AnMayVaa/smart-workstation-env-regulator/07_visuals/C3_room_installation_v1.jpg

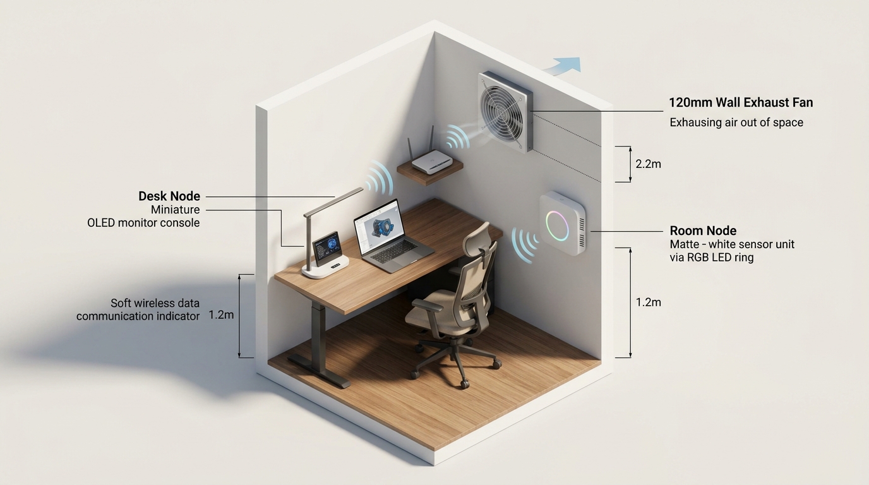
07_visuals/C3_room_installation_v1.jpg
