AnMayVaa/smart-workstation-env-regulator/07_visuals/C4_device_mockup_v1.jpg

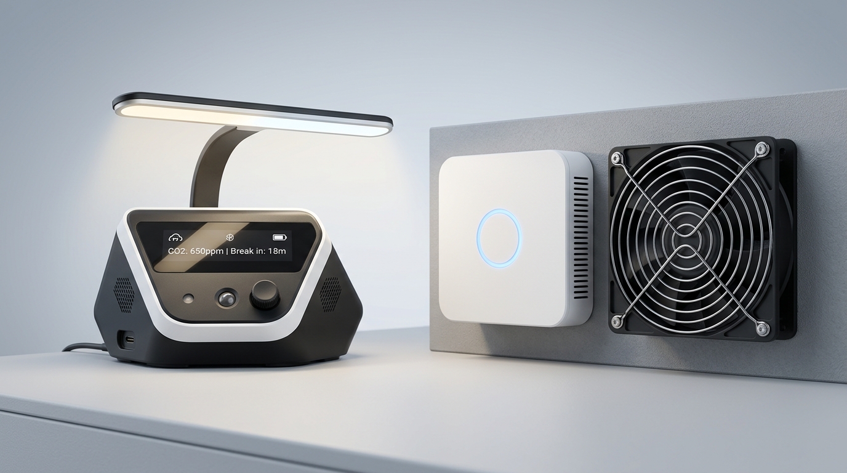
07_visuals/C4_device_mockup_v1.jpg
