AnMayVaa/smart-workstation-env-regulator/README.md

# Smart Workstation Environmental Regulator

ระบบลดความล้าและรักษาความตื่นตัวของคนที่ทำงานหน้าคอมนานๆ
งานกลุ่มวิชา 010123119 Embedded System Design (เอกสารออกแบบ + จำลองใน Wokwi)

> **เริ่มอ่านที่** [`00_team_guide/00_overview.md`](00_team_guide/00_overview.md) แล้วอ่านไฟล์บทบาทของตัวเองในโฟลเดอร์เดียวกัน

## โครงโฟลเดอร์

| โฟลเดอร์ | เก็บอะไร | เจ้าของหลัก |
|---|---|---|
| `00_team_guide/` | ไฟล์ภาพรวมและไฟล์บทบาท A/B/C/D | D |
| `01_requirements/` | D1 Requirement + ค่าเกณฑ์ | D |
| `02_interface/` | A1 ตารางข้อมูลกลาง | A |
| `03_hardware/` | A2, B1, C1, D2 | ทุกคน |
| `03_hardware/datasheets/` | datasheet ทุกตัว (PDF) | ทุกคน |
| `04_logic/` | A3, B2, C2, D3 | ทุกคน |
| `05_tasks/` | ข้อมูลงานย่อย (X-T), B3 | ทุกคน / B |
| `06_testing/` | test case (X-TC), C5, A5 | ทุกคน / C / A |
| `07_visuals/` | C3, C4 และภาพ FSM ของทุกคน | ทุกคน |
| `08_code/` | A4 โค้ด ESP32 + วงจร Wokwi | A |
| `09_doc_sections/` | เนื้อหาเอกสารส่วนตัว (A6, B4, C6, D4), X-N | ทุกคน |
| `10_final/` | D5 เล่มสมบูรณ์ | D |

## วิธีส่งงาน (ไม่ต้องใช้ git ก็ได้)

1. เปิดโฟลเดอร์ที่ถูกต้องบนหน้าเว็บ GitHub
2. กด **Add file → Upload files** แล้วลากไฟล์มาวาง
3. ช่อง commit message เขียนสั้นๆ เช่น `ส่ง B2 logic presence v1`
4. กด **Commit changes**
5. แจ้งในกลุ่มแชท เช่น "ส่ง B2 แล้ว @A"

## ตั้งชื่อไฟล์

- ไฟล์ Word / PDF / PNG: ใช้รูปแบบ `รหัส_ชื่อสั้น_vเลข` ตามไฟล์ภาพรวม เช่น `B2_logic_presence_v1.docx`
- ถ้าแก้งานที่ส่งแล้ว อย่าทับไฟล์เดิม ให้อัปโหลดเป็นเวอร์ชันใหม่ (v2, v3) แล้วแจ้งคนที่ใช้งานชิ้นนั้น
- ไฟล์ `.md` (เช่น A1) ไม่ต้องใส่เลขเวอร์ชันในชื่อ เพราะ git เก็บประวัติให้ เวอร์ชันระบุไว้ที่หัวไฟล์

## ของกลางที่ห้ามแก้เอง

| ของกลาง | เจ้าของ | อยู่ที่ |
|---|---|---|
| โมดูลที่เอา/ไม่เอา, ค่าเกณฑ์ | D | `00_team_guide/00_overview.md`, `01_requirements/` |
| ตารางข้อมูลกลาง | A | `02_interface/A1_interface.md` |

ถ้าต้องการเปลี่ยน ให้เปิด **Issue** (แท็บ Issues → New issue → "ขอเปลี่ยนตารางข้อมูลกลาง") แทนการแก้ไฟล์โดยตรง

## สมาชิกและบทบาท

| บทบาท | หน้าที่ | ชื่อ |
|---|---|---|
| A | เชื่อมระบบและจำลอง | นาย พิทักษ์ ปทุมวัน |
| B | คนและการเตือนพัก + ตารางงานย่อย | นาย ณัฐปคัลภ์ พรเฉลิมพงศ์ |
| C | อากาศ + ภาพจำลอง + แผนทดสอบ | นาย ทิวากร ฉับพลัน |
| D | PM + แสง + รวมเล่ม | นาย นครินทร์ บุญก่อเกื้อ|
