AnMayVaa/smart-workstation-env-regulator/03_hardware/C1_hardware_air.md

# C1: การเลือกอุปกรณ์ฮาร์ดแวร์ โมดูลตรวจวัดคุณภาพอากาศและควบคุมการระบายอากาศ

> **รหัสเอกสาร:** C1_hardware_air  
> **ผู้จัดทำ:** C (ซัน - นายทิวากร ฉับพลัน 6701012610112) | โมดูลอากาศ + ภาพจำลอง + แผนทดสอบ  
> **ส่งให้:** A (โอม - นำไปทำผังขาและคำนวณไฟใน A2), D (ใช้รวมเล่มหัวข้อ 4)  
> **อ้างอิงและสอดคล้องกับ:** `03_hardware/proposal_A_mosfet.md`, `03_hardware/A2_board_power.md`, `01_requirements/D1_requirements.md`  
> **เนื้อหาสำหรับรายงาน:** หัวข้อ 4 (Hardware Design - Sensor/Actuator choice and justification)

---

## 1. ตารางสรุปรายการอุปกรณ์ (แบบฟอร์ม HW)

| อุปกรณ์ | หน้าที่ในระบบ | เหตุผลที่เลือก | ตัวเลือกอื่นที่เปรียบเทียบ และเหตุผลที่ไม่เลือก | สเปกไฟเลี้ยง (V / mA) | การเชื่อมต่อกับ ESP32 | Datasheet (ชื่อไฟล์) | ในโปรแกรมจำลอง Wokwi ใช้ |
|---|---|---|---|---|---|---|---|
| **Sensirion SCD41** | ตรวจวัดก๊าซ $\text{CO}_2$ (ppm), อุณหภูมิ (°C) และความชื้นสัมพัทธ์ (%RH) | 1. ใช้เทคโนโลยี Photoacoustic NDIR วัดความเข้มข้น $\text{CO}_2$ ได้โดยตรง โดยในช่วงควบคุมพัดลมและประเมินคุณภาพอากาศ 400–1,000 ppm มีความแม่นยำสูงถึง $\pm(50\ \text{ppm} + 2.5\%\ \text{of reading})$ (และช่วง 1,001–2,000 ppm แม่นยำ $\pm(50\ \text{ppm} + 3\%)$, ช่วง 2,001–5,000 ppm แม่นยำ $\pm(40\ \text{ppm} + 5\%)$ ตาม [C1-1])<br>2. รวม 3 เซนเซอร์ในตัวเดียว ช่วยลดพื้นที่ PCB และประหยัดขา I/O<br>3. สื่อสารผ่าน I²C บัสมาตรฐาน มี CRC ตรวจสอบความถูกต้อง | **1. MQ-135:** เป็นเซนเซอร์เคมี (MOx) แยก $\text{CO}_2$ ไม่ได้จริง เพี้ยนง่ายจากแอลกอฮอล์/ควัน และกินไฟสูงถึง 150 mA (~900 mW) จากขดลวดความร้อน [C1-2]<br>**2. MH-Z19B / SCD30:** ขนาดใหญ่กว่า SCD41 ประมาณ 8–9 เท่า ($> 5,500\ \text{mm}^3$ เทียบกับ SCD41 เพียง $663\ \text{mm}^3$) [C1-3], [C1-4] และ MH-Z19B ไม่รวมวัดอุณหภูมิ/ความชื้น | 3.3V DC (2.4V – 5.5V)<br>- โหมดวัดทุก 5s: กระแสเฉลี่ย 15 mA (สูงสุด 18 mA)<br>- Peak กระแสชั่วขณะ: สูงสุด 205 mA ที่ 3.3V (ตาม Datasheet Table 4 [C1-1]) | I²C Bus (SDA = GPIO 21, SCL = GPIO 22)<br>I²C Address: `0x62`<br>(ผ่านการล็อกด้วย `i2c_lock` ตาม A1 ข้อ 7) | `Sensirion_SCD41_Datasheet.pdf` [C1-1] | Potentiometer 10kΩ (แทนค่า $\text{CO}_2$) + DHT22 (แทนอุณหภูมิและความชื้น) |
| **พัดลมดูดอากาศ DC 12V (Exhaust Fan ขนาด 120 mm)** | ดูดอากาศเสียที่มี $\text{CO}_2$ สะสมเกินมาตรฐานออกนอกห้อง เพื่อให้อากาศบริสุทธิ์ไหลเวียนเข้ามาแทนที่ | 1. การลด $\text{CO}_2$ ในห้องปิดต้องอาศัยการดูดอากาศทิ้ง พัดลมตั้งโต๊ะทั่วไปลด $\text{CO}_2$ ไม่ได้<br>2. สเปกแรงลมขั้นต่ำ 50–70 CFM คำนวณจากการระบายอากาศห้อง 15–25 m³ ให้ได้ 4–6 ACH ตามมาตรฐาน ASHRAE 62.1 [C1-7] (ดูข้อ 2.3)<br>3. ปรับความเร็วรอบด้วย PWM ได้เงียบสนิท ไม่รบกวนสมาธิผู้ใช้ | **พัดลม AC 220V:** ควบคุมความเร็วรอบได้ยาก มีความเสี่ยงอันตรายจากไฟฟ้าแรงสูง และมีสัญญาณรบกวนแม่เหล็กไฟฟ้า (EMI) ต่อไมโครคอนโทรลเลอร์ | 12V DC (สเปกขั้นต่ำ / ค่าประมาณทางวิศวกรรม [ดูข้อ 2.3])<br>กระแสทำงาน: ~250 mA (Peak สตาร์ทมอเตอร์: ~400 mA) | ต่อกับไฟ 12V ภายนอก ควบคุมเปิด-ปิดและปรับความเร็วรอบผ่านวงจรขับสวิตชิ่ง MOSFET | เลือกตามสเปกมาตรฐานทั่วไป (DC 12V 120mm Brushless Fan ไม่ผูกยี่ห้อ) | LED สีน้ำเงิน ที่ GPIO 25 (ความสว่างหรี่ตาม duty cycle ของ PWM แสดงความเร็วรอบพัดลม ตรงตาม A2 ข้อ 3-4 และ SIMULATION_GUIDE.md) |
| **วงจรขับพัดลม: Logic-Level N-Channel MOSFET (AO3400A) + Flyback Diode (1N4007)** | ขับกระแสและแปลงระดับแรงดันควบคุมจากสัญญาณ 3.3V ของ ESP32 ไปขับพัดลม 12V พร้อมวงจรป้องกันแรงดันไฟย้อนกลับ | 1. GPIO ของ ESP32 จ่ายได้สูงสุดเพียง 3.3V / 12mA (บท 13 หน้า 34–35 [C1-8]) ขับพัดลมโดยตรงไม่ได้<br>2. AO3400A เป็น Logic-Level MOSFET (SOT-23) ที่ Datasheet รับรองการเปิดสุดตั้งแต่ $V_{GS} = 2.5\ \text{V}$ ($R_{DS(on)} < 48\ \text{m}\Omega$) ขับด้วย 3.3V ได้สมบูรณ์ 100% [C1-5] ตอบโจทย์ตามข้อเสนอ `03_hardware/proposal_A_mosfet.md`<br>3. ทนแรงดัน 30V กระแส 5.7A ความร้อนสะสมต่ำมาก (~0.003 W) ไม่ต้องติดแผ่นระบายความร้อน<br>4. รองรับ PWM คาบ 20 ms (50 Hz) ตามบท 13 หน้า 95 [C1-8]<br>5. ติดตั้ง Flyback Diode 1N4007 ขนานย้อนขั้วเพื่อสลายแรงดันเหนี่ยวนำย้อนกลับ ($V = -L \frac{di}{dt}$) ของมอเตอร์พัดลม (บท 13 หน้า 35 [C1-8], [C1-6]) | **1. IRLZ44N:** แม้เป็น Logic-Level แต่ตัวถัง TO-220 ใหญ่เกินไป และ Datasheet รับรองค่าการนำกระแสเต็มที่ที่ $V_{GS} \ge 4-5\ \text{V}$<br>**2. IRFZ44N / IRF540N:** ต้องการ $V_{GS} = 10\ \text{V}$ ขับด้วย 3.3V ไม่ติด<br>**3. Relay Module:** สวิตช์กลไกมีเสียงดังคลิกๆ ตัดต่อบ่อยจะสึกหรอ และทำ PWM ไม่ได้<br>**4. BJT (TIP120):** มีแรงดันตกคร่อมสูง 1–2V สูญเสียพลังงานและร้อนจัด | ฝั่ง Gate: 3.3V (< 1 mA)<br>ฝั่ง Load: 12V / 250 mA | ขา Gate ต่อกับ ESP32 GPIO 25 (ผ่าน $R_{gate} = 100\ \Omega$ และ $R_{pull-down} = 10\ \text{k}\Omega$ ดึงลง GND) | `AO3400A_datasheet.pdf` [C1-5], `1N4007_Datasheet.pdf` [C1-6] | ไม่ต้องต่อใน Wokwi (ต่อ LED สีน้ำเงินที่ GPIO 25 ตรงผ่านตัวต้านทาน 220 Ω จำลองการขับโหลด PWM) |
| **ไฟสถานะ 3 สี (RGB LED ชนิด Common Cathode)** | แสดงสภาวะคุณภาพอากาศในห้องแบบ Real-time ให้ผู้ใช้มองเห็นได้ชัดเจนจากระยะไกล | 1. ผู้ใช้ทราบสภาวะอากาศได้ทันที (เขียว = อากาศดี, เหลือง = เฝ้าระวัง, แดง = เกินเกณฑ์พัดลมทำงาน, กะพริบแดง = เซนเซอร์เสีย)<br>2. ใช้พลังงานต่ำมาก ตอบสนองทันที<br>3. ประหยัดต้นทุนและความซับซ้อน ไม่ต้องติดจอ LCD ซ้ำซ้อนที่โหนดห้อง เพราะผู้ใช้ดูรายละเอียดตัวเลขบนจอ OLED ของโหนดโต๊ะได้อยู่แล้ว | **จอแสดงผล LCD/OLED บนโหนดห้อง:** สิ้นเปลืองพลังงานและต้นทุนโดยไม่จำเป็น เนื่องจากโหนดห้องติดตั้งไว้สูง | 3.3V DC (ผ่านตัวต้านทานจำกัดกระแส $R = 220\ \Omega$ ทุกขา)<br>กระแส: คำนวณจำกัดกระแสไม่เกิน 10 mA ต่อสี (ปลอดภัยต่อพอร์ต ESP32 [ดูข้อ 2.4]) | ขา Red $\rightarrow$ GPIO 18<br>ขา Green $\rightarrow$ GPIO 19<br>ขา Blue $\rightarrow$ GPIO 23<br>ขา Cathode $\rightarrow$ GND | เลือกตามสเปกมาตรฐานทั่วไป (5mm Common Cathode RGB LED ไม่ผูกยี่ห้อ) | RGB LED (Common Cathode) ขา 18, 19, 23 ใน Wokwi |

---

## 2. เหตุผลการเลือกอุปกรณ์ตามหลักการวิศวกรรม (Engineering Justification)

### 2.1 เซนเซอร์วัดคุณภาพอากาศ: ทำไมต้องเป็น Sensirion SCD41?
- **ปัญหาของเซนเซอร์เคมี (MQ-135):** ในโครงงานทั่วไปมักใช้ MQ-135 เนื่องจากราคาถูก แต่ MQ-135 ใช้ขดลวดทำความร้อนสารกึ่งตัวนำ $\text{SnO}_2$ ซึ่งวัดการเปลี่ยนแปลงความต้านทานจากก๊าซรีดิวซ์รวม ไม่สามารถแยกเจาะจงก๊าซ $\text{CO}_2$ ได้จริง หากมีไอระเหยของแอลกอฮอล์ น้ำหอม หรือก๊าซอื่น ค่าจะแกว่งอย่างรุนแรง นอกจากนี้ยังกินกระแสไฟฟ้าสูงถึง 150 mA (~900 mW) [C1-2] ตลอดเวลา จึงขัดกับเกณฑ์ด้าน Resource Optimization และ Real-time accuracy
- **ความเหนือกว่าของ SCD41:** SCD41 ใช้เทคโนโลยี Photoacoustic NDIR ซึ่งยิงพัลส์แสงอินฟราเรดความยาวคลื่น $4.26\ \mu\text{m}$ ที่ก๊าซ $\text{CO}_2$ ดูดกลืนโดยเฉพาะ แล้ววัดคลื่นเสียงที่เกิดขึ้นภายในห้องตรวจวัด ทำให้ได้ค่าความเข้มข้น $\text{CO}_2$ ที่แม่นยำแท้จริงในช่วง 400 – 5,000 ppm
  - **ความแม่นยำ (Accuracy):** ตาม Datasheet Version 1.7 (Table 1 [C1-1]) ระบุว่า:
    - ช่วง **400 – 1,000 ppm** มีความแม่นยำสูงถึง **$\pm(50\ \text{ppm} + 2.5\%\ \text{of reading})$** ซึ่งครอบคลุมช่วงเกณฑ์ตัดสินเปิด-ปิดพัดลมระบายอากาศของระบบ ($800 - 1,000\ \text{ppm}$) ได้อย่างแม่นยำ
    - ช่วง **1,001 – 2,000 ppm** มีความแม่นยำ **$\pm(50\ \text{ppm} + 3\%\ \text{of reading})$**
    - ช่วง **2,001 – 5,000 ppm** มีความแม่นยำ **$\pm(40\ \text{ppm} + 5\%\ \text{of reading})$**
  - รวมเซนเซอร์วัดอุณหภูมิ (ความแม่นยำ $\pm 0.8^\circ\text{C}$) และความชื้นสัมพัทธ์ (ความแม่นยำ $\pm 6\%\text{RH}$) ในตัวเดียว ช่วยลดจำนวนพอร์ตบนไมโครคอนโทรลเลอร์
  - เมื่อเทียบกับเซนเซอร์ NDIR รุ่นเดิมอย่าง MH-Z19B [C1-3] หรือ SCD30 [C1-4] ตัวถังของ SCD41 ($10.1 \times 10.1 \times 6.5\ \text{mm} = 663\ \text{mm}^3$) มีขนาดกะทัดรัดกว่าถึง 8–9 เท่า
- **พฤติกรรมการกินกระแส (Power Characteristics):**  
  ตาม Datasheet ของ Sensirion SCD41 (Table 4 [C1-1]) ในโหมดการทำงานแบบตรวจวัดทุกๆ 5 วินาที (Periodic Measurement Mode เพื่อให้ตอบสนองทันเกณฑ์ NFR-01):
  - กระแสเฉลี่ยขณะทำงาน: **$15\ \text{mA}$** (สูงสุด $18\ \text{mA}$)
  - กระแสกระชากสูงสุดชั่วขณะ (Peak Current): **$205\ \text{mA}$** ที่แรงดัน $3.3\ \text{V}$ (เกิดขณะหลอดอินฟราเรดยิงพัลส์ความร้อนเพื่อตรวจวัด)  
  *(หมายเหตุ: ค่า 0.5 mA เดิมในเอกสารร่างแรกเป็นค่ากระแสของโหมด Single Shot วัดทุก 5 นาที ตาม Datasheet Table 4: 0.45 mA typ / 0.50 mA max ไม่ใช่โหมด Low Power Periodic 30 วินาที ซึ่งกินกระแส 3.2 mA ทั้งนี้ระบบระบายอากาศของเราต้องตอบสนองต่อคุณภาพอากาศอย่างรวดเร็ว จึงเลือกใช้โหมด Periodic Measurement วัดทุก 5 วินาที ซึ่งกินกระแสเฉลี่ย 15 mA เพื่อให้สอดคล้องกับ NFR-01 และเอกสาร A2)*

### 2.2 วงจรขับพัดลมดูดอากาศ: ทำไมต้องเปลี่ยนมาใช้ MOSFET เบอร์ AO3400A?
ตามข้อเสนอในเอกสาร `03_hardware/proposal_A_mosfet.md` และการวิเคราะห์ตามสไลด์ **วิชา Embedded System Design บทที่ 13 หน้า 34–35 และ 60 [C1-8]**:
1. **ปัญหาของ IRLZ44N เดิม:** แม้ IRLZ44N จะเป็น Logic-Level MOSFET แต่ใน Datasheet รับรองค่า $R_{DS(on)}$ ที่แรงดันเกต $V_{GS} \ge 4 - 5\ \text{V}$ เป็นหลัก เมื่อนำมาขับด้วยระดับแรงดัน $3.3\ \text{V}$ ของบอร์ด ESP32 โดยตรง ทรานซิสเตอร์อาจทำงานอยู่ในช่วงกึ่งนำกระแส (Triode/Linear Region) ไม่เปิดสุด 100% อีกทั้งตัวถังแบบ TO-220 มีขนาดใหญ่เกินความจำเป็นสำหรับโหลดพัดลม 250 mA
2. **ความเหนือกว่าของ AO3400A [C1-5]:**
   - เป็น N-Channel Logic-Level MOSFET ในแพ็คเกจ SOT-23 ขนาดกะทัดรัด
   - **รับรองการเปิดเต็มที่ตั้งแต่แรงดันเกต $V_{GS} = 2.5\ \text{V}$** (ค่า $R_{DS(on)} < 48\ \text{m}\Omega$) และที่ $V_{GS} = 4.5\ \text{V}$ (ค่า $R_{DS(on)} < 28\ \text{m}\Omega$) ดังนั้นเมื่อขับด้วยสัญญาณลอจิก $3.3\ \text{V}$ จาก ESP32 จึงมั่นใจได้ $100\%$ ว่ามอสเฟตเปิดสุด (Fully Saturated) ความต้านทานภายในต่ำมาก
   - พิกัดทนแรงดัน $V_{DS} = 30\ \text{V}$ และทนกระแสได้สูงถึง $I_D = 5.7\ \text{A}$ ซึ่งสูงกว่ากระแสพัดลม $250\ \text{mA}$ (สตาร์ท $400\ \text{mA}$) มาก มี Safety Margin เหลือเฟือ
   - การสูญเสียกำลังไฟฟ้าในรูปความร้อนต่ำมาก: $P = I^2 \cdot R_{DS(on)} = (0.25)^2 \cdot 0.048 \approx 0.003\ \text{W}$ จึงไม่จำเป็นต้องติดแผ่นระบายความร้อน (Heatsink)
   - การใช้ AO3400A ร่วมกับโมดูลแสงของ D ทำให้ทั้งระบบใช้ MOSFET เบอร์เดียวกัน ลดความหลากหลายของชิ้นส่วน (BOM Standardization)
3. **การใส่ Flyback Diode (1N4007 [C1-6]):**  
   ต่อขนานย้อนขั้ว (Reverse-biased) คร่อมขั้วบวกและลบของมอเตอร์พัดลม เพื่อเป็นทางผ่านคายกระแสเหนี่ยวนำย้อนกลับ (Inductive Kickback: $V = -L \frac{di}{dt}$) ที่เกิดขึ้นขณะมอสเฟตตัดวงจร เพื่อป้องกันแรงดันกระชากทำลายทรานซิสเตอร์ (บท 13 หน้า 35 [C1-8])

### 2.3 ที่มาของสเปกแรงลมและพิกัดกระแสพัดลมดูดอากาศ (Fan Sizing & Flow Rate Justification)
1. **การคำนวณอัตราการถ่ายเทอากาศ (Airflow Requirement - CFM):**
   - อ้างอิงตามมาตรฐาน ANSI/ASHRAE Standard 62.1-2022 (*Ventilation for Acceptable Indoor Air Quality*) [C1-7] สำหรับห้องทำงานหรือพื้นที่ศึกษาขนาดเล็ก (ปริมาตร 15–25 $\text{m}^3$) สมมติห้องขนาดเฉลี่ย กว้าง 3 m × ยาว 3 m × สูง 2.5 m ปริมาตรห้อง $V = 22.5\ \text{m}^3 \approx 795\ \text{ft}^3$
   - เพื่อระบายก๊าซ $\text{CO}_2$ ที่สะสมเกิน 1,000 ppm ลงมาให้ต่ำกว่า 800 ppm ได้อย่างมีประสิทธิภาพ ห้องต้องการอัตราการถ่ายเทอากาศ (Air Changes per Hour: ACH) ขณะพัดลมทำงานเต็มที่ประมาณ $4 - 6\ \text{ACH}$
   - คำนวณอัตราการไหลของอากาศขั้นต่ำ:
     $$\text{Airflow (CFM)} = \frac{V\ (\text{ft}^3) \times \text{ACH}}{60\ \text{min}} = \frac{795 \times 4}{60} = 53\ \text{CFM}\quad (\text{ถึง}\ \frac{795 \times 6}{60} = 79.5\ \text{CFM})$$
   - จึงกำหนด **สเปกขั้นต่ำของพัดลมดูดอากาศ 120 mm ที่ 50–70 CFM** เพื่อให้ระบบสามารถลดระดับ $\text{CO}_2$ ได้ทันตามเกณฑ์ความปลอดภัย
2. **ที่มาของพิกัดกระแสปกติ 250 mA และกระแสสตาร์ท 400 mA:**
   - พัดลมระบายอากาศ DC 12V ขนาด 120 mm ชนิด Brushless DC (BLDC) ทั่วไปที่ให้แรงลม 50–70 CFM มีกำลังไฟฟ้าประมาณ 2.5 – 3.5 W คิดเป็นกระแสปกติ $I = \frac{P}{V} \approx 200 - 290\ \text{mA}$ จึงใช้ค่าประมาณทางวิศวกรรมที่ **$250\ \text{mA}$** ในการคำนวณงบประมาณพลังงาน
   - ในช่วงเริ่มหมุน (Motor Inrush / Starting Surge) ขดลวดมอเตอร์เหนี่ยวนำจะดึงกระแสสูงกว่าปกติชั่วขณะประมาณ 1.5–1.6 เท่า คิดเป็นกระแสพีคไม่เกิน **$400\ \text{mA}$** ซึ่งมอสเฟต AO3400A (พิกัด 5.7 A [C1-5]) และ Adapter 12V 2A รองรับได้อย่างปลอดภัย

### 2.4 การจำกัดกระแสของไฟสถานะ RGB LED (Current Limiting Justification)
- ไฟสถานะใช้หลอด RGB LED ขนาด 5 mm ชนิด Common Cathode ต่อผ่านตัวต้านทานจำกัดกระแส $R = 220\ \Omega$ เข้ากับขา GPIO 3.3V ของ ESP32
- จากแรงดันตกคร่อมไดโอดเปล่งแสง ($V_F$):
  - สีแดง ($V_F \approx 1.8 - 2.0\ \text{V}$): $I_R = \frac{3.3\ \text{V} - 1.9\ \text{V}}{220\ \Omega} \approx 6.4\ \text{mA}$
  - สีเขียวและสีน้ำเงิน ($V_F \approx 2.8 - 3.0\ \text{V}$): $I_{G,B} = \frac{3.3\ \text{V} - 2.9\ \text{V}}{220\ \Omega} \approx 1.8 - 2.0\ \text{mA}$
- ดังนั้นกระแสใช้งานจริงจะไม่เกิน **$10\ \text{mA}$ ต่อสี** ซึ่งอยู่ในเกณฑ์ปลอดภัยของขา GPIO ESP32 ที่สามารถจ่ายกระแสต่อเนื่องสูงสุดได้ 12 mA (ตามคำแนะนำในเอกสารคำสอนบทที่ 13 หน้า 34–35 [C1-8])

---

## 3. ข้อมูลกำลังไฟฟ้าและผังการเชื่อมต่อ (ตรงกับ A2_board_power.md)

### 3.1 การคำนวณกำลังไฟฟ้าของโหนดห้อง (Power Consumption Estimation)
| อุปกรณ์ | แรงดันทำงาน (V) | กระแสปกติ (mA) | กระแสสูงสุด (mA) | กำลังไฟฟ้าสูงสุด (W) |
|---|---|---|---|---|
| ESP32 (โหนดห้อง) | 3.3V (ผ่าน Buck Converter 5V) | 80 mA | 240 mA (ช่วงส่ง Wi-Fi TX) | 0.80 W |
| เซนเซอร์ Sensirion SCD41 | 3.3V | 15 mA (เฉลี่ย) | 205 mA (Peak ช่วงยิงพัลส์) | 0.68 W |
| พัดลมดูดอากาศ DC 12V | 12.0V | 0 mA (ปิด) / 250 mA (เปิด) | 400 mA (ช่วงเริ่มหมุน) | 4.80 W |
| ไฟสถานะ RGB LED | 3.3V | 10 mA | 20 mA | 0.07 W |
| **รวมทั้งสิ้น (โหนดห้อง)** | **Adapter 12V 1.5A** | **~100 mA (ฝั่ง 12V)** | **~500 mA (ฝั่ง 12V)** | **~5.80 W** |

> **ระบบจ่ายไฟของโหนดห้อง (ตาม A2 ข้อ 2):**  
> ใช้อะแดปเตอร์ภายนอก AC/DC Adapter 12V 1.5A หรือ 2A ตัวเดียว จ่ายไฟ 12V ตรงให้พัดลมดูดอากาศ และใช้ Buck Converter (MP1584 หรือ LM2596) แปลงแรงดันลงมาเป็น 5V เพื่อจ่ายเข้าขา VIN ของบอร์ด ESP32 ได้อย่างมีประสิทธิภาพ

### 3.2 ผังการเชื่อมต่อขา (ตรงตามที่ A ยืนยันใน A2 ข้อ 4 100%)
- **SCD41 (I²C Bus):**
  - Pin SDA $\rightarrow$ ESP32 GPIO 21 (มี Pull-up Resistor $4.7\ \text{k}\Omega$)
  - Pin SCL $\rightarrow$ ESP32 GPIO 22 (มี Pull-up Resistor $4.7\ \text{k}\Omega$)
  - VDD $\rightarrow$ 3.3V, GND $\rightarrow$ GND (Address: `0x62`)
- **วงจรขับพัดลม (PWM 50 Hz คาบ 20 ms):**
  - Gate Drive $\rightarrow$ ESP32 GPIO 25 (ผ่าน $R_{gate} = 100\ \Omega$ และ $R_{pull-down} = 10\ \text{k}\Omega$ ดึงลง GND)
- **ไฟสถานะ RGB LED (Common Cathode):**
  - ขา Red (แดง) $\rightarrow$ ESP32 GPIO 18 (ผ่าน $R = 220\ \Omega$)
  - ขา Green (เขียว) $\rightarrow$ ESP32 GPIO 19 (ผ่าน $R = 220\ \Omega$)
  - ขา Blue (น้ำเงิน) $\rightarrow$ ESP32 GPIO 23 (ผ่าน $R = 220\ \Omega$)
  - ขา Cathode $\rightarrow$ GND

---

## 4. เอกสารอ้างอิง (References)

- **[C1-1]** Sensirion AG, *SCD4x – Breaking the Size Barrier in CO2 Sensing (SCD40/SCD41 Datasheet)*, Version 1.7, Apr. 2025. (มีไฟล์ `Sensirion_SCD41_Datasheet.pdf` ในโฟลเดอร์ `03_hardware/datasheets/`)
- **[C1-2]** Hanwei Electronics Co., Ltd., *MQ-135 Semiconductor Sensor for Air Quality Datasheet*, 2015. (ระบุกำลังไฟฟ้าขดลวดความร้อน $P_H \le 900\ \text{mW}$ ที่ 5V หรือกระแส $I_H \approx 150-180\ \text{mA}$)
- **[C1-3]** Zhengzhou Winsen Electronics Technology Co., Ltd., *MH-Z19B NDIR CO2 Sensor Module User's Manual*, Version 1.4, 2020. (ขนาด $33 \times 20 \times 9\ \text{mm} = 5,940\ \text{mm}^3$ เทียบกับ SCD41 ขนาด $10.1 \times 10.1 \times 6.5\ \text{mm} = 663\ \text{mm}^3$ จึงใหญ่กว่าเกือบ 9 เท่า)
- **[C1-4]** Sensirion AG, *SCD30 Sensor Module for HVAC and Indoor Air Quality Datasheet*, Version 1.0, 2020. (ขนาด $35 \times 23 \times 7\ \text{mm} = 5,635\ \text{mm}^3$ ใหญ่กว่า SCD41 ราว 8.5 เท่า)
- **[C1-5]** Alpha & Omega Semiconductor, *AO3400A 30V N-Channel MOSFET Datasheet*, Rev. 5.0, Dec. 2020. (มีไฟล์ `AO3400A_datasheet.pdf` ในโฟลเดอร์ `03_hardware/datasheets/`)
- **[C1-6]** Vishay General Semiconductor, *1N4001 through 1N4007 General Purpose Plastic Rectifier Datasheet*, Rev. 1.8, Feb. 2018. (มีไฟล์ `1N4007_Datasheet.pdf` ในโฟลเดอร์ `03_hardware/datasheets/`)
- **[C1-7]** ANSI/ASHRAE Standard 62.1-2022, *Ventilation for Acceptable Indoor Air Quality*, American Society of Heating, Refrigerating and Air-Conditioning Engineers, Atlanta, GA, USA, 2022.
- **[C1-8]** ภาควิชาวิศวกรรมไฟฟ้าและคอมพิวเตอร์ มจพ., *เอกสารคำสอนวิชา 010123119 Embedded System Design*, บทที่ 13 (การเชื่อมต่อไมโครคอนโทรลเลอร์กับโหลดกระแสสูงและมอเตอร์), 2567.
