AnMayVaa/smart-workstation-env-regulator/03_hardware/B1_hardware_presence.md

# B1 อุปกรณ์โมดูลตรวจจับคนและการเตือนพัก

| รายการ | ค่า |
|---|---|
| เวอร์ชัน | v1.1 |
| วันที่ | 2026-10-14 |
| เจ้าของ | B |
| สถานะ | ผูกผังขากับ A2 แล้ว; เหลือวัดกระแสจริงของ OLED และ buzzer ใน A4 |

## รายการอุปกรณ์

| อุปกรณ์ | หน้าที่ในระบบ | ทำไมเลือก | ตัวเลือกอื่นที่เทียบ และทำไมไม่เลือก | ไฟเลี้ยง (V / mA) | ต่อกับ ESP32 ทาง | Datasheet (ชื่อไฟล์) | ในโปรแกรมจำลองใช้ |
|---|---|---|---|---|---|---|---|
| Hi-Link HLK-LD2410 | ตรวจว่ามีคนนั่งอยู่ แม้ร่างกายขยับเพียงเล็กน้อย | เป็น mmWave 24 GHz ที่ระบุว่าใช้ตรวจ human presence และตรวจเป้าหมายนิ่ง/เคลื่อนไหวได้ ระยะปรับได้ 0.75–6 m จึงเหมาะกว่าการใช้การเคลื่อนไหวเป็นตัวแทนของการมีคน | PIR ตรวจการเปลี่ยนแปลงรังสีอินฟราเรดและอาจพลาดคนนั่งนิ่ง; ultrasonic อาจสะท้อนจากเก้าอี้และสิ่งของ | 5 V, เฉลี่ย 80 mA; คู่มือกำหนดให้แหล่งจ่ายรองรับมากกว่า 200 mA | UART ระดับลอจิก 3.3 V; ใช้ขา OUT เป็นสัญญาณสำรองได้ | `HLK-LD2410_user_manual_v1.02.pdf` | PIR motion sensor โดยถือว่าสัญญาณ PIR คือ `occupied` สำหรับทดสอบ logic เท่านั้น |
| OLED 0.96 นิ้ว 128×64 ที่ใช้ SSD1306 | แสดงเวลานั่ง สถานะอากาศ ลิงก์ และข้อความเตือน | ขนาดเล็ก อ่านข้อความได้หลายบรรทัด รองรับ I²C และมี display RAM ในตัว จึงใช้สายสัญญาณเพียง 2 เส้นร่วมกับ BH1750 ได้ | LCD1602 ใหญ่กว่าและแสดงกราฟิก/ไอคอนได้น้อย; TFT ใช้ไฟและขา I/O มากเกินความจำเป็น | เลือกโมดูลที่รับ 3.3 V; กันงบกระแส 30 mA เป็นค่าประมาณสำหรับคำนวณไฟ ต้องวัดโมดูลจริงใน A4 เพราะ datasheet ของ SSD1306 เป็น IC ไม่ได้กำหนดกระแสรวมของ panel/module | I²C ผ่าน `i2c_lock`; timeout 50 ms ตาม A1 | `SSD1306_datasheet_rev1.1.pdf` | Wokwi SSD1306 128×64 I²C |
| TDK PS1240P02BT piezoelectric buzzer | ส่งเสียงสั้นเมื่อมีการเตือนระดับ 1 และส่งซ้ำเมื่อระดับ 2 | รับสัญญาณสี่เหลี่ยม 3 V ที่ 4 kHz และให้เสียงอย่างน้อย 70 dB(A) ที่ 10 cm; เป็น piezo แบบไม่มี oscillator จึงสร้างรูปแบบเสียงต่างกันได้ด้วย PWM | active buzzer ควบคุมรูปแบบเสียงได้น้อยกว่า; magnetic buzzer กินกระแสมากกว่าและควรมีวงจรขับเพิ่ม | สัญญาณ 3 Vpeak ที่ 4 kHz; datasheet ไม่ระบุกระแสใช้งาน จึงกันงบ 5 mA และต้องวัดยืนยันใน A4 | GPIO/PWM ผ่านตัวต้านทานประมาณ 1 kΩ ตามวงจรแนะนำของผู้ผลิต; ห้ามเปิดเสียงค้างใน task | `TDK_PS1240P02BT_datasheet.pdf` | Wokwi buzzer |
| OMRON B3F-1000 tactile switch | รับทราบ/เลื่อนการเตือน และตั้งค่าความสว่างหรือโหมดทำงานดึกผ่านเมนูบน OLED | เป็นสวิตช์ momentary SPST-NO แบบ through-hole อายุทางกล 1,000,000 ครั้งและมีแรงกดชัดเจน; ใช้การกดตามบริบทจึงไม่ต้องเพิ่มปุ่ม | capacitive touch ไวต่อ noise/ความชื้นและไม่มี tactile feedback; slide switch ไม่เหมาะกับคำสั่งชั่วขณะ | หน้าสัมผัสรองรับ 3–24 VDC, 1–50 mA; วงจรจริงใช้ 3.3 V และ pull-up 10 kΩ จึงมีกระแสประมาณ 0.33 mA เมื่อกด | GPIO digital input แบบ active-low; debounce ในซอฟต์แวร์ 30 ms; interrupt ทำเพียงส่ง event เข้า queue | `OMRON_B3F_datasheet.pdf` | Wokwi pushbutton |

## การต่อและข้อกำหนดที่ส่งต่อให้ A

1. จ่าย HLK-LD2410 จากราง 5 V ที่รองรับกระแสกระชากอย่างน้อย 200 mA และต่อกราวด์ร่วมกับ ESP32; UART ของโมดูลเป็นลอจิก 3.3 V
2. ต่อ OLED เข้าบัส I²C เดียวกับ BH1750 แต่ทุก transaction ต้องถือ `i2c_lock` ไม่เกิน 50 ms และต้องปล่อย lock ก่อน `vTaskDelay` หรือรอ Wi-Fi
3. ให้ buzzer ทำงานด้วย PWM 4 kHz, 3 Vpeak ผ่านตัวต้านทานอนุกรม 1 kΩ ตามวงจรแนะนำใน datasheet
4. ต่อ B3F-1000 แบบ active-low ด้วย pull-up 10 kΩ ไป 3.3 V; ISR ห้ามวาดจอหรือหน่วงเวลา ให้ส่ง button event เท่านั้น การออกแบบปัจจุบันใช้ปุ่มเดียวตามบริบท จึงยังไม่ใช้ GPIO 33 ที่ A2 สำรองไว้สำหรับปุ่มที่ 2
5. งบกระแสเฉพาะอุปกรณ์ของ B แบบประมาณ: 80 + 30 + 5 + 0.33 = **115.33 mA** ในการทำงานปกติ ราง 5 V เผื่ออย่างน้อย 200 mA สำหรับ LD2410 ตามคู่มือ และ A2 รวมภาระทั้งโหนดแล้วเลือก adapter 12 V 2 A

## ผังขาที่ A2 ยืนยัน

| GPIO | อุปกรณ์/สัญญาณของ B | หมายเหตุ |
|---:|---|---|
| 21 / 22 | OLED SDA / SCL | แชร์ I²C 100 kHz กับ BH1750 ผ่าน `i2c_lock` |
| 16 / 17 | LD2410 UART2 RX / TX | 256,000 baud; สัญญาณลอจิก 3.3 V |
| 13 | LD2410 OUT | สัญญาณสำรอง; Wokwi ต่อ PIR ที่ขานี้ |
| 27 | ปุ่ม B3F active-low | interrupt ขอบขาลงและ pull-up 10 kΩ |
| 33 | ปุ่มที่ 2 สำรอง | ไม่ใช้ในแบบปุ่มเดียวปัจจุบัน |
| 26 | buzzer PWM | LEDC 4 kHz ผ่าน R 1 kΩ |

## เหตุผลด้านการจำลอง

Wokwi ไม่มีแบบจำลอง mmWave LD2410 จึงใช้ PIR เป็นตัวสร้างเหตุการณ์มีคน/ไม่มีคน โดยไม่อ้างว่าผลจำลองพิสูจน์ความแม่นยำของ mmWave ส่วน OLED, buzzer และ pushbutton ใช้อุปกรณ์ตรงชนิดเพื่อทดสอบการแสดงผล เสียง และปุ่มได้

## เช็กลิสต์ก่อนส่ง

- [x] อุปกรณ์ทุกตัวมีเหตุผลและเปรียบเทียบทางเลือก
- [x] ระบุแรงดัน กระแส/งบกระแส และวิธีต่อครบทุกตัว
- [x] แนบ datasheet ครบ 4 รายการใน `03_hardware/datasheets/`
- [x] ระบุอุปกรณ์แทนในโปรแกรมจำลอง
- [x] แยกค่าจาก datasheet ออกจากค่าประมาณที่ต้องวัดยืนยัน

## อ้างอิง

[B1-1] Shenzhen Hi-Link Electronic Co., Ltd., “HLK-LD2410 Human Presence Sensing Module User Manual,” ver. 1.02, Jun. 8, 2022.

[B1-2] Solomon Systech Ltd., “SSD1306: 128 × 64 Dot Matrix OLED/PLED Segment/Common Driver with Controller,” rev. 1.1, Apr. 2008.

[B1-3] TDK Corp., “Piezoelectronic Buzzers: PS Series,” Feb. 2022.

[B1-4] OMRON Corp., “B3F Tactile Switch,” cat. no. A070-E1.
