AnMayVaa/smart-workstation-env-regulator/03_hardware/D2_hardware_light.md

# D2 อุปกรณ์ของโมดูลแสง

| รายการ | ค่า |
|---|---|
| เวอร์ชัน | v1 |
| วันที่ | 2026-10-14 |
| เจ้าของ | D |
| ส่งให้ | A (ใช้ทำ A2 ตารางไฟเลี้ยงและผังขา), C (ภาพอุปกรณ์ C4) |
| อ้างอิงค่าเกณฑ์ | `01_requirements/D1_requirements.md` (FR-06–FR-11, NFR-02, NFR-09–NFR-12) |

> โมดูลแสงอยู่ที่ **โหนดโต๊ะ** ทำหน้าที่รักษาความสว่างบนโต๊ะให้ได้ 500 lux และปรับสีแสงตามช่วงเวลา
> ประกอบด้วยอุปกรณ์ 3 ส่วน: เซนเซอร์แสง, แหล่งแสง LED 2 สี, วงจรขับ MOSFET 2 ชุด

---

## 1. ตารางอุปกรณ์ (แบบฟอร์ม HW)

| อุปกรณ์ | หน้าที่ในระบบ | ทำไมเลือก | ตัวเลือกอื่นที่เทียบ และทำไมไม่เลือก | ไฟเลี้ยง (V / mA) | ต่อกับ ESP32 ทาง | Datasheet | ในโปรแกรมจำลองใช้ |
|---|---|---|---|---|---|---|---|
| **BH1750FVI** (โมดูล GY-302) | วัดความสว่างบนผิวโต๊ะเป็นหน่วย lux ทุก 200 ms (`lux_now`) เพื่อใช้ในวงควบคุมแบบป้อนกลับ | (1) ให้ค่าเป็น lux ตรงๆ ไม่ต้องแปลงสูตร (2) ตอบสนองแสงใกล้เคียงสายตาคน ไวที่สุดที่ 560 nm (3) ต่อทาง I²C ใช้ 2 ขาร่วมกับ OLED ของ B (4) มีฟังก์ชันตัดการกะพริบ 50/60 Hz ของไฟเพดาน (5) ช่วงวัด 1–65,535 lux ครอบคลุมช่วงที่งานต้องการ 0–2,000 lux (NFR-12) (6) กินไฟต่ำมาก | **LDR (ตัวต้านทานไวแสง):** ถูกที่สุด แต่ค่าไม่เป็นเส้นตรง ต้อง calibrate เอง ค่าเปลี่ยนตามอุณหภูมิ และต้องใช้ขา ADC เพิ่ม · **TSL2561:** ต้องคำนวณ lux จาก 2 ช่องเอง ซับซ้อนกว่า · **VEML7700:** วัดได้ถึงราว 120,000 lux เกินความต้องการของงานในอาคาร ราคาสูงกว่า | 3.3 V / ทั่วไป 0.12 mA, สูงสุด 0.19 mA | I²C (address 0x23, ขา ADDR ต่อ GND) ใช้บัสร่วมกับ OLED ผ่าน `i2c_lock` | `BH1750FVI_datasheet.pdf` | Photoresistor sensor (ค่า `lux` ปรับได้) ต่อขา ADC |
| **แถบ LED 12V แบบ CCT 2 สี** (ขาวอุ่น ~2,700–3,000 K + ขาวเย็น ~6,000–6,500 K, CRI ≥ 80) | แหล่งแสงบนโต๊ะ ผสมแสง 2 สีด้วย PWM คนละช่อง ได้ทั้งความสว่างและสีตามที่ logic สั่ง | (1) ต้องปรับ **สีแสง** ตามเวลา (FR-09) จึงต้องมีแสงขาว 2 อุณหภูมิสีที่คุมแยกกันได้ (2) ใช้ adapter 12V ตัวเดียวกับระบบ (3) แถบบาง เบา ติดใต้ชั้นหรือในรางโคมเหนือโต๊ะได้ กระจายแสงทั่วโต๊ะกว่าหลอดจุดเดียว (4) CRI ≥ 80 ตรงตาม EN 12464-1 ที่กำหนด Ra 80 สำหรับงานอ่านและใช้คอม | **แถบ RGB:** สร้างสีขาวจาก 3 สี ได้ CRI ต่ำ ของบนโต๊ะดูสีเพี้ยน · **แถบสีเดียว 2 เส้นแยก:** แสง 2 สีมาจากคนละตำแหน่ง ผสมไม่สนิท · **หลอด 220V หรี่ได้:** ต้องใช้วงจรหรี่ไฟ AC อันตรายและซับซ้อนกว่า · **LED 5V แบบ WS2812:** แสงขาวคุณภาพต่ำเหมือน RGB | 12 V / เปิดเต็มประมาณ 500–700 mA (ประมาณการ ดูข้อ 3) เผื่อ 1 A | ไม่ต่อตรง สั่งผ่าน MOSFET 2 ตัว | เลือกตามสเปก ไม่ผูกยี่ห้อ (ดูข้อ 4) | LED 2 ดวง (สีขาว + สีเหลือง) ต่อขา PWM ผ่าน R 220 Ω |
| **AO3400A** N-channel MOSFET × 2 (ช่องขาวอุ่น 1 ตัว, ขาวเย็น 1 ตัว) | สวิตช์ฝั่งลบ (low-side) ให้ขา GPIO 3.3 V สั่งเปิดปิดแถบ LED 12 V ด้วย PWM 5 kHz | (1) ขา GPIO จ่ายกระแสและแรงดันไม่พอขับแถบ LED โดยตรง ต้องมีวงจรขับ (บท 13 หน้า 34–35, บท 10 หน้า 40) (2) **datasheet รับรองการเปิดที่ VGS = 2.5 V** (RDS(on) สูงสุด 48 mΩ) ต่ำกว่า 3.3 V ของ ESP32 จึงมั่นใจว่าเปิดเต็ม (3) ทนแรงดัน 30 V กระแส 5.7 A เหลือส่วนเผื่อมากที่ 12 V / 1 A (4) ความร้อนที่ 1 A ≈ 1² × 0.048 = 0.05 W ไม่ต้องติดแผ่นระบายความร้อน (5) สลับเร็วพอสำหรับ PWM 5 kHz | **IRLZ44N:** datasheet รับรองค่าที่ VGS 4–5 V ขึ้นไป ไม่รับรองที่ 3.3 V · **IRF540N / IRFZ44N:** ต้องใช้ VGS 10 V · **BJT (TIP120):** แรงดันตกคร่อม 1–2 V เสียพลังงานเป็นความร้อนมาก · **รีเลย์:** ทำ PWM ไม่ได้ และหน้าสัมผัสสึกหรอ | ฝั่ง Gate ใช้กระแสแทบเป็นศูนย์ (ขับด้วยขา GPIO 3.3 V) | GPIO ที่ทำ PWM ได้ (LEDC) 2 ขา ผ่าน R 100 Ω | `AO3400A_datasheet.pdf` | ไม่ต้องใช้ใน Wokwi (ต่อ LED ตรงที่ขา GPIO) |

---

## 2. วิธีต่อวงจร (ทำ 2 ชุดเหมือนกัน สำหรับช่องขาวอุ่นและขาวเย็น)

```
+12V (adapter) ──────────────── (+) แถบ LED (ขั้วบวกร่วมของทั้ง 2 สี)
                                  (−) ช่อง WW ─── Drain [AO3400A #1]
                                                  Source ─── GND
ESP32 GPIO_WW ── R 100 Ω ── Gate [#1]
                            Gate ── R 10 kΩ ── GND

                                  (−) ช่อง CW ─── Drain [AO3400A #2]
                                                  Source ─── GND
ESP32 GPIO_CW ── R 100 Ω ── Gate [#2]
                            Gate ── R 10 kΩ ── GND

BH1750 (GY-302):  VCC → 3.3V   GND → GND   SDA → SDA ของบัส I²C   SCL → SCL ของบัส I²C   ADDR → GND (0x23)
```

| จุด | ทำไม |
|---|---|
| R 100 Ω ที่ Gate | จำกัดกระแสกระชากตอนสลับ PWM เร็ว |
| R 10 kΩ ดึง Gate ลง GND | ตอนเปิดเครื่องหรือรีเซ็ต ขา GPIO ยังไม่ถูกตั้งค่า ไม่มีตัวนี้ไฟอาจติดเองแบบสุ่ม |
| GND ร่วม | GND ของ adapter 12 V ต้องต่อกับ GND ของ ESP32 ไม่อย่างนั้นสัญญาณ Gate ไม่มีจุดอ้างอิง |
| ไม่ต้องมี flyback diode | LED ไม่ใช่ขดลวด ไม่มีแรงดันย้อนกลับแบบพัดลมของ C |
| ADDR → GND | ได้ address 0x23 ไม่ชนกับ OLED (0x3C) |

**ขาที่ใช้ (ให้ A เป็นผู้กำหนดใน A2):** ต้องการขาที่ทำ PWM (LEDC) ได้ 2 ขา และไม่ใช่ขา strapping ของ ESP32 กับบัส I²C เดียวกับ OLED ของ B

---

## 3. ข้อมูลไฟเลี้ยงสำหรับ A (ตาราง A2)

| อุปกรณ์ | แรงดัน | กระแส | หมายเหตุ |
|---|---|---|---|
| BH1750 | 3.3 V | สูงสุด 0.19 mA | จาก datasheet |
| แถบ LED (รวมทั้ง 2 สี) | 12 V | ประมาณ 500–700 mA เมื่อสว่างเต็ม, **ใช้ 1 A ในการเผื่อ** | ประมาณการ ดูวิธีคิดด้านล่าง |
| AO3400A × 2 | — | กระแส Gate แทบเป็นศูนย์ | ไม่ต้องนับ |

**วิธีประมาณกระแสของแถบ LED (ประมาณการ ยังไม่ใช่ค่าวัด):**
1. พื้นที่ทำงานบนโต๊ะประมาณ 0.6 m² (120 × 50 cm)
2. แสงที่ต้องปล่อย ≈ ความสว่าง × พื้นที่ ÷ สัดส่วนแสงที่ตกถึงโต๊ะ ≈ 500 × 0.6 ÷ 0.5 ≈ **600 lumen** (คิดกรณีแย่สุด คือไม่มีแสงอื่นช่วยเลย)
3. แถบ LED ทั่วไปให้ประมาณ 80–100 lumen ต่อวัตต์ → ใช้ประมาณ **6–8 W** หรือ **0.5–0.7 A ที่ 12 V**

**ทำไมไม่ต้องคิด 2 ช่องรวมกันเป็น 2 เท่า:** logic สั่ง duty ช่องขาวเย็น = B × r และช่องขาวอุ่น = B × (1 − r) โดย B คือความสว่างรวม (ดู D3) ผลรวมของ 2 ช่องจึงไม่เกินความสว่างเต็มของ 1 ช่อง กระแสรวมสูงสุดจึงเท่ากับช่องเดียวเปิดเต็ม

---

## 4. สเปกขั้นต่ำของแถบ LED (ใช้เลือกซื้อหรือระบุในเล่ม)

| สเปก | ค่าที่ต้องการ | เหตุผล |
|---|---|---|
| แรงดัน | 12 V DC | ใช้ adapter เดียวกับระบบ |
| ชนิด | CCT / dual white ในแถบเดียว (3 สาย: +12V ร่วม, WW−, CW−) | ผสม 2 สีจากตำแหน่งเดียวกัน แสงไม่แยกสี |
| อุณหภูมิสี | ขาวอุ่น ~2,700–3,000 K และขาวเย็น ~6,000–6,500 K | ครอบคลุมช่วงที่ใช้ในตารางสีแสงของ D1 |
| CRI (Ra) | ≥ 80 | EN 12464-1 กำหนด Ra 80 สำหรับงานเขียน อ่าน และใช้คอม [3] |
| ความยาว | ประมาณ 1 m (ปรับตามความยาวโต๊ะ) | ให้แสงทั่วพื้นที่ 120 × 50 cm |
| การติดตั้ง | ในรางอะลูมิเนียมพร้อมแผ่นกระจายแสง (diffuser) | ลดแสงจ้าเข้าตา และช่วยระบายความร้อนของ LED |

---

## 5. ในโปรแกรมจำลอง Wokwi

| ของจริง | ใน Wokwi | สิ่งที่ A ต้องรู้ |
|---|---|---|
| BH1750 | **Photoresistor sensor** ต่อขา AO เข้า ADC | Wokwi ไม่มี BH1750 ค่า `lux` ปรับได้ด้วยตัวเลื่อน หรือ Automation Scenario (`set-control` ชื่อ `lux`) สูตรแปลงค่าในเอกสาร Wokwi เขียนสำหรับ ADC 10 บิต 5 V ถ้าใช้ ESP32 ต้องเปลี่ยนเป็น `analogValue / 4095. * 3.3` และแทน 5 ด้วย 3.3 |
| แถบ LED 2 สี + MOSFET | **LED 2 ดวง** (ขาว แทนขาวเย็น, เหลือง แทนขาวอุ่น) ต่อขา PWM ผ่าน R 220 Ω | Wokwi จำลองแถบ 12 V ไม่ได้ ดูความสว่างของ LED เทียบ duty แทน |
| วงป้อนกลับ | ⚠️ **photoresistor ใน Wokwi มองไม่เห็นแสงจาก LED ที่จำลอง** ค่าแสงมาจากตัวเลื่อนอย่างเดียว | ในโค้ดจำลองให้คิด `lux_now = lux จากตัวเลื่อน + k × duty_รวม` (เช่น ไฟเต็มให้แสงเพิ่ม 600 lux → k = 6 lux ต่อ duty 1%) เพื่อให้ทดสอบวงป้อนกลับได้ ต้องเขียนเรื่องนี้ในหัวข้อ 8 (ข้อจำกัด) |

---

## 6. หมายเหตุถึงทีม

- **MOSFET ของทั้งระบบ:** ตอนนี้โหนดห้อง (C) ใช้ IRLZ44N ส่วนโมดูลแสงใช้ AO3400A มีข้อเสนอให้ใช้รุ่นเดียวกันทั้งระบบ **รอ A ตัดสิน**
- **PWM 5 kHz** ใช้ LEDC ของ ESP32 ความละเอียด 13 บิต ตามที่ D1 NFR-09 กำหนด (A ตั้งในโค้ด)

---

## ✅ เช็คก่อนส่ง

- [x] อุปกรณ์ทุกตัวมีเหตุผลและตัวเลือกที่เทียบ
- [x] ระบุไฟเลี้ยงและวิธีต่อครบ
- [x] แนบ datasheet ครบ (`03_hardware/datasheets/BH1750FVI_datasheet.pdf`, `AO3400A_datasheet.pdf`) แถบ LED ระบุเป็นสเปกขั้นต่ำแทน
- [x] ระบุว่าในโปรแกรมจำลองใช้อะไรแทน

## อ้างอิง

- [3] *Light and lighting – Lighting of work places – Part 1: Indoor work places*, EN 12464-1:2021.
- ROHM Semiconductor, "BH1750FVI: Digital 16-bit serial output type ambient light sensor IC," datasheet.
- Alpha & Omega Semiconductor, "AO3400A: 30V N-channel MOSFET," datasheet.
- Espressif Systems, "LED Control (LEDC)," *ESP-IDF Programming Guide*. [Online]. Available: https://docs.espressif.com/projects/esp-idf/en/stable/esp32/api-reference/peripherals/ledc.html
- Wokwi, "wokwi-photoresistor-sensor Reference." [Online]. Available: https://docs.wokwi.com/parts/wokwi-photoresistor-sensor
- เอกสารประกอบวิชา 010123119 บท 10 หน้า 40, 43–45 และบท 13 หน้า 17–19, 34–36, 91–96
