AnMayVaa/smart-workstation-env-regulator/09_doc_sections/D_pm_light/D4_4.2_hardware_light.md

# เนื้อหาเล่ม: หัวข้อ 4.2 ส่วนโมดูลแสง (D)

> ข้อความชุดนี้ตรงกับเล่มร่างของ D ทุกตัวอักษร (อัปเดต 2026-10-14 หลังรวมเนื้อหาของทุกคน) เขียนตามกติกาเล่ม: เรียกด้วยชื่อโมดูล ไม่อ้างบท/หน้าสไลด์ ไม่ใช้ขีดยาวหรือลูกศร
> เลขอ้างอิง [x] เลขตาราง และเลขภาพ เป็นเลขของเล่มร่างฉบับนี้ ในโมดูลแสงใช้ L แทนความสว่างรวม (ใน D3 ชื่อ B)

---

### 4.2.3 อุปกรณ์โมดูลแสง

โมดูลแสงมีหน้าที่รักษาความสว่างบนโต๊ะให้อยู่ที่ 500 lux และปรับสีแสงตามช่วงเวลาของวัน จึงประกอบด้วยอุปกรณ์ 3 ส่วน ได้แก่ เซนเซอร์วัดแสงที่บอกว่าตอนนี้โต๊ะสว่างเท่าไร แหล่งแสง LED ที่ปรับได้ทั้งความสว่างและสี และวงจรขับที่ทำให้ไมโครคอนโทรลเลอร์สั่งแหล่งแสง 12 V ได้

**1) เซนเซอร์วัดแสง BH1750FVI**

เลือก BH1750 เพราะให้ค่าออกมาเป็นหน่วย lux โดยตรง ระบบนำไปเทียบกับค่าเป้าหมาย 500 lux ได้ทันทีโดยไม่ต้องแปลงสูตร และการตอบสนองต่อแสงใกล้เคียงสายตาคน (ไวที่สุดที่ความยาวคลื่น 560 nm) ค่าที่วัดได้จึงตรงกับความสว่างที่ผู้ใช้รู้สึก เซนเซอร์มีฟังก์ชันตัดการกะพริบของไฟบ้าน 50/60 Hz ทำให้ค่าไม่แกว่งตามไฟเพดาน และวัดได้ 1-65,535 lux ซึ่งครอบคลุมช่วงที่โต๊ะทำงานในอาคารต้องการ (0-2,000 lux) จึงไม่ต้องสลับช่วงวัดระหว่างใช้งาน [28]

เซนเซอร์ต่อกับ ESP32 ทาง I²C ใช้เพียง 2 ขา และใช้บัสร่วมกับจอ OLED ของโมดูลตรวจคนได้ ESP32 มีวงจร I²C อยู่ในตัวแล้ว จึงช่วยประหยัดขาของไมโครคอนโทรลเลอร์และลดงานซอฟต์แวร์ เมื่อเทียบกับตัวต้านทานไวแสง (LDR) ที่ราคาถูกกว่า LDR ให้ค่าไม่เป็นเส้นตรง ต้องปรับเทียบเอง และค่าเปลี่ยนตามอุณหภูมิ ส่วน VEML7700 วัดได้กว้างถึงราว 120,000 lux ซึ่งเกินความต้องการของงานในอาคาร

**2) แหล่งแสง: แถบ LED 12 V แบบ 2 สี (CCT)**

ระบบต้องปรับสีแสงตามเวลา คือใช้แสงขาวอมฟ้าในเวลากลางวันเพื่อให้ตื่นตัว [8] และใช้แสงขาวอุ่นในช่วงค่ำเพื่อลดผลต่อการนอน [9] จึงเลือกแถบ LED ที่มีหลอดขาวอุ่น (ประมาณ 2,700-3,000 K) และขาวเย็น (ประมาณ 6,000-6,500 K) อยู่ในแถบเดียวกัน คุมแยกกันได้ 2 ช่อง เมื่อผสม 2 ช่องด้วยสัดส่วนต่างกันจะได้สีขาวทุกระดับในช่วงนี้ และกำหนดให้มีค่าความถูกต้องของสี (CRI) ไม่ต่ำกว่า 80 ตามมาตรฐานแสงสว่างในที่ทำงาน [7]

ไม่เลือกแถบ LED แบบ RGB เพราะสร้างสีขาวจากแสง 3 สี ทำให้ค่า CRI ต่ำและของบนโต๊ะดูสีเพี้ยน และไม่เลือกหลอด 220 V แบบหรี่ได้ เพราะต้องใช้วงจรหรี่ไฟกระแสสลับที่อันตรายและซับซ้อนกว่า แถบ LED ใช้ไฟ 12 V จาก adapter ตัวเดียวกับระบบ เมื่อเปิดเต็มใช้กระแสประมาณ 0.5-0.7 A (ค่าประมาณการ)

**3) วงจรขับ: MOSFET AO3400A จำนวน 2 ตัว**

ขา GPIO ของ ESP32 ให้แรงดันเพียง 3.3 V และจ่ายกระแสได้น้อย จึงขับแถบ LED 12 V โดยตรงไม่ได้ ต้องมีวงจรขับคั่นกลาง ระบบใช้ MOSFET ชนิด N เป็นสวิตช์ฝั่งลบของ LED แต่ละช่อง และใช้ PWM ปรับความสว่างโดยเปลี่ยนสัดส่วนเวลาที่ไฟติดในแต่ละคาบ

เลือก AO3400A เพราะ datasheet รับรองว่าเปิดได้เต็มที่ตั้งแต่แรงดัน Gate 2.5 V (ความต้านทานขณะเปิดไม่เกิน 48 mΩ) ซึ่งต่ำกว่า 3.3 V ของ ESP32 [22] ส่วน IRLZ44N ที่นิยมใช้กับ Arduino รับรองค่าที่ 4-5 V ขึ้นไป [29] อาจเปิดไม่สุดเมื่อใช้ 3.3 V ที่กระแส 1 A ตัว AO3400A เสียพลังงานเป็นความร้อนเพียงประมาณ 0.05 W จึงไม่ต้องติดแผ่นระบายความร้อน วงจรใส่ตัวต้านทาน 100 Ω ที่ขา Gate เพื่อจำกัดกระแสกระชาก และตัวต้านทาน 10 kΩ ดึงขา Gate ลงกราวด์ เพื่อให้ไฟดับแน่นอนระหว่างที่ ESP32 กำลังเริ่มทำงาน

ช่องขาวเย็นต่อกับขา GPIO 18 และช่องขาวอุ่นต่อกับขา GPIO 19 ทั้งสองขาใช้วงจร PWM ในตัว ESP32 ชุดเดียวกันที่ความถี่ 5 kHz ความละเอียด 13 บิต ส่วนเซนเซอร์แสงใช้ขา I²C 21 และ 22 ร่วมกับจอ OLED นอกจากนี้ทีมเลือกใช้ AO3400A กับพัดลมของโมดูลอากาศด้วย ทั้งระบบจึงใช้ MOSFET รุ่นเดียวกัน ช่วยลดจำนวนชนิดของชิ้นส่วนที่ต้องจัดหา

**ตารางที่ 4.5 สรุปอุปกรณ์โมดูลแสง**

| อุปกรณ์ | หน้าที่ | ไฟเลี้ยง | การเชื่อมต่อ | ในการจำลอง (Wokwi) |
|---|---|---|---|---|
| BH1750FVI | วัดความสว่างบนโต๊ะ (lux) | 3.3 V, สูงสุด 0.19 mA | I²C (0x23) ขา 21 และ 22 ร่วมกับ OLED | Photoresistor sensor ที่ขา GPIO 34 |
| แถบ LED 12 V แบบ 2 สี (CRI ไม่ต่ำกว่า 80) | แหล่งแสง ปรับความสว่างและสี | 12 V, ประมาณ 0.5-0.7 A | ผ่าน MOSFET | LED สีขาวและสีเหลือง |
| AO3400A จำนวน 2 ตัว | สวิตช์ PWM ช่องขาวอุ่นและขาวเย็น | - | GPIO 18 (ขาวเย็น) และ GPIO 19 (ขาวอุ่น) PWM 5 kHz | ไม่ใช้ |

ข้อจำกัดของการจำลอง: Wokwi ไม่มีแบบจำลอง BH1750 จึงใช้ photoresistor ต่อเข้าขา GPIO 34 แทน ขานี้อยู่ในวงจรแปลงสัญญาณแอนะล็อกชุดที่ 1 (ADC1) เพราะชุดที่ 2 ใช้ไม่ได้ขณะเปิด Wi-Fi และเซนเซอร์ในโปรแกรมจำลองมองไม่เห็นแสงจาก LED ที่จำลองอยู่ การทดสอบวงควบคุมแบบป้อนกลับจึงต้องคำนวณแสงจาก LED เพิ่มในโค้ดจำลอง [30]
