AnMayVaa/smart-workstation-env-regulator/09_doc_sections/D-N_notes.md

# D-N บันทึกปัญหา ข้อจำกัด และอ้างอิงของ D

| รายการ | ค่า |
|---|---|
| เวอร์ชัน | v1 |
| วันที่ | 2026-10-14 |
| เจ้าของ | D |
| ใช้ลงเล่ม | หัวข้อ 8 (ข้อ 1 และ 2), หัวข้อ 9 (ข้อ 3), หัวข้อ 10 (ข้อ 4) |

> ไฟล์นี้เรียกแต่ละส่วนด้วยชื่อโมดูล เพื่อให้ยกไปลงเล่มได้ทันที: โมดูลตรวจคนและเตือนพัก, โมดูลอากาศ, โมดูลแสง และส่วนรวมระบบ (บอร์ด ไฟเลี้ยง การสื่อสาร)
> ในโมดูลแสงใช้ **L** แทนความสว่างรวม (0 ถึง 100%) และ **r** แทนสัดส่วนแสงขาวเย็น (0 ถึง 1) ในไฟล์ D3 ตัวแปรความสว่างรวมยังชื่อ B

## 1. ปัญหาและการตัดสินใจระหว่างออกแบบ (เล่มหัวข้อ 8.1)

| # | เรื่อง | ปัญหาที่พบ | ผลถ้าไม่แก้ | ทางที่เลือก |
|---|---|---|---|---|
| 1 | เจ้าของค่าที่ผู้ใช้ปรับ | ความสว่างเป้าหมาย (FR-07) และโหมดทำงานดึก (FR-10) ไม่มีในตารางข้อมูลกลางรุ่นแรก และไม่ชัดว่าใครเป็นคนคืนค่าเมื่อผู้ใช้ลุกไป (FR-11) | โมดูลตรวจคนกับโมดูลแสงเขียนค่าเดียวกันได้ทั้งคู่ ค่าอาจชนกันหรือคืนค่าไม่ครบ | เพิ่ม `user_lux_target` และ `late_mode` ในตารางข้อมูลกลาง ให้โมดูลตรวจคน (เจ้าของปุ่มและจอ) เป็นเจ้าของคนเดียวและเป็นคนคืนค่า โมดูลแสงอ่านอย่างเดียว |
| 2 | ใครนับเวลาไม่มีคน 5 นาที | ถ้าโมดูลแสงนับเวลาไม่มีคนเองแยกจากโมดูลตรวจคน สองโมดูลอาจตัดสินไม่ตรงกัน | ไฟดับทั้งที่จอยังแสดงว่ามีคน หรือกลับกัน | ให้โมดูลตรวจคนนับที่เดียวแล้วส่ง `away_timeout` ให้โมดูลอื่นใช้ |
| 3 | เลือก MOSFET | IRLZ44N ที่นิยมใช้กับ Arduino รับรองการนำกระแสที่แรงดัน Gate 4 V ขึ้นไป แต่ขา GPIO ของ ESP32 ให้เพียง 3.3 V | MOSFET อาจเปิดไม่สุด ร้อน และไฟหรี่ไม่ตรงค่าที่สั่ง | เสนอ AO3400A ที่ datasheet รับรองตั้งแต่ 2.5 V และใช้รุ่นเดียวกันทั้งระบบ (แถบ LED 2 ตัว และพัดลม 1 ตัว) |
| 4 | เลือกเซนเซอร์แสง | ตัวเลือกมี LDR, TSL2561, VEML7700 และ BH1750 | LDR ต้องปรับเทียบเอง ค่าไม่เป็นเส้นตรง และเปลี่ยนตามอุณหภูมิ | เลือก BH1750 เพราะให้ค่าเป็น lux ตรง ตอบสนองใกล้สายตาคน และช่วงวัดพอดีกับงานในอาคาร |
| 5 | เลือกแหล่งแสง | แถบ RGB สร้างสีขาวจาก 3 สี ส่วนหลอด 220 V ต้องใช้วงจรหรี่ไฟกระแสสลับ | ของบนโต๊ะดูสีเพี้ยน หรือวงจรอันตรายและซับซ้อน | เลือกแถบ LED 12 V แบบ 2 สี (ขาวอุ่นและขาวเย็น) CRI ไม่ต่ำกว่า 80 |
| 6 | ไฟปรับขึ้นลงไม่หยุด | ค่าที่เซนเซอร์อ่านได้แกว่งเล็กน้อยตลอดเวลา วงป้อนกลับจึงอาจปรับไฟทุกรอบ | ไฟกะพริบหรือสว่างขึ้นลงจนรบกวนสายตา | ใช้ช่วงยอมรับ ±25 lux และจำกัดการปรับไม่เกิน 2% ต่อรอบ 200 ms |
| 7 | เปลี่ยนสีแล้วความสว่างเปลี่ยนตาม | ถ้าเปลี่ยน duty ของช่องขาวอุ่นและขาวเย็นตรงๆ ความสว่างรวมจะเปลี่ยนไปพร้อมกับสี | ความสว่างหลุดจาก 500 lux ทุกครั้งที่เปลี่ยนสี | แยกความสว่างรวม (L) ออกจากสัดส่วนสี (r) ช่องขาวเย็น = L × r และช่องขาวอุ่น = L × (1 - r) |
| 8 | สีแสงตอนเย็นและคนทำงานดึก | เปลี่ยนเป็นแสงอุ่นทันทีทำให้รู้สึกถึงการเปลี่ยน และคนที่ยังต้องทำงานหลัง 19:00 อาจไม่ต้องการแสงอุ่น | ผู้ใช้รำคาญหรือปิดระบบเอง | ไล่สีช่วง 17:00 ถึง 19:00 ไม่เกิน 1% ต่อนาที และเพิ่มโหมดทำงานดึกให้ผู้ใช้เลือกเอง |
| 9 | ไม่รู้เวลาตอนเพิ่งเปิดเครื่อง | ก่อนต่อ Wi-Fi และซิงก์เวลาได้ ระบบไม่รู้ว่าควรใช้แสงกลางวันหรือแสงค่ำ | อาจได้แสงอุ่นตอนกลางวัน หรือแสงเย็นตอนดึก | ใช้สีกลาง 50:50 จนกว่าจะได้เวลา แล้วค่อยๆ ขยับไปตามตาราง |
| 10 | ใช้สาย I²C ร่วมกับจอ | BH1750 และจอ OLED ของโมดูลตรวจคนอยู่บนสาย I²C เส้นเดียวกัน | สองงานใช้สายพร้อมกันแล้วข้อมูลเสีย หรืองานหนึ่งรออีกงานนานจนพลาดรอบ | ใช้ mutex `i2c_lock` รอไม่เกิน 50 ms ถ้าไม่ได้ให้ข้ามรอบและนับเป็นการอ่านพลาด |
| 11 | ค่าเกณฑ์ต้องมีที่มา | ตัวเลขในร่างแรกหลายตัวตั้งขึ้นโดยไม่มีหลักฐาน เช่น ค่าปิดพัดลม และเวลาไม่มีคนก่อนปิดไฟ | ตัวเลขในเอกสารอ้างไม่ได้ และแต่ละโมดูลอาจใช้ค่าไม่ตรงกัน | รวมค่าเกณฑ์ทั้งหมดไว้ใน D1 ให้ทุกค่ามีงานวิจัยหรือมาตรฐานรองรับ ถ้าเป็นค่าที่ตั้งเองต้องเขียนเหตุผล และให้ทุกโมดูลใช้ค่าจาก D1 ที่เดียว |

## 2. ข้อจำกัดของการออกแบบโมดูลแสง (เล่มหัวข้อ 8.2 และ 8.3)

1. **การจำลองใน Wokwi:** ไม่มีแบบจำลอง BH1750 จึงใช้ photoresistor ต่อขา GPIO 34 แทน และ photoresistor ในโปรแกรมมองไม่เห็นแสงจาก LED ที่จำลอง ต้องคำนวณแสงบนโต๊ะในโค้ดเป็น `lux_now = แสงจากตัวเลื่อน + 6 × L` · ค่าจากตัวเลื่อนแปลงจากแรงดัน ADC ด้วยวงจรแบ่งแรงดัน 10 kΩ ที่ไฟ 3.3 V: `R = 10k·V/(3.3−V)` แล้วใช้สมการของ photoresistor (GAMMA 0.7, RL10 50 kΩ) [Wokwi photoresistor reference] เดิมใช้ค่าคงที่ของไฟ 5 V ทำให้ lux สูงไป 1.8 เท่า แก้แล้วตามผลทดสอบ A5 การทดสอบจึงตรวจได้แค่ logic ไม่ได้ตรวจความแม่นยำของเซนเซอร์จริง
2. **ตัวเลขที่ยังไม่ได้วัดจริง:** กระแสของแถบ LED (0.5 ถึง 0.7 A) เป็นค่าประมาณจากสเปกทั่วไป ส่วนความสว่าง 60% เมื่อเซนเซอร์เสีย และเวลาค้างแสง 50% 60 วินาทีก่อนดับ เป็นค่าที่ตั้งจากเหตุผลในการออกแบบ ยังไม่ได้ทดสอบกับผู้ใช้จริง
3. **วัดแสงได้จุดเดียว:** เซนเซอร์อยู่ที่ฐานโคมจุดเดียว เงามือ เงาศีรษะ หรือของที่วางบนโต๊ะอาจทำให้ค่าที่อ่านได้ต่างจากแสงที่ผู้ใช้เห็นจริง
4. **ตารางสีแสงยึดเวลาตายตัว:** ช่วงเปลี่ยนสี 17:00 ถึง 19:00 ไม่ได้ปรับตามฤดูกาลหรือเวลาพระอาทิตย์ตกจริง
5. **ไม่ได้ระบุยี่ห้อแถบ LED:** ระบุเป็นสเปกขั้นต่ำ (อุณหภูมิสี, CRI, แรงดัน) แทน เพราะแต่ละยี่ห้อให้ความสว่างและกระแสต่างกัน

## 3. แนวทางพัฒนาต่อ (เล่มหัวข้อ 9)

- ปรับตารางสีแสงตามเวลาพระอาทิตย์ขึ้นและตกของพื้นที่ แทนเวลาตายตัว
- จำค่าความสว่างและโหมดที่ผู้ใช้แต่ละคนชอบไว้เป็นโปรไฟล์ เมื่อใช้โต๊ะร่วมกันหลายคน
- ใช้เซนเซอร์แสงหลายจุด หรือใช้ร่วมกับแสงธรรมชาติจากหน้าต่าง (daylight harvesting) เพื่อลดไฟที่ต้องใช้
- เชื่อมกับระบบไฟเพดานของห้อง ให้ไฟโต๊ะและไฟห้องปรับไปด้วยกัน

## 4. อ้างอิงที่ D ใช้ (ส่งให้จัดเลข IEEE ทั้งเล่ม)

- รายการ [1] ถึง [13] ตาม `01_requirements/D1_requirements.md` ข้อ 7 (โมดูลแสงใช้ [3], [4], [10], [11], [12])
- ROHM Semiconductor, "BH1750FVI: Digital 16-bit serial output type ambient light sensor IC," datasheet. (`03_hardware/datasheets/BH1750FVI_datasheet.pdf`)
- Alpha & Omega Semiconductor, "AO3400A: 30V N-channel MOSFET," datasheet. (`03_hardware/datasheets/AO3400A_datasheet.pdf`)
- Espressif Systems, "LED Control (LEDC)," *ESP-IDF Programming Guide*. [Online]. Available: https://docs.espressif.com/projects/esp-idf/en/stable/esp32/api-reference/peripherals/ledc.html
- Wokwi, "wokwi-photoresistor-sensor Reference." [Online]. Available: https://docs.wokwi.com/parts/wokwi-photoresistor-sensor
