AnMayVaa/smart-workstation-env-regulator/09_doc_sections/A-N_notes.md

# A-N บันทึกปัญหา ข้อจำกัด และอ้างอิงของ A

| รายการ | ค่า |
|---|---|
| เวอร์ชัน | v1.0 (เพิ่มปัญหาที่พบใน A4–A5) |
| วันที่ | 2026-10-14 |
| เจ้าของ | A |
| ส่งให้ | D (เล่มหัวข้อ 8 และ 10) |

## 1. ปัญหาที่พบระหว่างรวมระบบ และวิธีแก้ (เล่มหัวข้อ 8)

| # | ปัญหา | พบที่ | ผลถ้าไม่แก้ | วิธีแก้ |
|---|---|---|---|---|
| 1 | IRLZ44N ไม่มีค่ารับรองการเปิดเต็มที่ VGS = 3.3 V (datasheet ระบุต่ำสุด 4 V) | C1 (D ตรวจพบ) | อ้างว่า "เปิดเต็มที่ 3.3 V" โดยไม่มีหลักฐาน | เปลี่ยนเป็น AO3400A ทั้งระบบ (A2 ข้อ 5) |
| 2 | กระแส SCD41 ใน C1 ใช้ค่าของโหมดวัดทุก 5 นาที แต่ระบบวัดทุก 5 วินาที | C1 เทียบ datasheet | ตารางไฟต่ำกว่าจริง ~30 เท่า (0.5 vs 15–18 mA, peak 205 mA) | A2 ใช้ค่าที่ถูก แจ้ง C แก้ C1 |
| 3 | ADC2 ของ ESP32 ใช้ไม่ได้ขณะเปิด Wi-Fi | ตอนวางผังขาใน Wokwi | ค่าแสงและ CO₂ จำลองอ่านไม่ได้เมื่อต่อ Wi-Fi | ย้ายอุปกรณ์ analog ทุกตัวไป ADC1 (GPIO 34, 35) |
| 4 | ถ้านับเฉพาะ `room_occupied_count` เมื่อ Wi-Fi ล่มค่าจะเป็น 0 และพัดลมปิดทั้งที่มีคน | ทบทวน C2 กับ A1 | CO₂ สะสมขณะมีคนอยู่ | เพิ่ม `room_desks_online` แยก "ไม่รู้" กับ "ว่าง" (A1 ข้อ 4) |
| 5 | C2 ร่างให้โหนดห้องส่ง `alert_request` ข้าม Wi-Fi แต่โหนดห้องไม่มีจอ และข้อความเตือนครั้งเดียวหายได้ | ทบทวน C2 กับ A1 | การเตือนเรื่องอากาศหายเมื่อข้อความหาย หรือโต๊ะเพิ่งต่อเข้ามา | ส่งสถานะผ่าน `air_status` อย่างเดียว B ตัดสินการเตือนเอง (A1 ข้อ 5) |
| 6 | ค่าที่ผู้ใช้ปรับ (FR-07, FR-10) ยังไม่มีในตารางข้อมูลกลาง และไม่ชัดว่าใครคืนค่า (FR-11) | D1 | สองโมดูลเขียนข้อมูลเดียวกัน | เพิ่ม `user_lux_target`, `late_mode` ให้ B เป็นเจ้าของคนเดียว |
| 7 | ขา actuator ลอย HIGH ราว 1.5 s ตอนบูตก่อนตั้ง LEDC | VCD ของ logic analyzer (A4) | พัดลมและไฟกระพริบทุกครั้งที่เปิดเครื่อง | ตั้งทุกขา actuator เป็น OUTPUT LOW เป็นอย่างแรกใน `setup()` (A5: 0 % ตั้งแต่จ่ายไฟ) |
| 8 | ปุ่มเด้ง: ISR อ่านขาระหว่างเด้งได้ค่า "ปล่อย" แล้ว lockout 30 ms ทิ้งการกดจริง | A5 desk_a (กด 3 ครั้งนับได้ 1) | ผู้ใช้กดไม่ติด ตั้งค่าและรับทราบเตือนไม่ได้ (เกิดกับปุ่มจริงด้วย) | ทุกขอบเริ่มนับเงียบ 30 ms ใหม่ แล้วอ่านระดับขาที่นิ่ง |
| 9 | STAND ที่ snooze ไว้หายเมื่อ EYE ครบกำหนดระหว่างรอ | A5 desk_a | เตือนลุกหายไปจนครบ 60 นาที (เกิดแทบทุกครั้งที่ snooze ครั้งที่ 2) | STAND ที่รออยู่ครอบ EYE (ขยายกฎของ B2) |
| 10 | core 3.x `ledcAttach()` ให้ channel ติดกันที่ใช้ timer เดียวกัน | VCD ของ A5 (พัดลม 60/80 % ออก 100 %, ไฟ CW เต็มหลัง beep) | พัดลมและไฟผิดบนบอร์ดจริงด้วย | ทุกขาใช้ channel คู่ = timer ของตัวเอง (`ledcAttachChannel`) |
| 11 | อายุ `room/air` ติดลบแบบ unsigned เมื่อข้อความมาในรอบเดียวกัน | A5 int (`link_ok` กระพริบ) | เตือนลิงก์ขาดผิดๆ ทุกไม่กี่วินาที | คำนวณอายุแบบ signed |
| 12 | `seq` เริ่มใหม่หลังรีสตาร์ตถูกนับเป็นข้อความหาย 65,507 | A5 int | สถิติการสูญหายใช้ไม่ได้ | ช่องว่าง ≥ 1,000 หรือย้อนกลับ = ผู้ส่งรีสตาร์ต |
| 13 | โหนดห้องนับโต๊ะหลังรอบอ่าน CO₂ ทำให้ FSM ใช้ค่าเก่า 1 รอบ | A5 int | ตัดสินห้องว่างช้า 5 วินาที | `air_sensor_task` เรียก `comm_update_counts()` ก่อน FSM |
| 14 | MQTT หลุดบ่อยใน Wokwi | A5 room | ทดสอบระบบรวมไม่ได้ | การจำลองช้ากว่าเวลาจริง → keepalive 60 s เฉพาะ `SIMULATION 1` |
| 15 | หัวข้อ `SENSOR FAULT` กว้าง 144 px เกินจอ 128 px · สูตร LDR จำลองใช้ค่าไฟ 5 V (lux สูงไป 1.8 เท่า) | ภาพจอ และ log ของ A5 desk_b | ข้อความทับกัน · ทดสอบวงคุมแสงด้วยค่าผิด | แสดง `SENSOR ERR` · สูตร 3.3 V `R = 10k·V/(3.3−V)` |

## 2. ข้อจำกัดของการจำลองใน Wokwi

1. ไม่มีแบบจำลองของ LD2410, BH1750, SCD41 จึงใช้ slide switch, photoresistor, potentiometer + DHT22 แทน ทดสอบได้แค่ logic ไม่ได้ทดสอบความแม่นยำของเซนเซอร์จริง
2. photoresistor มองไม่เห็นแสงจาก LED ที่จำลอง ต้องบวกแสงจำลองในโค้ด (`lux_now = lux จากตัวเลื่อน + 6 × duty`) เพื่อทดสอบวงป้อนกลับ
3. 2 โหนดอยู่คนละโปรเจค จึงคุยกันผ่าน MQTT broker สาธารณะทางอินเทอร์เน็ต เวลาส่งข้อมูลจึงช้ากว่าเครือข่ายในห้องจริง และขึ้นกับ broker ภายนอก
4. Wokwi วัดกระแสไฟไม่ได้ ตารางไฟใน A2 เป็นค่าจาก datasheet และค่าประมาณ (OLED, buzzer, แถบ LED) ต้องวัดเมื่อสร้างจริง
5. เวลาทำงานของ task ที่วัดในโปรแกรมจำลองใช้ตรวจแนวโน้มได้ แต่ไม่เท่ากับบนฮาร์ดแวร์จริงทุกประการ
6. Wokwi จำลองช้ากว่าเวลาจริง (≈ 0.3–0.7 เท่าเมื่อเปิด Wi-Fi) เวลาข้ามโหนดใน A5 จึงวัดจากนาฬิกาจริงเป็นค่าขอบบน และต้องตั้ง keepalive ยาวขึ้นเฉพาะตอนจำลอง
7. แผนฟรีของ Wokwi CLI มีโควตาเวลาทดสอบอัตโนมัติรายเดือน ชุดเต็มของ A5 ใช้ราว 10 นาทีจำลอง

## 3. แนวทางพัฒนาต่อ (ส่งให้ D ใช้ในหัวข้อ 9)

- ใช้ light-sleep อัตโนมัติของ ESP32 ร่วมกับ wake-up จากขา OUT ของ LD2410 เมื่อไม่มีคนนาน เพื่อลดไฟของโหนดโต๊ะลงอีก
- อัปเดตโปรแกรมผ่าน Wi-Fi (OTA) เมื่อมีหลายโต๊ะ ไม่ต้องถอดอุปกรณ์มาต่อสาย
- ส่งค่ารวมของห้อง (CO₂ เฉลี่ย, จำนวนชั่วโมงที่มีคน) ขึ้น cloud dashboard ผ่าน broker เดิม (บท 24) โดยไม่ส่งข้อมูลรายโต๊ะ (NFR-16)

## 4. อ้างอิงที่ A ใช้ (ส่งให้ D จัดเลข IEEE ทั้งเล่ม)

- Espressif Systems, "ESP32 Series Datasheet," v5.3.
- Espressif Systems, "ESP32-WROOM-32E & ESP32-WROOM-32UE Datasheet."
- Espressif Systems, "ESP32-DevKitC V4 Schematic."
- Espressif Systems, *ESP-IDF Programming Guide*: "Wi-Fi Driver," "System Time," "Analog to Digital Converter (ADC) Oneshot Mode Driver." [Online]. Available: https://docs.espressif.com/projects/esp-idf/en/stable/esp32/
- Texas Instruments, "LM2596 SIMPLE SWITCHER Power Converter 150-kHz 3-A Step-Down Voltage Regulator," datasheet.
- Sensirion AG, "SCD4x Datasheet."
- Alpha & Omega Semiconductor, "AO3400A 30V N-Channel MOSFET," datasheet.
- International Rectifier, "IRLZ44N HEXFET Power MOSFET," datasheet.
- OASIS, "MQTT Version 3.1.1," OASIS Standard, Oct. 2014.
- Real Time Engineers Ltd., "Mutexes," *FreeRTOS Documentation*.

## 5. ลิงก์โค้ด

- Repository: https://github.com/AnMayVaa/smart-workstation-env-regulator
- โค้ด A4: `08_code/desk_node`, `08_code/room_node` · ทดสอบอัตโนมัติ: `08_code/ci/` · ผล A5: `06_testing/A5_results.md`
