AnMayVaa/smart-workstation-env-regulator/09_doc_sections/C6_doc.md

# C6: เนื้อหาเอกสารรายงานส่วนตัวของ C (ซัน) สำหรับรวมเล่ม (v1)

> **รหัสเอกสาร:** C6_doc_v1  
> **ผู้จัดทำ:** C (ซัน - ทิวากร ฉับพลัน 6701012610112) | โมดูลอากาศ + ภาพจำลอง + แผนทดสอบ  
> **ส่งให้:** D (กล้อง - PM ใช้รวมเล่มรายงาน Final Design Document)  
> **สถานะความสำคัญ:** 🟢 ใช้ตอนรวมเล่ม (M5)

---

## ส่วนที่ 1: สำหรับหัวข้อ 3 (System Architecture) — ผังการติดตั้งอุปกรณ์ในห้องทำงาน

### 3.3 การจัดวางตำแหน่งอุปกรณ์ในสภาพแวดล้อมจริง (Room Installation & Sensor Placement)

ระบบ **Smart Workstation Environmental Regulator** ถูกออกแบบให้มีการกระจายโมดูลตรวจวัดและควบคุม (Distributed Nodes) อย่างเหมาะสมตามหลักสรีรศาสตร์และพลศาสตร์ของอากาศภายในอาคาร โดยแบ่งเป็น 2 โหนดหลัก ดังแสดงในภาพจำลองการติดตั้งสามมิติ (Isometric View):

*(ดูภาพประกอบ `C3_room_installation_v1.jpg` ในโฟลเดอร์ `07_visuals/`)*

1. **โหนดห้อง (Room Node - ESP32, Sensirion SCD41, ไฟสถานะ RGB):**
   - ติดตั้งบนผนังห้องที่ความสูง **$1.20\ \text{เมตร}$ จากพื้น** ซึ่งตรงกับระดับ **Breathing Zone (เขตการหายใจของผู้นั่งทำงาน)** ตามมาตรฐาน **ASHRAE Standard 62.1** ทำให้สามารถตรวจวัดระดับก๊าซคาร์บอนไดออกไซด์ ($\text{CO}_2$) ที่ผู้ใช้งานสูดดมเข้าสู่ร่างกายได้ตรงกับความเป็นจริงมากที่สุด
   - ติดตั้งห่างจากแนวประตู หน้าต่าง และหลีกเลี่ยงกระแสลมเย็นที่เป่าลงมาจากเครื่องปรับอากาศโดยตรง เพื่อป้องกันค่าตรวจวัดเบี่ยงเบนชั่วคราว
2. **ชุดพัดลมดูดอากาศ (Exhaust Fan DC 12V ขนาด 120mm):**
   - ติดตั้งบนผนังฝั่งภายนอกอาคารที่ความสูง **$2.20\ \text{เมตร}$ ใกล้ระดับฝ้าเพดาน** เนื่องจากก๊าซ $\text{CO}_2$ ที่ถูกคายออกจากลมหายใจมนุษย์ ($34-36^\circ\text{C}$) จะมีความร้อนและลอยตัวขึ้นสู่ที่สูงตามหลักการพาความร้อน (Thermal Plume) การติดตั้งพัดลมดูดอากาศบริเวณเพดานช่วยเร่งระบายอากาศเสียออกนอกห้องได้อย่างรวดเร็ว และช่วยลดเสียงรบกวนของผู้ใช้งานในระดับพื้นโต๊ะ
3. **โหนดโต๊ะทำงาน (Desk Node - ESP32, จอ OLED, เซนเซอร์แสง BH1750, mmWave Radar, LED Bar):**
   - เซนเซอร์วัดแสงติดตั้งขนานกับระนาบผิวหน้าโต๊ะทำงานเพื่อตรวจวัดความสว่างตกกระทบตามมาตรฐาน EN 12464-1 ($500\ \text{lux}$)
   - จอแสดงผล OLED และปุ่มกดติดตั้งทำมุมเอียง $30^\circ$ รับกับสายตาเพื่อความสะดวกในการดูค่าอากาศและเวลานั่งทำงาน

---

## ส่วนที่ 2: สำหรับหัวข้อ 4 (Hardware Design) — การเลือกอุปกรณ์โมดูลอากาศ

### 4.2 โมดูลตรวจวัดคุณภาพอากาศและควบคุมการระบายอากาศ (Air Quality & Ventilation Subsystem)

#### 4.2.1 เซนเซอร์ตรวจวัดคุณภาพอากาศ (Sensirion SCD41)
ระบบเลือกใช้เซนเซอร์ **Sensirion SCD41** ซึ่งเป็นเซนเซอร์ $\text{CO}_2$ ที่ใช้หลักการ **Photoacoustic NDIR (Non-Dispersive Infrared)** รุ่นใหม่ขนาดเล็ก ($10.1 \times 10.1 \times 6.5\ \text{mm}$) สื่อสารผ่านบัส I²C:
- **เหตุผลการเลือกเทียบกับตัวเลือกอื่น:**
  - *เปรียบเทียบกับเซนเซอร์เคมี MQ-135:* แม้ MQ-135 จะมีราคาต่ำ แต่วัดความเข้มข้น $\text{CO}_2$ จริงไม่ได้ เนื่องจากเป็นสารกึ่งตัวนำ $\text{SnO}_2$ ที่ไวต่อก๊าซรีดิวซ์รวม ทำให้ค่าคลาดเคลื่อนเมื่อมีแอลกอฮอล์หรือควันบุหรี่ อีกทั้งยังกินกระแสสูงถึง $150\ \text{mA}$ ตลอดเวลาเพราะมีขดลวดทำความร้อน
  - *เปรียบเทียบกับ NDIR Optical ทั่วไป (เช่น MH-Z19B, SCD30):* SCD41 ใช้พื้นที่ติดตั้งบน PCB น้อยกว่าถึง 8–9 เท่า ($663\ \text{mm}^3$ เทียบกับ $> 5,500\ \text{mm}^3$) และมีความแม่นยำสูงถึง $\pm(50\ \text{ppm} + 2.5\%\ \text{of reading})$ ในช่วงควบคุมการระบายอากาศ 400 – 1,000 ppm (ตาม Datasheet Version 1.7)
  - *ความคุ้มค่าด้านทรัพยากร:* ชิป SCD41 รวมเซนเซอร์อุณหภูมิ (ความแม่นยำ $\pm 0.8^\circ\text{C}$) และความชื้นสัมพัทธ์ (ความแม่นยำ $\pm 6\%\text{RH}$) ไว้ในตัว จึงประหยัดขา I/O และลดสายสัญญาณลงได้มาก (ผ่านบัส I²C ด้วย `i2c_lock` ตาม A1 ข้อ 7)

#### 4.2.2 วงจรขับพัดลมดูดอากาศ (Logic-Level MOSFET AO3400A และ Flyback Diode 1N4007)
เนื่องจากขา GPIO ของไมโครคอนโทรลเลอร์ ESP32 จ่ายกระแสได้สูงสุดเพียง $12\ \text{mA}$ ที่ระดับแรงดัน $3.3\ \text{V}$ ไม่สามารถขับพัดลมดูดอากาศ DC 12V ที่ต้องการกระแสทำงาน $250\ \text{mA}$ ได้โดยตรง (ตามเนื้อหาใน **บทที่ 13 หน้า 34–35 และ 60**):
- ระบบเลือกใช้ **Logic-Level N-Channel MOSFET เบอร์ AO3400A** ในแพ็คเกจ SOT-23 ตามข้อตกลงร่วมใน `03_hardware/proposal_A_mosfet.md` ซึ่งใน Datasheet รับรองการเปิดสุด (Fully Saturated) ตั้งแต่แรงดันเกต $V_{GS} = 2.5\ \text{V}$ (ความต้านทาน $R_{DS(on)} < 48\ \text{m}\Omega$) และ $V_{GS} = 4.5\ \text{V}$ ($R_{DS(on)} < 28\ \text{m}\Omega$) จึงมั่นใจได้ 100% ว่าขับนำกระแสได้อย่างสมบูรณ์ด้วยระดับแรงดัน $3.3\ \text{V}$ จาก ESP32 โดยไม่มีปัญหาเรื่อง Gate Under-drive เหมือน MOSFET ตัวถัง TO-220 ทั่วไป
- การสูญเสียพลังงานเป็นความร้อนต่ำมาก ($P_{loss} = I^2 \cdot R_{DS(on)} \approx 0.003\ \text{W}$) จึงไม่ต้องติดแผ่นระบายความร้อน ประหยัดพื้นที่บนบอร์ด
- รองรับการควบคุมความเร็วรอบแบบ Pulse Width Modulation (PWM) คาบ $20\ \text{ms}$ ($50\ \text{Hz}$) ได้อย่างเงียบสนิท
- ติดตั้ง **Flyback Diode เบอร์ 1N4007** ต่อขนานย้อนขั้วคร่อมขั้วต่อมอเตอร์พัดลม เพื่อเป็นเส้นทางคายกระแสเหนี่ยวนำย้อนกลับ (Inductive Kickback: $V = -L \frac{di}{dt}$) ที่เกิดขึ้นขณะมอสเฟตตัดวงจร เพื่อป้องกันแรงดันกระชากทำลายทรานซิสเตอร์ (บท 13 หน้า 35)

#### 4.2.3 ไฟสถานะ 3 สี (RGB LED Indicator)
ติดตั้งหลอดไฟ RGB LED (Common Cathode) ที่กึ่งกลางหน้ากากโหนดห้อง ต่อผ่านตัวต้านทานจำกัดกระแส $220\ \Omega$ จำนวน 3 ขา เพื่อให้ผู้ใช้ทราบสภาวะอากาศได้ทันทีจากระยะไกล (สีเขียว: ปกติ, สีเหลือง: เฝ้าระวัง, สีแดง: เกินเกณฑ์พัดลมทำงาน)

---

## ส่วนที่ 3: สำหรับหัวข้อ 5 (Software Design) — การออกแบบซอฟต์แวร์และลอจิกควบคุม

### 5.2 การออกแบบตรรกะควบคุมโมดูลอากาศ (Air Quality Control Logic & FSM)

#### 5.2.1 แผนภาพสถานะ (Finite State Machine)
ระบบควบคุมสภาพอากาศบนโหนดห้องทำงานภายใต้ระบบปฏิบัติการ FreeRTOS ทุกรอบ 5,000 ms โดยแบ่งสถานะการทำงานออกเป็น 5 สถานะ:
1. `S0_ROOM_EMPTY`: ห้องว่าง ปิดพัดลมและไฟสถานะเพื่อประหยัดพลังงาน
2. `S1_AIR_GOOD`: อากาศดี ($\text{CO}_2 < 800\ \text{ppm}$) พัดลมปิด ไฟสีเขียว
3. `S2_AIR_MODERATE`: อากาศเริ่มสะสม ($800 \le \text{CO}_2 < 1000\ \text{ppm}$) ไฟสีเหลือง ควบคุมความเร็วพัดลมตามกลไก Hysteresis
4. `S3_AIR_POOR`: อากาศแย่ ($\text{CO}_2 \ge 1000\ \text{ppm}$) เปิดพัดลม 100% ไฟสีแดง ส่งสัญญาณเตือน
5. `S4_SENSOR_FAULT`: โหมดนิรภัยเมื่อเซนเซอร์อ่านค่าไม่ได้ บังคับพัดลมหมุน 80% ไฟกะพริบแดง

#### 5.2.2 กลไกป้องกันการตัดต่อถี่ (Hysteresis Control Band)
ในการควบคุมระบบปรับสภาวะอากาศ การตั้งจุดตัดเปิด-ปิดที่ค่าเดียวจะทำให้เกิดปรากฏการณ์สั่นกระเพื่อม (Chattering) หากระดับ $\text{CO}_2$ ลอยตัวอยู่ใกล้ $1000\ \text{ppm}$ ระบบจึงกำหนดช่วง Hysteresis กว้าง $200\ \text{ppm}$:
- สั่งเปิดพัดลมเต็มกำลังเมื่อ $\text{CO}_2 \ge 1000\ \text{ppm}$ (อ้างอิงงานวิจัยของ Satish et al. [2] ที่พบว่าคะแนนการตัดสินใจลดลงอย่างชัดเจน)
- เมื่อพัดลมดูดอากาศระบายออกจน $\text{CO}_2$ ลดลงต่ำกว่า $950\ \text{ppm}$ จะลดความเร็วพัดลมลงมาที่ $60\%$
- พัดลมจะหยุดหมุนสนิท (`PWM = 0%`) ก็ต่อเมื่อค่า $\text{CO}_2$ ลดลงต่ำกว่า **$800\ \text{ppm}$** เท่านั้น ซึ่งเป็นระดับที่สมองทำงานได้อย่างมีประสิทธิภาพสูงสุดตามงานวิจัยของ Allen et al. [1]

#### 5.2.3 การรับมือความผิดพลาดและโหมดนิรภัย (Fault Tolerance & Fail-Safe Mode)
ออกแบบตามโครงสร้าง **ตรวจจับ $\rightarrow$ ตอบสนอง $\rightarrow$ แจ้งเตือน** ตามสไลด์ **บทที่ 6 หน้า 22–26**:
- *การตรวจจับ:* ตรวจสอบการสื่อสาร I²C ACK Timeout และการตรวจสอบช่วงค่าที่สมเหตุสมผล ($300 \le \text{CO}_2 \le 10,000\ \text{ppm}$) หากอ่านค่าล้มเหลวติดต่อกันครบ 3 ครั้ง (15 วินาที)
- *การตอบสนองอย่างปลอดภัย (Safe State):* บังคับสั่งเปิดพัดลมดูดอากาศที่ความเร็ว $80\%$ ค้างไว้ทันที เพื่อป้องกันความเสี่ยงที่อากาศเสียจะสะสมโดยไม่มีการระบาย (Fail-Open Policy)
- *การแจ้งเตือนและการฟื้นฟูตนเอง:* กะพริบไฟสีแดง ส่งรหัสเตือน `"AIR_SENSOR_ERROR"` ไปยังโหนดโต๊ะ และระบบจะทดสอบอ่านค่าต่อไป หากเซนเซอร์กลับมาอ่านค่าได้ปกติ 2 ครั้งติดต่อกัน ระบบจะกู้คืนสถานะทำงานปกติโดยอัตโนมัติ

---

## ส่วนที่ 4: สำหรับหัวข้อ 7 (Testing and Validation) — แผนการทดสอบโมดูลอากาศ

| รหัส | ประเภท | เป้าหมายการทดสอบ | สภาพเริ่มต้น | ค่าอินพุตที่ป้อน | ผลลัพธ์ที่คาดหวัง | การรองรับใน Wokwi |
|---|---|---|---|---|---|---|
| **TC-C-01** | Unit | การเปิดพัดลมเมื่อ $\text{CO}_2$ สูง | คนในห้อง = 1, $\text{CO}_2 = 700\ \text{ppm}$, พัดลมปิด | ปรับค่าความต้านทานแทน $\text{CO}_2$ ขึ้นเป็น $1050\ \text{ppm}$ | ภายใน 5 วินาที พัดลมติดที่ PWM 100%, ไฟ RGB แดง, ส่งเตือน `"CO2_HIGH"` | ได้ (Potentiometer + Relay/LED) |
| **TC-C-02** | Unit | การทำงานของ Hysteresis | คนในห้อง = 1, $\text{CO}_2 = 1050\ \text{ppm}$, พัดลม 100% | ลดค่า $\text{CO}_2$ ลงมาที่ $920\ \text{ppm}$ | พัดลมต้องไม่ตัดดับ แต่ลดรอบลงมาที่ PWM 60%, ไฟสถานะเป็นสีเหลือง | ได้ |
| **TC-C-03** | Unit | การปิดพัดลมสมบูรณ์ | พัดลมหมุน 60%, $\text{CO}_2 = 850\ \text{ppm}$ | ลดค่า $\text{CO}_2$ ต่ำกว่า $800\ \text{ppm}$ (เช่น $750\ \text{ppm}$) | พัดลมดับสนิท (PWM 0%), ไฟสถานะกลับเป็นสีเขียว | ได้ |
| **TC-C-04** | Unit | โหมดประหยัดพลังงานห้องว่าง | $\text{CO}_2 = 1100\ \text{ppm}$, พัดลม 100% | สัญญาณ `room_occupied_count = 0` | พัดลมหยุดทำงานทันที, ไฟสถานะดับลง | ได้ |
| **TC-C-05** | Unit | โหมดนิรภัยเมื่อเซนเซอร์หลุด/เสีย | ระบบทำงานปกติ | หยุดส่งสัญญาณ I²C นานเกิน 15 วินาที | พัดลมเปิดหมุน 80%, ไฟกะพริบแดง, ส่งเตือนเซนเซอร์เสีย | ได้ (ตัดสายหรือ Mock Error) |
| **TC-C-06** | Unit | การตรวจจับอุณหภูมิห้อง | อุณหภูมิห้องปกติ $22^\circ\text{C}$ | ปรับอุณหภูมิบน DHT22 $> 26^\circ\text{C}$ หรือ $< 20^\circ\text{C}$ | ส่งแจ้งเตือนอุณหภูมิไปยังจอโหนดโต๊ะ โดยพัดลมยังคุมตาม $\text{CO}_2$ ปกติ | ได้ (Slider DHT22 ใน Wokwi) |
