AnMayVaa/smart-workstation-env-regulator/09_doc_sections/SUN_WORD_COMPLETE_CONTENT.md

# รวมเนื้อหาทั้งหมดของ "ซัน" (นายทิวากร ฉับพลัน 6701012610112 - Role C) สำหรับนำไปวางในรายงาน Word (.docx)

> **วิธีใช้งาน:** ก๊อปปี้เนื้อหาในแต่ละหัวข้อด้านล่างนี้ ไปวางในไฟล์รายงาน Word (`.docx`) ตามเลขหัวข้อได้ทันที  
> รูปภาพประกอบสามารถกดเปิดไฟล์ภาพตามลิงก์ที่ระบุ แล้วลากหรือ Insert เข้าไปใน Word ได้เลยครับ

---

# [หน้าปก: ข้อมูลสมาชิก]

**Smart Workstation Environmental Regulator**  
**(ระบบควบคุมสภาพแวดล้อมโต๊ะทำงานอัจฉริยะ)**

**รายชื่อผู้จัดทำ:**  
1. นายพิทักษ์ ปทุมวัน รหัสนักศึกษา 6701012610104 (Role A: โอม)  
2. นายณัฐปคัลภ์ พรเฉลิมพงศ์ รหัสนักศึกษา 6701012610058 (Role B: จาว่า)  
3. นายทิวากร ฉับพลัน รหัสนักศึกษา 6701012610112 (Role C: ซัน)  
4. นายนครินทร์ บุญก่อเกื้อ รหัสนักศึกษา 6701012610198 (Role D: กล้อง)  

รายงานการออกแบบฉบับสมบูรณ์ (Final Design Document)  
วิชา 010123119 Embedded System Design  
ภาควิชาวิศวกรรมคอมพิวเตอร์ คณะวิศวกรรมศาสตร์  
มหาวิทยาลัยเทคโนโลยีพระจอมเกล้าพระนครเหนือ (KMUTNB)  
ภาคการศึกษาที่ 1 ปีการศึกษา 2569  

---

# 1. Project Overview (ภาพรวมโครงงาน)

### 1.2 Team Members and Roles (สมาชิกและบทบาทหน้าที่ของซัน)
*(นำข้อความนี้ไปใส่ในตารางบทบาทของสมาชิก)*

- **ชื่อ-นามสกุล:** นายทิวากร ฉับพลัน (ซัน) | รหัสนักศึกษา: 6701012610112
- **บทบาท:** Role C — โมดูลตรวจวัดคุณภาพอากาศ ภาพจำลองระบบ และแผนการทดสอบ (Air Quality, Visuals & QA)
- **ความรับผิดชอบด้านฮาร์ดแวร์ (Hardware Design):**
  - คัดเลือกและกำหนดคุณลักษณะทางเทคนิคของเซนเซอร์ตรวจวัดคุณภาพอากาศ Sensirion SCD41 (ตรวจวัดก๊าซ $\text{CO}_2$, อุณหภูมิ และความชื้นสัมพัทธ์)
  - ออกแบบวงจรขับพัดลมดูดอากาศ DC 12V ด้วยทรานซิสเตอร์กำลังแบบ Logic-Level N-Channel MOSFET (AO3400A) พร้อมวงจรป้องกันแรงดันเหนี่ยวนำย้อนกลับด้วย Flyback Diode (1N4007)
  - ออกแบบวงจรแสดงผลไฟสถานะคุณภาพอากาศ 3 สี (RGB LED Indicator) และคำนวณกำลังไฟฟ้าของโหนดห้อง
- **ความรับผิดชอบด้านซอฟต์แวร์ (Software Design):**
  - ออกแบบแผนภาพสถานะ (Finite State Machine: FSM) และเขียนรหัสเทียม (Pseudocode) ควบคุมพัดลมระบายอากาศตามความเข้มข้นของก๊าซ $\text{CO}_2$
  - ออกแบบแถบควบคุมฮิสเทอรีซิส (Hysteresis Band: 1000/800 ppm) เพื่อป้องกันการตัดต่อถี่ของพัดลม
  - ออกแบบระบบนิรภัยรองรับความผิดพลาด (Fail-Safe Mode) เมื่อเซนเซอร์ขัดข้องหรืออ่านค่าไม่ได้ตามหลักการวิศวกรรมระบบฝังตัว
- **งานหลักในการดำเนินงาน:**
  - สร้างภาพจำลองผลิตภัณฑ์ 3D (Device Mockups) และภาพผังการติดตั้งในห้องแบบ Isometric View ตามมาตรฐาน ASHRAE 62.1
  - รวบรวมกรณีทดสอบของทุกโมดูลเพื่อจัดทำแผนการทดสอบรวมของระบบ (Master System Integration Test Plan)

---

### [ภาพประกอบท้ายบทที่ 1]: ภาพจำลองตัวอุปกรณ์ผลิตภัณฑ์ (Device Mockup)
*(ให้แทรกรูปภาพ `07_visuals/C4_device_mockup_v1.jpg` ลงใน Word)*

**คำบรรยายใต้ภาพ: ภาพที่ 1.1 ภาพจำลองตัวอุปกรณ์ผลิตภัณฑ์ Smart Workstation Environmental Regulator**  
*(ซ้าย: โหนดโต๊ะทำงาน Desk Node พร้อมหน้าจอ OLED แถบไฟ 2 โทนสี และเซนเซอร์ตรวจคน | ขวา: กล่องควบคุมโหนดห้อง Room Node พร้อมวงแหวนไฟ RGB LED และชุดพัดลมดูดอากาศ DC 12V)*

---

# 3. System Architecture (สถาปัตยกรรมระบบ)

### 3.4 Installation Layout (ภาพและการจัดวางตำแหน่งอุปกรณ์ในสภาพแวดล้อมจริง)
*(ให้แทรกรูปภาพ `07_visuals/C3_room_installation_v1.jpg` ลงใน Word)*

**คำบรรยายใต้ภาพ: ภาพที่ 3.X ผังการติดตั้งอุปกรณ์ในห้องทำงานแบบสามมิติมุมมองเฉียง (Isometric Room Installation View)**

ระบบถูกออกแบบให้มีการกระจายโมดูลตรวจวัดและควบคุม (Distributed Nodes) ออกเป็น 2 ส่วนหลัก โดยติดตั้งตามหลักสรีรศาสตร์และพลศาสตร์การไหลของอากาศภายในอาคาร ดังนี้:

1. **โหนดห้อง (Room Node - ESP32, เซนเซอร์ SCD41, ไฟสถานะ RGB):**
   - **ตำแหน่งติดตั้ง:** ติดตั้งบนผนังห้องที่ระดับความสูง **1.20 เมตรจากพื้น**
   - **เหตุผลทางวิศวกรรม:** ระดับความสูง 1.20 เมตร สอดคล้องกับ **Breathing Zone (เขตการหายใจของมนุษย์ในท่านั่งทำงาน)** ตามมาตรฐานการระบายอากาศอาคาร **ANSI/ASHRAE Standard 62.1** ทำให้เซนเซอร์สามารถตรวจวัดปริมาณก๊าซคาร์บอนไดออกไซด์ ($\text{CO}_2$) ที่ผู้ใช้งานสูดดมเข้าสู่ปอดจริงได้อย่างแม่นยำ นอกจากนี้ยังติดตั้งห่างจากประตู หน้าต่าง และหลีกเลี่ยงกระแสลมเย็นที่เป่าลงมาจากเครื่องปรับอากาศโดยตรง เพื่อป้องกันการเกิดค่าตรวจวัดที่เบี่ยงเบนชั่วคราว
2. **ชุดพัดลมดูดอากาศ (Exhaust Fan DC 12V ขนาด 120mm):**
   - **ตำแหน่งติดตั้ง:** ติดตั้งบนผนังส่วนบนที่เชื่อมต่อสู่ภายนอกอาคาร ที่ระดับความสูง **2.20 เมตร (ใกล้ระดับฝ้าเพดาน)**
   - **เหตุผลทางวิศวกรรม:** แม้ก๊าซ $\text{CO}_2$ บริสุทธิ์จะมีความหนาแน่นมากกว่าอากาศปกติ แต่ก๊าซ $\text{CO}_2$ ที่คายออกจากลมหายใจของผู้ใช้งานจะมีอุณหภูมิร่างกายประมาณ $34-36^\circ\text{C}$ ซึ่งอุ่นกว่าอากาศในห้องแอร์ อากาศเสียจึงลอยตัวขึ้นสู่ด้านบนร่วมกับความร้อน (Thermal Plume) การติดพัดลมดูดอากาศที่ระดับเพดานช่วยดูดอากาศเสียที่สะสมอยู่ด้านบนออกนอกอาคารได้อย่างรวดเร็ว ทำให้เกิดการไหลเวียนแบบกวาดล้างอากาศ (Cross Ventilation) และยังช่วยลดระดับเสียงรบกวนจากการหมุนของพัดลมให้อยู่ห่างจากศีรษะผู้ใช้ ($< 45\ \text{dB}$)
3. **โหนดโต๊ะทำงาน (Desk Node) และอุปกรณ์โครงข่าย:**
   - **เซนเซอร์วัดแสง BH1750:** ติดตั้งบนผิวหน้าโต๊ะทำงานเพื่อตรวจวัดความสว่างตกกระทบตามมาตรฐาน EN 12464-1 ($500\ \text{lux}$)
   - **เซนเซอร์ตรวจจับคน mmWave Radar (LD2410):** หันมุมตรวจจับเข้าหาตำแหน่งลำตัวและหน้าอกของผู้นั่งทำงาน
   - **เราเตอร์ Wi-Fi (Wi-Fi Router):** กระจายสัญญาณคลื่น 2.4 GHz เพื่อเชื่อมต่อข้อมูลระหว่างโหนดโต๊ะและโหนดห้องอย่างไร้สาย

---

# 4. Hardware Design (การออกแบบฮาร์ดแวร์)

### 4.2 Sensor/Actuator Choice and Justification (การเลือกเซนเซอร์และแอคชูเอเตอร์ โมดูลอากาศ)

#### 4.2.1 ตารางสรุปการเลือกอุปกรณ์โมดูลอากาศ

| อุปกรณ์ | หน้าที่ในระบบ | เหตุผลที่เลือก | ตัวเลือกอื่นที่เปรียบเทียบ และเหตุผลที่ไม่เลือก | สเปกไฟเลี้ยง (V / mA) | การเชื่อมต่อกับ ESP32 | ในโปรแกรมจำลอง Wokwi ใช้ |
|---|---|---|---|---|---|---|
| **Sensirion SCD41** | ตรวจวัดก๊าซ $\text{CO}_2$ (ppm), อุณหภูมิ (°C) และความชื้น (%RH) | 1. ใช้เทคโนโลยี Photoacoustic NDIR ตรวจวัด $\text{CO}_2$ ได้โดยตรง โดยในช่วงควบคุมพัดลม 400–1,000 ppm มีความแม่นยำสูงถึง $\pm(50\ \text{ppm} + 2.5\%\ \text{of reading})$ (Datasheet Version 1.7 [10])<br>2. รวม 3 เซนเซอร์ในตัวเดียว ช่วยประหยัดพื้นที่ PCB และขา I/O<br>3. กินกระแสเฉลี่ยต่ำเพียง 15 mA สื่อสารผ่านบัส I²C | **1. MQ-135:** เป็นเซนเซอร์เคมี (MOx) แยกก๊าซ $\text{CO}_2$ ไม่ได้จริง ไวต่อแอลกอฮอล์และควัน อีกทั้งกินไฟสูงมาก (~150 mA จากขดลวดความร้อน [13])<br>**2. MH-Z19B / SCD30:** ขนาดใหญ่กว่า SCD41 ถึง 8–9 เท่า [14] และไม่รวมเซนเซอร์อุณหภูมิ/ความชื้น | 3.3V DC<br>กระแสเฉลี่ย: 15 mA (Peak: 205 mA ที่ 3.3V ตาม Table 4 [10]) | I²C Bus (SDA = GPIO 21, SCL = GPIO 22)<br>I²C Address: 0x62 (ผ่านการล็อกด้วย `i2c_lock` ตาม A1 ข้อ 7) | Potentiometer 10kΩ (แทนค่า $\text{CO}_2$) + DHT22 (แทนอุณหภูมิและความชื้น) |
| **พัดลมดูดอากาศ DC 12V (Exhaust Fan 120mm)** | ดูดอากาศเสียที่มี $\text{CO}_2$ สะสมออกนอกห้องเพื่อให้อากาศบริสุทธิ์ไหลเวียนเข้ามาแทนที่ | 1. การลด $\text{CO}_2$ ในห้องปิดต้องอาศัยการดูดอากาศทิ้ง พัดลมตั้งโต๊ะทั่วไปไม่สามารถลด $\text{CO}_2$ ได้<br>2. สเปกแรงลมขั้นต่ำ 50–70 CFM คำนวณจากการระบายอากาศห้อง 15–25 m³ ให้ได้ 4–6 ACH ตามมาตรฐาน ASHRAE 62.1 [9] (ดูข้อ 4.2.3)<br>3. ปรับความเร็วรอบแบบ PWM ได้นุ่มนวล เงียบสนิท | **พัดลม AC 220V:** ควบคุมความเร็วรอบได้ยาก มีความเสี่ยงอันตรายจากไฟฟ้าแรงสูง และมีสัญญาณรบกวนแม่เหล็กไฟฟ้าสูง | 12V DC (สเปกขั้นต่ำ / ค่าประมาณทางวิศวกรรม)<br>กระแสทำงาน: 250 mA (Peak สตาร์ทมอเตอร์: 400 mA) | ขับผ่านวงจรขับสวิตช์ MOSFET ควบคุมความเร็วด้วยสัญญาณ PWM ที่ GPIO 25 | LED สีน้ำเงิน ที่ GPIO 25 (ความสว่างหรี่ตาม duty cycle PWM แสดงความแรงพัดลม ตรงตาม A2 ข้อ 3-4 และ SIMULATION_GUIDE.md) |
| **วงจรขับพัดลม: Logic-Level MOSFET (AO3400A) + Flyback Diode (1N4007)** | ขับกระแสและแปลงแรงดันสัญญาณจาก 3.3V ไปขับพัดลม 12V พร้อมป้องกันไฟกระชาก | 1. ขา GPIO ของ ESP32 จ่ายไฟได้สูงสุดเพียง 3.3V / 12mA (บท 13 หน้า 34–35) ขับพัดลมโดยตรงไม่ได้<br>2. AO3400A เป็น Logic-Level MOSFET นำกระแสได้สมบูรณ์ที่แรงดันเกต 2.5–3.3V ($R_{DS(on)} < 48\ \text{m}\Omega$) [11] ความร้อนสะสมน้อยมาก ไม่ต้องติดแผ่นระบายความร้อน<br>3. รองรับการหรี่รอบพัดลมด้วย PWM คาบ 20 ms (50 Hz) (บท 13 หน้า 95)<br>4. ติดตั้งไดโอด 1N4007 ขนานย้อนขั้วเพื่อสลายแรงดันเหนี่ยวนำย้อนกลับ (Inductive Kickback: $V = -L \frac{di}{dt}$) ของมอเตอร์ (บท 13 หน้า 35 [12]) | **1. Relay Module:** เป็นสวิตช์กลไก มีเสียงดังคลิกๆ ตัดต่อบ่อยหน้าสัมผัสจะสึกหรอ และไม่สามารถหรี่รอบด้วย PWM ได้<br>**2. BJT (เช่น TIP120):** มีแรงดันตกคร่อมสูง ($V_{CE(sat)} \approx 1-2\text{V}$) เกิดความร้อนสะสมสูงและสูญเสียพลังงาน | วงจรเกต: 3.3V (< 1 mA)<br>ฝั่งโหลด: 12V / 250 mA | ขา Gate ต่อกับ ESP32 GPIO 25 (ผ่าน $R = 100\ \Omega$ และ $R_{pull-down} = 10\ \text{k}\Omega$) | ไม่ต้องต่อใน Wokwi (ต่อ LED สีน้ำเงินที่ GPIO 25 ตรงผ่านตัวต้านทาน 220 Ω จำลองการขับโหลด PWM) |
| **ไฟสถานะ 3 สี (RGB LED Common Cathode)** | แสดงสภาวะคุณภาพอากาศในห้องแบบ Real-time จากระยะไกล | 1. ผู้ใช้ทราบสภาวะอากาศได้ทันที (เขียว = อากาศดี, เหลือง = เฝ้าระวัง, แดง = เกินมาตรฐานกำลังระบายอากาศ)<br>2. กินพลังงานต่ำมาก ตอบสนองรวดเร็ว<br>3. ประหยัดต้นทุนกว่าการติดจอ LCD ซ้ำซ้อนที่โหนดห้อง | **จอแสดงผล LCD/OLED บนโหนดห้อง:** สิ้นเปลืองพลังงานและต้นทุนโดยไม่จำเป็น เนื่องจากโหนดห้องติดตั้งไว้สูง ผู้ใช้ดูรายละเอียดตัวเลขบนจอ OLED ของโหนดโต๊ะได้อยู่แล้ว | 3.3V DC (ผ่านตัวต้านทานจำกัดกระแส $R = 220\ \Omega$ ทุกขา)<br>กระแส: คำนวณจำกัดกระแสไม่เกิน 10 mA ต่อสี (ปลอดภัยต่อพอร์ต ESP32) | GPIO 18 (แดง), GPIO 19 (เขียว), GPIO 23 (น้ำเงิน) | RGB LED (Common Cathode) ขา 18, 19, 23 ใน Wokwi |

#### 4.2.2 การประมาณการใช้กำลังไฟฟ้าของโหนดห้อง (Power Requirements - Room Node)
- **แหล่งจ่ายไฟหลัก:** ใช้อะแดปเตอร์ภายนอก AC/DC Adapter 12V 1.5A จ่ายไฟตรงให้กับพัดลมดูดอากาศ 12V และใช้โมดูลแปลงไฟแบบสวิตชิ่ง (Buck Converter MP1584) แปลงไฟลงมาเป็น 5V เพื่อจ่ายเข้าขา VIN ของบอร์ด ESP32
- **การกินกระแสไฟฟ้ารวมสูงสุด:**
  - บอร์ด ESP32 (ขณะเปิดส่งสัญญาณ Wi-Fi TX): สูงสุด $240\ \text{mA}$ ที่ 5V
  - เซนเซอร์ Sensirion SCD41: สูงสุด $18\ \text{mA}$ ที่ 3.3V
  - มอเตอร์พัดลมดูดอากาศ DC 12V: ทำงานปกติ $250\ \text{mA}$, สตาร์ทสูงสุด $400\ \text{mA}$ ที่ 12V
  - ไฟสถานะ RGB LED: สูงสุด $20\ \text{mA}$ ที่ 3.3V
  - **กำลังไฟฟ้ารวมสูงสุดของโหนดห้อง:** ประมาณ **$5.73\ \text{W}$** ซึ่งอะแดปเตอร์ 12V 1.5A ($18\ \text{W}$) สามารถจ่ายพลังงานได้อย่างมีเสถียรภาพและมี Headroom เหลือเฟือ

---

# 5. Software Design (การออกแบบซอฟต์แวร์)

### 5.1 Flowcharts or UML Diagrams (แผนภาพสถานะ FSM โมดูลอากาศ)

การทำงานของโมดูลควบคุมคุณภาพอากาศบนโหนดห้อง ถูกออกแบบด้วยแผนภาพสถานะ **Finite State Machine (FSM)** แบ่งเป็น 5 สถานะหลัก ดังนี้:

**ตารางการเปลี่ยนสถานะ (State Transition Table):**

| จากสถานะ | ไปสถานะ | เงื่อนไขการเปลี่ยนสถานะ (Condition) | การทำงานของระบบ (System Action) |
|---|---|---|---|
| ทุกสถานะ | `S4: SENSOR_FAULT` | เกิดข้อผิดพลาดในการอ่านค่าเซนเซอร์ติดต่อกัน $\ge 3$ ครั้ง (15 วินาที) หรือค่าหลุดช่วงจริง | บังคับพัดลมเปิดที่ `PWM = 80%`, ไฟสถานะกะพริบสีแดง, ส่ง `alert_request = "AIR_SENSOR_ERR"` |
| `S4: SENSOR_FAULT` | `S1` หรือ `S0` | เซนเซอร์กลับมาอ่านค่าได้ถูกต้องติดต่อกัน 2 ครั้ง | ยกเลิกโหมดนิรภัย และประเมินสถานะตามค่าตรวจวัดจริง |
| `S1`, `S2`, `S3` | `S0: ROOM_EMPTY` | ไม่มีคนอยู่ในห้องเลย (`room_occupied_count == 0`) | ปิดพัดลม (`PWM = 0%`) และดับไฟสถานะ เพื่อประหยัดพลังงาน |
| `S0: ROOM_EMPTY` | `S1: AIR_GOOD` | มีคนเข้าห้อง และ $\text{CO}_2 < 800\ \text{ppm}$ | พัดลมปิด (`PWM = 0%`), ไฟสถานะ **สีเขียว** |
| `S0: ROOM_EMPTY` | `S2: AIR_MODERATE` | มีคนเข้าห้อง และ $800 \le \text{CO}_2 < 1000\ \text{ppm}$ | พัดลมปิด (`PWM = 0%`), ไฟสถานะ **สีเหลือง** |
| `S0: ROOM_EMPTY` | `S3: AIR_POOR` | มีคนเข้าห้อง และ $\text{CO}_2 \ge 1000\ \text{ppm}$ | พัดลมเปิดเต็มกำลัง (`PWM = 100%`), ไฟสถานะ **สีแดง**, ส่งคำเตือน |
| `S1: AIR_GOOD` | `S2: AIR_MODERATE` | ค่า $\text{CO}_2$ ไต่ระดับขึ้น $\ge 800\ \text{ppm}$ | คงสถานะพัดลมปิด (`PWM = 0%`), เปลี่ยนไฟสถานะเป็น **สีเหลือง** |
| `S2: AIR_MODERATE` | `S3: AIR_POOR` | ค่า $\text{CO}_2$ เพิ่มขึ้นจนถึง $\ge 1000\ \text{ppm}$ | สั่งเปิดพัดลมเต็มกำลัง (`PWM = 100%`), ไฟสถานะเป็น **สีแดง**, ส่งคำเตือน |
| `S3: AIR_POOR` | `S2: AIR_MODERATE` | พัดลมระบายจน $\text{CO}_2$ ลดลงต่ำกว่า $950\ \text{ppm}$ | ลดรอบพัดลมลงมาที่ `PWM = 60%` (ยังไม่ปิดสนิทตามหลัก Hysteresis), ไฟสีเหลือง |
| `S2: AIR_MODERATE` | `S1: AIR_GOOD` | ค่า $\text{CO}_2$ ลดลงต่ำกว่าเกณฑ์ล่าง $< 800\ \text{ppm}$ | สั่งปิดพัดลมสมบูรณ์ (`PWM = 0%`), ไฟสถานะเปลี่ยนกลับเป็น **สีเขียว** |

---

### 5.2 Pseudocode or Code Snippets (รหัสเทียมและตรรกะการควบคุมโมดูลอากาศ)

```text
// ============================================================================
// โมดูลควบคุมคุณภาพอากาศและพัดลมระบายอากาศ (โหนดห้อง - Room Node)
// ทำงานทุกๆ 5,000 ms (5 วินาที) ภายใต้ระบบปฏิบัติการ FreeRTOS
// ============================================================================

CONST INT  CO2_HIGH_LIMIT       = 1000    // เกณฑ์เปิดพัดลมเต็มกำลัง (Satish et al. [2])
CONST INT  CO2_HYST_MID         = 950     // เกณฑ์ลดความเร็วพัดลมลงมาที่ระดับกลาง
CONST INT  CO2_LOW_LIMIT        = 800     // เกณฑ์ปิดพัดลมสมบูรณ์ (Hysteresis Band = 200 ppm)
CONST REAL TEMP_MIN             = 20.0    // อุณหภูมิต่ำสุดที่ยอมรับได้ (เหมาะสมที่สุด 21-22°C [5])
CONST REAL TEMP_MAX             = 26.0    // อุณหภูมิสูงสุดก่อนแจ้งเตือน
CONST INT  MAX_SENSOR_FAULTS    = 3       // จำนวนครั้งที่อ่านพลาดติดต่อกันก่อนเข้า Fail-Safe

GLOBAL STATE current_state = S0_ROOM_EMPTY
GLOBAL INT   sensor_fault_counter = 0
GLOBAL BOOL  fan_is_ventilating = FALSE

TASK Task_AirQuality_Control (Period = 5000 ms):
    LOOP FOREVER:
        // 1. อ่านข้อมูลจากเซนเซอร์ SCD41 ผ่าน I2C บัส พร้อม Mutex Protection
        ACQUIRE_MUTEX(i2c_lock, timeout = 100 ms)
        IF lock_acquired THEN
            (read_success, co2_val, temp_val, hum_val) = READ_SCD41_SENSOR()
            RELEASE_MUTEX(i2c_lock)
        ELSE
            read_success = FALSE
        END IF

        // 2. ตรวจสอบความสมบูรณ์ของเซนเซอร์และข้อมูล (Sanity Check)
        IF (read_success == FALSE) OR (co2_val < 300) OR (co2_val > 10000) THEN
            sensor_fault_counter = sensor_fault_counter + 1
        ELSE
            sensor_fault_counter = 0
        END IF

        // 3. ประมวลผลและตัดสินใจสถานะ FSM
        IF sensor_fault_counter >= MAX_SENSOR_FAULTS THEN
            current_state = S4_SENSOR_FAULT
        ELSE IF room_occupied_count == 0 THEN
            current_state = S0_ROOM_EMPTY
            fan_is_ventilating = FALSE
        ELSE
            // กรณีห้องมีคนทำงาน และเซนเซอร์ทำงานปกติ
            IF co2_val >= CO2_HIGH_LIMIT THEN
                current_state = S3_AIR_POOR
                fan_is_ventilating = TRUE
            ELSE IF co2_val < CO2_LOW_LIMIT THEN
                current_state = S1_AIR_GOOD
                fan_is_ventilating = FALSE
            ELSE
                // ช่วง Hysteresis (800 <= CO2 < 1000 ppm)
                IF (fan_is_ventilating == TRUE) AND (co2_val >= CO2_HYST_MID) THEN
                    current_state = S3_AIR_POOR    // รักษาระดับ 100% จนกว่าจะต่ำกว่า 950 ppm
                ELSE
                    current_state = S2_AIR_MODERATE
                END IF
            END IF
        END IF

        // 4. สั่งการ Actuators และไฟสถานะ LED ตามสถานะ FSM
        SWITCH (current_state):
            CASE S0_ROOM_EMPTY:
                SET_FAN_SPEED_PWM(0%)
                SET_RGB_LED_COLOR(OFF)
                air_status.level = 0
                
            CASE S1_AIR_GOOD:
                SET_FAN_SPEED_PWM(0%)
                SET_RGB_LED_COLOR(GREEN)
                air_status.level = 0

            CASE S2_AIR_MODERATE:
                IF fan_is_ventilating == TRUE THEN
                    SET_FAN_SPEED_PWM(60%)       // ขาลง: หมุนต่อแบบเบาเพื่อดึง CO2 ให้พ้นเกณฑ์
                ELSE
                    SET_FAN_SPEED_PWM(0%)        // ขาขึ้น: ยังไม่เปิดพัดลม แสดงไฟเหลืองเฝ้าระวัง
                END IF
                SET_RGB_LED_COLOR(YELLOW)
                air_status.level = 1

            CASE S3_AIR_POOR:
                SET_FAN_SPEED_PWM(100%)          // เร่งดูดอากาศเต็มกำลัง
                SET_RGB_LED_COLOR(RED)
                air_status.level = 2
                SEND_ALERT_MESSAGE("CO2_HIGH_VENTILATING")

            CASE S4_SENSOR_FAULT:
                SET_FAN_SPEED_PWM(80%)           // Fail-Safe: บังคับระบายอากาศเพื่อความปลอดภัย
                SET_RGB_LED_COLOR(BLINKING_RED)
                air_status.level = 2
                SEND_ALERT_MESSAGE("AIR_SENSOR_HARDWARE_FAULT")
        END SWITCH

        // 5. ตรวจสอบอุณหภูมิห้อง (แจ้งเตือนอย่างเดียว ไม่สั่งแอร์)
        IF (current_state != S4_SENSOR_FAULT) AND (room_occupied_count > 0) THEN
            IF (temp_val > TEMP_MAX) THEN
                SEND_ALERT_MESSAGE("ROOM_TEMP_TOO_WARM")
            ELSE IF (temp_val < TEMP_MIN) THEN
                SEND_ALERT_MESSAGE("ROOM_TEMP_TOO_COLD")
            END IF
        END IF

        // 6. อัปเดตตัวแปรชุดข้อมูลกลางสำหรับการสื่อสาร Wi-Fi
        air_status.co2 = co2_val
        air_status.temp = temp_val
        air_status.hum = hum_val

        WAIT_FOR_NEXT_PERIOD(5000 ms)
    END LOOP
```

#### กลไกการออกแบบที่สำคัญในซอฟต์แวร์:
1. **การควบคุมแบบ Hysteresis Band ($200\ \text{ppm}$):**  
   หากตั้งเกณฑ์เปิดและปิดพัดลมไว้ที่ $1000\ \text{ppm}$ ค่าเดียว เมื่อความเข้มข้นของก๊าซแกว่งตัวอยู่ที่ $999 - 1001\ \text{ppm}$ จะเกิดปรากฏการณ์ **Chattering (Rapid Cycling)** พัดลมจะเปิดๆ ดับๆ ถี่ๆ ทำให้มอเตอร์พัดลมสึกหรออย่างรวดเร็วและเกิดเสียงดังรบกวนสมาธิผู้ใช้ การกำหนดจุดตัดล่างไว้ที่ $800\ \text{ppm}$ ช่วยให้พัดลมดูดอากาศระบายต่อเนื่องจนสภาพอากาศสะอาดจริงก่อนที่จะหยุดหมุน
2. **ระบบนิรภัยรองรับความผิดพลาด (Fail-Safe Mode ตามสไลด์บทที่ 6 หน้า 22–26):**  
   หากสายสัญญาณ I²C หลุด หรือเซนเซอร์ชำรุด ระบบเลือกนโยบายความปลอดภัยแบบ **Fail-Open** โดยสั่งเปิดพัดลมดูดอากาศที่ความเร็ว $80\%$ ค้างไว้ทันที แทนที่จะสั่งปิดพัดลม เพราะในห้องปิดทึบ หากปิดพัดลม ก๊าซ $\text{CO}_2$ อาจสะสมจนถึงระดับอันตรายต่อสมองและการหายใจของผู้ใช้งานได้โดยไม่มีใครรู้

---

# 7. Testing and Validation (การทดสอบและการตรวจสอบ)

### 7.1 Test Plan and Scenarios (แผนและสถานการณ์ทดสอบรวมทั้งระบบ)

การทดสอบถูกแบ่งออกเป็น 2 ระดับตามหลักการ Extended Waterfall ในสไลด์บทที่ 7 และ 8:

#### 1. ตารางการทดสอบระดับโมดูล (Unit Testing Plan)
| รหัสกรณีทดสอบ | โมดูล | วัตถุประสงค์การทดสอบ | สภาพเริ่มต้น | ข้อมูลนำเข้า / การกระทำ | ผลลัพธ์ที่คาดหวัง | การทดสอบใน Wokwi |
|---|:---:|---|---|---|---|:---:|
| **TC-C-01** | C (อากาศ) | พัดลมเปิดเต็มกำลังเมื่อ $\text{CO}_2 \ge 1000\ \text{ppm}$ | คนในห้อง = 1, $\text{CO}_2 = 700\ \text{ppm}$, พัดลมปิด | ปรับ Potentiometer ให้ค่า $\text{CO}_2 = 1050\ \text{ppm}$ | ภายใน 5s พัดลมหมุนที่ PWM 100%, ไฟ RGB แดง, ส่งเตือน `CO2_HIGH` | ✅ ได้ (Potentiometer + Relay/LED) |
| **TC-C-02** | C (อากาศ) | กลไก Hysteresis รักษารอบพัดลมขาลง | พัดลมหมุน 100%, $\text{CO}_2 = 1050\ \text{ppm}$ (ไฟแดง) | ลดค่า $\text{CO}_2$ ลงมาที่ $920\ \text{ppm}$ (ยังสูงกว่า 800) | พัดลมไม่ตัดดับ แต่ลดรอบลงมาที่ PWM 60%, ไฟเปลี่ยนเป็นสีเหลือง | ✅ ได้ |
| **TC-C-03** | C (อากาศ) | พัดลมหยุดหมุนสมบูรณ์เมื่อ $\text{CO}_2 < 800\ \text{ppm}$ | พัดลมหมุน 60%, $\text{CO}_2 = 850\ \text{ppm}$ (ไฟเหลือง) | ลดค่า $\text{CO}_2$ ลงมาต่ำกว่า $800\ \text{ppm}$ (เช่น $750\ \text{ppm}$) | พัดลมหยุดหมุนสนิท (PWM 0%), ไฟสถานะกลับเป็นสีเขียว | ✅ ได้ |
| **TC-C-04** | C (อากาศ) | โหมดประหยัดพลังงานห้องว่าง (`ROOM_EMPTY`) | $\text{CO}_2 = 1200\ \text{ppm}$, พัดลมหมุน 100% | จำลองรับค่า `room_occupied_count = 0` | พัดลมหยุดทำงานทันที (PWM 0%) และไฟ RGB ดับลง | ✅ ได้ |
| **TC-C-05** | C (อากาศ) | โหมดนิรภัย Fail-Safe เมื่อเซนเซอร์ขัดข้อง | ระบบทำงานปกติ | ตัดสายสัญญาณ I²C นานเกิน 15 วินาที | พัดลมเปิดหมุน 80%, ไฟกะพริบแดง, ส่งเตือนเซนเซอร์เสีย | ✅ ได้ (Mock Error ในโค้ด) |
| **TC-C-06** | C (อากาศ) | การแจ้งเตือนอุณหภูมิห้องไม่เหมาะสม | อุณหภูมิปกติ $22^\circ\text{C}$ | ปรับเลื่อนอุณหภูมิบน DHT22 $> 26^\circ\text{C}$ หรือ $< 20^\circ\text{C}$ | ส่งคำขอเตือนอุณหภูมิไปยังจอโหนดโต๊ะ โดยพัดลมยังคุมตาม $\text{CO}_2$ ปกติ | ✅ ได้ (Slider DHT22) |
| **TC-B-01** | B (ตรวจคน) | ตรวจจับคนนั่งและเริ่มนับเวลาทำงาน | ไม่มีคนนั่ง (`occupied=0`) | ผู้ใช้นั่งลงที่โต๊ะ (กระตุ้นเซนเซอร์) | `occupied = true`, จอ OLED เริ่มนับเวลานั่งสะสม | ✅ ได้ (ปุ่มกด/PIR) |
| **TC-B-02** | B (ตรวจคน) | แจ้งเตือนพักสายตา 20-20-20 ครบ 20 นาที | นั่งทำงานต่อเนื่องครบ 20 นาที | ตัวจับเวลานับถึง 20 นาที | จอ OLED แสดงภาพพักสายตา 20 วินาที พร้อมเสียง Buzzer 1 ครั้ง | ✅ ได้ (ย่อสเกลเวลา) |
| **TC-B-03** | B (ตรวจคน) | แจ้งเตือนลุกยืดเส้นสาย ครบ 30 นาที | นั่งทำงานต่อเนื่องครบ 30 นาที | ตัวจับเวลานับถึง 30 นาที | จอ OLED แสดงภาพเตือนลุกยืน พร้อมเสียง Buzzer 2 ครั้ง | ✅ ได้ (ย่อสเกลเวลา) |
| **TC-D-01** | D (แสง) | รักษาระดับแสง 500 lux แบบป้อนกลับ | แสงบนโต๊ะ 500 lux, ไฟหรี่ต่ำ | บังแสงภายนอกให้มืดลง | วงจรเพิ่ม PWM หลอดไฟจนแสงรวมกลับมาที่ $500 \pm 50\ \text{lux}$ | ✅ ได้ (Photoresistor LDR) |
| **TC-D-02** | D (แสง) | ปรับสีแสงตามช่วงเวลากลางวัน/เย็น | มีคนนั่งทำงาน, เวลา 13:00 น. | ปรับเวลาจำลองเป็น 18:30 น. (ช่วงเย็น) | สลับกำลังขับจากหลอด Cool White ไปเพิ่ม Warm White อัตโนมัติ | ✅ ได้ |
| **TC-D-03** | D (แสง) | ปิดไฟอัตโนมัติเมื่อไม่มีคนเกิน 5 นาที | ไฟโต๊ะเปิดอยู่, ผู้ใช้ลุกออกจากโต๊ะ | ตรวจพบไม่มีคนต่อเนื่องครบ 5 นาที | โคมไฟค่อยๆ หรี่ลงจนดับสนิท (PWM 0%) | ✅ ได้ (ย่อสเกลเวลา) |
| **TC-A-01** | A (ระบบ) | ส่งข้อมูลอากาศข้าม Wi-Fi มาขึ้นจอโต๊ะ | โหนดห้องอ่านค่า $\text{CO}_2 = 650\ \text{ppm}$ | ส่งข้อมูล `air_status` ข้าม Wi-Fi | จอ OLED บนโหนดโต๊ะแสดงค่าตรงกันภายใน 5 วินาที | ✅ ได้ |
| **TC-A-02** | A (ระบบ) | ทำงานอิสระเมื่อสัญญาณ Wi-Fi หลุด | ระบบเชื่อมต่อ Wi-Fi ปกติ | ตัดสัญญาณ Wi-Fi จำลอง | โหนดโต๊ะยังตรวจคนคุมไฟได้ โหนดห้องยังคุมพัดลมได้ปกติ ไม่ค้าง | ✅ ได้ |

#### 2. สถานการณ์ทดสอบรวมระบบ (System Integration Scenarios)
- **SCENARIO-01 (วันทำงานปกติ):** ผู้ใช้นั่งทำงานที่โต๊ะ $\rightarrow$ โหนดโต๊ะเปิดไฟ 500 lux (Cool White) และเริ่มนับเวลานั่ง $\rightarrow$ ครบ 20 นาทีจอเตือนพักสายตา / ครบ 30 นาทีเตือนลุก $\rightarrow$ ก๊าซ $\text{CO}_2$ ในห้องสะสมแตะ 1000 ppm $\rightarrow$ โหนดห้องสั่งเปิดพัดลมดูดอากาศ 100% (ไฟแดง) และส่งข้อมูลมาขึ้นเตือนบนจอ OLED พร้อมกัน
- **SCENARIO-02 (ผู้ใช้ออกจากห้อง):** ผู้ใช้ลุกออกจากห้อง $\rightarrow$ โหนดโต๊ะตรวจพบไม่มีคนครบ 5 นาที สั่งปิดไฟโต๊ะทำงาน $\rightarrow$ โหนดโต๊ะส่งสัญญาณ `room_occupied_count = 0` ข้าม Wi-Fi ไปยังโหนดห้อง $\rightarrow$ โหนดห้องสั่งปิดพัดลมระบายอากาศและดับไฟสถานะ เข้าสู่โหมดประหยัดพลังงานสมบูรณ์

---

# 8. Challenges and Limitations (ความท้าทายและข้อจำกัด - โมดูลอากาศ)

### 8.1 Technical Challenges (ความท้าทายด้านเทคนิคและการจำลอง)
1. **ข้อจำกัดของโปรแกรมจำลอง Wokwi ต่อเซนเซอร์ก๊าซ:** โปรแกรม Wokwi ไม่มีโมเดลจำลองเซนเซอร์ Sensirion SCD41 ที่วัดก๊าซ $\text{CO}_2$ ด้วยหลักการ Photoacoustic NDIR จึงต้องออกแบบการจำลองทดแทน (Hardware Abstraction) โดยใช้ตัวต้านทานปรับค่าได้ (Potentiometer) เชื่อมต่อเข้าขา ADC เพื่อจำลองแรงดันเทียบเท่าความเข้มข้น $\text{CO}_2$ ($400 - 2,000\ \text{ppm}$) ควบคู่กับเซนเซอร์ DHT22 เพื่อทดสอบค่าอุณหภูมิและความชื้น
2. **ความเฉื่อยทางกายภาพของอากาศ (Physical Gas Dynamics & Latency):** การดูดอากาศเสียออกจากห้องจริงไม่ได้ทำให้ค่า $\text{CO}_2$ ลดลงทันทีในระดับวินาที แต่มีช่วงเวลาหน่วง (Transport Delay) ตามปริมาตรห้อง หากตั้งเกณฑ์จุดเดียวจะทำให้พัดลมตัดต่อถี่ จึงต้องแก้ปัญหาด้วยการออกแบบแถบ Hysteresis กว้าง $200\ \text{ppm}$

### 8.3 Limitations of Current Design (ข้อจำกัดของการออกแบบปัจจุบัน)
1. **การดึงความร้อน/ความชื้นภายนอกเข้ามา:** เมื่อพัดลมดูดอากาศเสียออกจากห้องแอร์ อากาศภายนอกจะไหลเข้ามาแทนที่ ซึ่งอาจทำให้อุณหภูมิห้องสูงขึ้นเล็กน้อย ส่งผลให้เครื่องปรับอากาศทำงานเพิ่มขึ้น
2. **ระบบเตือนอุณหภูมิแต่ไม่ได้ควบคุมเครื่องปรับอากาศโดยตรง:** เพื่อควบคุมขอบเขตโครงงานให้เหมาะสมกับเวลา ระบบจึงทำหน้าที่เพียงแจ้งเตือนให้ผู้ใช้ปรับอุณหภูมิแอร์เองเมื่ออยู่นอกช่วง $20-26^\circ\text{C}$

---

# 9. Future Improvements (แนวทางการพัฒนาต่อในอนาคต - โมดูลอากาศ)

1. **การควบคุมพัดลมแบบ Closed-Loop Proportional-Integral (PI Control) และระบบแลกเปลี่ยนความร้อน (ERV):** พัฒนาจากการปรับความเร็วพัดลมแบบ 3 ระดับ เป็นการควบคุมความเร็วรอบแบบแปรผันต่อเนื่องตามอัตราการเพิ่มขึ้นของก๊าซ $\text{CO}_2$ และติดตั้งชุดแลกเปลี่ยนพลังงานความร้อน (Energy Recovery Ventilator: ERV) ก่อนปล่อยอากาศทิ้ง เพื่อดึงความเย็นจากห้องแอร์กลับมาใช้ใหม่
2. **การติดตั้งตัวส่งสัญญาณอินฟราเรด (IR Blaster) สั่งการเครื่องปรับอากาศ:** เพิ่มวงจรส่งสัญญาณ IR บนโหนดห้องเพื่อยิงสัญญาณควบคุมรีโมทแอร์ให้อยู่ที่ $21-22^\circ\text{C}$ โดยอัตโนมัติ
3. **การเพิ่มเซนเซอร์ตรวจวัดฝุ่นละอองขนาดเล็ก ($\text{PM}_{2.5}$):** ติดตั้งเซนเซอร์ตรวจวัดอนุภาคฝุ่นภายนอก หากอากาศภายนอกมีฝุ่น $\text{PM}_{2.5}$ เกินมาตรฐาน ระบบจะสั่งปิดพัดลมดูดอากาศและแจ้งเตือนให้เปิดเครื่องฟอกอากาศภายในห้องแทน

---

# 10. References (เอกสารอ้างอิง - รูปแบบ IEEE)

- **[1]** J. G. Allen, P. MacNaughton, U. Satish, S. Santanam, J. Vallarino, and J. D. Spengler, "Associations of cognitive function scores with carbon dioxide, ventilation, and volatile organic compound exposures in office workers: A controlled exposure study of green and conventional office environments," *Environ. Health Perspect.*, vol. 124, no. 6, pp. 805–812, Jun. 2016, doi: 10.1289/ehp.1510037.
- **[2]** U. Satish et al., "Is CO2 an indoor pollutant? Direct effects of low-to-moderate CO2 concentrations on human decision-making performance," *Environ. Health Perspect.*, vol. 120, no. 12, pp. 1671–1677, Dec. 2012, doi: 10.1289/ehp.1104789.
- **[3]** *Light and lighting – Lighting of work places – Part 1: Indoor work places*, Standard EN 12464-1, European Committee for Standardization, Brussels, Belgium, 2021.
- **[4]** A. U. Viola, L. M. James, L. J. Schlangen, and D. J. Dijk, "Blue-enriched white light in the workplace improves self-reported alertness, performance and sleep quality," *Scand. J. Work Environ. Health*, vol. 34, no. 4, pp. 297–306, Aug. 2008, doi: 10.5271/sjweh.1268.
- **[5]** O. Seppänen, W. J. Fisk, and Q. H. Lei, "Effect of temperature on task performance in office environment," Lawrence Berkeley National Laboratory, Berkeley, CA, USA, Tech. Rep. LBNL-60946, Jul. 2006.
- **[6]** A. A. Abusharha and E. I. Pearce, "The effect of low humidity on the human tear film," *Cornea*, vol. 32, no. 4, pp. 429–434, Apr. 2013, doi: 10.1097/ICO.0b013e31826671ab.
- **[7]** C. Talens-Estarelles et al., "The effects of breaks on digital eye strain, dry eye and binocular vision: Testing the 20-20-20 rule," *Cont. Lens Anterior Eye*, vol. 46, no. 2, Art. no. 101744, Apr. 2023, doi: 10.1016/j.clae.2022.101744.
- **[8]** P. Wennberg et al., "Acute effects of breaking up prolonged sitting on fatigue and cognition: A pilot study," *BMJ Open*, vol. 6, no. 2, Art. no. e009630, Feb. 2016, doi: 10.1136/bmjopen-2015-009630.
- **[9]** *Ventilation for Acceptable Indoor Air Quality*, ANSI/ASHRAE Standard 62.1-2022, American Society of Heating, Refrigerating and Air-Conditioning Engineers, Atlanta, GA, USA, 2022.
- **[10]** Sensirion AG, *SCD4x – Breaking the Size Barrier in CO2 Sensing (SCD40/SCD41 Datasheet)*, Version 1.7, Apr. 2025.
- **[11]** Alpha & Omega Semiconductor, *AO3400A 30V N-Channel MOSFET Datasheet*, Rev. 5.0, Dec. 2020.
- **[12]** Vishay General Semiconductor, *1N4001 through 1N4007 General Purpose Plastic Rectifier Datasheet*, Rev. 1.8, Feb. 2018.
- **[13]** Hanwei Electronics Co., Ltd., *MQ-135 Semiconductor Sensor for Air Quality Datasheet*, 2015.
- **[14]** Zhengzhou Winsen Electronics Technology Co., Ltd., *MH-Z19B NDIR CO2 Sensor Module User's Manual*, Version 1.4, 2020.
