AnMayVaa/smart-workstation-env-regulator/10_final/D5_design_document.docx

Smart Workstation Environmental Regulator

ระบบควบคุมสภาพแวดล้อมโต๊ะทำงานอัจฉริยะ

จัดทำโดย

นายพิทักษ์ ปทุมวัน 6701012610104

นายณัฐปคัลภ์ พรเฉลิมพงศ์ 6701012610058

นายทิวากร ฉับพลัน 6701012610112

นายนครินทร์ บุญก่อเกื้อ 6701012610198

รายงานการออกแบบ (Design Document)

รายวิชา 010123119 Embedded System Design

ภาควิชาวิศวกรรมไฟฟ้าและคอมพิวเตอร์ คณะวิศวกรรมศาสตร์

มหาวิทยาลัยเทคโนโลยีพระจอมเกล้าพระนครเหนือ

ภาคการศึกษาที่ 1 ปีการศึกษา 2569

15 ตุลาคม 2569

สารบัญ

# 1. Project Overview (ภาพรวมโครงงาน)

## 1.1 Title (ชื่อโครงงาน)

Smart Workstation Environmental Regulator (ระบบควบคุมสภาพแวดล้อมโต๊ะทำงานอัจฉริยะ)

## 1.2 Team Members and Roles (สมาชิกและบทบาท)

โครงงานแบ่งงานตามโมดูลของระบบ สมาชิกแต่ละคนรับผิดชอบทั้งการออกแบบฮาร์ดแวร์และซอฟต์แวร์ของส่วนที่ตัวเองดูแล และมีงานส่วนกลางคนละหนึ่งเรื่อง เพื่อให้ทุกส่วนต่อกันได้และเอกสารมีรูปแบบเดียวกัน

ตารางที่ 1.1 สมาชิกและบทบาทในโครงงาน

ชื่อ-นามสกุล / รหัสนักศึกษา | บทบาท | งานด้านฮาร์ดแวร์ | งานด้านซอฟต์แวร์และงานส่วนกลาง
นายพิทักษ์ ปทุมวัน 6701012610104 | รวมระบบและการจำลอง | เลือกบอร์ด ESP32 ของทั้ง 2 โหนด ออกแบบระบบไฟเลี้ยงและผังขา | ออกแบบการสื่อสาร Wi-Fi/MQTT และการซิงก์เวลา เขียนโค้ดบน FreeRTOS ต่อวงจรจำลองใน Wokwi และทดสอบทั้งระบบ
นายณัฐปคัลภ์ พรเฉลิมพงศ์ 6701012610058 | โมดูลตรวจคนและเตือนพัก | เลือกเรดาร์ตรวจคน LD2410 จอ OLED buzzer และปุ่มกด | ออกแบบ FSM ตรวจคนและเตือนพัก รวมตารางงานย่อยของทั้งระบบและวิเคราะห์เวลาด้วย Rate Monotonic Scheduling
นายทิวากร ฉับพลัน 6701012610112 | โมดูลอากาศ ภาพจำลอง และแผนทดสอบ | เลือกเซนเซอร์ SCD41 พัดลมดูดอากาศพร้อมวงจรขับ และไฟสถานะ RGB | ออกแบบ FSM คุมพัดลมแบบ hysteresis และโหมดปลอดภัย ทำภาพการติดตั้งและภาพอุปกรณ์ และรวมแผนทดสอบของทุกโมดูล
นายนครินทร์ บุญก่อเกื้อ 6701012610198 | ผู้จัดการโครงการและโมดูลแสง | เลือกเซนเซอร์แสง BH1750 แถบ LED 2 สี และวงจรขับ MOSFET | ออกแบบวงป้อนกลับความสว่างและการปรับสีแสงตามเวลา กำหนดความต้องการและค่าเกณฑ์ของระบบ วางแผนงาน และรวมเล่มรายงาน

## 1.3 Abstract (บทคัดย่อ)

โครงงานนี้ออกแบบระบบควบคุมสภาพแวดล้อมโต๊ะทำงาน เพื่อลดความล้าของคนที่ทำงานหน้าคอมพิวเตอร์เป็นเวลานาน ระบบแบ่งเป็นโหนดโต๊ะและโหนดห้อง ทั้งสองโหนดใช้ ESP32 ทำงานบน FreeRTOS และสื่อสารกันผ่าน Wi-Fi ด้วยโปรโตคอล MQTT โหนดโต๊ะตรวจการนั่งด้วยเรดาร์ mmWave เตือนให้พักสายตาทุก 20 นาทีและลุกเดินทุก 30 นาที รักษาความสว่างบนโต๊ะไว้ที่ 500 lux ด้วยวงควบคุมแบบป้อนกลับ และปรับสีแสงจากขาวเย็นในเวลากลางวันเป็นขาวอุ่นในช่วงค่ำ โหนดห้องวัด CO₂ อุณหภูมิ และความชื้น แล้วคุมพัดลมดูดอากาศด้วยช่วง hysteresis 800 ถึง 1,000 ppm ค่าเกณฑ์ทุกตัวอ้างอิงจากงานวิจัยหรือมาตรฐาน และทุกโมดูลมีโหมดปลอดภัยเมื่อเซนเซอร์เสีย รวมถึงทำงานต่อได้เมื่อเครือข่ายขัดข้อง ผลการทดสอบบนโปรแกรมจำลอง Wokwi ผ่านครบ 21 จาก 21 รายการที่รันอัตโนมัติ และ 5 จาก 5 รายการที่ทดสอบต่อเนื่อง งานควบคุมบนแกนประมวลผลที่ 1 ของโหนดโต๊ะใช้เวลารวม 29.0% ต่ำกว่าขอบเขตของ Rate Monotonic Scheduling (74.3%) การรันต่อเนื่อง 22.8 นาทีไม่มีงานใดพลาดเส้นตาย และการนั่งจริงโดยไม่เร่งเวลาได้การเตือนพักสายตาที่ 20 นาทีตรงตามที่ออกแบบ

## 1.4 Objective and Problem Statement (วัตถุประสงค์และปัญหา)

คนทำงานหน้าคอมพิวเตอร์เจอปัจจัยที่ทำให้ล้าหลายอย่างพร้อมกัน ด้านสายตา อาการตาล้าจากการใช้จอดิจิทัลอาจเกิดกับผู้ใช้คอมพิวเตอร์ถึง 50% ขึ้นไป [1] การพักสายตาตามกฎ 20-20-20 ช่วยลดอาการได้ แต่งานวิจัยพบว่าเมื่อเลิกเตือน ผลที่ได้จะหายไปภายใน 1 สัปดาห์ [2] แปลว่าผู้ใช้ต้องมีสิ่งที่เตือนให้อย่างต่อเนื่อง ไม่ใช่ปล่อยให้จำเอง นอกจากนี้การนั่งนานต่อเนื่องก็ทำให้ล้า การลุกเดิน 3 นาทีทุก 30 นาทีช่วยลดความล้าได้ [3]

ด้านอากาศ ห้องทำงานที่ปิดและเปิดแอร์มี CO₂ สะสมจากลมหายใจของคนในห้อง งานวิจัยพบว่าคะแนนการคิดต่ำลง 15% เมื่อ CO₂ อยู่ที่ประมาณ 945 ppm และต่ำลง 50% ที่ประมาณ 1,400 ppm [4] และที่ 1,000 ppm ซึ่งพบได้ทั่วไปในห้องประชุมหรือห้องเรียน ความสามารถในการตัดสินใจลดลง 6 จาก 9 ด้าน [5] ส่วนอุณหภูมิ คนทำงานได้ดีที่สุดที่ประมาณ 22°C และประสิทธิภาพลดลงเมื่ออุณหภูมิสูงขึ้น [6]

ด้านแสง แสงที่ไม่พอหรือไม่คงที่ทำให้ตาต้องปรับตัวตลอดเวลา มาตรฐานแสงสว่างในที่ทำงานกำหนดความสว่างสำหรับงานเขียน อ่าน และใช้คอมพิวเตอร์ไว้ที่ 500 lux [7] สีของแสงก็มีผล แสงขาวอมฟ้าในเวลากลางวันช่วยให้พนักงานตื่นตัวขึ้น ทำงานดีขึ้น และล้าตอนเย็นน้อยลง [8] แต่แสงอมฟ้าในช่วงค่ำกดฮอร์โมนง่วงลงประมาณ 55% ทำให้หลับยากและง่วงกว่าในเช้าวันถัดไป [9]

วัตถุประสงค์

โครงงานนี้ออกแบบระบบที่ช่วยลดความล้าและรักษาความตื่นตัวของคนที่ทำงานหน้าคอมพิวเตอร์เป็นเวลานาน โดยดูแลปัจจัย 3 ด้านให้อัตโนมัติและต่อเนื่อง ดังนี้

1) สายตาและร่างกาย: เตือนให้พักสายตาและลุกยืดเส้นตามช่วงเวลาที่งานวิจัยแนะนำ

2) แสง: รักษาความสว่างบนโต๊ะให้ได้ตามมาตรฐาน และปรับสีแสงให้เหมาะกับช่วงเวลาของวัน

3) อากาศ: เฝ้าระวัง CO₂ และระบายอากาศเมื่อเกินเกณฑ์ พร้อมแจ้งเตือนเมื่ออุณหภูมิไม่เหมาะกับการทำงาน

ระบบทำงานเองเป็นหลัก แต่ยังเปิดให้ผู้ใช้ปรับบางอย่างได้ในขอบเขตที่กำหนด เพื่อให้เหมาะกับงานของแต่ละคน

## 1.5 Target Users or Beneficiaries (กลุ่มผู้ใช้และผู้ได้รับประโยชน์)

ระบบนี้ออกแบบสำหรับห้องทำงานที่มีคนนั่งทำงานหน้าคอมพิวเตอร์ประจำโต๊ะ กลุ่มผู้ใช้และผู้ได้รับประโยชน์มีดังนี้

ตารางที่ 1.2 กลุ่มผู้ใช้และผู้ได้รับประโยชน์

กลุ่ม | ลักษณะ | ได้ประโยชน์อะไร
พนักงานออฟฟิศ | นั่งทำงานหน้าคอมพิวเตอร์วันละหลายชั่วโมงในห้องแอร์ที่ปิด | ล้าน้อยลงและตื่นตัวขึ้นโดยไม่ต้องจำหรือตั้งค่าเอง
นักศึกษาและนักวิจัย | ใช้คอมพิวเตอร์ในห้องเรียน ห้องปฏิบัติการ หรือห้องสมุดเป็นเวลานาน | มีระบบเตือนพักและแสงที่เหมาะกับการอ่านตลอดวัน
ผู้ดูแลอาคาร (ไม่ได้ใช้ระบบโดยตรง) | รับผิดชอบค่าไฟและคุณภาพอากาศของห้อง | ไฟและพัดลมปิดเองเมื่อไม่มีคน ช่วยประหยัดพลังงาน

# 2. System Requirements (ความต้องการของระบบ)

## 2.1 Functional Requirements (ความต้องการเชิงหน้าที่)

ความต้องการเชิงหน้าที่ (Functional Requirements: FR) คือสิ่งที่ระบบต้องทำ แต่ละข้อมีรหัสกำกับเพื่อให้แผนทดสอบในหัวข้อ 7 อ้างถึงได้

ตารางที่ 2.1 ความต้องการเชิงหน้าที่ (FR)

รหัส | ความต้องการ | โมดูล | ที่มา / เหตุผล
FR-01 | ระบบต้องตรวจว่ามีคนนั่งที่โต๊ะหรือไม่ รวมถึงตอนที่คนนั่งนิ่ง | ตรวจจับคนนั่ง | เป็นฐานของโมดูลแสงและการเตือนพัก
FR-02 | ระบบต้องนับเวลาที่ผู้ใช้นั่งต่อเนื่อง และเริ่มนับใหม่เมื่อผู้ใช้ลุกออกนานตามที่กำหนดในการออกแบบโมดูล | ตรวจจับคนนั่ง | ใช้ตัดสินเวลาเตือนพัก
FR-03 | ระบบต้องเตือนให้พักสายตาเมื่อผู้ใช้นั่งต่อเนื่องครบ 20 นาที | เตือนพัก | [2]
FR-04 | ระบบต้องเตือนให้ลุกยืดเส้นเมื่อผู้ใช้นั่งต่อเนื่องครบ 30 นาที | เตือนพัก | [3]
FR-05 | ผู้ใช้ต้องรับทราบการเตือนได้ และเลื่อนการเตือนได้ครั้งละ 5 นาที ติดกันไม่เกิน 2 ครั้ง โดยปิดการเตือนถาวรไม่ได้ | เตือนพัก | [2] ถ้าเลิกเตือน ผลดีหายภายใน 1 สัปดาห์ จึงให้เลื่อนได้แต่ปิดไม่ได้
FR-06 | ระบบต้องปรับความสว่างบนโต๊ะให้อยู่ที่ 500 lux เมื่อมีคนนั่ง | ความสว่างคงที่ | [7]
FR-07 | ผู้ใช้ต้องปรับความสว่างเป้าหมายเพิ่มได้ในช่วง 500-1,000 lux | ความสว่างคงที่ | [7] ค่าปรับเพิ่มสำหรับงานที่ใช้สายตามาก
FR-08 | ระบบต้องหรี่ไฟเหลือ 50% เมื่อไม่มีคนนั่งครบ 5 นาที แล้วค่อยๆ ปิด และต้องเปิดไฟเมื่อตรวจพบคนกลับมา | ความสว่างคงที่ | [10]
FR-09 | ระบบต้องปรับสัดส่วนแสงขาวเย็นกับขาวอุ่นตามช่วงเวลาของวัน และใช้สัดส่วนกลางเมื่อยังไม่รู้เวลา | สีแสงตามเวลา | [8], [9]
FR-10 | ผู้ใช้ต้องเปิดโหมดทำงานดึกได้ เพื่อใช้แสงสีเดียวกับเวลากลางวันต่อหลัง 19:00 | สีแสงตามเวลา | ผู้ใช้เลือกเองระหว่างความตื่นตัวกับการนอน [9]
FR-11 | ค่าที่ผู้ใช้ปรับเอง (ความสว่างเป้าหมายและโหมดทำงานดึก) ต้องกลับเป็นค่าเริ่มต้นเมื่อไม่มีคนนั่งครบ 5 นาที | ความสว่างคงที่ / สีแสง | ผู้ใช้คนถัดไปเริ่มจากค่ามาตรฐานเสมอ
FR-12 | ระบบต้องวัด CO₂ อุณหภูมิ และความชื้นในห้องทุก 5 วินาที | อากาศ / อุณหภูมิ / ความชื้น | รอบการวัดของเซนเซอร์ [11]
FR-13 | ระบบต้องเปิดพัดลมดูดอากาศเมื่อ CO₂ ถึง 1,000 ppm และปิดเมื่อ CO₂ ลดลงถึง 800 ppm | อากาศ | [4], [5], [11]
FR-14 | ระบบต้องแสดงระดับคุณภาพอากาศที่ไฟสถานะของห้องและบนจอของทุกโต๊ะ | อากาศ | ให้ผู้ใช้รู้สาเหตุเมื่อรู้สึกง่วง
FR-15 | ระบบต้องลดความแรงหรือปิดพัดลมเมื่อไม่มีคนนั่งโต๊ะใดในห้องเลย | อากาศ | ประหยัดพลังงาน
FR-16 | ค่าเกณฑ์ของระบบและการทำงานของพัดลมต้องเปลี่ยนได้โดยผู้ดูแลระบบเท่านั้น ผู้ใช้ที่โต๊ะเปลี่ยนไม่ได้ | อากาศ / ทั้งระบบ | พัดลมและอากาศเป็นของที่ทุกคนในห้องใช้ร่วมกัน
FR-17 | ระบบต้องเตือนเมื่ออุณหภูมิห้องต่ำกว่า 20°C หรือสูงกว่า 26°C โดยไม่สั่งงานเครื่องปรับอากาศ | อุณหภูมิ | [6]
FR-18 | ระบบต้องแสดงค่าความชื้นบนจอ โดยไม่มีการเตือน | ความชื้น | [12]
FR-19 | โหนดโต๊ะต้องส่งสถานะการนั่งให้โหนดห้อง และโหนดห้องต้องส่งข้อมูลอากาศให้โหนดโต๊ะ | การสื่อสาร | ตารางข้อมูลกลาง
FR-20 | ระบบต้องรับเวลาจริงจาก NTP server และนับเวลาต่อเองเมื่อเชื่อมต่อไม่ได้ | การสื่อสาร | ใช้กับ FR-09

## 2.2 Non-Functional Requirements (ความต้องการที่ไม่ใช่เชิงหน้าที่)

ความต้องการที่ไม่ใช่เชิงหน้าที่ (Non-Functional Requirements: NFR) คือระบบต้องทำได้ดีแค่ไหน ทุกข้อเขียนให้วัดหรือตรวจได้

ตารางที่ 2.2 ความต้องการที่ไม่ใช่เชิงหน้าที่ (NFR)

รหัส | ความต้องการ | โมดูล | ที่มา / เหตุผล

เวลาตอบสนอง
NFR-01 | ระบบต้องเปิดพัดลมภายใน 10 วินาทีหลัง CO₂ เกิน 1,000 ppm | อากาศ | รอบอ่านค่า 5 วินาที × 2
NFR-02 | หลังแสงภายนอกเปลี่ยน ระบบต้องกลับมาที่ความสว่างเป้าหมาย ± 50 lux ภายใน 10 วินาที | ความสว่างคงที่ | ปรับไม่เกิน 2% ต่อรอบ 200 ms
NFR-03 | ไฟต้องเริ่มสว่างขึ้นภายใน 1 วินาทีหลังตรวจพบคนกลับมานั่ง | ความสว่างคงที่ | รอบตรวจคน 100 ms + รอบคุมแสง 200 ms
NFR-04 | ระบบต้องแสดงการเตือนพักภายใน 1 วินาทีหลังครบเวลา | เตือนพัก | รอบนับเวลา 1 วินาที
NFR-05 | งานย่อยทุกงานในโหนดต้องทำเสร็จก่อนเส้นตายของตัวเอง | ทุกโหนด | เป็นระบบเวลาจริง งานที่เสร็จช้ากว่ากำหนดทำให้ผลลัพธ์ใช้ไม่ได้

ความทนทานเมื่อเกิดความผิดพลาด
NFR-06 | ถ้า Wi-Fi หลุด โหนดโต๊ะต้องยังคุมแสง ตรวจคน และเตือนพักได้ครบ และโหนดห้องต้องยังคุมพัดลมได้ | ทุกโหนด | ประมวลผลในตัวโหนด ไม่พึ่งเครือข่าย
NFR-07 | ถ้าเซนเซอร์ตัวใดอ่านค่าไม่ได้ 3 รอบติดกัน ระบบต้องเข้าสถานะปลอดภัยของโมดูลนั้นและแจ้งเตือนบนจอ | ทุกโมดูล | ออกแบบให้ล้มเหลวอย่างปลอดภัย (fail-safe)

พลังงาน
NFR-08 | เมื่อไม่มีคนนั่งครบ 5 นาที ไฟโต๊ะต้องปิด และโหนดโต๊ะต้องลดงานที่ไม่จำเป็นลง | ตรวจคน / แสง | ลดการใช้พลังงานเมื่อไม่มีผู้ใช้

คุณภาพแสง
NFR-09 | PWM ของไฟ LED ต้องมีความถี่ไม่ต่ำกว่า 3 kHz (ระบบใช้ 5 kHz) | ความสว่างคงที่ | ไม่ให้เห็นหรือรู้สึกถึงการกะพริบ [13]
NFR-10 | การเปลี่ยนสีแสงอัตโนมัติตามเวลาต้องเปลี่ยนสัดส่วนสีไม่เกิน 1% ต่อนาที | สีแสงตามเวลา | ให้ผู้ใช้ไม่รู้สึกว่าแสงเปลี่ยนกะทันหัน
NFR-11 | การเปิดไฟ ปิดไฟ และการเปลี่ยนตามคำสั่งของผู้ใช้ ต้องค่อยๆ เปลี่ยนในเวลาไม่น้อยกว่า 2 วินาที | ความสว่างคงที่ / สีแสง | ไม่ให้แสงกระชาก
NFR-12 | ระบบต้องวัดแสงได้ในช่วง 0-2,000 lux และวัด CO₂ ได้ในช่วง 400-5,000 ppm | แสง / อากาศ | ครอบคลุมค่าที่เกิดขึ้นจริงในห้องทำงาน

การขยายระบบ
NFR-13 | ต้องเพิ่มโหนดโต๊ะในห้องได้โดยไม่ต้องแก้โปรแกรมของโหนดห้อง | การสื่อสาร | รองรับห้องที่มีหลายโต๊ะ

การใช้งาน ความปลอดภัย และความเป็นส่วนตัว
NFR-14 | การเตือนทุกแบบต้องมีอย่างน้อย 2 ช่องทาง (เช่น จอและเสียง) และสถานะต้องไม่สื่อด้วยสีอย่างเดียว | เตือนพัก / อากาศ | ผู้ใช้ที่ไม่ได้มองจอหรือแยกสีได้ยากยังรับรู้การเตือนได้
NFR-15 | ค่าที่ผู้ใช้ปรับได้ต้องอยู่ในช่วงที่กำหนดเท่านั้น ระบบต้องไม่รับค่านอกช่วง | ทุกโมดูล | ป้องกันความผิดพลาดจากการป้อนค่าของผู้ใช้
NFR-16 | ข้อมูลที่ส่งออกนอกระบบ (เช่น cloud ในอนาคต) ต้องเป็นค่ารวมของห้อง ไม่ระบุรายโต๊ะ | การสื่อสาร | รักษาความเป็นส่วนตัวของผู้ใช้แต่ละคน

ตัวเลขทุกตัวที่ระบบใช้มีที่มาตามตารางนี้ ค่าเหล่านี้เป็นค่าเริ่มต้นของระบบ ผู้ใช้ปรับได้เฉพาะรายการที่ FR-05, FR-07 และ FR-10 อนุญาต

ตารางที่ 2.3 ค่าเกณฑ์ที่ใช้ในระบบและที่มา

ค่า | ค่าที่ใช้ | ที่มา / เหตุผล
CO₂ เริ่มเตือนและเปิดพัดลม | 1,000 ppm | [4], [5]
CO₂ ปิดพัดลม | 800 ppm | ห่างจากค่าเปิด 200 ppm กว้างกว่าค่าที่เซนเซอร์คลาดเคลื่อนได้ (±75 ppm ที่ 1,000 ppm [11]) ค่าที่แกว่งเล็กน้อยจึงไม่ทำให้พัดลมเปิดปิดไปมา
ความสว่างเป้าหมาย | 500 ± 50 lux (ผู้ใช้ปรับได้ถึง 1,000 lux) | [7]
สีแสง 07:00-16:59 | ขาวเย็น 80% : ขาวอุ่น 20% | [8]
สีแสง 17:00-18:59 | ค่อยๆ เปลี่ยนเป็นขาวอุ่น ไม่เกิน 1% ต่อนาที | ตั้งตามเวลาเลิกงานและเวลาพระอาทิตย์ตก
สีแสง 19:00-06:59 | ขาวอุ่น 100% (ยกเว้นเปิดโหมดทำงานดึก) | [9]
สีแสงเมื่อยังไม่รู้เวลา | ขาวเย็น 50% : ขาวอุ่น 50% | ค่ากลาง ใกล้เคียงแสง 4,000 K ที่ใช้เป็นกลุ่มเปรียบเทียบใน [8]
อุณหภูมิที่ทำงานได้ดีที่สุด | 21-22°C | [6]
อุณหภูมิที่เริ่มเตือน | ต่ำกว่า 20°C หรือสูงกว่า 26°C | [6] ประสิทธิภาพลดลงเหนือราว 24°C แต่ห้องแอร์ทั่วไปมักตั้งราว 25°C จึงเลือก 26°C เพื่อไม่ให้ระบบเตือนบ่อยจนผู้ใช้ไม่สนใจ
เตือนพักสายตา | ทุก 20 นาที | [2]
เตือนลุกยืดเส้น | ทุก 30 นาที | [3]
เลื่อนการเตือน | ครั้งละ 5 นาที ติดกันไม่เกิน 2 ครั้ง | ตั้งเอง เพื่อให้ยืดหยุ่นแต่ไม่ทิ้งการเตือน [2]
ไม่มีคนแล้วหรี่และปิดไฟ | ครบ 5 นาที หรี่เหลือ 50% แล้วค่อยๆ ปิด | [10] กำหนดให้ปิดภายในไม่เกิน 20 นาที
ความถี่ PWM ของ LED | 5 kHz (คาบ 0.2 ms) | ไม่ให้เห็นหรือรู้สึกถึงการกะพริบ [13]
คาบ PWM ของพัดลม | 5-20 ms | คาบที่ใช้ทั่วไปในการขับมอเตอร์ DC ผ่าน MOSFET

## 2.3 Hardware and Software Requirements (ฮาร์ดแวร์และซอฟต์แวร์ที่ใช้)

ระบบหนึ่งชุดประกอบด้วยโหนดห้อง 1 ชุดต่อห้อง และโหนดโต๊ะ 1 ชุดต่อโต๊ะ ทั้งสองโหนดใช้บอร์ดรุ่นเดียวกันและระบบไฟเลี้ยงแบบเดียวกัน เพื่อให้ใช้โค้ดพื้นฐานร่วมกันได้และมีอะไหล่ชนิดเดียว รายการอุปกรณ์ทั้งหมดแสดงในตารางที่ 2.4 เหตุผลของการเลือกแต่ละตัวอธิบายในบทที่ 4

ตารางที่ 2.4 รายการอุปกรณ์ทั้งระบบ

อุปกรณ์ | โหนดโต๊ะ | โหนดห้อง | ใช้ในโมดูล
ESP32-DevKitC V4 (โมดูล ESP32-WROOM-32E) | 1 | 1 | รวมระบบ
Adapter 12 V DC | 1 (2 A) | 1 (1.5 A) | รวมระบบ
โมดูลลดแรงดัน LM2596-5.0 | 1 | 1 | รวมระบบ
Polyfuse | 1 (2.5 A) | 1 (1.1 A) | รวมระบบ
ตัวเก็บประจุ 470 µF/25 V และ 100 µF/10 V | 1 + 1 | 1 + 1 | รวมระบบ
เรดาร์ตรวจคน HLK-LD2410 | 1 | - | ตรวจคนและเตือนพัก
จอ OLED SSD1306 128 × 64 แบบ I²C | 1 | - | ตรวจคนและเตือนพัก
Buzzer TDK PS1240P02BT + R 1 kΩ | 1 | - | ตรวจคนและเตือนพัก
ปุ่ม OMRON B3F-1000 + R 10 kΩ | 1 (สำรองได้อีก 1) | - | ตรวจคนและเตือนพัก
เซนเซอร์แสง BH1750 (โมดูล GY-302) | 1 | - | แสง
แถบ LED 12 V แบบ 2 สี (CCT) ยาวประมาณ 1 m | 1 | - | แสง
MOSFET AO3400A + R 100 Ω + R 10 kΩ | 2 ชุด | 1 ชุด | แสง / อากาศ
เซนเซอร์ Sensirion SCD41 | - | 1 | อากาศ
พัดลมดูดอากาศ DC 12 V ขนาด 120 mm + ไดโอด 1N4007 | - | 1 | อากาศ
ไฟสถานะ RGB LED แบบ common cathode + R 220 Ω 3 ตัว | - | 1 | อากาศ

ด้านซอฟต์แวร์ โค้ดเขียนบน Arduino-ESP32 core รุ่น 3.0.7 ซึ่งมี FreeRTOS อยู่ในตัว และใช้เครื่องมือตามตารางที่ 2.5

ตารางที่ 2.5 ซอฟต์แวร์และเครื่องมือที่ใช้

ซอฟต์แวร์ | ใช้ทำอะไร
Arduino-ESP32 core 3.0.7 (มี FreeRTOS) | เฟิร์มแวร์ของทั้งสองโหนด แบ่งงานเป็น task ตามคาบเวลา
ไลบรารี PubSubClient และ ArduinoJson | รับส่งข้อความ MQTT ในรูปแบบ JSON
ไลบรารี Adafruit SSD1306 และ Adafruit GFX | แสดงผลบนจอ OLED ของโหนดโต๊ะ
ไลบรารี DHT sensor library และ Adafruit Unified Sensor | อ่านค่าอุณหภูมิและความชื้นจาก DHT22 ที่ใช้แทน SCD41 ในการจำลอง
Wokwi (เว็บ, ส่วนขยาย VS Code และ Wokwi CLI) | จำลองวงจรและรันการทดสอบอัตโนมัติ
MQTT broker (Mosquitto ในการใช้งานจริง, broker.hivemq.com ในการจำลอง) | ตัวกลางรับส่งข้อความระหว่างโหนด
draw.io และ Graphviz | วาดแผนภาพสถานะและผังการต่อวงจร
GitHub | เก็บเอกสาร โค้ด และหลักฐานการทดสอบของทีม

# 3. System Architecture (สถาปัตยกรรมระบบ)

## 3.1 High-Level Block Diagram (แผนภาพบล็อกระดับสูง)

ระบบแบ่งเป็น 2 โหนดตามขอบเขตของปัญหา ปัญหาด้านสายตา ท่านั่ง และแสง เกิดเฉพาะที่โต๊ะแต่ละตัว จึงอยู่ในโหนดโต๊ะ ส่วนปัญหาด้านอากาศเป็นเรื่องของทั้งห้อง จึงอยู่ในโหนดห้องที่มีชุดเดียว ทั้งสองโหนดเชื่อมกันผ่าน Wi-Fi ของห้องโดยมี MQTT broker เป็นตัวกลาง และโหนดโต๊ะดึงเวลาจริงจาก NTP server เพื่อใช้เลือกสีแสง ภาพที่ 3.1 แสดงส่วนประกอบหลักและทิศทางของข้อมูล

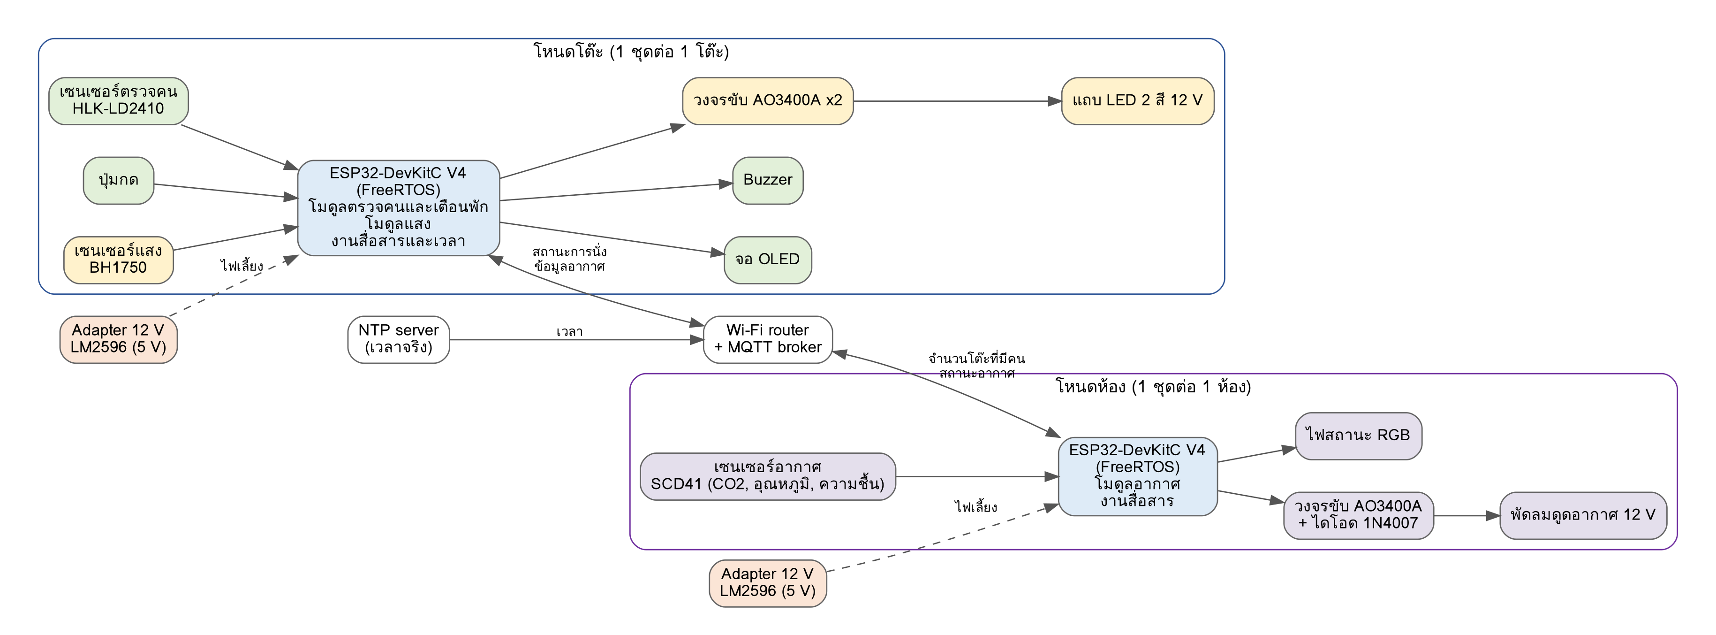
[picture p3: figure]
figure

ภาพที่ 3.1 แผนภาพบล็อกระดับสูงของระบบ

การแบ่งแบบนี้ทำให้เพิ่มโต๊ะได้โดยไม่ต้องแก้โหนดห้อง เพราะแต่ละโต๊ะส่งข้อมูลของตัวเองเข้า broker และโหนดห้องนับจำนวนโต๊ะจากข้อความที่ได้รับ งานที่ต้องตอบสนองเร็ว เช่น คุมแสงและเตือนพัก ทำในโหนดโต๊ะเองทั้งหมด ถ้าเครือข่ายขัดข้อง โต๊ะจึงยังทำงานหลักได้ครบ

## 3.2 Explanation of Modules (คำอธิบายโมดูล)

ระบบมี 4 ส่วนหลัก ได้แก่ โมดูลตรวจคนและเตือนพัก โมดูลแสง โมดูลอากาศ และส่วนรวมระบบ แต่ละส่วนออกแบบภายในได้อิสระ แต่รับส่งข้อมูลกันผ่านตารางข้อมูลกลางชุดเดียว (หัวข้อ 3.3) หน้าที่ของแต่ละส่วนสรุปไว้ดังนี้

1) โมดูลตรวจคนและเตือนพัก (โหนดโต๊ะ)

ใช้เรดาร์ mmWave ตรวจว่ามีคนนั่งที่โต๊ะหรือไม่ ซึ่งตรวจได้แม้คนนั่งนิ่ง แล้วนับเวลานั่งต่อเนื่อง เมื่อครบ 20 นาทีจะเตือนให้พักสายตา และครบ 30 นาทีจะเตือนให้ลุกเดิน ผู้ใช้รับทราบหรือเลื่อนการเตือนได้ด้วยปุ่ม และใช้ปุ่มเดียวกันตั้งความสว่างและโหมดทำงานดึกผ่านเมนูบนจอ OLED โมดูลนี้เป็นเจ้าของจอและ buzzer จึงเป็นผู้แสดงการเตือนทุกเรื่องของโหนดโต๊ะ รวมถึงการเตือนเรื่องอากาศที่ได้รับจากโหนดห้อง

2) โมดูลแสง (โหนดโต๊ะ)

วัดความสว่างบนผิวโต๊ะทุก 200 ms แล้วปรับแถบ LED ให้แสงอยู่ที่ 500 lux หรือค่าที่ผู้ใช้ตั้ง และปรับสัดส่วนแสงขาวเย็นกับขาวอุ่นตามช่วงเวลาของวัน เมื่อไม่มีคนครบ 5 นาที ไฟจะหรี่ลงครึ่งหนึ่งแล้วดับ

3) โมดูลอากาศ (โหนดห้อง)

วัด CO₂ อุณหภูมิ และความชื้นของห้องทุก 5 วินาที คุมพัดลมดูดอากาศตามระดับ CO₂ โดยมีช่วง hysteresis กันพัดลมเปิดปิดถี่ แสดงสถานะด้วยไฟ RGB และส่งสถานะอากาศให้ทุกโต๊ะ เมื่อทุกโต๊ะรายงานว่าไม่มีคน พัดลมจะหยุดเพื่อประหยัดพลังงาน

4) ส่วนรวมระบบ (ทั้งสองโหนด)

ดูแลบอร์ด ระบบไฟเลี้ยง ผังขา การสื่อสารระหว่างโหนด และเวลาจริง รวมทั้งกำหนดกติกาการใช้ทรัพยากรร่วม เช่น สาย I²C ของโหนดโต๊ะที่จอ OLED และเซนเซอร์แสงใช้ร่วมกัน

## 3.3 Interconnection between Components (การเชื่อมต่อระหว่างส่วนประกอบ)

ทุกโมดูลรับส่งข้อมูลผ่านตารางข้อมูลกลาง ข้อมูลแต่ละตัวมีผู้สร้างเพียงโมดูลเดียว โมดูลอื่นอ่านได้อย่างเดียว ถ้าต้องการให้ค่าเปลี่ยนต้องส่งคำขอไปที่เจ้าของ กติกานี้ป้องกันไม่ให้สองโมดูลเขียนค่าเดียวกันจนข้อมูลขัดกัน ภายในโหนดเดียวกันส่งข้อมูลผ่านตัวแปรที่ป้องกันด้วย mutex หรือ queue ของ FreeRTOS ส่วนข้อมูลข้ามโหนดส่งผ่าน Wi-Fi (หัวข้อ 5.4)

ตารางที่ 3.1 ข้อมูลหลักในตารางข้อมูลกลาง

ข้อมูล | ความหมาย | ผู้สร้าง | ผู้ใช้
occupied | ตอนนี้มีคนนั่งที่โต๊ะหรือไม่ (เซนเซอร์เสียให้เป็นจริงไว้ก่อน) | ตรวจคน | แสง, รวมระบบ (ส่งให้โหนดห้อง)
away_timeout | ไม่มีคนต่อเนื่องครบ 5 นาที | ตรวจคน | แสง (หรี่และปิดไฟ), รวมระบบ (ลดรอบส่ง)
user_lux_target, late_mode | ความสว่างที่ผู้ใช้ตั้ง (500 ถึง 1,000 lux) และโหมดทำงานดึก | ตรวจคน (จากปุ่มและเมนู) | แสง
time_of_day, time_valid | เวลาจริง (UTC+7) และสถานะว่าซิงก์เวลาสำเร็จแล้ว | รวมระบบ | แสง
air_status | CO₂ อุณหภูมิ ความชื้น ระดับอากาศ สถานะเซนเซอร์ และความแรงพัดลม | อากาศ | ตรวจคน (แสดงผลและเตือน)
room_occupied_count, room_desks_online | จำนวนโต๊ะที่มีคน และจำนวนโต๊ะที่ติดต่อได้ | รวมระบบ | อากาศ
link_ok | ติดต่อโหนดห้องได้หรือไม่ | รวมระบบ | ตรวจคน (ไอคอนบนจอ)
alert_request | คำขอให้จอหรือ buzzer เตือน ผ่าน queue | ทุกโมดูลในโหนดโต๊ะ | ตรวจคน (เจ้าของจอและ buzzer)
i2c_lock | mutex ของสาย I²C | รวมระบบ | ตรวจคน (OLED), แสง (BH1750), อากาศ (SCD41)

มีกติกาสำคัญ 3 ข้อที่ตกลงร่วมกัน ข้อแรก ห้องจะถือว่าว่างก็ต่อเมื่อมีโต๊ะติดต่อได้อย่างน้อยหนึ่งตัวและทุกตัวรายงานว่าไม่มีคน ถ้าติดต่อโต๊ะไม่ได้เลย ระบบถือว่า "ไม่รู้" และคุมพัดลมตาม CO₂ ต่อไป เพื่อไม่ให้ปิดพัดลมขณะที่ยังมีคนอยู่ ข้อที่สอง โหนดห้องไม่ส่งคำขอเตือนข้ามเครือข่าย แต่ส่งสถานะอากาศซ้ำทุก 5 วินาที แล้วให้โมดูลตรวจคนตัดสินการเตือนเอง ถ้าข้อความหายไปบางรอบ โต๊ะยังรู้สถานะปัจจุบันจากรอบถัดไป ข้อที่สาม ทุกงานต้องขอ i2c_lock ก่อนใช้สาย I²C รอได้ไม่เกิน 50 ms และปล่อยทันทีเมื่อจบหนึ่งรายการ ใช้ mutex แทน binary semaphore เพราะ mutex ของ FreeRTOS มี priority inheritance ช่วยลดปัญหางานความสำคัญต่ำถือล็อกค้างจนงานสำคัญต้องรอ [14]

การต่อวงจรของแต่ละโหนดแสดงในภาพที่ 3.2 และ 3.3 ทุกโหนดใช้ GND ร่วมจุดเดียวใกล้ adapter และอุปกรณ์ analog ที่ใช้แทนเซนเซอร์ในการจำลองต่อกับขา ADC1 เท่านั้น เพราะ ADC2 ของ ESP32 ใช้ไม่ได้ขณะเปิด Wi-Fi [15]

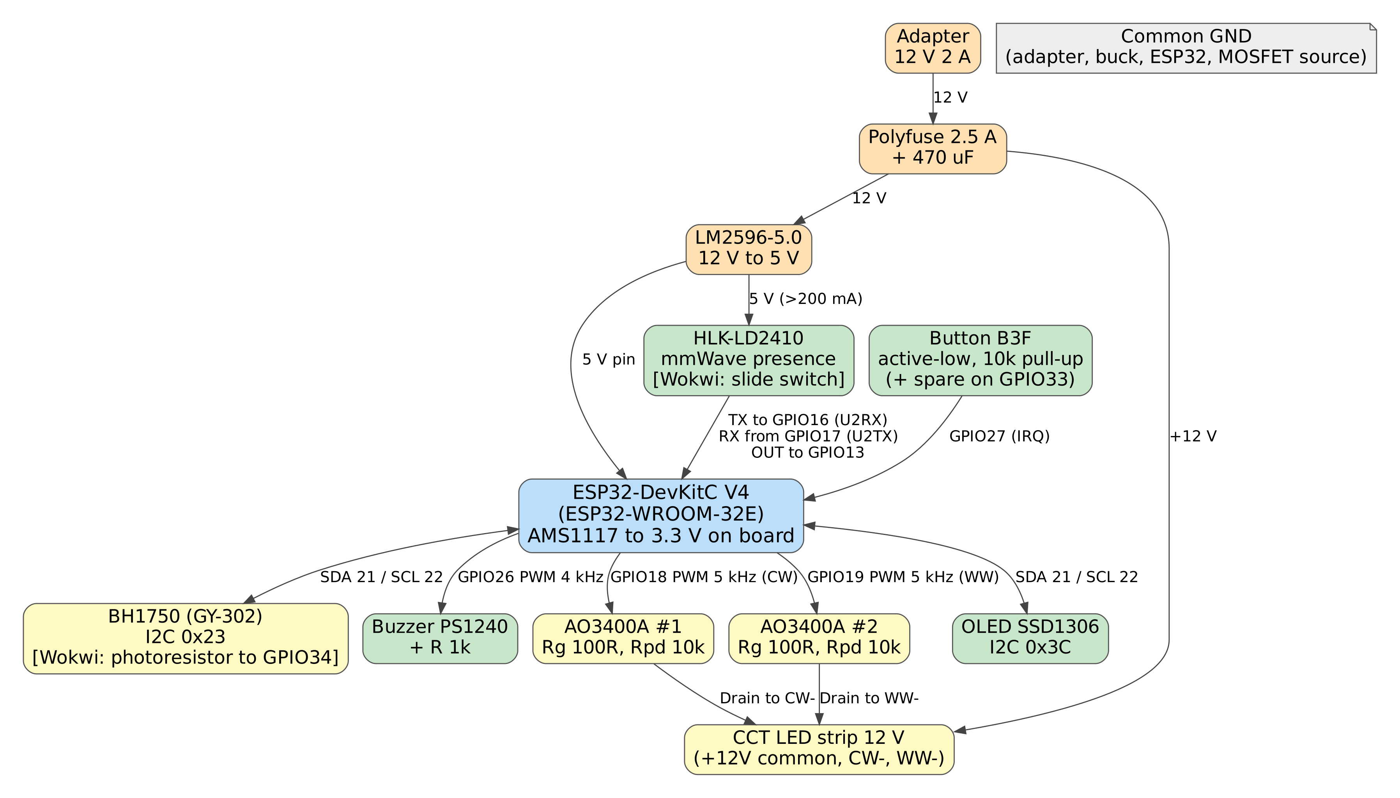
[picture p4: figure]
figure

ภาพที่ 3.2 ผังการต่อวงจรของโหนดโต๊ะ

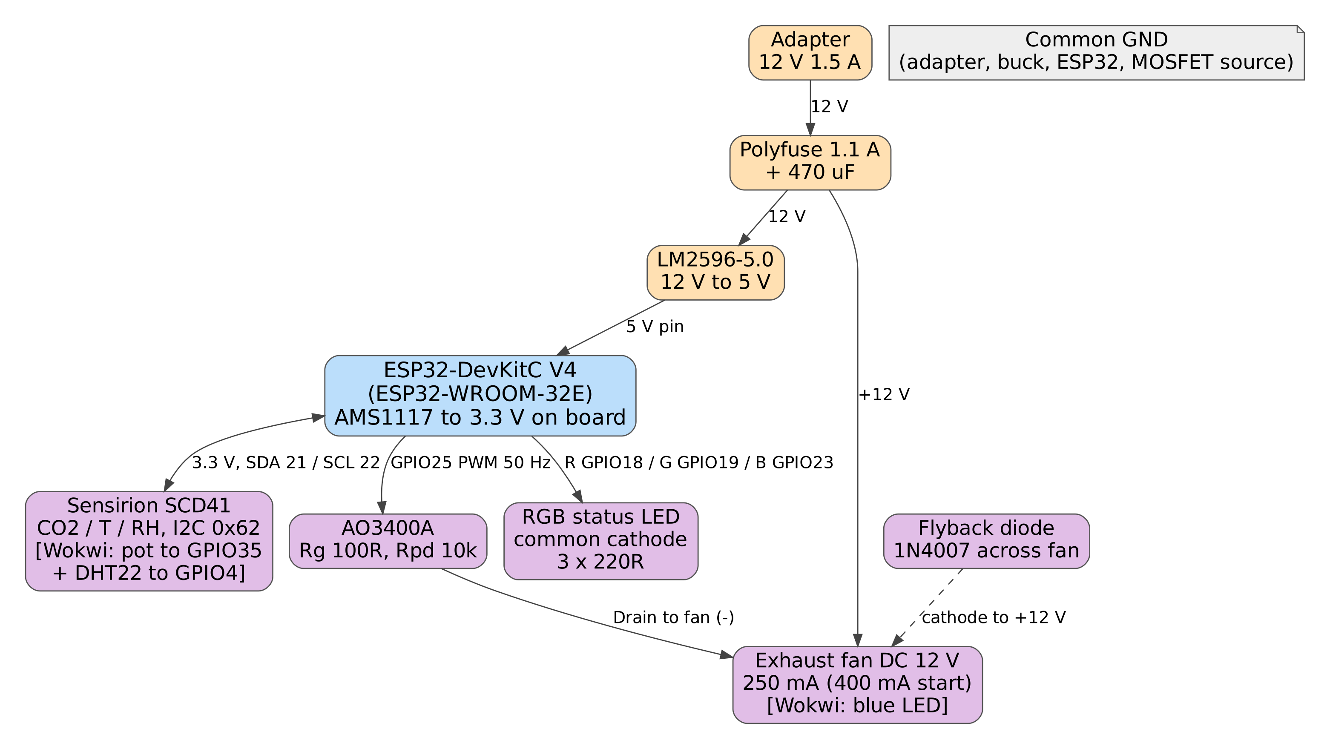
[picture p5: figure]
figure

ภาพที่ 3.3 ผังการต่อวงจรของโหนดห้อง

ตารางที่ 3.2 ผังขาของ ESP32 ทั้งสองโหนด

โหนด | GPIO | ต่อกับ
โต๊ะ | 21 / 22 | I²C SDA / SCL ของ OLED (0x3C) และ BH1750 (0x23)
โต๊ะ | 16 / 17 / 13 | UART2 RX / TX และขา OUT สำรองของ LD2410
โต๊ะ | 27 (33 สำรอง) | ปุ่ม B3F แบบ active-low พร้อม pull-up 10 kΩ
โต๊ะ | 26 | Buzzer (PWM 4 kHz)
โต๊ะ | 18 / 19 | Gate ของ AO3400A ช่องขาวเย็น / ขาวอุ่น (PWM 5 kHz 13 บิต)
โต๊ะ | 34 | เฉพาะการจำลอง: photoresistor แทน BH1750
ห้อง | 21 / 22 | I²C SDA / SCL ของ SCD41 (0x62)
ห้อง | 25 | Gate ของ AO3400A ที่ขับพัดลม (PWM 50 Hz)
ห้อง | 18 / 19 / 23 | ไฟสถานะ RGB สีแดง / เขียว / น้ำเงิน
ห้อง | 35 / 4 | เฉพาะการจำลอง: potentiometer แทนค่า CO₂ และ DHT22 แทนอุณหภูมิกับความชื้น

## 3.4 Installation Layout (ภาพการติดตั้ง)

ภาพที่ 3.4 แสดงตำแหน่งติดตั้งในห้องทำงาน โหนดห้องติดผนังที่ความสูง 1.20 m จากพื้น ซึ่งอยู่ในระดับการหายใจของคนที่นั่งทำงาน [16] จึงวัด CO₂ ได้ใกล้กับอากาศที่ผู้ใช้หายใจจริง และติดห่างจากประตู หน้าต่าง และลมจากเครื่องปรับอากาศ เพื่อไม่ให้ค่าแกว่งชั่วคราว พัดลมดูดอากาศติดผนังฝั่งภายนอกที่ความสูง 2.20 m ใกล้ฝ้าเพดาน เพราะลมหายใจที่อุ่นกว่าอากาศในห้องลอยตัวขึ้นด้านบน การดูดอากาศออกจากด้านบนจึงระบายได้เร็ว และเสียงพัดลมอยู่ห่างจากระดับโต๊ะ

ที่โต๊ะ เซนเซอร์แสงติดหงายขนานกับผิวโต๊ะเพื่อวัดแสงที่ตกบนพื้นที่ทำงานตามมาตรฐาน [7] และวางในตำแหน่งที่เงาศีรษะของผู้ใช้ไม่บัง เรดาร์ตรวจคนติดด้านหน้าใต้จอ OLED หันเข้าหาลำตัวผู้ใช้ จอและปุ่มติดเอียงประมาณ 30 องศาเพื่อให้มองเห็นง่าย ส่วนแถบ LED ติดในโคมเหนือโต๊ะที่มีแผ่นกระจายแสง ภาพที่ 3.5 แสดงหน้าตาของอุปกรณ์ทั้งสองโหนด

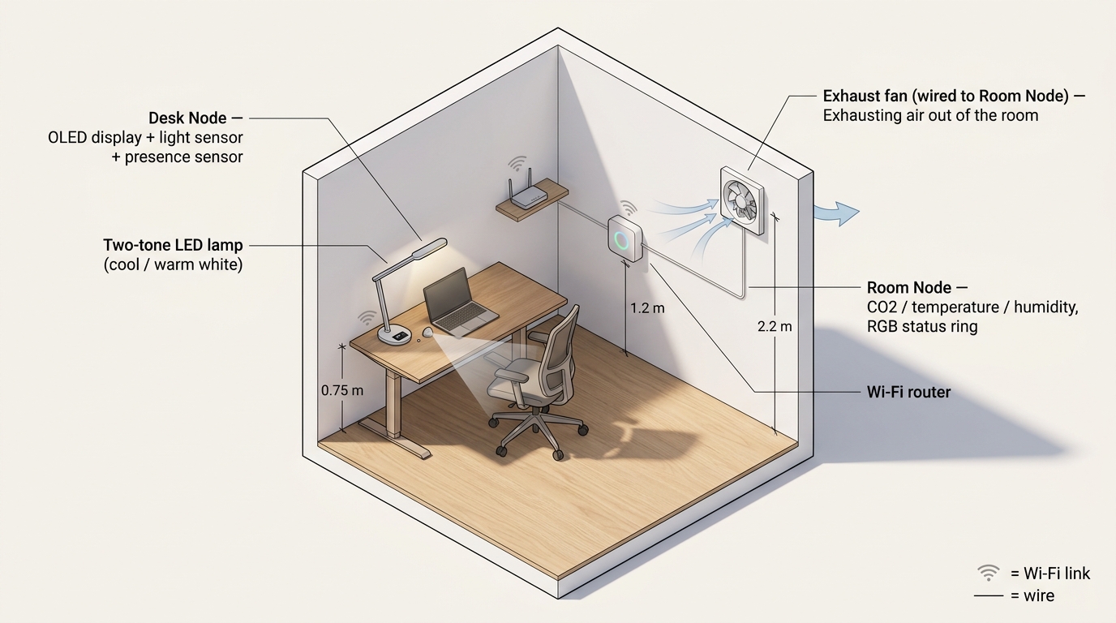
[picture p6: figure]
figure

ภาพที่ 3.4 ตำแหน่งติดตั้งอุปกรณ์ในห้องทำงาน

figure

ภาพที่ 3.5 ภาพจำลองอุปกรณ์โหนดโต๊ะ (ซ้าย) และโหนดห้องกับพัดลมดูดอากาศ (ขวา)

# 4. Hardware Design (การออกแบบฮาร์ดแวร์)

## 4.1 Selection of Microcontroller (การเลือกไมโครคอนโทรลเลอร์)

ทั้งสองโหนดใช้บอร์ด ESP32-DevKitC V4 ที่มีโมดูล ESP32-WROOM-32E การใช้บอร์ดรุ่นเดียวกันทำให้ใช้โค้ดพื้นฐานร่วมกันได้ (Wi-Fi, MQTT, FreeRTOS) และมีอะไหล่ชนิดเดียว ตารางที่ 4.1 เทียบคุณสมบัติของ ESP32 กับเกณฑ์การเลือกตัวประมวลผล ได้แก่ interrupt, timer, โหมดประหยัดพลังงาน, หน่วยความจำ, ความเร็ว, การเชื่อมต่อ และการรองรับ RTOS

ตารางที่ 4.1 คุณสมบัติของ ESP32 เทียบกับความต้องการของระบบ

เกณฑ์ | ESP32 มีอะไร | ระบบใช้ทำอะไร
Interrupt | ทุกขา GPIO ตั้งเป็นแหล่ง interrupt ได้ [17] | ปุ่มกดใช้ interrupt แบบขอบขาลง
Timer | timer 64 บิต 4 ตัว, watchdog และ LED PWM (LEDC) 16 ช่อง | PWM ของไฟ 5 kHz, พัดลม 50 Hz และ buzzer 4 kHz ใช้ฮาร์ดแวร์ ไม่ต้องสร้าง task มาสลับขา
โหมดประหยัดพลังงาน | Modem-sleep 20-68 mA, Light-sleep 0.8 mA, Deep-sleep 10 µA | วิทยุ Wi-Fi พักระหว่างรอบส่งข้อมูล
หน่วยความจำ | SRAM 520 KB, flash 4 MB บนโมดูล [18] | FreeRTOS หลาย task, Wi-Fi, MQTT และ buffer จอ 1 KB
ความเร็ว | Xtensa LX6 แบบ 2 แกน สูงสุด 240 MHz | แกน 0 ทำงานเครือข่าย แกน 1 ทำงานควบคุม
การเชื่อมต่อ | Wi-Fi 802.11 b/g/n, Bluetooth, I²C 2 ชุด, UART 3 ชุด, ADC 12 บิต 18 ช่อง | Wi-Fi ระหว่างโหนด, I²C (OLED, BH1750, SCD41), UART (LD2410)
RTOS | FreeRTOS มากับ ESP-IDF และ Arduino-ESP32 | แบ่งงานเป็น task ตามคาบเวลาและความสำคัญ

ตารางที่ 4.2 เปรียบเทียบบอร์ดที่พิจารณา

บอร์ด | จุดเด่น | เหตุผลที่ไม่เลือก
ESP32-DevKitC V4 (เลือก) | ครบทุกเกณฑ์ ราคาถูก จำลองใน Wokwi ได้พร้อม Wi-Fi | -
Arduino Uno R3 (ATmega328P) | ใช้ง่าย มีตัวอย่างมาก | ไม่มี Wi-Fi, SRAM 2 KB ไม่พอสำหรับ RTOS จอ OLED และเครือข่ายพร้อมกัน, CPU 8 บิต 16 MHz
ESP8266 (NodeMCU) | มี Wi-Fi ราคาถูก | แกนเดียว งาน Wi-Fi แย่งเวลากับงานควบคุม, ADC ช่องเดียว, ขา GPIO ไม่พอสำหรับโหนดโต๊ะ
Raspberry Pi Pico W | แกนคู่ มี Wi-Fi | FreeRTOS ไม่ได้มากับ SDK โดยตรง และจำลองพร้อม Wi-Fi ใน Wokwi ได้ไม่เท่า ESP32

## 4.2 Sensor/Actuator Choice and Justification (การเลือกเซนเซอร์และแอคชูเอเตอร์พร้อมเหตุผล)

### 4.2.1 อุปกรณ์โมดูลคุณภาพอากาศ

1) เซนเซอร์อากาศ Sensirion SCD41

SCD41 วัด CO₂ ด้วยหลักการ photoacoustic NDIR ซึ่งวัดจากการดูดกลืนแสงอินฟราเรดของ CO₂ โดยตรง และมีเซนเซอร์อุณหภูมิกับความชื้นอยู่ในตัว จึงใช้ตัวเดียววัดได้ครบ 3 ค่าผ่านสาย I²C ในช่วง 400 ถึง 1,000 ppm ซึ่งครอบคลุมเกณฑ์เปิดปิดพัดลมของระบบ ความแม่นยำของ CO₂ คือ ±(50 ppm + 2.5% ของค่าที่อ่านได้) ส่วนอุณหภูมิแม่นยำ ±0.8°C และความชื้น ±6%RH [11] โหมดวัดทุก 5 วินาทีใช้กระแสเฉลี่ย 15 mA (สูงสุด 18 mA) และมีกระแสกระชากสูงสุด 205 mA ขณะยิงพัลส์แสง ซึ่งต้องนำไปคิดในระบบไฟเลี้ยง

ตัวเลือกที่เทียบคือ MQ-135 ซึ่งเป็นเซนเซอร์เคมีราคาถูก แต่ไวต่อก๊าซหลายชนิดรวมกัน แยก CO₂ ไม่ได้จริง และมีขดลวดความร้อนที่ใช้กระแสประมาณ 150 mA ตลอดเวลา [19] ส่วนเซนเซอร์ NDIR รุ่นเดิมอย่าง MH-Z19B และ SCD30 วัดได้ดีเช่นกัน แต่มีขนาดใหญ่กว่า SCD41 ประมาณ 8 ถึง 9 เท่า [20], [21]

2) พัดลมดูดอากาศ DC 12 V ขนาด 120 mm

การลด CO₂ ในห้องปิดต้องดูดอากาศเสียออกไปภายนอก พัดลมตั้งโต๊ะทั่วไปช่วยไม่ได้เพราะแค่หมุนเวียนอากาศเดิม ห้องทำงานขนาดเล็กที่ใช้ออกแบบมีขนาด 3 × 3 × 2.5 m หรือประมาณ 795 ft³ ทีมตั้งเป้าให้พัดลมเปลี่ยนอากาศในห้องได้ 4 ถึง 5 รอบต่อชั่วโมงขณะทำงานเต็มที่ ซึ่งเป็นค่าที่สมมติขึ้นเพื่อการออกแบบ คิดเป็นแรงลม 795 × 4 ÷ 60 ≈ 53 CFM ถึง 795 × 5 ÷ 60 ≈ 66 CFM จึงกำหนดสเปกเป็นพัดลม 120 mm แรงลม 50 ถึง 70 CFM ซึ่งครอบคลุมช่วงที่คำนวณได้ พัดลมขนาดนี้ใช้กำลังประมาณ 2.5 ถึง 3.5 W หรือกระแสประมาณ 250 mA และกระแสตอนเริ่มหมุนไม่เกินประมาณ 400 mA (ค่าประมาณ) ไม่เลือกพัดลม 220 V เพราะคุมความเร็วยาก อันตรายกว่า และสร้างสัญญาณรบกวนต่อไมโครคอนโทรลเลอร์

3) วงจรขับพัดลม: AO3400A และไดโอด 1N4007

ขา GPIO ของ ESP32 จ่ายแรงดันเพียง 3.3 V และกระแสได้น้อย จึงขับพัดลมโดยตรงไม่ได้ วงจรขับใช้ MOSFET AO3400A รุ่นเดียวกับโมดูลแสง เพราะ datasheet รับรองการเปิดเต็มที่ตั้งแต่แรงดัน Gate 2.5 V [22] ที่กระแส 250 mA เสียพลังงานเป็นความร้อนเพียงประมาณ 0.003 W คุมความเร็วด้วย PWM คาบ 20 ms (50 Hz) และต่อไดโอด 1N4007 คร่อมขั้วพัดลมแบบกลับขั้ว [23] เพื่อให้กระแสจากขดลวดมอเตอร์มีทางไหลตอน MOSFET ตัดวงจร ป้องกันแรงดันกระชากทำลาย MOSFET

4) ไฟสถานะ RGB LED

ไฟสถานะสามสีที่หน้าโหนดห้องบอกสภาพอากาศได้ทันทีจากระยะไกล สีเขียวคืออากาศดี สีเหลืองคือเริ่มสะสม สีแดงคือเกินเกณฑ์และพัดลมทำงาน และกะพริบแดงเมื่อเซนเซอร์เสีย ไม่ใช้จอที่โหนดห้องเพราะติดตั้งสูงและผู้ใช้ดูตัวเลขได้จากจอของโหนดโต๊ะอยู่แล้ว แต่ละขาต่อผ่านตัวต้านทาน 220 Ω กระแสต่อสีคำนวณได้ประมาณ 2 ถึง 6 mA ไม่เกิน 10 mA ต่อสี

ตารางที่ 4.3 สรุปอุปกรณ์โมดูลอากาศ

อุปกรณ์ | หน้าที่ | ไฟเลี้ยง | การเชื่อมต่อ | ในการจำลอง (Wokwi)
SCD41 | วัด CO₂ อุณหภูมิ ความชื้น | 3.3 V, เฉลี่ย 15 mA, สูงสุด 205 mA | I²C (0x62) ขา 21 และ 22 | Potentiometer (CO₂) และ DHT22
พัดลม DC 12 V 120 mm | ดูดอากาศออกนอกห้อง | 12 V, ประมาณ 250 mA | ผ่าน MOSFET | LED สีน้ำเงิน (ความสว่างแทนความแรง)
AO3400A + 1N4007 | ขับพัดลมด้วย PWM 50 Hz | - | GPIO 25 | ไม่ใช้
RGB LED | แสดงสถานะอากาศ | 3.3 V, ไม่เกิน 10 mA ต่อสี | GPIO 18, 19, 23 | RGB LED

### 4.2.2 อุปกรณ์โมดูลตรวจจับคนและส่วนติดต่อผู้ใช้

1) เรดาร์ตรวจคน HLK-LD2410

ใช้เรดาร์ mmWave ความถี่ 24 GHz แทนเซนเซอร์ PIR เพราะผู้ใช้โต๊ะมักนั่งนิ่งเป็นเวลานาน PIR ตรวจได้เฉพาะการเคลื่อนไหว จึงอาจเข้าใจว่าไม่มีคนแล้วปิดไฟใส่ผู้ใช้ ส่วน LD2410 ตรวจได้ทั้งเป้าหมายที่เคลื่อนไหวและอยู่นิ่ง ปรับระยะได้ 0.75 ถึง 6 m ใช้ไฟ 5 V กระแสเฉลี่ย 80 mA และสื่อสารกับ ESP32 ทาง UART ที่ระดับ 3.3 V จึงต่อตรงได้โดยไม่ต้องแปลงระดับ [24] การคำนวณไฟเลี้ยงใช้ 200 mA ตามที่คู่มือกำหนดให้แหล่งจ่ายรองรับ

2) จอ OLED SSD1306

จอ OLED ขนาด 128 × 64 จุดแสดงข้อความและไอคอนได้ในพื้นที่เล็ก ต่อทาง I²C และใช้สายเดียวกับเซนเซอร์แสงได้ภายใต้กติกา i2c_lock [25] ใช้แสดงเวลานั่ง การเตือน ค่าอากาศ และเมนูตั้งค่า

3) Buzzer TDK PS1240P02BT

buzzer แบบ piezo ขับด้วยสัญญาณสี่เหลี่ยม 3 V ที่ 4 kHz ให้เสียงไม่น้อยกว่า 70 dB(A) ที่ระยะ 10 cm [26] ทำให้การเตือนมีทั้งภาพและเสียง ผู้ใช้ที่ไม่ได้มองจอจึงยังรับรู้การเตือนได้

4) ปุ่ม OMRON B3F-1000

ปุ่มกดแบบ tactile ต่อแบบ active-low พร้อมตัวต้านทาน pull-up มีความรู้สึกเมื่อกดชัดเจนและอายุการใช้งาน 1,000,000 ครั้ง [27] ใช้ปุ่มเดียวทำหลายหน้าที่ตามสถานการณ์ กดสั้นเพื่อรับทราบการเตือน กดยาวเพื่อเลื่อนการเตือน และเมื่อไม่มีการเตือน กดยาวเพื่อเข้าเมนูตั้งความสว่างหรือโหมดทำงานดึก

ตารางที่ 4.4 สรุปอุปกรณ์โมดูลตรวจจับคนและส่วนติดต่อผู้ใช้

อุปกรณ์ | หน้าที่ | ไฟเลี้ยง | การเชื่อมต่อ | ในการจำลอง (Wokwi)
HLK-LD2410 | ตรวจคนทั้งขณะเคลื่อนไหวและนั่งนิ่ง | 5 V, เฉลี่ย 80 mA (เผื่อ 200 mA) | UART2 ขา 16 และ 17, OUT ขา 13 | Slide switch
OLED SSD1306 | แสดงผลและเมนู | 3.3 V, ประมาณ 30 mA | I²C (0x3C) ขา 21 และ 22 | SSD1306
Buzzer PS1240 | เสียงเตือน | 3.3 V, ประมาณ 5 mA | GPIO 26 (PWM 4 kHz) | Buzzer
ปุ่ม B3F-1000 | รับทราบ เลื่อนเตือน และตั้งค่า | 3.3 V ผ่าน pull-up | GPIO 27 (interrupt) | Pushbutton

### 4.2.3 อุปกรณ์โมดูลแสง

โมดูลแสงมีหน้าที่รักษาความสว่างบนโต๊ะให้อยู่ที่ 500 lux และปรับสีแสงตามช่วงเวลาของวัน จึงประกอบด้วยอุปกรณ์ 3 ส่วน ได้แก่ เซนเซอร์วัดแสงที่บอกว่าตอนนี้โต๊ะสว่างเท่าไร แหล่งแสง LED ที่ปรับได้ทั้งความสว่างและสี และวงจรขับที่ทำให้ไมโครคอนโทรลเลอร์สั่งแหล่งแสง 12 V ได้

1) เซนเซอร์วัดแสง BH1750FVI

เลือก BH1750 เพราะให้ค่าออกมาเป็นหน่วย lux โดยตรง ระบบนำไปเทียบกับค่าเป้าหมาย 500 lux ได้ทันทีโดยไม่ต้องแปลงสูตร และการตอบสนองต่อแสงใกล้เคียงสายตาคน (ไวที่สุดที่ความยาวคลื่น 560 nm) ค่าที่วัดได้จึงตรงกับความสว่างที่ผู้ใช้รู้สึก เซนเซอร์มีฟังก์ชันตัดการกะพริบของไฟบ้าน 50/60 Hz ทำให้ค่าไม่แกว่งตามไฟเพดาน และวัดได้ 1-65,535 lux ซึ่งครอบคลุมช่วงที่โต๊ะทำงานในอาคารต้องการ (0-2,000 lux) จึงไม่ต้องสลับช่วงวัดระหว่างใช้งาน [28]

เซนเซอร์ต่อกับ ESP32 ทาง I²C ใช้เพียง 2 ขา และใช้บัสร่วมกับจอ OLED ของโมดูลตรวจคนได้ ESP32 มีวงจร I²C อยู่ในตัวแล้ว จึงช่วยประหยัดขาของไมโครคอนโทรลเลอร์และลดงานซอฟต์แวร์ เมื่อเทียบกับตัวต้านทานไวแสง (LDR) ที่ราคาถูกกว่า LDR ให้ค่าไม่เป็นเส้นตรง ต้องปรับเทียบเอง และค่าเปลี่ยนตามอุณหภูมิ ส่วน VEML7700 วัดได้กว้างถึงราว 120,000 lux ซึ่งเกินความต้องการของงานในอาคาร

2) แหล่งแสง: แถบ LED 12 V แบบ 2 สี (CCT)

ระบบต้องปรับสีแสงตามเวลา คือใช้แสงขาวอมฟ้าในเวลากลางวันเพื่อให้ตื่นตัว [8] และใช้แสงขาวอุ่นในช่วงค่ำเพื่อลดผลต่อการนอน [9] จึงเลือกแถบ LED ที่มีหลอดขาวอุ่น (ประมาณ 2,700-3,000 K) และขาวเย็น (ประมาณ 6,000-6,500 K) อยู่ในแถบเดียวกัน คุมแยกกันได้ 2 ช่อง เมื่อผสม 2 ช่องด้วยสัดส่วนต่างกันจะได้สีขาวทุกระดับในช่วงนี้ และกำหนดให้มีค่าความถูกต้องของสี (CRI) ไม่ต่ำกว่า 80 ตามมาตรฐานแสงสว่างในที่ทำงาน [7]

ไม่เลือกแถบ LED แบบ RGB เพราะสร้างสีขาวจากแสง 3 สี ทำให้ค่า CRI ต่ำและของบนโต๊ะดูสีเพี้ยน และไม่เลือกหลอด 220 V แบบหรี่ได้ เพราะต้องใช้วงจรหรี่ไฟกระแสสลับที่อันตรายและซับซ้อนกว่า แถบ LED ใช้ไฟ 12 V จาก adapter ตัวเดียวกับระบบ เมื่อเปิดเต็มใช้กระแสประมาณ 0.5-0.7 A (ค่าประมาณการ)

3) วงจรขับ: MOSFET AO3400A จำนวน 2 ตัว

ขา GPIO ของ ESP32 ให้แรงดันเพียง 3.3 V และจ่ายกระแสได้น้อย จึงขับแถบ LED 12 V โดยตรงไม่ได้ ต้องมีวงจรขับคั่นกลาง ระบบใช้ MOSFET ชนิด N เป็นสวิตช์ฝั่งลบของ LED แต่ละช่อง และใช้ PWM ปรับความสว่างโดยเปลี่ยนสัดส่วนเวลาที่ไฟติดในแต่ละคาบ

เลือก AO3400A เพราะ datasheet รับรองว่าเปิดได้เต็มที่ตั้งแต่แรงดัน Gate 2.5 V (ความต้านทานขณะเปิดไม่เกิน 48 mΩ) ซึ่งต่ำกว่า 3.3 V ของ ESP32 [22] ส่วน IRLZ44N ที่นิยมใช้กับ Arduino รับรองค่าที่ 4-5 V ขึ้นไป [29] อาจเปิดไม่สุดเมื่อใช้ 3.3 V ที่กระแส 1 A ตัว AO3400A เสียพลังงานเป็นความร้อนเพียงประมาณ 0.05 W จึงไม่ต้องติดแผ่นระบายความร้อน วงจรใส่ตัวต้านทาน 100 Ω ที่ขา Gate เพื่อจำกัดกระแสกระชาก และตัวต้านทาน 10 kΩ ดึงขา Gate ลงกราวด์ เพื่อให้ไฟดับแน่นอนระหว่างที่ ESP32 กำลังเริ่มทำงาน

ช่องขาวเย็นต่อกับขา GPIO 18 และช่องขาวอุ่นต่อกับขา GPIO 19 ทั้งสองขาใช้วงจร PWM ในตัว ESP32 ชุดเดียวกันที่ความถี่ 5 kHz ความละเอียด 13 บิต ส่วนเซนเซอร์แสงใช้ขา I²C 21 และ 22 ร่วมกับจอ OLED นอกจากนี้ทีมเลือกใช้ AO3400A กับพัดลมของโมดูลอากาศด้วย ทั้งระบบจึงใช้ MOSFET รุ่นเดียวกัน ช่วยลดจำนวนชนิดของชิ้นส่วนที่ต้องจัดหา

ตารางที่ 4.5 สรุปอุปกรณ์โมดูลแสง

อุปกรณ์ | หน้าที่ | ไฟเลี้ยง | การเชื่อมต่อ | ในการจำลอง (Wokwi)
BH1750FVI | วัดความสว่างบนโต๊ะ (lux) | 3.3 V, สูงสุด 0.19 mA | I²C (0x23) ขา 21 และ 22 ร่วมกับ OLED | Photoresistor sensor ที่ขา GPIO 34
แถบ LED 12 V แบบ 2 สี (CRI ไม่ต่ำกว่า 80) | แหล่งแสง ปรับความสว่างและสี | 12 V, ประมาณ 0.5-0.7 A | ผ่าน MOSFET | LED สีขาวและสีเหลือง
AO3400A จำนวน 2 ตัว | สวิตช์ PWM ช่องขาวอุ่นและขาวเย็น | - | GPIO 18 (ขาวเย็น) และ GPIO 19 (ขาวอุ่น) PWM 5 kHz | ไม่ใช้

ข้อจำกัดของการจำลอง: Wokwi ไม่มีแบบจำลอง BH1750 จึงใช้ photoresistor ต่อเข้าขา GPIO 34 แทน ขานี้อยู่ในวงจรแปลงสัญญาณแอนะล็อกชุดที่ 1 (ADC1) เพราะชุดที่ 2 ใช้ไม่ได้ขณะเปิด Wi-Fi และเซนเซอร์ในโปรแกรมจำลองมองไม่เห็นแสงจาก LED ที่จำลองอยู่ การทดสอบวงควบคุมแบบป้อนกลับจึงต้องคำนวณแสงจาก LED เพิ่มในโค้ดจำลอง [30]

## 4.3 Power Requirements (ความต้องการด้านพลังงาน)

ทั้งสองโหนดใช้ adapter 12 V ตัวเดียว เพราะแถบ LED และพัดลมใช้ 12 V อยู่แล้ว ไฟ 12 V ผ่าน polyfuse แล้วแยกเป็น 2 ทาง ทางแรกไปที่โหลด 12 V ผ่าน MOSFET อีกทางเข้าโมดูลลดแรงดัน LM2596-5.0 เพื่อทำราง 5 V ให้ ESP32 และ LD2410 จากนั้นตัวควบคุมแรงดัน AMS1117 บนบอร์ด ESP32 ทำราง 3.3 V ให้อุปกรณ์ที่เหลือ เลือก LM2596 ซึ่งเป็นตัวลดแรงดันแบบสวิตชิ่งที่จ่ายได้ 3 A [31] เพราะถ้าใช้ตัวควบคุมแบบเชิงเส้นลดจาก 12 V เป็น 5 V ที่ 0.5 A จะเสียพลังงานเป็นความร้อนถึง (12 - 5) × 0.5 = 3.5 W ส่วนบอร์ด DevKitC มี AMS1117 จ่ายได้ 1 A อยู่แล้ว [32] มีตัวเก็บประจุ 470 µF ที่ทางเข้า 12 V และ 100 µF ที่ราง 5 V เพื่อลดแรงดันตกตอนพัดลมเริ่มหมุนหรือตอน Wi-Fi ส่งข้อมูล

ตารางที่ 4.6 การใช้กระแสของโหนดโต๊ะ

อุปกรณ์ | ราง | ปกติ (mA) | สูงสุด (mA)
ESP32-WROOM-32E | 3.3 V | 100 | 240 (ส่ง Wi-Fi)
OLED SSD1306 | 3.3 V | 30 | 30 (ค่าประมาณ)
BH1750 | 3.3 V | 0.12 | 0.19
Buzzer และปุ่ม | 3.3 V | 0 | 5.3
รวมราง 3.3 V (AMS1117 จ่ายได้ 1,000 mA) | 3.3 V | 130 | 276
LD2410 | 5 V | 80 | 200
รวมราง 5 V (LM2596 จ่ายได้ 3,000 mA) | 5 V | 210 | 476
ราง 5 V คิดเป็นกระแสที่ 12 V (ประสิทธิภาพ 80%) | 12 V | 109 | 248
แถบ LED 2 สี (ผลรวม 2 ช่องไม่เกิน 1 ช่องเต็ม) | 12 V | 500-700 | 1,000
รวมที่ adapter | 12 V | ประมาณ 0.81 A | ประมาณ 1.25 A

ตารางที่ 4.7 การใช้กระแสของโหนดห้อง

อุปกรณ์ | ราง | ปกติ (mA) | สูงสุด (mA)
ESP32-WROOM-32E | 3.3 V | 100 | 240
SCD41 (วัดทุก 5 วินาที) | 3.3 V | 15-18 | 205
ไฟสถานะ RGB | 3.3 V | 10 | 30
รวมราง 3.3 V | 3.3 V | ประมาณ 128 | 475
ราง 5 V คิดเป็นกระแสที่ 12 V | 12 V | 67 | 247
พัดลมดูดอากาศ | 12 V | 250 | 400 (ตอนเริ่มหมุน)
รวมที่ adapter | 12 V | ประมาณ 0.32 A | ประมาณ 0.65 A

โหนดโต๊ะเลือก adapter 12 V 2 A ซึ่งมีส่วนเผื่อประมาณ 60% จากค่าสูงสุด สำหรับความคลาดเคลื่อนของค่าประมาณและการเสื่อมของ adapter และใช้ polyfuse 2.5 A ส่วนโหนดห้องเลือก adapter 12 V 1.5 A ซึ่งมากกว่าค่าสูงสุด 2 เท่า รองรับพัดลมที่แรงขึ้นได้ถ้าห้องใหญ่กว่าที่ออกแบบ และใช้ polyfuse 1.1 A polyfuse ตัดไฟเมื่อเกิดลัดวงจร เช่น สายแถบ LED แตะกัน

เมื่อไม่มีคนครบ 5 นาที โหนดโต๊ะปิดแถบ LED ลดรอบส่งข้อมูลจากทุก 5 วินาทีเป็นทุก 15 วินาที และให้วิทยุ Wi-Fi อยู่ในโหมด modem-sleep ระหว่างรอบ กำลังไฟของโหนดโต๊ะลดจากประมาณ 9.7 W ตอนไฟเปิดเต็ม เหลือประมาณ 1.1 W หรือลดลงประมาณ 89% แสดงว่าแถบ LED เป็นตัวใช้พลังงานหลัก และการปิดไฟเมื่อไม่มีคนมีผลด้านพลังงานมากที่สุด

# 5. Software Design (การออกแบบซอฟต์แวร์)

## 5.1 Flowcharts or UML Diagrams (Flowchart หรือแผนภาพ UML)

ทุกโมดูลออกแบบเป็นเครื่องสถานะจำกัด (FSM) แบบมีเวลากำกับ เพราะพฤติกรรมของแต่ละโมดูลขึ้นกับทั้งเหตุการณ์ (มีคนหรือไม่ ค่าเกินเกณฑ์หรือไม่) และเวลาที่ผ่านไป (นั่งครบ 20 นาที ไม่มีคนครบ 5 นาที) การเขียนเป็นสถานะทำให้เห็นครบว่าระบบอยู่ในสภาพใดได้บ้าง และเปลี่ยนสภาพเมื่อใด ทุก FSM มีสถานะสำหรับเซนเซอร์เสียแยกไว้ เพื่อให้ระบบตอบสนองอย่างปลอดภัยเมื่ออ่านค่าไม่ได้

### 5.1.1 แผนภาพสถานะของโมดูลตรวจคนและเตือนพัก

โมดูลตรวจคนเริ่มนับเวลานั่งเมื่อพบคนต่อเนื่อง 1 วินาที ถ้าผู้ใช้ลุกไปไม่ถึง 3 นาที ระบบนับเวลาเดิมต่อ เพราะการลุกสั้นๆ เช่น หยิบของ ยังไม่ถือว่าได้พักจริง แต่ถ้าไม่พบคนครบ 3 นาทีจึงเริ่มนับใหม่ ตามช่วงลุกเดิน 3 นาทีที่งานวิจัยใช้ [3] และถ้าไม่พบคนรวมครบ 5 นาที จะตั้ง away_timeout ให้โมดูลแสงหรี่และปิดไฟ พร้อมคืนค่าความสว่างและโหมดทำงานดึกที่ผู้ใช้ตั้งไว้เป็นค่าเริ่มต้น เมื่อเรดาร์ไม่ส่งข้อมูลที่ถูกต้องเกิน 500 ms ระบบเข้าสถานะเซนเซอร์เสีย และถือว่ามีคนไว้ก่อน เพื่อไม่ให้ไฟดับใส่ผู้ใช้

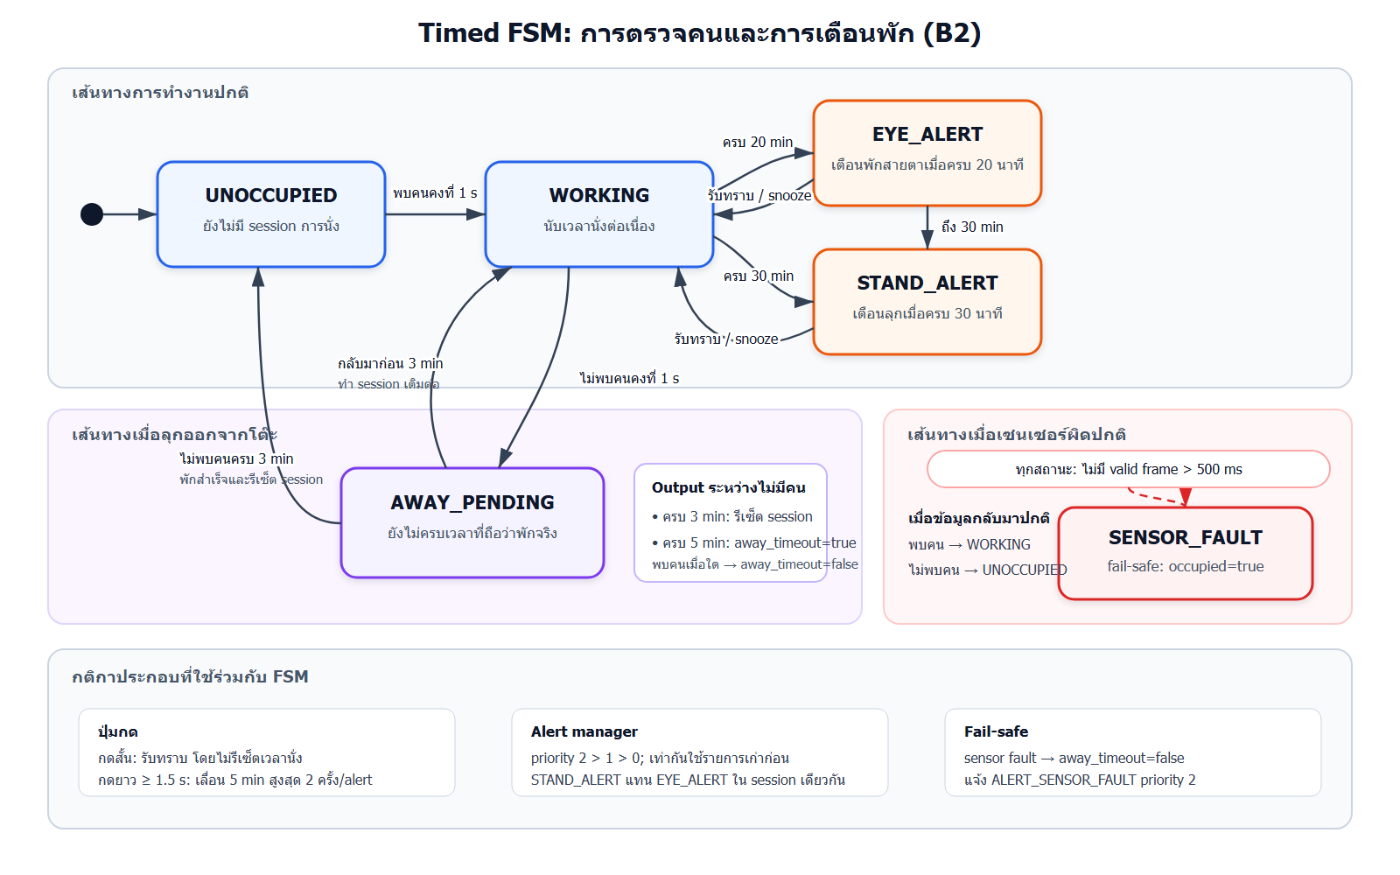
[picture p7: figure]
figure

ภาพที่ 5.1 แผนภาพสถานะของโมดูลตรวจคนและเตือนพัก

ตารางที่ 5.1 สถานะของโมดูลตรวจคนและเตือนพัก

สถานะ | ความหมาย | การทำงานหลัก
UNOCCUPIED | ไม่พบคน ยังไม่เริ่มนับเวลานั่ง | พบคนต่อเนื่อง 1 วินาทีจึงเริ่มนับ ไม่พบคนครบ 5 นาทีตั้ง away_timeout
WORKING | พบคน กำลังนับเวลานั่งต่อเนื่อง | ครบ 20 นาทีเตือนพักสายตา ครบ 30 นาทีเตือนลุก
EYE_ALERT | กำลังเตือนพักสายตา | กดสั้นรับทราบ กดยาวเลื่อน 5 นาทีได้ไม่เกิน 2 ครั้ง
STAND_ALERT | กำลังเตือนให้ลุกเดิน 3 นาที | เหมือน EYE_ALERT และมีลำดับเหนือการเตือนพักสายตา
AWAY_PENDING | ไม่พบคนชั่วคราว ยังไม่ครบ 3 นาที | กลับมาก่อน 3 นาทีนับต่อ ครบ 3 นาทีเริ่มนับใหม่
SENSOR_FAULT | ไม่ได้ข้อมูลจากเรดาร์เกิน 500 ms | ถือว่ามีคน ไม่ปิดไฟ และเตือนเซนเซอร์เสีย

มีกติกาเพิ่มเติม 3 ข้อที่ได้จากการทดสอบ ข้อแรก ถ้าการเตือนลุกถูกเลื่อนไว้และยังไม่ถึงเวลาเตือนซ้ำ แต่ถึงกำหนดเตือนพักสายตาพอดี ระบบจะเลื่อนการเตือนพักสายตาไปรอบถัดไปแทน เพื่อไม่ให้การเตือนลุกที่รออยู่หายไป ข้อที่สอง เมื่อเรดาร์กลับมาจากสถานะเสีย ระบบเริ่มนับเวลานั่งใหม่ เพราะเวลาในช่วงที่ไม่มีข้อมูลเชื่อถือไม่ได้ ข้อที่สาม การเตือนพัก การเตือนลุก และการเตือนระดับ 2 แสดงเต็มจอจนกว่าจะถูกยกเลิก ส่วนการเตือนอากาศ ลิงก์ขาด และเซนเซอร์แสงแสดงเต็มจอ 10 วินาทีแล้วย่อเป็นแถบด้านล่าง เพื่อให้ผู้ใช้ยังเห็นเวลานั่ง ปุ่มกดใช้การกรองสัญญาณเด้งแบบรอให้สัญญาณนิ่ง 30 ms ก่อนอ่านระดับ

### 5.1.2 แผนภาพสถานะของโมดูลอากาศ

โมดูลอากาศทำงานทุก 5 วินาที แบ่งระดับอากาศตาม CO₂ เป็น 3 ระดับ และมีสถานะห้องว่างกับสถานะเซนเซอร์เสียแยกออกมา หัวใจของการออกแบบคือช่วง hysteresis ถ้าใช้เกณฑ์เปิดปิดค่าเดียวที่ 1,000 ppm เมื่อ CO₂ แกว่งอยู่ใกล้ค่านั้น พัดลมจะเปิดปิดสลับกันถี่ ระบบจึงเปิดพัดลมเต็มกำลังเมื่อ CO₂ ถึง 1,000 ppm ลดเหลือ 60% เมื่อต่ำกว่า 950 ppm และปิดเมื่อต่ำกว่า 800 ppm เท่านั้น ส่วนขาขึ้นจาก 800 ถึง 1,000 ppm พัดลมยังไม่เปิด เมื่อเซนเซอร์อ่านค่าไม่ได้ 3 รอบติดกันหรือค่าอยู่นอกช่วง 300 ถึง 5,000 ppm ระบบเปิดพัดลมค้างไว้ 80% เพราะการระบายอากาศเกินเล็กน้อยปลอดภัยกว่าปล่อยให้ CO₂ สะสมโดยไม่รู้ตัว

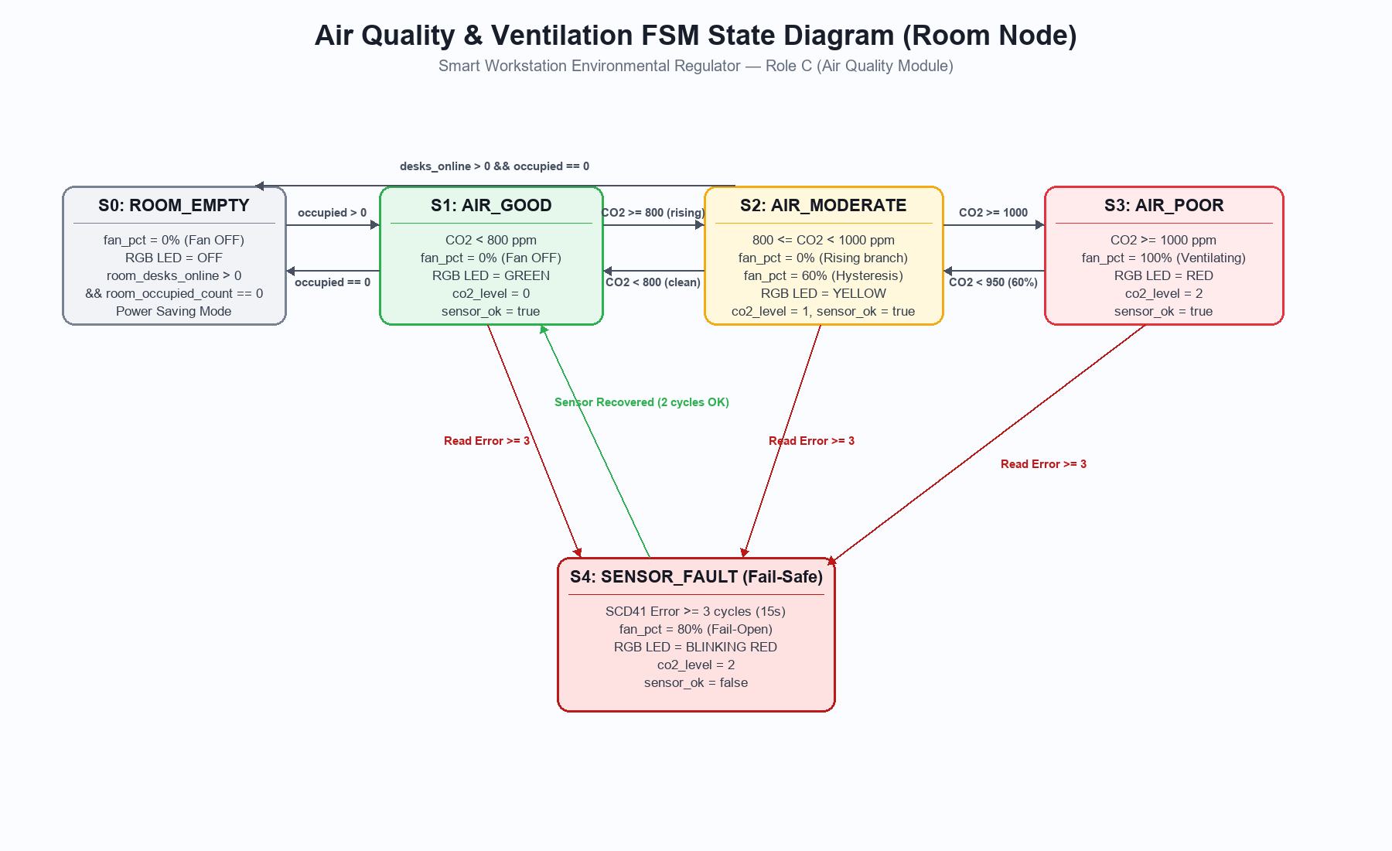
[picture p8: figure]
figure

ภาพที่ 5.2 แผนภาพสถานะของโมดูลอากาศ

ตารางที่ 5.2 สถานะของโมดูลอากาศ

สถานะ | เงื่อนไข | พัดลม | ไฟสถานะ
S0 ROOM_EMPTY | มีโต๊ะติดต่อได้และทุกโต๊ะไม่มีคน | 0% | ดับ
S1 AIR_GOOD | CO₂ ต่ำกว่า 800 ppm | 0% | เขียว
S2 AIR_MODERATE | CO₂ 800 ถึง 999 ppm | 0% (ขาขึ้น) หรือ 60% (ขาลงจาก S3) | เหลือง
S3 AIR_POOR | CO₂ ตั้งแต่ 1,000 ppm | 100% | แดง
S4 SENSOR_FAULT | อ่านค่าไม่ได้ 3 รอบติดกัน หรือค่าอยู่นอกช่วง | 80% | กะพริบแดง

### 5.1.3 แผนภาพสถานะของโมดูลแสง

โมดูลแสงทำงานเป็นงานย่อย light_control_task ทุก 200 ms และแบ่ง logic เป็น 2 ส่วนที่ทำงานพร้อมกัน ตามแนวคิด AND super-state ของ statechart ที่ให้หลายกลุ่มสถานะทำงานคู่ขนานกันได้ ส่วนแรกตัดสินว่าไฟควรเปิด หรี่ หรือปิด และคุมความสว่างรวม (L) ส่วนที่สองตัดสินสัดส่วนแสงขาวเย็น (r) ตามช่วงเวลาของวัน จากนั้นนำสองค่ามารวมกันเป็นค่า duty ของ PWM ทั้งสองช่อง คือช่องขาวเย็นเท่ากับ L × r และช่องขาวอุ่นเท่ากับ L × (1 - r) การแยกแบบนี้ทำให้การเปลี่ยนสีไม่กระทบความสว่าง เพราะวงควบคุมจะปรับ L ให้แสงบนโต๊ะกลับมาที่ค่าเป้าหมายเองเสมอ

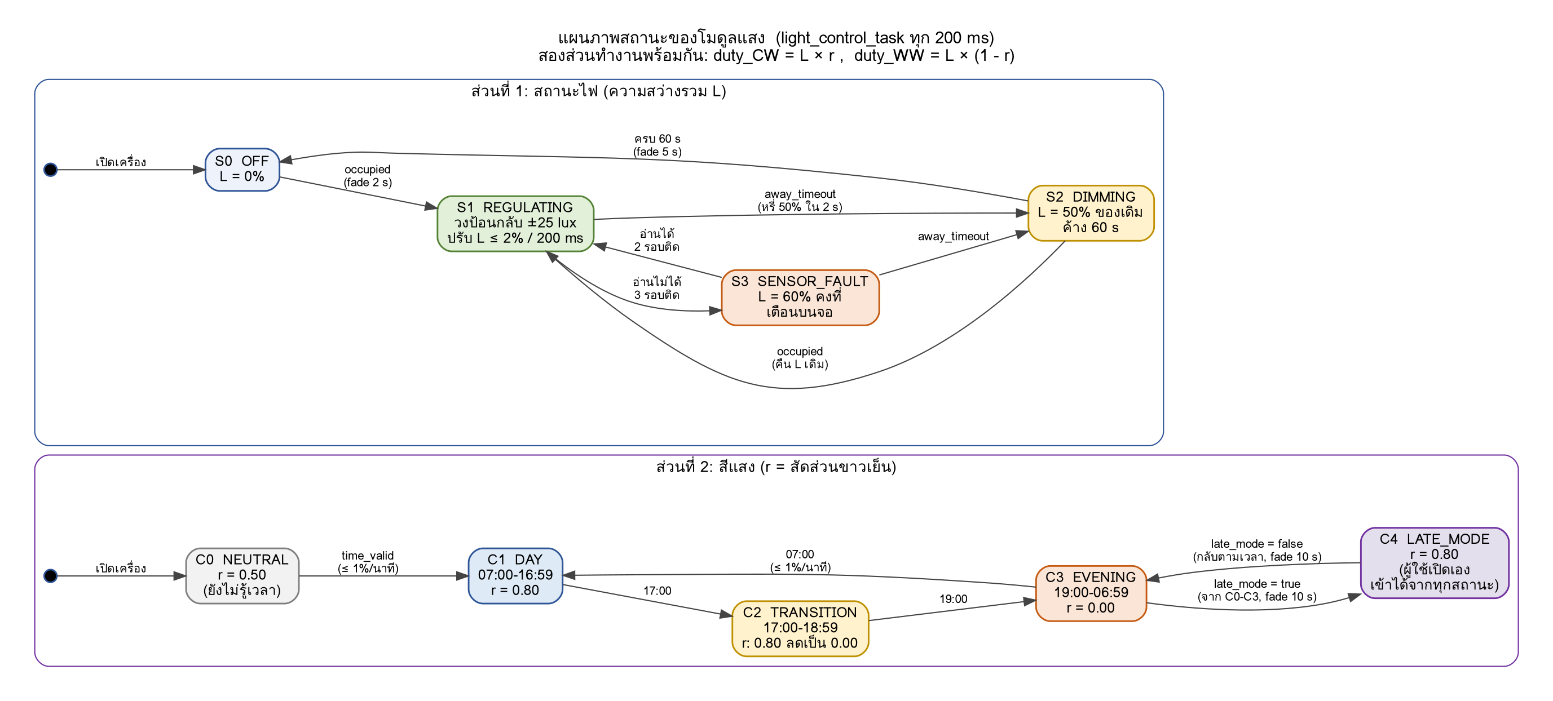
[picture p9: figure]
figure

ภาพที่ 5.3 แผนภาพสถานะของโมดูลแสง (บน: สถานะไฟ ล่าง: สีแสง)

ตารางที่ 5.3 สถานะไฟของโมดูลแสง

สถานะ | ความหมาย | การทำงาน
S0 OFF | ไม่มีคน | ปิดไฟ
S1 REGULATING | มีคนนั่ง เซนเซอร์ปกติ | อ่านแสงทุก 200 ms ถ้าต่างจากเป้าหมายเกิน 25 lux ให้ปรับ L ทีละไม่เกิน 2%
S2 DIMMING | ไม่มีคนครบ 5 นาที | หรี่เหลือ 50% ค้าง 60 วินาที แล้วค่อยๆ ปิด ถ้าคนกลับมาก่อน ไฟกลับไปสว่างเท่าเดิม
S3 SENSOR_FAULT | อ่านเซนเซอร์แสงไม่ได้ 3 รอบติดกัน | ค้างไฟที่ 60% และแจ้งเตือนบนจอ จนกว่าจะอ่านได้ปกติ 2 รอบติดกัน

ตารางที่ 5.4 สถานะสีแสงของโมดูลแสง

สถานะ | เวลา / เงื่อนไข | สัดส่วนแสงขาวเย็น (r)
C0 NEUTRAL | ยังไม่ได้เวลาจากเครือข่าย | 0.50
C1 DAY | 07:00-16:59 | 0.80
C2 TRANSITION | 17:00-18:59 | ลดลงจาก 0.80 เป็น 0.00 ภายใน 120 นาที
C3 EVENING | 19:00-06:59 | 0.00
C4 LATE_MODE | ผู้ใช้เปิดโหมดทำงานดึก | 0.80

ทุกการเปลี่ยนแปลงของแสงเป็นแบบค่อยเป็นค่อยไป การเปลี่ยนสีอัตโนมัติไม่เกิน 1% ต่อนาที การเปิดไฟใช้เวลา 2 วินาที การปิดไฟใช้เวลา 5 วินาที และการเปลี่ยนตามคำสั่งผู้ใช้ใช้เวลา 10 วินาที โดยใช้ฟังก์ชัน fade ของวงจร PWM ในตัว ESP32 ซึ่งไล่ค่า duty เองโดยไม่ใช้เวลาประมวลผลของ CPU [33]

## 5.2 Pseudocode or Code Snippets (Pseudocode หรือตัวอย่างโค้ด)

Pseudocode ในหัวข้อนี้เป็นฉบับย่อที่แสดงตรรกะหลักของแต่ละโมดูล โค้ดจริงที่รันบนโปรแกรมจำลองอยู่ในคลังโค้ด (หัวข้อ 10.4)

### 5.2.1 Pseudocode ของโมดูลตรวจคนและเตือนพัก

TASK presence_task (period = 100 ms)

IF no valid LD2410 frame for more than 500 ms THEN

occupied = TRUE; away_timeout = FALSE // fail-safe

send_alert(SENSOR_FAULT, priority 2); state = SENSOR_FAULT

ELSE

update stable_presence when the same result holds for 1 s

IF just recovered from SENSOR_FAULT THEN reset_session()

END IF

TASK break_timer_task (period = 1000 ms)

SWITCH state

CASE UNOCCUPIED:

IF stable_presence THEN start_session(); state = WORKING

CASE WORKING:

sit_time = sit_time + 1 s

IF NOT stable_presence THEN state = AWAY_PENDING

ELSE IF sit_time >= next_stand THEN

send_alert(STAND_BREAK, priority 1); state = STAND_ALERT

ELSE IF sit_time >= next_eye AND snoozed STAND pending THEN

next_eye = next_eye + 20 min // STAND covers EYE

ELSE IF sit_time >= next_eye THEN

send_alert(EYE_BREAK, priority 1); state = EYE_ALERT

END IF

CASE EYE_ALERT, STAND_ALERT:

short press: acknowledge, back to WORKING (sit_time kept)

long press >= 1.5 s AND snooze_count < 2: snooze 5 min

CASE AWAY_PENDING:

IF stable_presence THEN state = WORKING // same session

ELSE IF away_time >= 3 min THEN reset_session(); state = UNOCCUPIED

END SWITCH

IF away_time >= 5 min AND NOT away_timeout THEN

away_timeout = TRUE

user_lux_target = 500; late_mode = FALSE // FR-11

END IF

### 5.2.2 Pseudocode ของโมดูลอากาศ

TASK air_sensor_task (period = 5000 ms)

IF take(i2c_lock, 50 ms) THEN ok = scd41_read(co2, temp, rh); give(i2c_lock)

ELSE ok = FALSE

IF ok AND 300 <= co2 <= 5000 THEN good = good + 1; bad = 0

ELSE bad = bad + 1; good = 0

update_room_counts() // desks_online, occupied_count

empty = (desks_online > 0) AND (occupied_count == 0)

IF bad >= 3 THEN go(S4_SENSOR_FAULT, fan = 80)

ELSE IF state == S4_SENSOR_FAULT AND good < 2 THEN stay

ELSE IF empty THEN go(S0_ROOM_EMPTY, fan = 0)

ELSE IF co2 >= 1000 THEN go(S3_AIR_POOR, fan = 100)

ELSE IF co2 < 800 THEN go(S1_AIR_GOOD, fan = 0)

ELSE IF state == S3_AIR_POOR AND co2 < 950 THEN go(S2_AIR_MODERATE, fan = 60)

ELSE IF state != S3_AIR_POOR AND state != S2_AIR_MODERATE THEN

go(S2_AIR_MODERATE, fan = 0) // rising edge: fan stays off

END IF

temp_flag = 1 IF temp < 20.0 C, 2 IF temp > 26.0 C, ELSE 0

write air_status (co2, temp, rh, co2_level, temp_flag, sensor_ok, fan_pct)

notify room_communication_task

wait_until_next_period()

### 5.2.3 Pseudocode ของโมดูลแสง

TASK light_control_task (period = 200 ms)

LOOP

snap = read_snapshot(occupied, away_timeout, time_of_day,

time_valid, user_lux_target, late_mode)

IF take(i2c_lock, 50 ms) THEN

ok = bh1750_read_lux(lux)

give(i2c_lock)

ELSE

ok = FALSE

END IF

update_error_counters(ok)

target = clamp(snap.user_lux_target, 500, 1000) // ไม่มีค่าให้ใช้ 500

SWITCH light_state

CASE S0_OFF:

IF snap.occupied THEN fade_on(2 s); light_state = S1_REGULATING

CASE S1_REGULATING:

IF snap.away_timeout THEN enter_dimming()

ELSE IF err_count >= 3 THEN

set_L(60%); send_alert(SENSOR_FAULT, SHOW)

light_state = S3_SENSOR_FAULT

ELSE IF ok AND abs(target - lux) > 25 THEN

L = L + clamp(0.02 * (target - lux), -2, 2)

END IF

CASE S2_DIMMING:

IF snap.occupied THEN restore_L(2 s); light_state = S1_REGULATING

ELSE IF dim_time >= 60 s THEN fade_off(5 s); light_state = S0_OFF

CASE S3_SENSOR_FAULT:

IF snap.away_timeout THEN enter_dimming()

ELSE IF ok_count >= 2 THEN

send_alert(SENSOR_FAULT, CLEAR); light_state = S1_REGULATING

END IF

END SWITCH

IF snap.late_mode THEN r_target = 0.80

ELSE IF snap.time_valid THEN r_target = schedule(snap.time_of_day)

ELSE r_target = 0.50

r = move_toward(r, r_target) // อัตโนมัติไม่เกิน 1% ต่อนาที

ledc_fade(CH_CW, L * r)

ledc_fade(CH_WW, L * (1 - r))

wait_until_next_period()

END LOOP

เมื่อไม่มีคนครบ 5 นาที โมดูลตรวจคนจะคืนค่าที่ผู้ใช้ปรับเองทั้งหมด (ความสว่างเป้าหมายและโหมดทำงานดึก) กลับเป็นค่าเริ่มต้น เพื่อให้ผู้ใช้คนถัดไปเริ่มจากค่ามาตรฐานเสมอ โมดูลแสงอ่านค่าเหล่านี้อย่างเดียวและไม่เขียนกลับ ข้อมูลแต่ละตัวจึงมีเจ้าของเพียงโมดูลเดียว ส่วนค่าความสว่างที่อยู่นอกช่วง 500-1,000 lux โมดูลแสงจะปัดเข้าช่วงอีกชั้นหนึ่ง เพื่อป้องกันความผิดพลาดจากการป้อนค่า

## 5.3 RTOS Considerations (ข้อพิจารณาด้าน RTOS)

ระบบมีงานหลายคาบเวลา ตั้งแต่ตรวจคนทุก 100 ms ไปจนถึงซิงก์เวลาทุก 1 ชั่วโมง และมีงานที่ต้องรอเครือข่าย ถ้าเขียนเป็นลูปเดียว งานที่รอ Wi-Fi จะหน่วงงานตรวจคนและคุมแสงไปด้วย จึงใช้ FreeRTOS แยกแต่ละงานเป็น task ตามคาบและความสำคัญ งานเครือข่ายรอได้โดยไม่หยุดงานอื่น การเตือนส่งผ่าน queue และสาย I²C ป้องกันด้วย mutex ที่มี priority inheritance งาน Wi-Fi และ TCP/IP ของ ESP32 ทำงานบนแกน 0 ร่วมกับงานสื่อสารของระบบ ส่วนงานควบคุมของทุกโมดูลอยู่บนแกน 1 [34]

ลำดับความสำคัญของงานกำหนดตาม Rate Monotonic Scheduling คืองานที่มีคาบสั้นกว่าได้ความสำคัญสูงกว่า และตรวจว่าทำทันด้วยเงื่อนไขว่าผลรวมของเวลาทำงานต่อคาบ (U) ต้องไม่เกิน n(2^(1/n) - 1) [35] แต่ละแกนจัดเวลาแยกกัน จึงตรวจเงื่อนไขนี้ทีละแกน ตารางที่ 5.5 แสดงเวลาทำงานที่วัดจริงจากโค้ดบนโปรแกรมจำลอง

ตารางที่ 5.5 งานย่อยและเวลาทำงานที่วัดได้

โหนด | แกน | งานย่อย (โมดูล) | คาบ (ms) | เวลาสูงสุด (µs) | เวลาเฉลี่ย (µs) | U
โต๊ะ | 1 | presence_task (ตรวจคน) | 100 | 948 | 37 | 0.009
โต๊ะ | 1 | button_event_task (ตรวจคน) | 100 | 68 | 22 | 0.001
โต๊ะ | 1 | light_control_task (แสง) | 200 | 31,797 | 1,138 | 0.159
โต๊ะ | 1 | display_alert_task (ตรวจคน) | 500 | 53,110 | 42,821 | 0.106
โต๊ะ | 1 | break_timer_task (ตรวจคน) | 1,000 | 14,394 | 68 | 0.014
โต๊ะ | 1 | รวมแกน 1 (ขอบเขต RMS สำหรับ 5 งาน = 0.743) | | | | 0.290
โต๊ะ | 0 | desk_communication_task (รวมระบบ) | 1,000 | 5,207 | 4,111 | 0.005
ห้อง | 1 | air_sensor_task (อากาศ) | 5,000 | 218,015 | 26,639 | 0.044
ห้อง | 0 | room_communication_task (รวมระบบ) | 5,000 | 8,216 | 4,676 | 0.002

ค่าของโหนดโต๊ะมาจากการรันต่อเนื่อง 22.8 นาทีที่สร้างเหตุการณ์ครบทุกแบบ ส่วนโหนดห้องใช้ค่าที่สูงกว่าระหว่างการทดสอบอัตโนมัติกับการรันต่อเนื่อง เวลาสูงสุด 218 ms ของงานอ่านอากาศเกิดจากการอ่านเซนเซอร์ครั้งแรกหลังเปิดเครื่องที่โปรแกรมจำลองรอนาน ซึ่งยังต่ำกว่าคาบ 5 วินาทีมาก

งานควบคุมบนแกน 1 ของโหนดโต๊ะมีผลรวม 0.290 ต่ำกว่าขอบเขต 0.743 ของ 5 งานมาก จึงผ่านเงื่อนไขของ Rate Monotonic Scheduling ส่วนแกน 0 มีงาน Wi-Fi และ TCP/IP ของระบบที่ไม่ได้วัดรวมอยู่ด้วย จึงไม่นำค่า 0.005 ของงานสื่อสารไปเทียบกับขอบเขตเพียงลำพัง แต่ตลอดการรันต่อเนื่องไม่มีงานใดบนทั้งสองแกนพลาดเส้นตาย เวลาสูงสุดของงานคุมแสง (31.8 ms) สูงกว่าที่ประมาณไว้ตอนออกแบบ (2 ms) เพราะเป็นช่วงที่ต้องรอ i2c_lock ระหว่างที่จอ OLED วาดทั้งหน้าจอ ซึ่งยังอยู่ในกรอบรอได้ไม่เกิน 50 ms และต่ำกว่าคาบ 200 ms ของงาน

## 5.4 Communication Protocols (โปรโตคอลการสื่อสาร)

1) การเลือกสื่อกลาง

ระบบใช้ Wi-Fi 2.4 GHz เพราะมีอยู่ใน ESP32 ใช้ router ของห้องได้ทันที และต้องต่ออินเทอร์เน็ตอยู่แล้วเพื่อดึงเวลาจริง ข้อเสียของ Wi-Fi คือใช้พลังงานสูงกว่า แต่ทั้งสองโหนดใช้ไฟจาก adapter ไม่ได้ใช้แบตเตอรี่ และวิทยุพักระหว่างรอบส่งได้ จึงยอมรับได้

ตารางที่ 5.6 เปรียบเทียบสื่อกลางไร้สาย

เกณฑ์ | Wi-Fi (เลือก) | Bluetooth Low Energy | Zigbee
มีใน ESP32 | มีในตัว | มีในตัว | ไม่มี ต้องเพิ่มโมดูลและตัวประสาน
ใช้โครงสร้างที่ห้องมีอยู่ | ใช้ router ของห้อง | ต้องมีตัวกลางรับจากหลายโต๊ะ | ต้องมี coordinator แยก
ออกอินเทอร์เน็ต (เวลาจริง, cloud) | ได้โดยตรง | ต้องมี gateway | ต้องมี gateway
พลังงาน | สูงที่สุด (ส่งสูงสุด 240 mA) | ต่ำ | ต่ำ
จำลองใน Wokwi | ได้ | ไม่ได้ | ไม่ได้

2) โปรโตคอล MQTT

การรับส่งข้อความใช้ MQTT 3.1.1 แบบ publish/subscribe ผ่าน broker [36] โต๊ะที่เพิ่มเข้ามาใหม่แค่ส่งข้อความในหัวข้อของตัวเอง โหนดห้องไม่ต้องรู้ล่วงหน้าว่ามีกี่โต๊ะ MQTT ยังมีกลไก Last Will ให้ broker ประกาศแทนเมื่อโหนดใดหลุด และมีข้อความแบบ retained ให้โต๊ะที่เพิ่งต่อเข้ามาได้ค่าล่าสุดทันที เทียบกับ HTTP ที่โต๊ะต้องถามซ้ำและห้องต้องเก็บรายชื่อโต๊ะเอง หรือ UDP broadcast ที่ไม่มีการยืนยันและต้องเขียนกลไกทุกอย่างเอง ในการใช้งานจริง broker คือ Mosquitto ที่ติดตั้งในเครือข่ายของห้อง ระบบจึงคุยกันได้แม้อินเทอร์เน็ตล่ม ส่วนในการจำลองใช้ broker สาธารณะเพราะแต่ละโหนดเปิดเป็นคนละโปรเจค

ตารางที่ 5.7 หัวข้อและรูปแบบข้อความ MQTT (นำหน้าทุกหัวข้อด้วย swer/<room_id>/)

หัวข้อ | ผู้ส่งและผู้รับ | QoS / Retained | ตัวอย่างข้อความ | ส่งเมื่อ
desk/<desk_id>/report | โต๊ะ ส่งให้ ห้อง | 0 / ไม่ | {"seq":812,"occ":1,"iv":5} | ทุก 5 วินาที (15 วินาทีเมื่อไม่มีคน) และทันทีเมื่อ occupied เปลี่ยน
desk/<desk_id>/online | โต๊ะ ส่งให้ ห้อง | 1 / ใช่ | 1 หรือ 0 (Last Will) | ตอนต่อ broker สำเร็จ หรือ broker ส่งแทนเมื่อโต๊ะหลุด
room/air | ห้อง ส่งให้ ทุกโต๊ะ | 0 / ใช่ | {"seq":95,"co2":1043,"t":251,"rh":58,"lvl":2,"tf":0,"ok":1,"fan":100} | ทุก 5 วินาทีหลังอ่าน SCD41
room/online | ห้อง ส่งให้ ทุกโต๊ะ | 1 / ใช่ | 1 หรือ 0 (Last Will) | เหมือนหัวข้อ online ของโต๊ะ

ข้อมูลรายรอบใช้ QoS 0 เพราะเป็นสถานะล่าสุดที่ส่งซ้ำทุก 5 วินาที ถ้าข้อความหนึ่งหาย ข้อความถัดไปก็มาแทน การส่งแบบยืนยันจะเพิ่มข้อความไปกลับโดยไม่ได้ประโยชน์ ส่วนหัวข้อ online ใช้ QoS 1 เพราะเกิดไม่บ่อยและต้องไม่หาย ทุกข้อความมีเลขลำดับ (seq) ใช้ตรวจว่าข้อความหายหรือผู้ส่งเพิ่งรีสตาร์ต ข้อความเป็น JSON ไม่เกิน 100 ไบต์ อ่านง่ายตอนตรวจหาข้อผิดพลาด

3) การรับมือเมื่อการสื่อสารผิดพลาด

ถ้า Wi-Fi หรือ broker หลุด โหนดโต๊ะยังตรวจคน คุมแสง และเตือนพักได้ครบ เพราะคิดในโหนดเอง และแสดงไอคอนลิงก์ขาดบนจอ ถ้าไม่ได้ข้อมูลอากาศเกิน 15 วินาที (3 รอบ) จอจะแสดงว่าไม่มีข้อมูลอากาศแทนค่าเก่า ฝั่งโหนดห้องตัดโต๊ะที่เงียบเกิน 3 รอบการส่งออกจากการนับ ข้อความที่อ่านไม่ได้หรือค่าเกินช่วงจะถูกทิ้งแล้วใช้ค่าเดิม การต่อกลับเว้นช่วงเพิ่มเป็น 1, 2, 4, 8 วินาทีไปจนถึงสูงสุด 60 วินาที เพื่อไม่ให้ทุกโหนดรุมต่อ router พร้อมกันตอนไฟกลับมา

4) เวลาจริงจาก NTP

โหนดโต๊ะใช้ SNTP ที่มากับ ESP32 ซิงก์เวลาตอนต่อ Wi-Fi สำเร็จและทุก 1 ชั่วโมง ตั้งเขตเวลาเป็น UTC+7 [37] ระหว่างที่ไม่มีเครือข่าย นาฬิกาในตัวนับต่อเองได้ คลาดไม่ถึง 1 วินาทีต่อชั่วโมง เพียงพอสำหรับเลือกสีแสงที่ละเอียดระดับนาที ค่า time_valid เป็นเท็จจนกว่าจะซิงก์สำเร็จครั้งแรก และคงเป็นจริงแม้เครือข่ายหลุดภายหลัง โหนดห้องไม่ดึงเวลาเพราะไม่มีงานใดที่ใช้เวลาจริง

# 6. Design Methodology (วิธีการออกแบบ)

## 6.1 Design Approach (แนวทางการออกแบบ)

ทีมออกแบบแบบไล่จากความต้องการลงไปหารายละเอียด และตรวจกลับขึ้นมาด้วยการทดสอบ ขั้นแรกกำหนดความต้องการเชิงหน้าที่ ความต้องการที่ไม่ใช่เชิงหน้าที่ และค่าเกณฑ์ทุกตัวพร้อมที่มา ให้เป็นแหล่งตัวเลขเดียวของทั้งระบบ ขั้นที่สองกำหนดตารางข้อมูลกลาง ซึ่งเป็นข้อตกลงว่าแต่ละโมดูลส่งข้อมูลอะไรออก รับอะไรเข้า และใครเป็นเจ้าของ เมื่อข้อตกลงนี้ชัดแล้ว แต่ละโมดูลจึงออกแบบอุปกรณ์ FSM และ pseudocode ของตัวเองได้พร้อมกันโดยไม่ต้องรอกัน ขั้นที่สามนำ logic ของทุกโมดูลมาเขียนเป็นโค้ดจริงบน FreeRTOS และต่อวงจรในโปรแกรมจำลอง ขั้นสุดท้ายทดสอบตามแผนที่เขียนไว้ตั้งแต่ตอนออกแบบ ซึ่งทุกกรณีทดสอบอ้างกลับไปที่รหัสความต้องการ

ระหว่างทาง ทีมแบ่งงานเป็นด่าน (milestone) 6 ด่าน คือ ตั้งต้น ออกแบบโมดูล รวมระบบ ทดสอบ เขียนเอกสาร และรวมเล่ม แต่ละด่านมีรายการของที่ต้องครบก่อนผ่าน และเก็บงานทุกชิ้นไว้ในคลังเอกสารร่วมกันบน GitHub โดยแต่ละคนทำงานใน branch ของตัวเองแล้วรวมเข้าฉบับหลักผ่านการตรวจ (pull request) เมื่อพบจุดที่ต้องแก้ ใช้ Issue ระบุว่าใครต้องแก้อะไร เพื่อให้ตามได้ว่าการตัดสินใจแต่ละเรื่องเกิดขึ้นเมื่อไรและเพราะอะไร

หลักที่ใช้ตลอดการออกแบบมี 4 ข้อ ข้อแรก ทุกตัวเลขต้องมีที่มาจากงานวิจัย มาตรฐาน หรือ datasheet ถ้าเป็นค่าที่ตั้งเองต้องเขียนเหตุผล ข้อสอง ทุกการเลือกต้องเทียบกับตัวเลือกอื่นอย่างน้อยหนึ่งตัว ข้อสาม ข้อมูลทุกตัวมีเจ้าของคนเดียว ข้อสี่ ทุกโมดูลต้องมีสถานะปลอดภัยเมื่อเซนเซอร์เสียหรือข้อมูลขาด

## 6.2 Key Design Decisions and Trade-offs (การตัดสินใจหลักและข้อแลกเปลี่ยน)

ตารางที่ 6.1 การตัดสินใจหลักและข้อแลกเปลี่ยน

เรื่อง | สิ่งที่เลือก | ตัวเลือกที่เทียบ | เหตุผลและสิ่งที่ยอมเสีย
การแบ่งระบบ | โหนดโต๊ะหลายชุด + โหนดห้อง 1 ชุด | โหนดเดียวคุมทั้งห้อง | ปัญหาแสงและท่านั่งเป็นเรื่องรายโต๊ะ ส่วนอากาศเป็นเรื่องของห้อง ยอมเพิ่มบอร์ดแลกกับการเพิ่มโต๊ะได้และโต๊ะทำงานต่อได้เมื่อเครือข่ายล่ม
ไมโครคอนโทรลเลอร์ | ESP32 | Arduino Uno, ESP8266, Pico W | มี Wi-Fi, แกนคู่ และ FreeRTOS ในตัว ยอมใช้พลังงานสูงกว่าบอร์ด 8 บิต
ตรวจคน | เรดาร์ mmWave LD2410 | PIR | ตรวจคนนั่งนิ่งได้ ยอมแลกกับราคาสูงกว่าและโอกาสตรวจเจอคนเดินผ่าน
สื่อสาร | Wi-Fi + MQTT | BLE, Zigbee, HTTP, UDP | ใช้ router ของห้อง เพิ่มโต๊ะได้ไม่ต้องแก้โหนดห้อง ยอมใช้พลังงานสูงกว่า
เตือนเรื่องอากาศ | ส่งสถานะอากาศซ้ำทุก 5 วินาที แล้วให้โต๊ะตัดสินเอง | ส่งคำขอเตือนข้ามเครือข่ายครั้งเดียว | ข้อความหายได้โดยไม่ทำให้การเตือนหาย ยอมส่งข้อมูลซ้ำทุกรอบ
ห้องว่างหรือไม่รู้ | แยก "ไม่รู้" ออกจาก "ว่าง" | นับเฉพาะโต๊ะที่มีคน | ไม่ปิดพัดลมตอนเครือข่ายล่มขณะยังมีคน ยอมให้พัดลมทำงานต่อในกรณีที่ห้องว่างจริงแต่ติดต่อไม่ได้
เจ้าของค่าที่ผู้ใช้ปรับ | โมดูลตรวจคนเป็นเจ้าของคนเดียว | ให้โมดูลแสงเขียนค่าเองด้วย | ไม่มีสองโมดูลเขียนค่าเดียวกัน ยอมให้โมดูลแสงต้องรอค่าจากอีกโมดูล
MOSFET | AO3400A ทั้งระบบ | IRLZ44N, IRF540N, BJT, รีเลย์ | รับรองการเปิดเต็มที่ที่ 3.3 V และใช้รุ่นเดียวทั้งระบบ ยอมแลกกับตัวถัง SOT-23 ที่บัดกรียากกว่า
แหล่งแสง | แถบ LED 2 สี (CCT) | RGB, หลอด 220 V | ปรับได้ทั้งความสว่างและอุณหภูมิสีด้วยคุณภาพสีดี ยอมคุม PWM 2 ช่อง
การคุมพัดลม | hysteresis 800/950/1,000 ppm | เกณฑ์เดียว 1,000 ppm | พัดลมไม่เปิดปิดถี่ ยอมให้ CO₂ อยู่ในช่วง 800 ถึง 1,000 ppm นานขึ้น
เซนเซอร์เสีย | ทุกโมดูลเข้าสถานะปลอดภัยหลังอ่านพลาด 3 รอบ | หยุดทำงานทันที | ไม่ตัดสินจากการอ่านพลาดครั้งเดียว ยอมช้าลงเล็กน้อยก่อนเข้าโหมดปลอดภัย

## 6.3 Handling Concurrency, Timing, and Latency (การจัดการงานพร้อมกัน เวลา และความหน่วง)

งานที่ใช้ทรัพยากรร่วมกันมี 3 แบบ และใช้วิธีป้องกันต่างกัน แบบแรกคือสาย I²C ของโหนดโต๊ะที่จอ OLED และเซนเซอร์แสงใช้ร่วมกัน ทุกงานต้องขอ i2c_lock รอได้ไม่เกิน 50 ms ถือล็อกเฉพาะช่วงคุยกับอุปกรณ์ และห้ามหน่วงเวลาหรือรอเครือข่ายขณะถือล็อก ค่า 50 ms ยาวกว่างานที่ใช้สายนานที่สุด (วาดจอทั้งหน้า) แต่สั้นกว่าคาบของงานคุมแสง 200 ms จึงไม่ทำให้งานนั้นพลาดรอบ แบบที่สองคือจอและ buzzer ซึ่งมีงานเจ้าของเพียงงานเดียว โมดูลอื่นส่งคำขอเตือนผ่าน queue งานเจ้าของจอเลือกแสดงตามลำดับความสำคัญ 2 ก่อน 1 ก่อน 0 และถ้าเท่ากันแสดงรายการที่มาก่อน แบบที่สามคือข้อมูลกลาง ซึ่งมีผู้เขียนคนเดียวและผู้อ่านคัดลอกค่าทั้งชุดในช่วงสั้นๆ ก่อนนำไปใช้

PWM ของไฟ พัดลม และ buzzer ใช้วงจร LEDC ของ ESP32 [33] จึงไม่ต้องมี task ความถี่สูงมาสลับขา ระบบจัดเป็นแบบ soft real-time เพราะการพลาดรอบหนึ่งครั้งทำให้การแสดงผลหรือการควบคุมช้าลงเล็กน้อย แต่ไม่เกิดอันตรายทันที เช่น จอที่ข้ามหนึ่งเฟรมจะวาดใหม่ในรอบ 500 ms ถัดไป ผลวัดจริงในหัวข้อ 5.3 แสดงว่างานควบคุมบนแกน 1 ของโหนดโต๊ะใช้เวลาประมวลผลรวม 29.0% ต่ำกว่าขอบเขต 74.3% และตลอดการรันต่อเนื่อง 22.8 นาทีไม่มีงานใดพลาดเส้นตาย ส่วนความหน่วงข้ามโหนดวัดได้ไม่เกิน 0.9 วินาทีจากห้องถึงจอบนโต๊ะ (หัวข้อ 7.2) ซึ่งต่ำกว่าเกณฑ์ 10 วินาทีมาก

# 7. Testing and Validation (การทดสอบและการตรวจสอบ)

## 7.1 Test Plan and Scenarios (แผนและสถานการณ์ทดสอบ)

แผนทดสอบแบ่งเป็น 2 ระดับ ระดับโมดูลทดสอบตรรกะของแต่ละโมดูลแยกกัน ระดับระบบทดสอบการทำงานร่วมกันข้ามโหนดผ่าน Wi-Fi และ MQTT ทุกกรณีทดสอบระบุสภาพเริ่มต้น สิ่งที่ป้อน ผลที่ควรได้ และรหัสความต้องการที่ตรวจ เพื่อให้ตามกลับได้ว่าความต้องการทุกข้อมีการทดสอบรองรับ ทั้งหมดมี 29 กรณี ตามตารางที่ 7.1

เนื่องจากเป็นการออกแบบ ไม่ได้สร้างอุปกรณ์จริง การทดสอบทั้งหมดทำบนโปรแกรมจำลอง Wokwi โดยใช้อุปกรณ์แทนเซนเซอร์ที่ Wokwi ไม่มี ได้แก่ slide switch แทนเรดาร์ photoresistor แทนเซนเซอร์แสง และ potentiometer กับ DHT22 แทนเซนเซอร์อากาศ กรณีที่ต้องรอนาน เช่น นั่งครบ 30 นาที ใช้การเร่งเวลาในโค้ดทดสอบ และกรณีเซนเซอร์เสียใช้คำสั่งจำลองความผิดพลาดผ่าน Serial

รหัสกรณีทดสอบแบ่งตามกลุ่ม TC-C คือโมดูลอากาศ TC-B คือโมดูลตรวจคนและเตือนพัก TC-D คือโมดูลแสง และ TC-A คือการทำงานร่วมกันทั้งระบบ

ตารางที่ 7.1 กรณีทดสอบทั้งหมด

รหัส | ทดสอบอะไร | ตรวจความต้องการ
TC-C-01 | พัดลมเปิดเต็มกำลังเมื่อ CO₂ ถึง 1,000 ppm | FR-13, FR-14, NFR-01
TC-C-02 | hysteresis รักษารอบพัดลมขาลง | FR-13
TC-C-03 | พัดลมหยุดเมื่อ CO₂ ต่ำกว่า 800 ppm | FR-13
TC-C-04 | หยุดพัดลมเมื่อห้องว่าง | FR-15, NFR-08
TC-C-05 | โหมดปลอดภัยเมื่อเซนเซอร์อากาศเสีย | NFR-07, NFR-14
TC-C-06 | เตือนอุณหภูมิห้องไม่เหมาะสม | FR-17
TC-C-07 | แสดงค่าความชื้น | FR-18
TC-B-01 | เตือนพักสายตาเมื่อนั่งครบ 20 นาที | FR-03, NFR-04, NFR-14
TC-B-02 | เตือนลุกเมื่อนั่งครบ 30 นาที และเริ่มนับใหม่หลังพักจริง | FR-01, FR-02, FR-04
TC-B-03 | เรดาร์เสียแล้วไม่ปิดไฟใส่ผู้ใช้ | NFR-07
TC-B-04 | เลื่อนการเตือนได้ไม่เกิน 2 ครั้ง | FR-05, NFR-14, NFR-15
TC-B-05 | ตั้งความสว่างด้วยปุ่มเดียวภายในช่วงที่อนุญาต | FR-07, NFR-15
TC-B-06 | เปิดโหมดทำงานดึกและคืนค่าเมื่อโต๊ะว่าง | FR-08, FR-10, FR-11
TC-B-07 | แสดงสถานะอากาศและสร้างการเตือนอากาศที่โต๊ะ | FR-14, FR-16 ถึง FR-19, NFR-14
TC-B-08 | ไม่ใช้ข้อมูลอากาศที่เก่าเกินไป | FR-19, NFR-06, NFR-07
TC-D-01 | รักษาความสว่าง 500 lux แบบป้อนกลับ | FR-06, NFR-02
TC-D-02 | เปลี่ยนสีแสงตามเวลาแบบค่อยเป็นค่อยไป | FR-09, NFR-10
TC-D-03 | หรี่และปิดไฟเมื่อไม่มีคน และกลับมาเมื่อคนกลับ | FR-08, NFR-03, NFR-08, NFR-11
TC-D-04 | ผู้ใช้ปรับความสว่างและโหมดทำงานดึก | FR-07, FR-10, FR-11, NFR-15
TC-D-05 | สีแสงเมื่อยังไม่รู้เวลา | FR-09, FR-20, NFR-06, NFR-10
TC-D-06 | โหมดปลอดภัยเมื่อเซนเซอร์แสงเสีย | NFR-07, NFR-14
TC-A-01 | ข้อมูลอากาศส่งจากห้องไปแสดงที่โต๊ะ | FR-14, FR-19, NFR-01
TC-A-02 | สถานะการนั่งส่งจากโต๊ะไปห้อง | FR-15, FR-19
TC-A-03 | โหนดโต๊ะทำงานต่อเมื่อเครือข่ายหลุด | NFR-06, NFR-07
TC-A-04 | โหนดห้องแยก "ไม่รู้" ออกจาก "ห้องว่าง" | FR-15, NFR-06
TC-A-05 | ซิงก์เวลาจริงจาก NTP | FR-09, FR-20
TC-A-06 | เพิ่มโต๊ะได้โดยไม่แก้โค้ดโหนดห้อง | NFR-13
TC-A-07 | i2c_lock ป้องกันการแย่งสาย I²C | NFR-05
TC-A-08 | ลดพลังงานเมื่อไม่มีคน | FR-08, NFR-08

## 7.2 Test Results and Observations (ผลการทดสอบและข้อสังเกต)

การทดสอบใช้ Wokwi CLI รุ่น 0.28.1 ร่วมกับสคริปต์ที่สั่งงานผ่าน Serial ปุ่ม และตัวเลื่อนของเซนเซอร์แบบอัตโนมัติ แล้วเก็บ log ภาพหน้าจอ OLED และไฟล์สัญญาณจาก logic analyzer เป็นหลักฐาน [38] ชุดทดสอบโหนดโต๊ะใช้การเร่งเวลา 120 เท่า (1 วินาทีในโปรแกรมเท่ากับ 2 นาทีของระบบ) ส่วนชุดทดสอบทั้งระบบใช้เวลาจริง ผลรวมคือผ่าน 21 จาก 21 รายการที่รันได้อัตโนมัติ และผ่าน 5 จาก 5 รายการที่ทดสอบต่อเนื่องบนโปรเจค Wokwi แบบ public (รันต่อเนื่อง นั่งจริง 20 นาที วิดีโอสถานการณ์ใช้งาน TC-A-05 และ TC-A-08) ระหว่างทดสอบพบข้อผิดพลาด 9 จุด แก้แล้วทั้งหมดและรันซ้ำบนโค้ดที่แก้แล้ว

ตารางที่ 7.2 ผลการทดสอบโหนดห้อง

กรณี | สิ่งที่ทำ | ผลที่ได้ | ผล
TC-C-01 | ตั้ง CO₂ เป็น 1,050 ppm | เข้า AIR_POOR พัดลม 100% | ผ่าน
TC-C-02 | จาก AIR_POOR ลด CO₂ เป็น 970 แล้ว 920 ppm | 970 ยังเป็น AIR_POOR, 920 เข้า AIR_MODERATE พัดลม 60% ที่ 50 Hz | ผ่าน
TC-C-03 | ตั้ง CO₂ 750 แล้ว 900 ppm | 750 พัดลมหยุด, 900 จาก AIR_GOOD เข้า AIR_MODERATE แต่พัดลมยังไม่เปิด | ผ่าน
TC-C-04 | CO₂ 1,200 ppm และทุกโต๊ะไม่มีคน | เข้า ROOM_EMPTY พัดลมหยุด | ผ่าน
TC-A-04 | ติดต่อโต๊ะไม่ได้เลย | กลับไป AIR_POOR พัดลม 100% (ไม่รู้ ไม่ใช่ว่าง) | ผ่าน
TC-C-05 | จำลองเซนเซอร์อากาศเสีย และค่าเกินช่วง 5,200 ppm | ครบ 3 รอบเข้า SENSOR_FAULT พัดลม 80% กลับปกติหลังอ่านได้ 2 รอบ | ผ่าน
TC-C-06 | ตั้งอุณหภูมิ 27°C และ 18°C | ธงอุณหภูมิเป็นสูงเกินและต่ำเกินตามลำดับ | ผ่าน
TC-C-07 | อ่านความชื้นจากเซนเซอร์ | ห้องได้ความชื้น 55 % ตรงกับเซนเซอร์ และโต๊ะได้ค่าเดียวกันผ่าน MQTT ไม่มีการเตือนจากความชื้น | ผ่าน

ตารางที่ 7.3 ผลการทดสอบโหนดโต๊ะ

กรณี | สิ่งที่ทำ | ผลที่ได้ | ผล
TC-B-01 | นั่งต่อเนื่องในชุดทดสอบอัตโนมัติ และนั่งแบบเวลาจริงไม่เร่งเวลา | เตือนพักสายตาที่ 20 นาที (แบบเวลาจริงได้ 20 นาที 0.2 วินาที) จอขึ้นเตือนและ buzzer 4 kHz ดัง 150 ms | ผ่าน
TC-B-02 | นั่งต่อเนื่อง แล้วลุกไปเกิน 3 นาที | เตือนลุกที่ 30 นาที ลุกไปประมาณ 4 นาทีแล้วเข้า UNOCCUPIED และเวลานั่งกลับเป็น 0 นาที (เริ่มนับใหม่) | ผ่าน
TC-B-04 | กดค้างเลื่อนการเตือน 3 ครั้ง | เลื่อนได้ 2 ครั้ง ครั้งที่ 3 จอแสดงว่าเลื่อนได้สูงสุด 2 ครั้ง | ผ่าน
TC-B-05, 06 | ตั้ง 800 lux เปิดโหมดดึก แล้วลุกไป | ค่าเป็น 800 lux และโหมดดึกเปิด หลังไม่มีคนครบ 5 นาทีกลับเป็น 500 lux และปิดโหมดดึก | ผ่าน
TC-D-01 | แสงภายนอก 50, 800 และ 200 lux | 50 lux ได้แสงบนโต๊ะ 476 lux ที่ความสว่าง 71%, 800 lux ไฟลดจนดับ, 200 lux ได้ 475 lux | ผ่าน
TC-D-02 | ตั้งเวลา 16:58 | r ขยับไม่เกิน 0.01 ต่อนาที ที่ 17:39 ได้ 0.547 (ตามตาราง 0.54) | ผ่าน
TC-D-03 | ลุกไป กลับมาระหว่างหรี่ และไม่กลับ | หรี่จาก 50.6% เหลือ 25.3% กลับมาแล้วสว่างทันที ไม่กลับดับหลัง 60.0 วินาทีพอดี | ผ่าน
TC-D-05 | มีคนนั่งก่อนเครื่องรู้เวลาจริง แล้วได้เวลา | ก่อนรู้เวลาใช้สีกลาง r = 0.50 และยังคุมความสว่างได้ หลังได้เวลา r ค่อยๆ เปลี่ยนตามตารางเวลา ไม่กระโดด | ผ่าน
TC-D-06 | จำลองเซนเซอร์แสงเสีย | ครบ 3 รอบ (0.49 วินาที) เข้า SENSOR_FAULT ไฟ 60% จอขึ้นเตือน กลับปกติหลังอ่านได้ 2 รอบ | ผ่าน
TC-B-03 | จำลองเรดาร์เสีย | 0.53 วินาทีเข้า SENSOR_FAULT ระดับเตือน 2 แล้วกลับ WORKING | ผ่าน
TC-B-07 | ห้องมี CO₂ สูง และเซนเซอร์ห้องเสีย | จอโต๊ะเตือน CO₂ สูง (ระดับ 1) ภายใน 0.9 วินาที และเตือนเซนเซอร์ห้องเสีย (ระดับ 2) ภายใน 0.5 วินาที | ผ่าน
TC-B-08 | มีเตือน CO₂ ค้างอยู่ แล้วห้องหยุดส่งข้อมูล | ข้อมูลอากาศเก่าเกิน 15 วินาที โต๊ะยกเลิกเตือน CO₂ แสดงลิงก์ขาด และหน้าจอแสดงว่าไม่มีข้อมูลอากาศ | ผ่าน

ตารางที่ 7.4 ผลการทดสอบทั้งระบบ

กรณี | สิ่งที่ทำ | ผลที่ได้ | ผล
TC-A-02 | โต๊ะมีคน | ห้องได้รับสถานะหลังโต๊ะส่ง 0.15 วินาที และนับโต๊ะที่มีคนเป็น 1 ในรอบเดียวกัน | ผ่าน
TC-A-01 | ห้อง CO₂ 1,200 ppm | จอบนโต๊ะขึ้นเตือน CO₂ สูงภายใน 0.9 วินาที พร้อมเสียงเตือน | ผ่าน
TC-A-01 | จำลองเซนเซอร์อากาศเสีย | โต๊ะขึ้นเตือนเซนเซอร์ห้องเสียระดับ 2 ภายใน 0.5 วินาที | ผ่าน
TC-A-03 | ตัด Wi-Fi ของโต๊ะ 18 วินาทีแล้วต่อกลับ | โต๊ะขึ้นลิงก์ขาดทันที ห้องตัดโต๊ะออกเมื่อเงียบเกิน 15 วินาที ต่อกลับได้ใน 5.3 วินาที | ผ่าน
TC-A-05 | ตัด Wi-Fi ของโต๊ะ 11.2 นาทีหลังซิงก์เวลาแล้ว | นาฬิกายังถูกต้องตลอด (01:10 ถึง 01:21 ตรงกับเวลาที่ผ่านไป) ต่อ MQTT กลับได้ใน 3.6 วินาที | ผ่าน
TC-A-08 | โต๊ะไม่มีคนจนตั้ง away_timeout | ไฟหรี่แล้วดับใน 60 วินาที ห้องเห็นรอบส่ง 15 วินาทีและยังนับโต๊ะนี้ว่าออนไลน์ | ผ่าน
TC-A-06 | ห้อง + โต๊ะที่มีคน + โต๊ะที่ว่าง | ห้องนับโต๊ะออนไลน์ 2 โต๊ะที่มีคน 1 โดยไม่แก้โค้ดโหนดห้อง | ผ่าน
TC-A-07 | รันต่อเนื่อง 22.8 นาที (โต๊ะ) และ 10.5 นาที (ห้อง) พร้อมสร้างเหตุการณ์ต่างๆ | ไม่มี reset ไม่มีงานใดพลาดเส้นตาย หน่วยความจำว่างต่ำสุด 174 kB | ผ่าน
สถานการณ์ใช้งาน | รันสองโหนดพร้อมกันตั้งแต่นั่งจนลุกไป (วิดีโอ 1 นาที 42 วินาที) | เตือนพัก CO₂ สูงแล้วพัดลม 100% เลื่อนเตือนได้ ลุกไปแล้วไฟหรี่และห้องเข้า ROOM_EMPTY ตามลำดับ | ผ่าน

ข้อมูลจาก logic analyzer ยืนยันว่า PWM ของไฟทั้งสองช่องอยู่ที่ 5,000 Hz buzzer 4.00 kHz และพัดลม 50 Hz ที่ 60%, 80% และ 100% ตรงตามที่ออกแบบ และทุกขาที่ขับอุปกรณ์อยู่ที่ระดับต่ำตั้งแต่จ่ายไฟ ไม่มีไฟหรือพัดลมกระพริบตอนเปิดเครื่อง

ข้อสังเกต

1) ทุกกรณีที่รันผ่านตามเกณฑ์ แสดงว่าตรรกะของทุกโมดูลและการทำงานร่วมกันข้ามโหนดเป็นไปตามที่ออกแบบ

2) TC-A-08 ยืนยันได้เฉพาะพฤติกรรม เพราะ Wokwi วัดกระแสไฟไม่ได้

3) การรันต่อเนื่องทำบนโปรเจค Wokwi แบบ public ในเบราว์เซอร์ ระหว่างรันได้สร้างเหตุการณ์ทั้ง CO₂ ขึ้นลงหลายระดับ เซนเซอร์อากาศและเซนเซอร์แสงเสียแล้วกลับมา อุณหภูมิสูงและต่ำเกิน Wi-Fi ของโต๊ะหลุด 39 วินาทีแล้วต่อกลับ และตั้งเวลาให้สีแสงเปลี่ยน เบราว์เซอร์หยุดแท็บที่ไม่ได้แสดง จึงรันสองโหนดสลับกันเป็นช่วง ช่วงที่โหนดห้องหยุด โต๊ะแสดงว่าลิงก์ขาดตามที่ออกแบบไว้

4) ก่อนเริ่มชุดทดสอบโหนดโต๊ะ ระบบเข้า WORKING หลังมีคน 1.1 วินาที (ต้องพบคนต่อเนื่อง 1 วินาที) และไฟค่อยๆ สว่างใน 2 วินาทีที่ 5 kHz ตรงตาม FR-01

5) ข้อสังเกตที่ส่งให้เจ้าของโมดูลพิจารณาได้ข้อสรุปแล้ว ได้แก่ การเริ่มนับเวลานั่งใหม่หลังเรดาร์กลับมาจากสถานะเสียเป็นพฤติกรรมที่ตั้งใจ และเพิ่ม stack ของงานรับปุ่มเป็น 3,072 ไบต์ ซึ่งในการรันต่อเนื่องเหลืออย่างน้อย 2,196 ไบต์ ส่วนการอ่าน DHT22 ครั้งแรกหลังเปิดเครื่องได้ค่าว่าง 1 ครั้งยังคงอยู่ และมีผลเฉพาะในการจำลอง

## 7.3 Debugging Techniques (เทคนิคการดีบัก)

ทีมใช้เทคนิค 5 อย่างร่วมกัน อย่างแรกคือคำสั่งทดสอบผ่าน Serial เช่น ตั้งค่า CO₂ ตั้งเวลา หรือสั่งให้เซนเซอร์ตัวใดตัวหนึ่งเสีย ทำให้สร้างสถานการณ์ที่ยากหรือนานได้ทันที อย่างที่สองคือ log ที่มีเวลากำกับทุกบรรทัด ใช้คำนวณเวลาตอบสนองจากเวลาที่เกิดเหตุถึงเวลาที่ระบบตอบ อย่างที่สามคือ logic analyzer ในโปรแกรมจำลอง ใช้วัดความถี่และ duty ของ PWM ตรงจากขา ซึ่งพบปัญหาที่ log มองไม่เห็น อย่างที่สี่คือภาพหน้าจอ OLED ในแต่ละขั้น ใช้ตรวจว่าข้อความแสดงถูกและไม่ล้นจอ อย่างที่ห้าคือคำสั่ง stats ที่วัดเวลาทำงานของทุก task ด้วยนาฬิกาความละเอียดไมโครวินาที ใช้ตรวจว่างานทันเส้นตาย ทั้งหมดรันเป็นชุดทดสอบอัตโนมัติ จึงรันซ้ำได้ทุกครั้งที่แก้โค้ด

ตารางที่ 7.5 ข้อผิดพลาดที่พบระหว่างทดสอบและวิธีแก้

# | ส่วนที่พบ | อาการ | สาเหตุและวิธีแก้

1 | ปุ่มกด (ตรวจคน) | กดสั้น 3 ครั้งนับได้ 1 ครั้ง | อ่านขาระหว่างที่หน้าสัมผัสยังเด้ง แก้เป็นรอให้สัญญาณนิ่ง 30 ms แล้วค่อยอ่านระดับขา
2 | ตัวนับเวลาพัก (ตรวจคน) | การเตือนลุกที่เลื่อนไว้หายไปเมื่อถึงเวลาเตือนพักสายตา | การเตือนพักสายตาล้างสถานะการเลื่อน แก้ให้การเตือนลุกที่รออยู่มีลำดับเหนือกว่า
3 | การตั้ง PWM (รวมระบบ) | พัดลม 60% และ 80% ออกมาเป็น 100% และไฟขาวเย็นสว่างเต็มหลังเสียง beep | ช่อง PWM ที่อยู่ติดกันใช้ timer ตัวเดียวกัน แก้ให้แต่ละขาใช้ช่องที่มี timer ของตัวเอง
4 | จอ (ตรวจคน) | ข้อความ SENSOR FAULT ล้นจอ | ตัวอักษรกว้างรวม 144 จุดเกินจอ 128 จุด แก้เป็นข้อความที่สั้นลง
5 | การจำลองเซนเซอร์แสง (แสง) | ค่าแสงที่อ่านได้สูงกว่าจริงประมาณ 1.8 เท่า | สูตรแปลงใช้ค่าของไฟ 5 V แก้เป็นสูตรของไฟ 3.3 V
6 | การสื่อสารฝั่งโต๊ะ (รวมระบบ) | สถานะลิงก์สลับไปมาทุกไม่กี่วินาที | คำนวณอายุข้อมูลแบบไม่มีเครื่องหมายแล้วติดลบ แก้เป็นแบบมีเครื่องหมาย
7 | การสื่อสารทั้งสองโหนด (รวมระบบ) | นับข้อความหายได้ 65,507 หลังห้องรีสตาร์ต | เลขลำดับเริ่มใหม่ถูกนับเป็นข้อความหาย แก้ให้ช่องว่างตั้งแต่ 1,000 ถือว่าผู้ส่งเริ่มนับใหม่
8 | โหนดห้อง (รวมระบบและอากาศ) | ตัดสินห้องว่างช้าไป 1 รอบ (5 วินาที) | นับโต๊ะหลังรอบอ่าน CO₂ แก้ให้นับก่อนตัดสินสถานะทุกรอบ
9 | การตั้งค่า MQTT (รวมระบบ) | ในการจำลอง MQTT หลุดและต่อใหม่บ่อย | โปรแกรมจำลองช้ากว่าเวลาจริง แก้ keepalive เป็น 60 วินาทีเฉพาะตอนจำลอง

ข้อผิดพลาดข้อ 1 และข้อ 3 จะเกิดกับอุปกรณ์จริงด้วย การทดสอบบนโปรแกรมจำลองจึงช่วยแก้ปัญหาที่อาจทำให้ปุ่มกดไม่ติดและพัดลมกับไฟทำงานผิดตั้งแต่ก่อนสร้างอุปกรณ์จริง

# 8. Challenges and Limitations (ความท้าทายและข้อจำกัด)

## 8.1 Technical or Resource Challenges (ความท้าทายด้านเทคนิคหรือทรัพยากร)

ปัญหาที่พบระหว่างออกแบบส่วนใหญ่เกิดที่รอยต่อระหว่างโมดูล คือข้อมูลที่ไม่ชัดว่าใครเป็นเจ้าของ หรือข้อมูลจาก datasheet ที่ไม่ตรงกับเงื่อนไขการใช้งานจริง ตารางที่ 8.1 สรุปปัญหาหลักและวิธีที่ทีมแก้

ตารางที่ 8.1 ปัญหาหลักระหว่างการออกแบบและวิธีแก้

ปัญหา | ผลถ้าไม่แก้ | วิธีแก้
ค่าที่ผู้ใช้ปรับ (ความสว่างและโหมดทำงานดึก) ไม่มีในตารางข้อมูลกลางรุ่นแรก และไม่ชัดว่าใครคืนค่าเมื่อผู้ใช้ลุกไป | สองโมดูลเขียนค่าเดียวกัน ค่าอาจชนกัน | เพิ่มข้อมูลทั้งสองตัว ให้โมดูลตรวจคนเป็นเจ้าของและคืนค่า โมดูลแสงอ่านอย่างเดียว
ถ้าโมดูลแสงนับเวลาไม่มีคนเอง จะไม่ตรงกับโมดูลตรวจคน | ไฟดับทั้งที่จอยังแสดงว่ามีคน | ให้โมดูลตรวจคนนับที่เดียวแล้วส่ง away_timeout ให้โมดูลอื่น
IRLZ44N ที่ตั้งใจใช้ ไม่มีค่ารับรองการเปิดเต็มที่ที่ 3.3 V | MOSFET เปิดไม่สุด ร้อน และคุมไม่ตรง | เปลี่ยนเป็น AO3400A ทั้งระบบ
กระแสของ SCD41 ในร่างแรกใช้ค่าของโหมดวัดทุก 5 นาที แต่ระบบวัดทุก 5 วินาที | ตารางไฟต่ำกว่าจริงประมาณ 30 เท่า | ใช้ค่าเฉลี่ย 15 mA และกระแสกระชาก 205 mA ตาม datasheet
ADC2 ของ ESP32 ใช้ไม่ได้ขณะเปิด Wi-Fi | อ่านค่าแสงและ CO₂ ในการจำลองไม่ได้ | ย้ายอุปกรณ์ analog ทุกตัวไปขา ADC1 (GPIO 34 และ 35)
ถ้านับเฉพาะโต๊ะที่มีคน เมื่อ Wi-Fi ล่มค่าจะเป็น 0 | พัดลมปิดทั้งที่ยังมีคนในห้อง | เพิ่มจำนวนโต๊ะที่ติดต่อได้ เพื่อแยก "ไม่รู้" ออกจาก "ว่าง"
ร่างแรกให้โหนดห้องส่งคำขอเตือนข้ามเครือข่ายครั้งเดียว | การเตือนหายเมื่อข้อความหาย หรือเมื่อโต๊ะเพิ่งต่อเข้ามา | ส่งสถานะอากาศซ้ำทุกรอบ ให้โต๊ะตัดสินการเตือนเอง
ไฟปรับขึ้นลงไม่หยุดเพราะค่าที่วัดได้แกว่งเล็กน้อย | ไฟกะพริบรบกวนสายตา | ใช้ช่วงยอมรับ ±25 lux และปรับไม่เกิน 2% ต่อรอบ
เปลี่ยนสีแสงแล้วความสว่างเปลี่ยนตาม | ความสว่างหลุดจาก 500 lux ทุกครั้งที่เปลี่ยนสี | แยกความสว่างรวม (L) ออกจากสัดส่วนสี (r)
ตัวเลขในร่างแรกหลายตัวไม่มีที่มา และแต่ละเอกสารใช้ค่าไม่ตรงกัน | อ้างอิงไม่ได้ และแต่ละโมดูลทำงานด้วยค่าต่างกัน | รวมค่าเกณฑ์ไว้ที่เดียว ทุกค่ามีงานวิจัยหรือมาตรฐานรองรับ หรือเขียนเหตุผลถ้าตั้งเอง
ขาที่ขับอุปกรณ์ลอยเป็นระดับสูงประมาณ 1.5 วินาทีตอนเปิดเครื่อง | พัดลมและไฟกระพริบทุกครั้งที่เปิดเครื่อง | ตั้งทุกขาเป็น output ระดับต่ำเป็นอย่างแรกในโปรแกรม และมีตัวต้านทานดึง Gate ลงกราวด์
ข้อผิดพลาดในโค้ดที่พบระหว่างทดสอบ 9 จุด | ปุ่มกดไม่ติด พัดลมและไฟทำงานผิด สถานะลิงก์ผิด | แก้ทั้งหมดและรันชุดทดสอบซ้ำ (รายละเอียดในหัวข้อ 7.3)

## 8.2 Unmet Goals (เป้าหมายที่ยังไม่บรรลุ)

1) ยังไม่ได้สร้างอุปกรณ์จริง ความแม่นยำของเซนเซอร์จริง (LD2410, BH1750, SCD41) จึงยังไม่ได้ทดสอบ การทดสอบทั้งหมดตรวจได้เฉพาะตรรกะผ่านอุปกรณ์แทนในโปรแกรมจำลอง

2) ยังไม่ได้วัดกระแสไฟจริง ตารางไฟในหัวข้อ 4.3 ใช้ค่าจาก datasheet และค่าประมาณ (จอ OLED, buzzer, แถบ LED, พัดลม) จึงยังยืนยันการประหยัดพลังงานด้วยตัวเลขวัดจริงไม่ได้ (TC-A-08)

## 8.3 Limitations of the Current Design (ข้อจำกัดของการออกแบบปัจจุบัน)

1) อุปกรณ์แทนในโปรแกรมจำลอง: Wokwi ไม่มีแบบจำลอง LD2410, BH1750 และ SCD41 และ photoresistor ในโปรแกรมมองไม่เห็นแสงจาก LED ที่จำลอง ต้องบวกแสงจาก LED ในโค้ด (แสงบนโต๊ะเท่ากับแสงจากตัวเลื่อนบวก 6 × L) เพื่อทดสอบวงป้อนกลับ [30]

2) การสื่อสารในการจำลอง: สองโหนดเปิดเป็นคนละโปรเจคจึงคุยกันผ่าน broker สาธารณะทางอินเทอร์เน็ต และโปรแกรมจำลองทำงานช้ากว่าเวลาจริงประมาณ 0.3 ถึง 0.7 เท่า เวลาข้ามโหนดที่วัดได้จึงเป็นค่าขอบบน และเวลาทำงานของ task ไม่เท่ากับบนฮาร์ดแวร์จริงทุกประการ

3) เรดาร์ mmWave อาจตรวจเจอคนที่เดินผ่านหรืออยู่หลังผนังบาง ทำให้ระบบเข้าใจว่ามีคนแล้วไม่ปิดไฟ ต้องปรับระยะตรวจให้ครอบคลุมเฉพาะบริเวณเก้าอี้

4) วัดแสงได้จุดเดียวที่ฐานโคม เงามือ เงาศีรษะ หรือของที่วางบนโต๊ะอาจทำให้ค่าที่วัดต่างจากแสงที่ผู้ใช้เห็นจริง

5) ตารางสีแสงยึดเวลาตายตัว (เปลี่ยนสีช่วง 17:00 ถึง 19:00) ไม่ได้ปรับตามฤดูกาลหรือเวลาพระอาทิตย์ตกจริง

6) พัดลมดูดอากาศลด CO₂ ได้ แต่ดึงอากาศร้อนหรือชื้นจากภายนอกเข้ามาแทน อาจทำให้เครื่องปรับอากาศทำงานหนักขึ้น และระบบทำได้เพียงเตือนเรื่องอุณหภูมิ ไม่ได้สั่งเครื่องปรับอากาศโดยตรง

7) ค่าบางตัวเป็นค่าที่ตั้งจากเหตุผลในการออกแบบ ยังไม่ได้ทดสอบกับผู้ใช้จริง เช่น ความสว่าง 60% เมื่อเซนเซอร์แสงเสีย เวลาค้าง 60 วินาทีก่อนดับไฟ เวลากดค้าง 1.5 วินาที และเวลาที่ต้องเห็นคนต่อเนื่อง 1 วินาที

# 9. Future Improvements (แนวทางพัฒนาต่อ)

## 9.1 Ideas for Scalability (แนวคิดการขยายระบบ)

ระบบออกแบบให้ขยายได้ตั้งแต่ต้น โต๊ะแต่ละตัวมีเลขประจำโต๊ะ (1 ถึง 254) และส่งข้อมูลในหัวข้อ MQTT ของตัวเอง การเพิ่มโต๊ะจึงทำได้โดยติดตั้งโหนดโต๊ะใหม่และตั้งเลขโต๊ะ โดยไม่ต้องแก้โปรแกรมของโหนดห้อง ซึ่งยืนยันแล้วในกรณีทดสอบ TC-A-06 หัวข้อทุกหัวข้อขึ้นต้นด้วยเลขห้อง ระบบจึงขยายไปหลายห้องได้โดยใช้ broker เดียวกัน เมื่อมีอุปกรณ์จำนวนมาก ควรเพิ่มการอัปเดตโปรแกรมผ่าน Wi-Fi (OTA) เพื่อไม่ต้องถอดอุปกรณ์มาต่อสายทีละตัว และควรมีหน้าตั้งค่าเลขโต๊ะกับเลขห้องผ่านเครือข่ายแทนการแก้ในโค้ด

## 9.2 Enhancements (การเพิ่มความสามารถ)

1) ปรับตารางสีแสงตามเวลาพระอาทิตย์ขึ้นและตกของพื้นที่ แทนเวลาตายตัว

2) จำค่าความสว่างและโหมดที่ผู้ใช้แต่ละคนชอบไว้เป็นโปรไฟล์ สำหรับโต๊ะที่ใช้ร่วมกันหลายคน

3) ใช้เซนเซอร์แสงหลายจุด เพื่อลดผลจากเงาและวัดแสงได้ทั่วพื้นที่ทำงาน

4) เปลี่ยนการคุมพัดลมจากแบบขั้นบันได (0%, 60%, 100%) เป็นการคุมแบบต่อเนื่องตามอัตราการเพิ่มของ CO₂

5) เพิ่มตัวส่งสัญญาณอินฟราเรดที่โหนดห้อง เพื่อสั่งเครื่องปรับอากาศให้อยู่ในช่วง 21 ถึง 22°C ที่ทำงานได้ดีที่สุด [6]

6) เพิ่มเซนเซอร์ฝุ่น PM2.5 เพื่อตรวจก่อนดึงอากาศจากภายนอกเข้ามา ถ้าภายนอกฝุ่นสูง ให้ใช้เครื่องฟอกอากาศในห้องแทน

7) ส่งค่ารวมของห้อง เช่น CO₂ เฉลี่ยและจำนวนชั่วโมงที่มีคน ขึ้น dashboard บน cloud ผ่าน broker เดิม โดยไม่ส่งข้อมูลรายโต๊ะ เพื่อรักษาความเป็นส่วนตัวของผู้ใช้แต่ละคน

## 9.3 Sustainability or Optimization Recommendations (ข้อเสนอด้านความยั่งยืนและการปรับให้เหมาะสม)

ตัวใช้พลังงานหลักของระบบคือแถบ LED และพัดลม ระบบปัจจุบันลดกำลังไฟของโหนดโต๊ะได้ประมาณ 89% เมื่อไม่มีคน และหยุดพัดลมเมื่อห้องว่าง การลดพลังงานขั้นต่อไปมี 3 แนวทาง แนวทางแรกคือใช้แสงธรรมชาติจากหน้าต่างร่วมกับไฟโต๊ะ (daylight harvesting) ซึ่งวงป้อนกลับของระบบทำได้อยู่แล้ว เพราะจะลดไฟลงเองเมื่อแสงภายนอกพอ ควรวางโต๊ะให้ได้แสงจากหน้าต่างด้านข้างเพื่อใช้ประโยชน์ส่วนนี้ แนวทางที่สองคือให้ ESP32 ของโหนดโต๊ะเข้าโหมด light-sleep เมื่อไม่มีคนนาน แล้วปลุกด้วยขา OUT ของเรดาร์ เพื่อลดไฟฝั่งวงจรควบคุมลงอีก แนวทางที่สามคือติดชุดแลกเปลี่ยนความร้อนกับพัดลมดูดอากาศ (energy recovery ventilator) เพื่อรักษาความเย็นในห้องขณะระบายอากาศ ลดภาระของเครื่องปรับอากาศ

ด้านอายุการใช้งาน ระบบใช้ชิ้นส่วนทั่วไปที่หาทดแทนได้ง่าย ใช้ MOSFET และบอร์ดรุ่นเดียวกันทั้งระบบ ลดจำนวนชนิดของอะไหล่ที่ต้องเก็บ และไม่ใช้แบตเตอรี่ จึงไม่มีขยะจากแบตเตอรี่ที่ต้องเปลี่ยนตามรอบ

# 10. References and Appendices (เอกสารอ้างอิงและภาคผนวก)

## 10.1 References - IEEE Format (เอกสารอ้างอิง)

[1] A. L. Sheppard and J. S. Wolffsohn, "Digital eye strain: Prevalence, measurement and amelioration," BMJ Open Ophthalmol., vol. 3, no. 1, Art. no. e000146, 2018, doi: 10.1136/bmjophth-2018-000146.

[2] C. Talens-Estarelles et al., "The effects of breaks on digital eye strain, dry eye and binocular vision: Testing the 20-20-20 rule," Cont. Lens Anterior Eye, 2022, Art. no. 101744, doi: 10.1016/j.clae.2022.101744.

[3] P. Wennberg et al., "Acute effects of breaking up prolonged sitting on fatigue and cognition: A pilot study," BMJ Open, vol. 6, no. 2, Art. no. e009630, 2016.

[4] J. G. Allen, P. MacNaughton, U. Satish, S. Santanam, J. Vallarino, and J. D. Spengler, "Associations of cognitive function scores with carbon dioxide, ventilation, and volatile organic compound exposures in office workers: A controlled exposure study of green and conventional office environments," Environ. Health Perspect., vol. 124, no. 6, pp. 805-812, 2016, doi: 10.1289/ehp.1510037.

[5] U. Satish et al., "Is CO2 an indoor pollutant? Direct effects of low-to-moderate CO2 concentrations on human decision-making performance," Environ. Health Perspect., vol. 120, no. 12, pp. 1671-1677, 2012, doi: 10.1289/ehp.1104789.

[6] O. Seppänen, W. J. Fisk, and Q. H. Lei, "Effect of temperature on task performance in office environment," Lawrence Berkeley National Laboratory, Rep. LBNL-60946, Jul. 2006.

[7] Light and lighting - Lighting of work places - Part 1: Indoor work places, EN 12464-1:2021.

[8] A. U. Viola, L. M. James, L. J. Schlangen, and D. J. Dijk, "Blue-enriched white light in the workplace improves self-reported alertness, performance and sleep quality," Scand. J. Work Environ. Health, vol. 34, no. 4, pp. 297-306, 2008, doi: 10.5271/sjweh.1268.

[9] A.-M. Chang, D. Aeschbach, J. F. Duffy, and C. A. Czeisler, "Evening use of light-emitting eReaders negatively affects sleep, circadian timing, and next-morning alertness," Proc. Natl. Acad. Sci. USA, vol. 112, no. 4, pp. 1232-1237, 2015, doi: 10.1073/pnas.1418490112.

[10] Energy Standard for Buildings Except Low-Rise Residential Buildings, ANSI/ASHRAE/IES Standard 90.1-2019, 2019.

[11] Sensirion AG, "SCD4x: Breaking the size barrier in optical CO2 sensing," datasheet, ver. 1.7, Apr. 2025.

[12] A. A. Abusharha and E. I. Pearce, "The effect of low humidity on the human tear film," Cornea, vol. 32, no. 4, pp. 429-434, 2013, doi: 10.1097/ICO.0b013e31826671ab.

[13] IEEE Recommended Practices for Modulating Current in High-Brightness LEDs for Mitigating Health Risks to Viewers, IEEE Std 1789-2015, 2015.

[14] Real Time Engineers Ltd., "Mutexes," FreeRTOS Documentation. [Online]. Available: https://www.freertos.org/Real-time-embedded-RTOS-mutexes.html

[15] Espressif Systems, "Analog to Digital Converter (ADC) Oneshot Mode Driver," ESP-IDF Programming Guide. [Online]. Available: https://docs.espressif.com/projects/esp-idf/en/stable/esp32/api-reference/peripherals/adc_oneshot.html

[16] Ventilation for Acceptable Indoor Air Quality, ANSI/ASHRAE Standard 62.1-2022, American Society of Heating, Refrigerating and Air-Conditioning Engineers, Atlanta, GA, USA, 2022.

[17] Espressif Systems, "ESP32 Series Datasheet," ver. 5.3.

[18] Espressif Systems, "ESP32-WROOM-32E & ESP32-WROOM-32UE Datasheet."

[19] Hanwei Electronics Co., Ltd., "MQ-135 Semiconductor Sensor for Air Quality," datasheet, 2015.

[20] Zhengzhou Winsen Electronics Technology Co., Ltd., "MH-Z19B NDIR CO2 Sensor Module User's Manual," ver. 1.4, 2020.

[21] Sensirion AG, "SCD30 Sensor Module for HVAC and Indoor Air Quality Applications," datasheet, ver. 1.0, 2020.

[22] Alpha & Omega Semiconductor, "AO3400A: 30V N-channel MOSFET," datasheet, rev. 5.0, Dec. 2020.

[23] Vishay General Semiconductor, "1N4001 thru 1N4007 General Purpose Plastic Rectifier," datasheet, rev. 1.8, Feb. 2018.

[24] Shenzhen Hi-Link Electronic Co., Ltd., "HLK-LD2410 Human Presence Sensing Module User Manual," ver. 1.02, Jun. 2022. [Online]. Available: https://www.hlktech.net/index.php?cate=cate-63fdaeb91b37b&id=download-center&pageid=2

[25] Solomon Systech Ltd., "SSD1306: 128 x 64 Dot Matrix OLED/PLED Segment/Common Driver with Controller," rev. 1.1, Apr. 2008. [Online]. Available: https://www.solomon-systech.com/product/SSD1306

[26] TDK Corp., "Piezoelectronic Buzzers: PS Series," Feb. 2022. [Online]. Available: https://product.tdk.com/info/en/catalog/datasheets/piezoelectronic_buzzer_ps_en.pdf

[27] OMRON Corp., "B3F Tactile Switch," cat. no. A070-E1. [Online]. Available: https://components.omron.com/us-en/datasheet_pdf/A070-E1.pdf

[28] ROHM Semiconductor, "BH1750FVI: Digital 16-bit serial output type ambient light sensor IC," datasheet.

[29] International Rectifier, "IRLZ44N HEXFET Power MOSFET," datasheet.

[30] Wokwi, "wokwi-photoresistor-sensor Reference." [Online]. Available: https://docs.wokwi.com/parts/wokwi-photoresistor-sensor

[31] Texas Instruments, "LM2596 SIMPLE SWITCHER Power Converter 150-kHz 3-A Step-Down Voltage Regulator," datasheet.

[32] Espressif Systems, "ESP32-DevKitC V4 Schematic."

[33] Espressif Systems, "LED Control (LEDC)," ESP-IDF Programming Guide. [Online]. Available: https://docs.espressif.com/projects/esp-idf/en/stable/esp32/api-reference/peripherals/ledc.html

[34] Espressif Systems, "Wi-Fi Driver," ESP-IDF Programming Guide. [Online]. Available: https://docs.espressif.com/projects/esp-idf/en/stable/esp32/api-guides/wifi.html

[35] C. L. Liu and J. W. Layland, "Scheduling algorithms for multiprogramming in a hard-real-time environment," J. ACM, vol. 20, no. 1, pp. 46-61, Jan. 1973, doi: 10.1145/321738.321743.

[36] OASIS, "MQTT Version 3.1.1," OASIS Standard, Oct. 2014. [Online]. Available: https://docs.oasis-open.org/mqtt/mqtt/v3.1.1/mqtt-v3.1.1.html

[37] Espressif Systems, "System Time," ESP-IDF Programming Guide. [Online]. Available: https://docs.espressif.com/projects/esp-idf/en/stable/esp32/api-reference/system/system_time.html

[38] Wokwi, "Wokwi for CI and GitHub Actions," Wokwi Docs. [Online]. Available: https://docs.wokwi.com/wokwi-ci/getting-started

## 10.2 Appendix A: Datasheets (ภาคผนวก ก: Datasheet)

datasheet ของอุปกรณ์ทุกตัวเก็บไว้ในคลังโค้ดของโครงงาน โฟลเดอร์ 03_hardware/datasheets ตามตารางที่ 10.1 แถบ LED และพัดลมดูดอากาศระบุเป็นสเปกขั้นต่ำแทน เพราะเป็นอุปกรณ์ทั่วไปที่ไม่ผูกกับยี่ห้อ

ตารางที่ 10.1 รายการ datasheet ในภาคผนวก

อุปกรณ์ | ไฟล์
ESP32 (ชิป) | ESP32_series_datasheet_v5.3.pdf
ESP32-WROOM-32E (โมดูล) | ESP32-WROOM-32E_datasheet.pdf
ESP32-DevKitC V4 (บอร์ด) | ESP32-DevKitC-V4_schematic.pdf
LM2596 (ลดแรงดัน 12 V เป็น 5 V) | LM2596_datasheet.pdf
HLK-LD2410 (เรดาร์ตรวจคน) | HLK-LD2410_user_manual_v1.02.pdf
SSD1306 (จอ OLED) | SSD1306_datasheet_rev1.1.pdf
TDK PS1240P02BT (buzzer) | TDK_PS1240P02BT_datasheet.pdf
OMRON B3F (ปุ่มกด) | OMRON_B3F_datasheet.pdf
BH1750FVI (เซนเซอร์แสง) | BH1750FVI_datasheet.pdf
Sensirion SCD41 (เซนเซอร์อากาศ) | Sensirion_SCD41_Datasheet.pdf
AO3400A (MOSFET) | AO3400A_datasheet.pdf
1N4007 (ไดโอด) | 1N4007_Datasheet.pdf
IRLZ44N (MOSFET ที่ใช้เปรียบเทียบ) | IRLZ44N_datasheet.pdf

## 10.3 Appendix B: Libraries (ภาคผนวก ข: ไลบรารีที่ใช้)

ตารางที่ 10.2 ไลบรารีและเครื่องมือที่ใช้ในโค้ด

ไลบรารี / เครื่องมือ | ใช้ในโหนด | หน้าที่
Arduino-ESP32 core 3.0.7 (รวม FreeRTOS) | ทั้งสองโหนด | แกนหลักของโปรแกรม task, queue, mutex, Wi-Fi, SNTP และ LEDC
PubSubClient | ทั้งสองโหนด | MQTT client
ArduinoJson | ทั้งสองโหนด | สร้างและอ่านข้อความ JSON
Adafruit SSD1306 และ Adafruit GFX Library | โต๊ะ | วาดข้อความและไอคอนบนจอ OLED
DHT sensor library และ Adafruit Unified Sensor | ห้อง (เฉพาะการจำลอง) | อ่าน DHT22 ที่ใช้แทนอุณหภูมิและความชื้นของ SCD41
Wokwi CLI 0.28.1 | การทดสอบ | รันการจำลองและชุดทดสอบอัตโนมัติ

## 10.4 Appendix C: Code Repository Link (ภาคผนวก ค: ลิงก์คลังโค้ด)

คลังโค้ดและเอกสารของโครงงาน: https://github.com/AnMayVaa/smart-workstation-env-regulator

โปรเจค Wokwi โหนดห้อง: https://wokwi.com/projects/477874423842942977

โปรเจค Wokwi โหนดโต๊ะ: https://wokwi.com/projects/477874597473570817

ตารางที่ 10.3 ตำแหน่งไฟล์สำคัญในคลังโค้ด

โฟลเดอร์ / ไฟล์ | เนื้อหา
08_code/desk_node | โค้ดและวงจร Wokwi ของโหนดโต๊ะ
08_code/desk_node_2 | โหนดโต๊ะตัวที่ 2 สำหรับทดสอบการเพิ่มโต๊ะ
08_code/room_node | โค้ดและวงจร Wokwi ของโหนดห้อง
08_code/ci | สคริปต์ทดสอบอัตโนมัติด้วย Wokwi CLI
06_testing/A5_results.md | ผลการทดสอบทั้งหมด
06_testing/evidence | หลักฐานการทดสอบ ได้แก่ log ภาพหน้าจอ สัญญาณจาก logic analyzer และวิดีโอสถานการณ์ใช้งาน
01_requirements, 02_interface, 03_hardware, 04_logic | ความต้องการ ตารางข้อมูลกลาง การออกแบบฮาร์ดแวร์ และ logic ของแต่ละโมดูล
