AnMayVaa/smart-workstation-env-regulator/10_final/README.md

# 10_final เล่มรายงานฉบับรวม (D5)

| รายการ | ค่า |
|---|---|
| ไฟล์ | `D5_design_document.docx` |
| สถานะ | ฉบับก่อนส่ง (pre-final) รอทีมตรวจ |
| วันที่ | 2026-10-15 (รอบ 3) |
| เจ้าของ | D |

## เล่มนี้คืออะไร

เล่มรายงานการออกแบบที่รวมเนื้อหาของทุกคนจาก `09_doc_sections/` และไฟล์งานของแต่ละบทบาท จัดเป็นรูปแบบเดียวกันครบทั้ง 10 บท

- เลขอ้างอิง IEEE เรียงใหม่ทั้งเล่มตามลำดับที่ปรากฏ (38 รายการ) เลขจึงไม่ตรงกับเลขในไฟล์ของแต่ละคน
- ในเล่มเรียกแต่ละส่วนด้วยชื่อโมดูล (โมดูลตรวจคนและเตือนพัก, โมดูลแสง, โมดูลอากาศ, ส่วนรวมระบบ)
- ในโมดูลแสงใช้ L แทนความสว่างรวม (ใน D3 ชื่อ B)
- ผลทดสอบใช้ `06_testing/A5_results.md`

## วิธีเปิด

เปิดด้วย Microsoft Word ที่มีฟอนต์ TH Sarabun New ถ้า Word ถามเรื่องอัปเดต field ให้กด Yes เพื่อให้สารบัญขึ้น (หรือคลิกขวาที่สารบัญแล้วเลือก Update Field)

## สิ่งที่แก้ในรอบนี้

- ใส่ผลรันต่อเนื่อง วิดีโอสถานการณ์ใช้งาน และนั่งจริง 20 นาทีจาก `A5_results.md` ข้อ 7 (หัวข้อ 1.3, 5.3, 6.3, 7.2, 8.2) และลิงก์ Wokwi (10.4)
- แก้ตาม `B5_prefinal_review.md`: รหัส TC-B-01/02 ในตาราง 7.2 ตรงกับแผนทดสอบแล้ว และคิด U แยกตามแกน (5.3, 6.3)
- ใส่ผล TC-A-05, TC-A-08 และ TC-B-02 ที่ยืนยันแล้ว (7.2, 8.2) และกติกาที่ B ยืนยันใน B2 v1.4 (5.1.1, 5.2.1)

## สิ่งที่ยังรอ

- ทุกคนตรวจบทของตัวเองตามตารางด้านล่าง
- ป้าย "ฉบับร่าง" บนปกจะเอาออกตอนทำฉบับส่งจริง

## ขอให้ทุกคนตรวจ

อ่านบทที่เกี่ยวกับส่วนของตัวเอง ถ้าเจอข้อมูลผิดหรืออยากแก้ ให้เปิด Issue ระบุ **หัวข้อ** (เช่น 4.2.1) และ **ข้อความที่ต้องแก้** อย่าแก้ไฟล์ .docx นี้โดยตรง D จะแก้จากต้นฉบับแล้วสร้างไฟล์ใหม่ให้ทั้งเล่มยังเป็นรูปแบบเดียวกัน

| บท | ส่วนที่แต่ละคนควรตรวจ |
|---|---|
| 1 และ 2 | ทุกคน (1.2 ตารางบทบาท) |
| 3 | A (3.3), C (3.4) |
| 4 | A (4.1, 4.3), B (4.2.2), C (4.2.1) |
| 5 | A (5.4), B (5.1.1, 5.2.1, 5.3), C (5.1.2, 5.2.2) |
| 6 | B (6.3), ทุกคน (6.2) |
| 7 | A (7.2, 7.3), C (7.1) |
| 8 ถึง 10 | ทุกคน |

## ผลตรวจจาก B

B ตรวจหัวข้อ 4.2.2, 5.1.1, 5.2.1, 5.3, 6.3 และตาราง TC-B แล้ว รายละเอียดและข้อความที่ต้องแก้ก่อนสร้างเล่มรอบถัดไปอยู่ใน `B5_prefinal_review.md`
