AnMayVaa/smart-workstation-env-regulator/08_code/desk_node_2/README.md

# desk_node_2 — โต๊ะตัวที่ 2 (DESK_ID = 2)

ใช้ทดสอบ TC-A-06 (เพิ่มโต๊ะโดยไม่แก้โค้ดโหนดห้อง, NFR-13)
โค้ดเหมือน `../desk_node/` ทุกบรรทัด ต่างกันแค่คอมไพล์ด้วย `DESK_ID 2` · วงจรเหมือนโต๊ะตัวที่ 1
