AnMayVaa/smart-workstation-env-regulator/00_team_guide/00_overview.md

# ภาพรวมโปรเจค: Smart Workstation Environmental Regulator

> **ไฟล์นี้ใช้คุมทิศทางของทั้งทีม**
> สมาชิกทุกคนควรอ่านไฟล์นี้ก่อนไฟล์บทบาทของตัวเอง
> ไฟล์บทบาท: `role_A_integration.md`, `role_B_presence_tasks.md`, `role_C_air_visual_test.md`, `role_D_pm_light.md`
>
> ผู้ดูแลไฟล์: D (PM) | อัปเดตล่าสุด: 2026-10-14

---

## 1. โปรเจคนี้คืออะไร (อ่าน 1 นาที)

- **วิชา:** 010123119 Embedded System Design, งานกลุ่ม 4 คน
- **สิ่งที่ส่ง:** เอกสารออกแบบ (Design Document) อย่างเดียว ไม่ต้องสร้างเครื่องจริง แต่ต้องเขียนให้เหมือนจะสร้างจริง คือระบุว่าใช้อุปกรณ์อะไร ต่อกันยังไง ทำงานยังไง และ **ต้องให้เหตุผลทุกการเลือก**
- **แกนของโปรเจค:** ระบบลดความล้าและรักษาความตื่นตัวของคนที่ทำงานหน้าคอมนานๆ
- **กฎคัดฟีเจอร์:** ทุกฟีเจอร์ต้องตอบได้ว่าแก้สาเหตุความล้าข้อไหน และต้องมีงานวิจัยหรือมาตรฐานรองรับ ถ้าตอบไม่ได้ ไม่ใส่

### เกณฑ์คะแนนจาก Instruction

| เกณฑ์ | น้ำหนัก |
|---|---|
| ความครบถ้วนของเอกสาร (Completeness) | 30% |
| ความใหม่และความตรงกับปัญหา (Innovation & Problem Relevance) | 20% |
| ทำได้จริงทางเทคนิค (Technical Feasibility) | 20% |
| คุณภาพเอกสาร (Documentation Quality) | 15% |
| การทำงานเป็นทีม (Team Collaboration) | 15% |

### ข้อบังคับจาก Instruction ที่ต้องทำตาม

- สมาชิก **ทุกคนต้องมีส่วนทั้งการออกแบบฮาร์ดแวร์และซอฟต์แวร์** และต้องระบุบทบาทให้ชัดในเอกสาร
- ต้องเน้นเรื่องเวลาจริง (real-time) การจัดการพลังงาน และการใช้ทรัพยากรให้คุ้ม
- การจำลองในโปรแกรม (Tinkercad, Proteus ฯลฯ) เป็นทางเลือก ไม่บังคับ ทีมเราเลือกใช้ **Wokwi** เพราะ Tinkercad ไม่มี ESP32

---

## 2. โมดูลที่เอาและไม่เอา

| # | โมดูล | แก้ปัญหาอะไร | อยู่ที่ | สถานะ | หลักฐานรองรับ |
|---|---|---|---|---|---|
| 1 | ตรวจจับคนนั่ง | เป็นฐานให้โมดูลอื่น และปิดไฟเองเมื่อไม่มีคนเพื่อประหยัดพลังงาน | โต๊ะ | ✅ เอา | ตอบ guideline เรื่อง power management |
| 2 | เฝ้าระวังคุณภาพอากาศ (CO₂) | CO₂ สะสมทำให้ง่วงและคิดช้า เกินเกณฑ์แล้วเตือนและสั่งพัดลมดูดอากาศ | ห้อง | ✅ เอา | [1], [2] |
| 3 | รักษาความสว่างคงที่ | แสงไม่พอหรือไม่คงที่ทำให้ตาล้า | โต๊ะ | ✅ เอา | [3] |
| 4 | ปรับสีแสงตามช่วงเวลา | กลางวันใช้แสงขาวอมฟ้าช่วยให้ตื่นตัว ตอนเย็นใช้แสงอุ่น | โต๊ะ | ✅ เอา | [4] |
| 5 | เตือนพัก 2 ระดับ (จุดขาย) | ทุก 20 นาทีเตือนพักสายตา ทุก 30 นาทีเตือนลุกยืดเส้น | โต๊ะ | ✅ เอา | [7], [8] |
| 6 | แจ้งเตือนอุณหภูมิ | อุณหภูมิไม่เหมาะทำให้ทำงานแย่ลง ระบบเตือนอย่างเดียว ไม่คุมแอร์ | ห้อง | ✅ เอา | [5] |
| 7 | วัดความชื้น | ความชื้นต่ำทำให้ตาแห้ง | ห้อง | ⚪ แสดงค่าอย่างเดียว | [6] (ห้องแอร์ในไทยชื้นอยู่แล้ว จึงไม่นับเป็นฟีเจอร์หลัก) |
| — | เสียงรบกวน, ท่านั่ง, แสงจ้าจากจอ | — | — | ❌ ไม่เอา | ต้องใช้เซนเซอร์หรือกล้องที่ซับซ้อนเกินขอบเขต หรือระบบแก้ต้นเหตุเองไม่ได้ |

**จุดขายหลัก:** งานวิจัย [7] พบว่าการเตือนให้พักสายตาช่วยลดอาการตาล้าได้ **แต่พอเลิกเตือน ผลก็หายไปภายใน 1 สัปดาห์** แปลว่าต้องมีอุปกรณ์ที่เตือนอัตโนมัติอย่างต่อเนื่อง ไม่ใช่ปล่อยให้ผู้ใช้จำเอง

---

## 3. โครงสร้างระบบ (Architecture)

```
   ┌───────────── โหนดโต๊ะ (หนึ่งคนหนึ่งตัว) ─────────────┐        ┌──────── โหนดห้อง (หนึ่งห้องหนึ่งตัว) ────────┐
   │ ตรวจจับคนนั่ง · คุมความสว่างและสีแสง · เตือนพัก   │        │ วัด CO₂/อุณหภูมิ/ความชื้น · คุมพัดลมดูดอากาศ │
   └──────────────────────┬──────────────────────────────┘        └──────────────────────┬───────────────────────┘
                          │                  Wi-Fi router                                 │
                          └──────────────────────┬────────────────────────────────────────┘
                                                 │
                              NTP server (ให้เวลาจริง)   ·   Cloud dashboard (งานต่อยอดในอนาคต)
```

- **โหนดโต๊ะ** ดูแลเรื่องเฉพาะตัวคน ได้แก่ แสง การตรวจจับคน และการเตือนพัก
- **โหนดห้อง** ดูแลเรื่องที่ทุกคนในห้องใช้ร่วมกัน ได้แก่ อากาศและพัดลม
- **การสื่อสาร:** สองโหนดคุยกันผ่าน Wi-Fi ถ้ามีหลายโต๊ะ ก็เพิ่มโหนดโต๊ะได้เรื่อยๆ
- **ประมวลผลที่ไหน:** การควบคุมทั้งหมดคิดในตัวโหนดเอง ถ้าเน็ตล่ม ไฟ พัดลม และการเตือนพักยังทำงานต่อได้ (บท 24 หน้า 18–20)

### อุปกรณ์ที่แนะนำ (เจ้าของโมดูลตัดสินใจขั้นสุดท้ายได้ แต่ต้องมีเหตุผล)

| โหนด | อุปกรณ์ | ต่อกับ ESP32 ทาง | ในโปรแกรมจำลอง (Wokwi) ใช้ | เจ้าของ |
|---|---|---|---|---|
| ทั้งสอง | ESP32 + adapter 12V (แปลงลงเป็น 5V/3.3V) | — | ESP32 | A |
| โต๊ะ | เซนเซอร์ตรวจจับคน mmWave LD2410 | UART | PIR | B |
| โต๊ะ | จอ OLED SSD1306 | I²C | SSD1306 | B |
| โต๊ะ | Buzzer, ปุ่มกด | GPIO (ปุ่มใช้ interrupt) | Buzzer, pushbutton | B |
| โต๊ะ | เซนเซอร์แสง BH1750 | I²C | Photoresistor (ตั้งค่า lux ได้) | D |
| โต๊ะ | LED ขาวเย็น + ขาวอุ่น 12V + MOSFET | PWM | LED / RGB LED | D |
| ห้อง | เซนเซอร์ CO₂ + อุณหภูมิ + ความชื้น SCD41 | I²C | Potentiometer (แทน CO₂) + DHT22 | C |
| ห้อง | พัดลมดูดอากาศ DC 12V + MOSFET + flyback diode | PWM | LED หรือ relay แทนพัดลม | C |
| ห้อง | ไฟสถานะ RGB (เขียว/เหลือง/แดง) | GPIO/PWM | RGB LED | C |

---

## 4. ค่าเกณฑ์เริ่มต้น (D จะยืนยันใน D1)

> ⚠️ **ตารางนี้เป็นร่างเดิม ยืนยันแล้วใน D1** ให้ใช้ค่าจาก `01_requirements/D1_requirements.md` ข้อ 6 (เช่น อุณหภูมิเตือนต่ำกว่า 20°C หรือสูงกว่า 26°C, คาบ PWM ของ LED 0.2 ms ที่ 5 kHz)

ตัวเลขที่ใช้ในระบบต้องมีที่มาทุกตัว ห้ามตั้งขึ้นลอยๆ

| ค่า | ค่าเริ่มต้น | ที่มา |
|---|---|---|
| CO₂ เริ่มเตือนและเปิดพัดลม | 1000 ppm | [2] ที่ 1000 ppm คะแนนการตัดสินใจลดลง 6 จาก 9 ด้าน |
| CO₂ ปิดพัดลม (ต้องต่ำกว่าค่าเปิด กันพัดลมเปิดปิดถี่) | 800 ppm (ร่าง) | ต้องให้เหตุผลเรื่อง hysteresis |
| ความสว่างเป้าหมายบนโต๊ะ | 500 lux | [3] มาตรฐานงานพิมพ์ อ่าน และใช้คอม |
| สีแสงกลางวัน / เย็น | ขาวอมฟ้า / ขาวอุ่น | [4] |
| อุณหภูมิที่ทำงานได้ดีที่สุด | 21–22°C | [5] |
| เตือนพักสายตา | ทุก 20 นาที | [7] กฎ 20-20-20 |
| เตือนลุกยืดเส้น | ทุก 30 นาที | [8] ลุกเดิน 3 นาทีทุก 30 นาทีช่วยลดความล้า |
| ไม่มีคนนานเท่าไรถึงปิดไฟและเข้า sleep | 5 นาที (ร่าง) | ต้องให้เหตุผล |
| คาบ PWM ของ LED / พัดลม | 1–5 ms / 5–20 ms | บท 13 หน้า 95 |

---

## 5. ตารางข้อมูลกลาง (ร่าง — A จะยืนยันใน A1)

> ⚠️ **ตารางนี้ล้าสมัยแล้ว** ให้ใช้ `02_interface/A1_interface.md` **v1.0** แทน (มีข้อมูลเพิ่ม เช่น `away_timeout`, `user_lux_target`, `late_mode`, `time_valid`, `link_ok`, `room_desks_online` และโครงสร้าง `air_status_t`, `alert_request_t`)

**ตารางนี้คือ "สัญญา" ระหว่างโมดูล** บอกว่าแต่ละโมดูลส่งข้อมูลอะไรออก และรับอะไรเข้า เมื่อตกลงกันแล้ว แต่ละคนออกแบบข้างในโมดูลของตัวเองได้อิสระ **ห้ามเปลี่ยนตารางนี้เองโดยไม่บอก A**

| ข้อมูล | ความหมาย | ชนิด | ใครสร้าง | ใครใช้ | อัปเดตบ่อยแค่ไหน |
|---|---|---|---|---|---|
| `occupied` | ตอนนี้มีคนนั่งไหม | จริง/เท็จ | B | D (ปิดไฟ), A (ส่งต่อให้ห้อง) | เมื่อเปลี่ยน |
| `sit_minutes` | นั่งต่อเนื่องมากี่นาทีแล้ว | ตัวเลข | B | B (จอ/เตือน) | ทุก 1 วินาที |
| `time_of_day` | เวลาจริงตอนนี้ | ชั่วโมง:นาที | A (ดึงจาก NTP) | D (เลือกสีแสง) | ทุก 1 นาที |
| `lux_now` | ความสว่างบนโต๊ะตอนนี้ | ตัวเลข (lux) | D | D | ทุก 200 ms |
| `air_status` | CO₂ (ppm), อุณหภูมิ (°C), ความชื้น (%), ระดับเตือน (0 ดี / 1 เริ่มแย่ / 2 แย่) | ชุดข้อมูล | C | A ส่งข้าม Wi-Fi ให้ B (แสดงบนจอโต๊ะและเตือน) | ทุก 5 วินาที |
| `room_occupied_count` | ในห้องมีโต๊ะที่มีคนนั่งกี่โต๊ะ | ตัวเลข | A (รวมจากทุกโต๊ะ) | C (ลดหรือปิดพัดลมเมื่อห้องว่าง) | ทุก 5 วินาที |
| `alert_request` | ขอให้จอหรือ buzzer เตือนเรื่องใดเรื่องหนึ่ง | ข้อความเตือน | ทุกโมดูลส่งได้ | B (เป็นเจ้าของจอและ buzzer) | เมื่อมีเหตุ |
| `i2c_lock` | ตัวล็อกไม่ให้ 2 งานใช้สาย I²C พร้อมกัน | mutex | A กำหนดวิธีใช้ | B (OLED), C (SCD41), D (BH1750) | ทุกครั้งที่ใช้ I²C |

---

## 6. งานย่อยในโปรแกรม (ร่าง — B จะยืนยันใน B3)

โปรแกรมใน ESP32 ไม่ได้ทำงานทีละอย่าง แต่แบ่งเป็น **งานย่อย (task)** หลายงานที่วนทำไปพร้อมๆ กัน ระบบจัดการงานพวกนี้ด้วย RTOS (FreeRTOS ที่มากับ ESP32) ตามหลัก RMS ในบทที่ 17 **งานที่ทำถี่กว่าจะสำคัญกว่าและได้ทำก่อน**

| โหนด | งานย่อย | ทำอะไร | ทำทุก | เจ้าของ |
|---|---|---|---|---|
| โต๊ะ | ตรวจคน | อ่านเซนเซอร์ตรวจจับคน | 100 ms | B |
| โต๊ะ | คุมแสง | อ่าน lux แล้วปรับ PWM | 200 ms | D |
| โต๊ะ | อัปเดตจอ | วาดหน้าจอ OLED และจัดการ buzzer | 500 ms | B |
| โต๊ะ | นับเวลาพัก | นับเวลานั่งและตัดสินใจเตือน | 1 วินาที | B |
| โต๊ะ | สื่อสาร | รับส่งข้อมูลกับโหนดห้อง | 5 วินาที | A |
| โต๊ะ | ซิงก์เวลา | ดึงเวลาจาก NTP | 1 ชั่วโมง | A |
| ห้อง | อ่านอากาศ | อ่าน SCD41 | 5 วินาที | C |
| ห้อง | คุมพัดลม | ตัดสินใจเปิด/ปิด/ปรับความแรงพัดลม | 5 วินาที | C |
| ห้อง | สื่อสาร | รับส่งข้อมูลกับโหนดโต๊ะ | 5 วินาที | A |

---

## 7. บทบาทของแต่ละคน

ทุกบทบาทมีทั้งงานออกแบบฮาร์ดแวร์และซอฟต์แวร์ คำว่า "ออกแบบซอฟต์แวร์" ในงานนี้ **หมายถึงการคิด logic (แผนภาพสถานะ + pseudocode) ไม่ได้หมายถึงการเขียนโค้ดเต็ม** โค้ดจริงมี A เขียนคนเดียวเพื่อใช้จำลอง

| บทบาท | ออกแบบฮาร์ดแวร์ | ออกแบบซอฟต์แวร์ | งานหลัก |
|---|---|---|---|
| **A: เชื่อมระบบและจำลอง** | บอร์ด ESP32 ทั้ง 2 ตัว, ระบบไฟเลี้ยง, ผังขา | การสื่อสารระหว่างโหนดผ่าน Wi-Fi | เขียนโค้ดจริงจาก logic ของทุกคน, ต่อวงจรใน Wokwi, รันทดสอบ, บันทึกผล |
| **B: คนและการเตือนพัก + ตารางงานย่อย** | เซนเซอร์คน, OLED, buzzer, ปุ่ม | logic ตรวจคน นับเวลา เตือนพัก | ทำตารางงานย่อยรวม และคำนวณว่า ESP32 ทำทันทุกงาน |
| **C: อากาศ + ภาพจำลอง + แผนทดสอบ** | เซนเซอร์อากาศ, พัดลม + วงจรขับ, ไฟสถานะ | logic อากาศ พัดลม และการรับมือเมื่อเซนเซอร์เสีย | ภาพอุปกรณ์ + ภาพติดตั้งในห้อง, รวม test case เป็นแผนทดสอบ |
| **D: PM + แสง + รวมเล่ม** | เซนเซอร์แสง, LED 2 สี + วงจรขับ | logic คุมความสว่างและสีแสง | requirement, คุมกำหนดการ, รวมเล่ม, บทคัดย่อ |

### ใครเขียนหัวข้อไหนในเอกสาร

| หัวข้อตาม Instruction | ต้องเขียนอะไร | ใครเขียน |
|---|---|---|
| 1. Project Overview | ชื่อ, สมาชิก, บทคัดย่อ, ปัญหาที่จะแก้ (พร้อมตัวเลขวิจัย), กลุ่มผู้ใช้ | D (ภาพอุปกรณ์จาก C) |
| 2. System Requirements | FR (ระบบต้องทำอะไร), NFR (ต้องทำได้ดีแค่ไหน) | D |
| | รายการอุปกรณ์และโปรแกรมที่ต้องใช้ | A |
| 3. System Architecture | ภาพรวมระบบและหน้าที่ของแต่ละโมดูล | D |
| | ส่วนต่างๆ ต่อกันยังไง (ตารางข้อมูลกลาง, ผังการต่อ) | A |
| | ภาพการติดตั้งในห้อง | C |
| 4. Hardware Design | บอร์ดและระบบไฟเลี้ยง | A |
| | อุปกรณ์ของแต่ละโมดูลพร้อมเหตุผล | B, C, D (คนละส่วน) |
| 5. Software Design | แผนภาพสถานะและ pseudocode ของแต่ละโมดูล | B, C, D (ของตัวเอง) |
| | ทำไมใช้ RTOS และแบ่งงานย่อยยังไง | B |
| | โปรโตคอลสื่อสาร | A |
| 6. Design Methodology | ขั้นตอนการออกแบบ และการเลือก A แทน B ได้อะไรเสียอะไร | D |
| | การทำงานพร้อมกันและเวลาตอบสนอง | B |
| 7. Testing & Validation | แผนทดสอบ | C |
| | ผลทดสอบ และวิธีหาสาเหตุเมื่อเจอปัญหา | A |
| 8. Challenges & Limitations | ปัญหาที่เจอ, สิ่งที่ทำไม่ได้, ข้อจำกัด | ทุกคนส่ง, D เรียบเรียง |
| 9. Future Improvements | ขยายระบบ, เพิ่มฟีเจอร์, ประหยัดพลังงาน | D |
| 10. References | datasheet, อ้างอิง IEEE, ลิงก์โค้ด | ทุกคนส่ง, D จัดรูปแบบ, A ใส่ลิงก์โค้ด |

---

## 8. Milestone รวม

**D เป็นคนกำหนดวันที่ของแต่ละ milestone** และอาจเปลี่ยนได้ ดูวันล่าสุดในกลุ่มแชทเสมอ

| Milestone | วันที่ (D เติม) | เป้าหมาย | ของที่ต้องครบก่อนผ่านด่าน | ปลดล็อกอะไร |
|---|---|---|---|---|
| **M1 ตั้งต้น** | ✅ 14 ต.ค. 2569 | ทุกคนรู้ว่าระบบต้องทำอะไร และส่วนต่างๆ ต่อกันยังไง | D1, A1 | ทุกคนเริ่มออกแบบโมดูลได้ |
| **M2 ออกแบบโมดูล** (ทำพร้อมกัน) | ✅ 14 ต.ค. 2569 | ทุกโมดูลมีอุปกรณ์และ logic ครบ | A2, A3, B1, B2, C1, C2, D2, D3 + ข้อมูลงานย่อย (X-T) และ test case (X-TC) ของทุกคน | A เขียนโค้ด, B ทำตารางงานย่อยรวม, C ทำแผนทดสอบ |
| **M3 รวมระบบ** | รอ D กำหนด | มีโค้ดและวงจรจำลองที่รวมทุกโมดูลแล้ว | A4, B3, C5 (+ C3, C4) | เริ่มทดสอบ |
| **M4 ทดสอบ** | รอ D กำหนด | รู้ว่าระบบทำงานตาม requirement หรือไม่ | A5 (ถ้าโมดูลไหนไม่ผ่าน เจ้าของแก้ logic แล้วส่งใหม่) | มีผลจริงให้เขียนหัวข้อ 7 |
| **M5 เขียนเอกสาร** | รอ D กำหนด | ทุกคนส่งเนื้อหาส่วนตัวเอง | A6, B4, C6, D4 + บันทึกปัญหาและอ้างอิง (X-N) ของทุกคน | D รวมเล่ม |
| **M6 รวมเล่มและส่ง** | รอ D กำหนด | เอกสารสมบูรณ์ ทุกคนตรวจแล้ว | D5 | ส่งงาน |

**เส้นทางวิกฤต (ช้าตรงไหน ทั้งโปรเจคช้าตาม):**
D1 + A1 → logic ของ B, C, D → A เขียนโค้ดและจำลอง → ผลทดสอบ → รวมเล่ม

จุดที่ต้องเฝ้ามากที่สุดคือ **logic ของทุกคนต้องถึงมือ A ตรงเวลา**

เนื้อหาเอกสารส่วนตัว (M5) ไม่ต้องรอให้จบ M4 เขียนไปพร้อมกับงานออกแบบตั้งแต่ M2 ได้เลย แล้วค่อยเติมผลทดสอบทีหลัง

---

## 9. รายการของที่ต้องส่งทั้งหมด

**ความสำคัญ:** 🔴 มีคนรอใช้ ส่งช้าแล้วคนอื่นทำงานต่อไม่ได้ · 🟡 มีคนต้องใช้แต่ใช้ทีหลัง · 🟢 ใช้แค่ตอนรวมเล่ม

**รหัสงานที่ทุกคนมีเหมือนกัน** (X = A, B, C หรือ D)
- **X-T:** ข้อมูลงานย่อยของโมดูลตัวเอง
- **X-TC:** test case ของโมดูลตัวเอง
- **X-N:** บันทึกปัญหาที่เจอ + แหล่งอ้างอิง

| รหัส | สิ่งที่ส่ง | ใครส่ง | ส่งให้ | M | สำคัญ | ไปลงเอกสารหัวข้อ |
|---|---|---|---|---|---|---|
| D1 | Requirement (FR/NFR) + ค่าเกณฑ์พร้อมที่มา | D | ทุกคน | M1 | 🔴 | 2 |
| A1 | ตารางข้อมูลกลาง (ฉบับยืนยัน) | A | ทุกคน | M1 | 🔴 | 3 |
| A2 | บอร์ด + ระบบไฟเลี้ยง + ผังขา | A | ทุกคน, D | M2 | 🔴 | 4 |
| A3 | วิธีสื่อสารระหว่างโหนด | A | B, D | M2 | 🔴 | 5 |
| B1 / C1 / D2 | อุปกรณ์ของโมดูล + เหตุผล + datasheet | B / C / D | A, D | M2 | 🔴 | 4 |
| B2 / C2 / D3 | Logic ของโมดูล (FSM + pseudocode) | B / C / D | A | M2 | 🔴 | 5 |
| X-T | ข้อมูลงานย่อยของโมดูล | A, C, D | B | M2 | 🔴 | 6 |
| X-TC | Test case 2–3 ข้อ | ทุกคน | C | M2 | 🟡 | 7 |
| A4 | โค้ดจริง + วงจรใน Wokwi | A | (ใช้เอง) | M3 | 🔴 | 7, 10 |
| B3 | ตารางงานย่อยรวม + คำนวณว่าทำทัน | B | A, D | M3 | 🔴 | 5, 6 |
| C3 | ภาพติดตั้งในห้อง + เหตุผลตำแหน่ง | C | D | M3 | 🟡 | 3, 4 |
| C4 | ภาพจำลองตัวอุปกรณ์ | C | D | M3 | 🟡 | 1 |
| C5 | แผนทดสอบรวม | C | A, D | M3 | 🔴 | 7 |
| A5 | ผลทดสอบ + บันทึกการหาสาเหตุ | A | C, D | M4 | 🟡 | 7 |
| A6 / B4 / C6 / D4 | เนื้อหาเอกสารส่วนตัว | ทุกคน | D | M5 | 🟢 | ตามตารางในข้อ 7 |
| X-N | ปัญหาที่เจอ + อ้างอิง | ทุกคน | D | M5 | 🟢 | 8, 10 |
| D5 | เล่มสมบูรณ์ | D | ทั้งทีมตรวจ แล้วส่งอาจารย์ | M6 | 🔴 | ทั้งเล่ม |

---

## 10. ใครรอใคร และระหว่างรอทำอะไรได้

| คน | รออะไรจากใคร | ถ้ายังไม่ได้ ให้ทวง | ระหว่างรอ ทำสิ่งนี้ไปก่อน |
|---|---|---|---|
| ทุกคน (ช่วง M1) | D1 จาก D, A1 จาก A | D, A | อ่านสไลด์บทที่เกี่ยวกับโมดูลตัวเอง และหาอุปกรณ์ที่น่าจะใช้ |
| A | B2, C2, D3 (logic) และ B3 (ตารางงานย่อย) | B, C, D | ทำ A2, ต่อวงจรเปล่าใน Wokwi, เขียนส่วนสื่อสาร |
| B | ข้อมูลงานย่อย (A-T, C-T, D-T) | A, C, D | ออกแบบโมดูลตัวเอง, อ่านบท 17, ร่างตารางโดยใส่งานย่อยของตัวเองก่อน |
| C | Test case จากทุกคน, รายการอุปกรณ์จากทุกคน (สำหรับ C4) | ทุกคน | ทำภาพติดตั้งในห้อง (C3) ก่อน, ร่างแบบฟอร์มแผนทดสอบ |
| D | เนื้อหาเอกสารจากทุกคน | ทุกคน | เขียนหัวข้อ 1, 2, 6, 8, 9 และเก็บแหล่งอ้างอิง |

---

## 11. วิธีส่งงาน

**ส่งที่ไหน:** โฟลเดอร์กลางของทีม (D ใส่ลิงก์: ____________ ) ใช้โครงโฟลเดอร์นี้

```
Embedded_Project/
├── 01_requirements/     ← D1
├── 02_interface/        ← A1
├── 03_hardware/         ← A2, B1, C1, D2
│   └── datasheets/      ← ไฟล์ datasheet ทุกตัว (PDF)
├── 04_logic/            ← B2, C2, D3
├── 05_tasks/            ← ข้อมูลงานย่อยของทุกคน (X-T), B3
├── 06_testing/          ← test case ของทุกคน (X-TC), C5, A5
├── 07_visuals/          ← C3, C4 และภาพ FSM ของทุกคน
├── 08_code/             ← A4 (หรือลิงก์ GitHub)
├── 09_doc_sections/     ← เนื้อหาเอกสารส่วนตัว (A6, B4, C6, D4), X-N
└── 10_final/            ← D5
```

**ตั้งชื่อไฟล์:** `รหัส_ชื่อสั้น_vเลข` เช่น `B2_logic_presence_v1.docx`, `C1_hardware_air_v2.docx`

**ส่งแล้วต้องทำ 2 อย่าง**
1. วางไฟล์ในโฟลเดอร์ที่ถูกต้อง
2. แจ้งในกลุ่มแชท เช่น "ส่ง B2 แล้ว @A" เพื่อให้คนที่รออยู่รู้ทันที

**ถ้าแก้งานที่ส่งแล้ว:** อย่าทับไฟล์เดิม ให้ขึ้นเลขเวอร์ชันใหม่ (v2, v3) แล้วแจ้งคนที่ใช้งานชิ้นนั้นด้วย

**ถ้าจะส่งช้า:** แจ้งคนที่รอและ D ก่อนถึงวันกำหนด อย่าเงียบ

---

## 12. กติกาการเขียน

1. **ภาษา:** ไทยแบบรายงาน อธิบายให้คนอ่านเข้าใจ ไม่ทางการจนอ่านยาก และไม่ใช้ภาษาพูด
2. **อ้างอิงสไลด์ของวิชาก่อนเสมอ** และระบุบทกับหน้า เช่น "(บท 13 หน้า 95)"
3. **ใช้ข้อมูลนอกสไลด์ได้** แต่ต้องอ้างแหล่งแบบ IEEE ทุกครั้ง
4. **ทุกตัวเลขต้องมีที่มา** เช่น 1000 ppm มาจากงานวิจัยไหน ถ้าตั้งเอง ต้องอธิบายเหตุผล
5. **ทุกการเลือกต้องมีเหตุผล** และควรบอกว่าเทียบกับตัวเลือกอื่นอะไรบ้าง ทำไมไม่เลือกตัวนั้น
6. **ห้ามเปลี่ยนของกลางเอง:** โมดูล, ค่าเกณฑ์ (ของ D) และตารางข้อมูลกลาง (ของ A) ถ้าต้องเปลี่ยน แจ้งเจ้าของก่อน
7. **ภาพ FSM และ diagram** วาดด้วย draw.io (diagrams.net) แล้ว export เป็น PNG

---

## 13. วิธีทำงานในไฟล์บทบาท

1. อ่านไฟล์บทบาทของตัวเองคู่กับไฟล์นี้เสมอ
2. **ห้ามเปลี่ยนขอบเขต** (โมดูลในข้อ 2), ค่าเกณฑ์ (ข้อ 4) และตารางข้อมูลกลาง (ข้อ 5) เอง ถ้าเห็นว่าควรเปลี่ยน ให้คุยกับเจ้าของ (D หรือ A) ก่อน
3. อ้างอิงสไลด์ของวิชา (010123119) ก่อนเสมอ ถ้าใช้ข้อมูลนอกสไลด์ ต้องระบุว่าเป็นแหล่งภายนอกและอ้างอิงแบบ IEEE
4. เขียนให้คนที่ไม่เคยเรียนเรื่องนั้นอ่านเข้าใจ
5. ทำงานตาม **แบบฟอร์ม** ในไฟล์บทบาท และตรวจ **"เช็คก่อนส่ง"** ทุกข้อก่อนแจ้งว่างานพร้อมส่ง
6. ทำงาน 🔴 ก่อน เพราะมีคนรอ
7. งานนี้เป็นเอกสารออกแบบ ไม่ต้องเขียนโค้ดเต็ม (ยกเว้นบทบาท A) บทบาทอื่นส่ง logic, FSM และ pseudocode
8. ถ้าติดเพราะรองานจากคนอื่น ทำส่วนที่ทำก่อนได้ตามตารางในข้อ 10

---

## 14. แหล่งอ้างอิงหลักที่ทีมมีแล้ว

[1] J. G. Allen et al., "Associations of cognitive function scores with carbon dioxide, ventilation, and volatile organic compound exposures in office workers," *Environ. Health Perspect.*, vol. 124, no. 6, pp. 805–812, 2016, doi: 10.1289/ehp.1510037.
[2] U. Satish et al., "Is CO2 an indoor pollutant? Direct effects of low-to-moderate CO2 concentrations on human decision-making performance," *Environ. Health Perspect.*, vol. 120, no. 12, pp. 1671–1677, 2012, doi: 10.1289/ehp.1104789.
[3] *Light and lighting – Lighting of work places – Part 1: Indoor work places*, EN 12464-1:2021.
[4] A. U. Viola, L. M. James, L. J. Schlangen, and D. J. Dijk, "Blue-enriched white light in the workplace improves self-reported alertness, performance and sleep quality," *Scand. J. Work Environ. Health*, vol. 34, no. 4, pp. 297–306, 2008, doi: 10.5271/sjweh.1268.
[5] O. Seppänen, W. J. Fisk, and Q. H. Lei, "Effect of temperature on task performance in office environment," Lawrence Berkeley National Laboratory, Rep. LBNL-60946, Jul. 2006.
[6] A. A. Abusharha and E. I. Pearce, "The effect of low humidity on the human tear film," *Cornea*, vol. 32, no. 4, pp. 429–434, 2013, doi: 10.1097/ICO.0b013e31826671ab.
[7] C. Talens-Estarelles et al., "The effects of breaks on digital eye strain, dry eye and binocular vision: Testing the 20-20-20 rule," *Cont. Lens Anterior Eye*, 2022, Art. no. 101744, doi: 10.1016/j.clae.2022.101744.
[8] P. Wennberg et al., "Acute effects of breaking up prolonged sitting on fatigue and cognition: A pilot study," *BMJ Open*, vol. 6, no. 2, Art. no. e009630, 2016.

[9] A. L. Sheppard and J. S. Wolffsohn, "Digital eye strain: Prevalence, measurement and amelioration," *BMJ Open Ophthalmol.*, vol. 3, no. 1, Art. no. e000146, 2018, doi: 10.1136/bmjophth-2018-000146.
[10] A.-M. Chang, D. Aeschbach, J. F. Duffy, and C. A. Czeisler, "Evening use of light-emitting eReaders negatively affects sleep, circadian timing, and next-morning alertness," *Proc. Natl. Acad. Sci. USA*, vol. 112, no. 4, pp. 1232–1237, 2015, doi: 10.1073/pnas.1418490112.
[11] *IEEE Recommended Practices for Modulating Current in High-Brightness LEDs for Mitigating Health Risks to Viewers*, IEEE Std 1789-2015, 2015.
[12] *Energy Standard for Buildings Except Low-Rise Residential Buildings*, ANSI/ASHRAE/IES Standard 90.1-2019, 2019.
[13] Sensirion, "SCD4x: Breaking the size barrier in CO2 sensing," datasheet.

รายการเต็มและเลขล่าสุดอยู่ใน `01_requirements/D1_requirements.md` ข้อ 7 · เลขทั้งเล่มจะจัดใหม่ตอนรวมเล่ม
ตรวจเลขรายงาน [5] และเลขหน้า [6] แล้ว (2026-10-14)
