AnMayVaa/smart-workstation-env-regulator/01_requirements/D1_requirements.md

# D1 Requirement + ค่าเกณฑ์

| รายการ | ค่า |
|---|---|
| เวอร์ชัน | v1.2 |
| วันที่ | 2026-10-14 |
| แก้ไขใน v1.1 | ติ๊กรับรองว่าตรงกับ A1 v1.0 (Issue #7) |
| แก้ไขใน v1.2 | อ้างอิง [5] เลขรายงาน LBNL-60946 และ [6] เติมเลขหน้า 429–434 |
| เจ้าของ | D |
| ส่งให้ | ทุกคน (A เช็คกับตารางข้อมูลกลาง A1) |
| สถานะ | ✅ ใช้งานได้ (A ตรวจเทียบ A1 v1.0 แล้ว) |

> ไฟล์นี้ยืนยันค่าเกณฑ์แทนตารางร่างในข้อ 4 ของ `00_team_guide/00_overview.md`
> ข้อความในข้อ 1, 2, 4, 5, 6, 7 ใช้ลงเล่มหัวข้อ 1.4, 1.5, 2.1, 2.2 และ 10.1 ได้ทันที
> ถ้าต้องการเปลี่ยนค่าเกณฑ์ ให้แจ้ง D ก่อน (ค่าเกณฑ์เป็นของกลางที่ D ดูแล)

---

## 1. ปัญหาและวัตถุประสงค์ (เล่มหัวข้อ 1.4)

คนทำงานหน้าคอมพิวเตอร์เจอปัจจัยที่ทำให้ล้าหลายอย่างพร้อมกัน ด้านสายตา อาการตาล้าจากการใช้จอดิจิทัลอาจเกิดกับผู้ใช้คอมพิวเตอร์ถึง 50% ขึ้นไป [9] การพักสายตาตามกฎ 20-20-20 ช่วยลดอาการได้ แต่งานวิจัยพบว่าเมื่อเลิกเตือน ผลที่ได้จะหายไปภายใน 1 สัปดาห์ [7] แปลว่าผู้ใช้ต้องมีสิ่งที่เตือนให้อย่างต่อเนื่อง ไม่ใช่ปล่อยให้จำเอง นอกจากนี้การนั่งนานต่อเนื่องก็ทำให้ล้า การลุกเดิน 3 นาทีทุก 30 นาทีช่วยลดความล้าได้ [8]

ด้านอากาศ ห้องทำงานที่ปิดและเปิดแอร์มี CO₂ สะสมจากลมหายใจของคนในห้อง งานวิจัยพบว่าคะแนนการคิดต่ำลง 15% เมื่อ CO₂ อยู่ที่ประมาณ 945 ppm และต่ำลง 50% ที่ประมาณ 1,400 ppm [1] และที่ 1,000 ppm ซึ่งพบได้ทั่วไปในห้องประชุมหรือห้องเรียน ความสามารถในการตัดสินใจลดลง 6 จาก 9 ด้าน [2] ส่วนอุณหภูมิ คนทำงานได้ดีที่สุดที่ประมาณ 22°C และประสิทธิภาพลดลงเมื่ออุณหภูมิสูงขึ้น [5]

ด้านแสง แสงที่ไม่พอหรือไม่คงที่ทำให้ตาต้องปรับตัวตลอดเวลา มาตรฐานแสงสว่างในที่ทำงานกำหนดความสว่างสำหรับงานเขียน อ่าน และใช้คอมพิวเตอร์ไว้ที่ 500 lux [3] สีของแสงก็มีผล แสงขาวอมฟ้าในเวลากลางวันช่วยให้พนักงานตื่นตัวขึ้น ทำงานดีขึ้น และล้าตอนเย็นน้อยลง [4] แต่แสงอมฟ้าในช่วงค่ำกดฮอร์โมนง่วงลงประมาณ 55% ทำให้หลับยากและง่วงกว่าในเช้าวันถัดไป [10]

**วัตถุประสงค์**

โครงงานนี้ออกแบบระบบที่ช่วยลดความล้าและรักษาความตื่นตัวของคนที่ทำงานหน้าคอมพิวเตอร์เป็นเวลานาน โดยดูแลปัจจัย 3 ด้านให้อัตโนมัติและต่อเนื่อง ดังนี้

1) สายตาและร่างกาย: เตือนให้พักสายตาและลุกยืดเส้นตามช่วงเวลาที่งานวิจัยแนะนำ
2) แสง: รักษาความสว่างบนโต๊ะให้ได้ตามมาตรฐาน และปรับสีแสงให้เหมาะกับช่วงเวลาของวัน
3) อากาศ: เฝ้าระวัง CO₂ และระบายอากาศเมื่อเกินเกณฑ์ พร้อมแจ้งเตือนเมื่ออุณหภูมิไม่เหมาะกับการทำงาน

ระบบทำงานเองเป็นหลัก แต่ยังเปิดให้ผู้ใช้ปรับบางอย่างได้ในขอบเขตที่กำหนด เพื่อให้เหมาะกับงานของแต่ละคน

## 2. กลุ่มผู้ใช้ (เล่มหัวข้อ 1.5)

ระบบนี้ออกแบบสำหรับห้องทำงานที่มีคนนั่งทำงานหน้าคอมพิวเตอร์ประจำโต๊ะ กลุ่มผู้ใช้และผู้ได้รับประโยชน์มีดังนี้

| กลุ่ม | ลักษณะ | ได้ประโยชน์อะไร |
|---|---|---|
| พนักงานออฟฟิศ | นั่งทำงานหน้าคอมพิวเตอร์วันละหลายชั่วโมงในห้องแอร์ที่ปิด | ล้าน้อยลงและตื่นตัวขึ้นโดยไม่ต้องจำหรือตั้งค่าเอง |
| นักศึกษาและนักวิจัย | ใช้คอมพิวเตอร์ในห้องเรียน ห้องปฏิบัติการ หรือห้องสมุดเป็นเวลานาน | มีระบบเตือนพักและแสงที่เหมาะกับการอ่านตลอดวัน |
| ผู้ดูแลอาคาร (ไม่ได้ใช้ระบบโดยตรง) | รับผิดชอบค่าไฟและคุณภาพอากาศของห้อง | ไฟและพัดลมปิดเองเมื่อไม่มีคน ช่วยประหยัดพลังงาน |

## 3. Actor และ Use case (ใช้ภายในทีม ยังไม่ลงเล่ม อิงบท 2 หน้า 14–29)

- **Actor:** ผู้ใช้ที่โต๊ะ, ผู้ดูแลระบบ, แสงจากภายนอก, อากาศในห้อง, NTP server, Wi-Fi router
- **Use case หลัก:** ทำงานที่โต๊ะ 1 วัน (มาถึง → นั่ง → ไฟเปิดและปรับ → ได้รับเตือนพัก → ลุก → กลับมา → เลิกงาน → ไฟปิด)
- **Use case อื่น:** ห้องว่างช่วงกลางคืน, ทำงานดึก, ติดตั้งและตั้งค่าครั้งแรก, เซนเซอร์เสีย

| ประเภท scenario (บท 2 หน้า 26) | ตัวอย่าง |
|---|---|
| Main | นั่งทำงานกลางวัน แดดค่อยๆ ลด ไฟเพิ่มความสว่างจนคงที่ 500 lux |
| Extension | ทำงานต่อถึงค่ำ สีแสงค่อยๆ เปลี่ยนเป็นขาวอุ่น / ผู้ใช้เปิดโหมดทำงานดึก |
| Exception | Wi-Fi หลุด, เซนเซอร์อ่านค่าไม่ได้ |
| Variation | คนในห้องเยอะ CO₂ ขึ้นเร็ว พัดลมทำงานนานขึ้น |

## 4. Functional Requirements (เล่มหัวข้อ 2.1)

ความต้องการเชิงหน้าที่ (Functional Requirements: FR) คือสิ่งที่ระบบต้องทำ แต่ละข้อมีรหัสกำกับเพื่อให้แผนทดสอบในหัวข้อ 7 อ้างถึงได้

| รหัส | ข้อความ requirement | โมดูล | ที่มา / เหตุผล |
|---|---|---|---|
| FR-01 | ระบบต้องตรวจว่ามีคนนั่งที่โต๊ะหรือไม่ รวมถึงตอนที่คนนั่งนิ่ง | ตรวจจับคนนั่ง | เป็นฐานของโมดูลแสงและการเตือนพัก |
| FR-02 | ระบบต้องนับเวลาที่ผู้ใช้นั่งต่อเนื่อง และเริ่มนับใหม่เมื่อผู้ใช้ลุกออกนานตามที่กำหนดในการออกแบบโมดูล | ตรวจจับคนนั่ง | ใช้ตัดสินเวลาเตือนพัก |
| FR-03 | ระบบต้องเตือนให้พักสายตาเมื่อผู้ใช้นั่งต่อเนื่องครบ 20 นาที | เตือนพัก | [7] |
| FR-04 | ระบบต้องเตือนให้ลุกยืดเส้นเมื่อผู้ใช้นั่งต่อเนื่องครบ 30 นาที | เตือนพัก | [8] |
| FR-05 | ผู้ใช้ต้องรับทราบการเตือนได้ และเลื่อนการเตือนได้ครั้งละ 5 นาที ติดกันไม่เกิน 2 ครั้ง โดยปิดการเตือนถาวรไม่ได้ | เตือนพัก | [7] เลิกเตือนแล้วผลหายภายใน 1 สัปดาห์, บท 6 หน้า 38 และ 46 |
| FR-06 | ระบบต้องปรับความสว่างบนโต๊ะให้อยู่ที่ 500 lux เมื่อมีคนนั่ง | ความสว่างคงที่ | [3] |
| FR-07 | ผู้ใช้ต้องปรับความสว่างเป้าหมายเพิ่มได้ในช่วง 500–1,000 lux | ความสว่างคงที่ | [3] ค่าปรับเพิ่มสำหรับงานที่ใช้สายตามาก |
| FR-08 | ระบบต้องหรี่ไฟเหลือ 50% เมื่อไม่มีคนนั่งครบ 5 นาที แล้วค่อยๆ ปิด และต้องเปิดไฟเมื่อตรวจพบคนกลับมา | ความสว่างคงที่ | [12] |
| FR-09 | ระบบต้องปรับสัดส่วนแสงขาวเย็นกับขาวอุ่นตามช่วงเวลาของวัน และใช้สัดส่วนกลางเมื่อยังไม่รู้เวลา | สีแสงตามเวลา | [4], [10] |
| FR-10 | ผู้ใช้ต้องเปิดโหมดทำงานดึกได้ เพื่อใช้แสงสีเดียวกับเวลากลางวันต่อหลัง 19:00 | สีแสงตามเวลา | ผู้ใช้เลือกเองระหว่างความตื่นตัวกับการนอน [10], บท 6 หน้า 38 |
| FR-11 | ค่าที่ผู้ใช้ปรับเอง (ความสว่างเป้าหมายและโหมดทำงานดึก) ต้องกลับเป็นค่าเริ่มต้นเมื่อไม่มีคนนั่งครบ 5 นาที | ความสว่างคงที่ / สีแสง | ผู้ใช้คนถัดไปเริ่มจากค่ามาตรฐานเสมอ |
| FR-12 | ระบบต้องวัด CO₂ อุณหภูมิ และความชื้นในห้องทุก 5 วินาที | อากาศ / อุณหภูมิ / ความชื้น | รอบการวัดของเซนเซอร์ [13] |
| FR-13 | ระบบต้องเปิดพัดลมดูดอากาศเมื่อ CO₂ ถึง 1,000 ppm และปิดเมื่อ CO₂ ลดลงถึง 800 ppm | อากาศ | [1], [2], [13] |
| FR-14 | ระบบต้องแสดงระดับคุณภาพอากาศที่ไฟสถานะของห้องและบนจอของทุกโต๊ะ | อากาศ | ให้ผู้ใช้รู้สาเหตุเมื่อรู้สึกง่วง |
| FR-15 | ระบบต้องลดความแรงหรือปิดพัดลมเมื่อไม่มีคนนั่งโต๊ะใดในห้องเลย | อากาศ | ประหยัดพลังงาน |
| FR-16 | ค่าเกณฑ์ของระบบและการทำงานของพัดลมต้องเปลี่ยนได้โดยผู้ดูแลระบบเท่านั้น ผู้ใช้ที่โต๊ะเปลี่ยนไม่ได้ | อากาศ / ทั้งระบบ | พัดลมและอากาศเป็นของที่ทุกคนในห้องใช้ร่วมกัน |
| FR-17 | ระบบต้องเตือนเมื่ออุณหภูมิห้องต่ำกว่า 20°C หรือสูงกว่า 26°C โดยไม่สั่งงานเครื่องปรับอากาศ | อุณหภูมิ | [5] |
| FR-18 | ระบบต้องแสดงค่าความชื้นบนจอ โดยไม่มีการเตือน | ความชื้น | [6] |
| FR-19 | โหนดโต๊ะต้องส่งสถานะการนั่งให้โหนดห้อง และโหนดห้องต้องส่งข้อมูลอากาศให้โหนดโต๊ะ | การสื่อสาร | ตารางข้อมูลกลาง |
| FR-20 | ระบบต้องรับเวลาจริงจาก NTP server และนับเวลาต่อเองเมื่อเชื่อมต่อไม่ได้ | การสื่อสาร | ใช้กับ FR-09 |

## 5. Non-Functional Requirements (เล่มหัวข้อ 2.2)

ความต้องการที่ไม่ใช่เชิงหน้าที่ (Non-Functional Requirements: NFR) คือระบบต้องทำได้ดีแค่ไหน ทุกข้อเขียนให้วัดหรือตรวจได้

| รหัส | ข้อความ requirement | โมดูล | ที่มา / เหตุผล |
|---|---|---|---|
| **เวลาตอบสนอง** | | | |
| NFR-01 | ระบบต้องเปิดพัดลมภายใน 10 วินาทีหลัง CO₂ เกิน 1,000 ppm | อากาศ | รอบอ่านค่า 5 วินาที × 2 |
| NFR-02 | หลังแสงภายนอกเปลี่ยน ระบบต้องกลับมาที่ความสว่างเป้าหมาย ± 50 lux ภายใน 10 วินาที | ความสว่างคงที่ | ปรับไม่เกิน 2% ต่อรอบ 200 ms |
| NFR-03 | ไฟต้องเริ่มสว่างขึ้นภายใน 1 วินาทีหลังตรวจพบคนกลับมานั่ง | ความสว่างคงที่ | รอบตรวจคน 100 ms + รอบคุมแสง 200 ms |
| NFR-04 | ระบบต้องแสดงการเตือนพักภายใน 1 วินาทีหลังครบเวลา | เตือนพัก | รอบนับเวลา 1 วินาที |
| NFR-05 | งานย่อยทุกงานในโหนดต้องทำเสร็จก่อนเส้นตายของตัวเอง | ทุกโหนด | บท 17 หน้า 19–21 |
| **ความทนทานเมื่อเกิดความผิดพลาด** | | | |
| NFR-06 | ถ้า Wi-Fi หลุด โหนดโต๊ะต้องยังคุมแสง ตรวจคน และเตือนพักได้ครบ และโหนดห้องต้องยังคุมพัดลมได้ | ทุกโหนด | ประมวลผลในตัวโหนด บท 24 หน้า 17 |
| NFR-07 | ถ้าเซนเซอร์ตัวใดอ่านค่าไม่ได้ 3 รอบติดกัน ระบบต้องเข้าสถานะปลอดภัยของโมดูลนั้นและแจ้งเตือนบนจอ | ทุกโมดูล | บท 2 หน้า 27, บท 6 หน้า 37 |
| **พลังงาน** | | | |
| NFR-08 | เมื่อไม่มีคนนั่งครบ 5 นาที ไฟโต๊ะต้องปิด และโหนดโต๊ะต้องลดงานที่ไม่จำเป็นลง | ตรวจคน / แสง | บท 10 หน้า 36 |
| **คุณภาพแสง** | | | |
| NFR-09 | PWM ของไฟ LED ต้องมีความถี่ไม่ต่ำกว่า 3 kHz (ระบบใช้ 5 kHz) | ความสว่างคงที่ | บท 13 หน้า 93–95, [11] |
| NFR-10 | การเปลี่ยนสีแสงอัตโนมัติตามเวลาต้องเปลี่ยนสัดส่วนสีไม่เกิน 1% ต่อนาที | สีแสงตามเวลา | ให้ผู้ใช้ไม่รู้สึกว่าแสงเปลี่ยนกะทันหัน |
| NFR-11 | การเปิดไฟ ปิดไฟ และการเปลี่ยนตามคำสั่งของผู้ใช้ ต้องค่อยๆ เปลี่ยนในเวลาไม่น้อยกว่า 2 วินาที | ความสว่างคงที่ / สีแสง | ไม่ให้แสงกระชาก |
| NFR-12 | ระบบต้องวัดแสงได้ในช่วง 0–2,000 lux และวัด CO₂ ได้ในช่วง 400–5,000 ppm | แสง / อากาศ | บท 13 หน้า 18 |
| **การขยายระบบ** | | | |
| NFR-13 | ต้องเพิ่มโหนดโต๊ะในห้องได้โดยไม่ต้องแก้โปรแกรมของโหนดห้อง | การสื่อสาร | รองรับห้องที่มีหลายโต๊ะ |
| **การใช้งาน ความปลอดภัย และความเป็นส่วนตัว** | | | |
| NFR-14 | การเตือนทุกแบบต้องมีอย่างน้อย 2 ช่องทาง (เช่น จอและเสียง) และสถานะต้องไม่สื่อด้วยสีอย่างเดียว | เตือนพัก / อากาศ | บท 2 หน้า 43–44 |
| NFR-15 | ค่าที่ผู้ใช้ปรับได้ต้องอยู่ในช่วงที่กำหนดเท่านั้น ระบบต้องไม่รับค่านอกช่วง | ทุกโมดูล | บท 6 หน้า 46 |
| NFR-16 | ข้อมูลที่ส่งออกนอกระบบ (เช่น cloud ในอนาคต) ต้องเป็นค่ารวมของห้อง ไม่ระบุรายโต๊ะ | การสื่อสาร | บท 26 หน้า 24 |

## 6. ค่าเกณฑ์ (เล่มหัวข้อ 2.2 ตารางที่ 2.3)

ตัวเลขทุกตัวที่ระบบใช้มีที่มาตามตารางนี้ ค่าเหล่านี้เป็นค่าเริ่มต้นของระบบ ผู้ใช้ปรับได้เฉพาะรายการที่ FR-05, FR-07 และ FR-10 อนุญาต

| ค่า | ค่าที่ใช้ | ที่มา / เหตุผล |
|---|---|---|
| CO₂ เริ่มเตือนและเปิดพัดลม | 1,000 ppm | [1], [2] |
| CO₂ ปิดพัดลม | 800 ppm | ห่างจากค่าเปิด 200 ppm กว้างกว่าค่าที่เซนเซอร์คลาดเคลื่อนได้ (±75 ppm ที่ 1,000 ppm [13]) ค่าที่แกว่งเล็กน้อยจึงไม่ทำให้พัดลมเปิดปิดไปมา |
| ความสว่างเป้าหมาย | 500 ± 50 lux (ผู้ใช้ปรับได้ถึง 1,000 lux) | [3] |
| สีแสง 07:00–16:59 | ขาวเย็น 80% : ขาวอุ่น 20% | [4] |
| สีแสง 17:00–18:59 | ค่อยๆ เปลี่ยนเป็นขาวอุ่น ไม่เกิน 1% ต่อนาที | ตั้งตามเวลาเลิกงานและเวลาพระอาทิตย์ตก |
| สีแสง 19:00–06:59 | ขาวอุ่น 100% (ยกเว้นเปิดโหมดทำงานดึก) | [10] |
| สีแสงเมื่อยังไม่รู้เวลา | ขาวเย็น 50% : ขาวอุ่น 50% | ค่ากลาง ใกล้เคียงแสง 4,000 K ที่ใช้เป็นกลุ่มเปรียบเทียบใน [4] |
| อุณหภูมิที่ทำงานได้ดีที่สุด | 21–22°C | [5] |
| อุณหภูมิที่เริ่มเตือน | ต่ำกว่า 20°C หรือสูงกว่า 26°C | [5] ประสิทธิภาพลดลงเหนือราว 24°C แต่ห้องแอร์ทั่วไปมักตั้งราว 25°C จึงเลือก 26°C เพื่อไม่ให้ระบบเตือนบ่อยจนผู้ใช้ไม่สนใจ |
| เตือนพักสายตา | ทุก 20 นาที | [7] |
| เตือนลุกยืดเส้น | ทุก 30 นาที | [8] |
| เลื่อนการเตือน | ครั้งละ 5 นาที ติดกันไม่เกิน 2 ครั้ง | ตั้งเอง เพื่อให้ยืดหยุ่นแต่ไม่ทิ้งการเตือน [7] |
| ไม่มีคนแล้วหรี่และปิดไฟ | ครบ 5 นาที หรี่เหลือ 50% แล้วค่อยๆ ปิด | [12] กำหนดให้ปิดภายในไม่เกิน 20 นาที |
| ความถี่ PWM ของ LED | 5 kHz (คาบ 0.2 ms) | บท 13 หน้า 93–95, [11] |
| คาบ PWM ของพัดลม | 5–20 ms | บท 13 หน้า 95 |

## 7. อ้างอิงที่ใช้ (เล่มหัวข้อ 10.1)

[1] J. G. Allen, P. MacNaughton, U. Satish, S. Santanam, J. Vallarino, and J. D. Spengler, "Associations of cognitive function scores with carbon dioxide, ventilation, and volatile organic compound exposures in office workers: A controlled exposure study of green and conventional office environments," Environ. Health Perspect., vol. 124, no. 6, pp. 805–812, 2016, doi: 10.1289/ehp.1510037.

[2] U. Satish et al., "Is CO2 an indoor pollutant? Direct effects of low-to-moderate CO2 concentrations on human decision-making performance," Environ. Health Perspect., vol. 120, no. 12, pp. 1671–1677, 2012, doi: 10.1289/ehp.1104789.

[3] Light and lighting – Lighting of work places – Part 1: Indoor work places, EN 12464-1:2021.

[4] A. U. Viola, L. M. James, L. J. Schlangen, and D. J. Dijk, "Blue-enriched white light in the workplace improves self-reported alertness, performance and sleep quality," Scand. J. Work Environ. Health, vol. 34, no. 4, pp. 297–306, 2008, doi: 10.5271/sjweh.1268.

[5] O. Seppänen, W. J. Fisk, and Q. H. Lei, "Effect of temperature on task performance in office environment," Lawrence Berkeley National Laboratory, Rep. LBNL-60946, Jul. 2006.

[6] A. A. Abusharha and E. I. Pearce, "The effect of low humidity on the human tear film," Cornea, vol. 32, no. 4, pp. 429–434, 2013, doi: 10.1097/ICO.0b013e31826671ab.

[7] C. Talens-Estarelles et al., "The effects of breaks on digital eye strain, dry eye and binocular vision: Testing the 20-20-20 rule," Cont. Lens Anterior Eye, 2022, Art. no. 101744, doi: 10.1016/j.clae.2022.101744.

[8] P. Wennberg et al., "Acute effects of breaking up prolonged sitting on fatigue and cognition: A pilot study," BMJ Open, vol. 6, no. 2, Art. no. e009630, 2016.

[9] A. L. Sheppard and J. S. Wolffsohn, "Digital eye strain: Prevalence, measurement and amelioration," BMJ Open Ophthalmol., vol. 3, no. 1, Art. no. e000146, 2018, doi: 10.1136/bmjophth-2018-000146.

[10] A.-M. Chang, D. Aeschbach, J. F. Duffy, and C. A. Czeisler, "Evening use of light-emitting eReaders negatively affects sleep, circadian timing, and next-morning alertness," Proc. Natl. Acad. Sci. USA, vol. 112, no. 4, pp. 1232–1237, 2015, doi: 10.1073/pnas.1418490112.

[11] IEEE Recommended Practices for Modulating Current in High-Brightness LEDs for Mitigating Health Risks to Viewers, IEEE Std 1789-2015, 2015.

[12] Energy Standard for Buildings Except Low-Rise Residential Buildings, ANSI/ASHRAE/IES Standard 90.1-2019, 2019.

[13] Sensirion, "SCD4x: Breaking the size barrier in CO2 sensing," datasheet.

> [1]–[8] เลขเดียวกับข้อ 14 ของ overview (แก้รายละเอียดแล้ว), [9]–[13] เพิ่มใหม่ เลขอาจเปลี่ยนตอนรวมเล่ม D5
> แก้ใน v1.2: [5] เลขรายงานที่ถูกคือ LBNL-60946 (ตรวจจาก OSTI) และเติมเลขหน้า [6] pp. 429–434

---

## สิ่งที่ต้องแจ้งเพื่อน (เพราะ D1 กระทบงานของเขา)

| ถึง | เรื่อง |
|---|---|
| B | FR-05 (เลื่อนเตือนได้ 5 นาที ไม่เกิน 2 ครั้ง ปิดถาวรไม่ได้), FR-07 (ปรับความสว่าง), FR-10 (โหมดทำงานดึก) ต้องสั่งผ่านปุ่มและจอของ B ให้ B ออกแบบวิธีกด (กดสั้น/กดค้าง/เพิ่มปุ่ม) / FR-02 ให้ B กำหนดว่าลุกนานเท่าไรถึงนับใหม่ / NFR-14 การเตือนต้องมี 2 ช่องทาง |
| C | FR-13 ค่าเปิด 1,000 / ปิด 800 ppm (ถ้าต้องการกันแกว่งเพิ่ม ให้นับว่าเกินติดกัน 2 รอบก่อนเปิด ยังทัน NFR-01), FR-15, FR-16, FR-17 (เตือนต่ำกว่า 20°C หรือสูงกว่า 26°C), NFR-14 ไฟสถานะต้องไม่สื่อด้วยสีอย่างเดียว |
| A | **ขอเพิ่ม 2 รายการในตารางข้อมูลกลาง:** `user_lux_target` (ความสว่างเป้าหมายที่ผู้ใช้ตั้ง 500–1,000 lux, B สร้างจากปุ่ม → D ใช้, ส่งเมื่อเปลี่ยน) และ `late_mode` (โหมดทำงานดึก จริง/เท็จ, B สร้าง → D ใช้, ส่งเมื่อเปลี่ยน) **(A เพิ่มแล้วใน A1 v1.0)** / NFR-09 ตั้ง PWM LED ที่ 5 kHz ในโค้ด / NFR-13 เพิ่มโต๊ะได้โดยไม่แก้โปรแกรมโหนดห้อง |

## ✅ เช็คก่อนส่ง

- [x] ทุกโมดูลมี FR อย่างน้อย 1 ข้อ: ตรวจคน (FR-01, 02), อากาศ (FR-12–16), ความสว่าง (FR-06–08, 11), สีแสง (FR-09–11), เตือนพัก (FR-03–05), อุณหภูมิ (FR-17), ความชื้น (FR-18)
- [x] NFR ทุกข้อวัดได้ (มีตัวเลขหรือเงื่อนไขที่ตรวจได้)
- [x] ค่าเกณฑ์ทุกตัวมีที่มา
- [x] A ดูแล้วว่าตรงกับตารางข้อมูลกลาง (A1 v1.0, 2026-10-14: เพิ่ม `user_lux_target` และ `late_mode` แล้ว, B เป็นเจ้าของและคืนค่าเมื่อ `away_timeout` เป็นจริง ตาม FR-11)
