AnMayVaa/smart-workstation-env-regulator/00_team_guide/role_A_integration.md

# บทบาท A: คนเชื่อมระบบและจำลอง

> อ่านคู่กับ `00_overview.md` (ภาพรวมโปรเจค)
> ถ้ามีเวลาน้อย อ่านแค่ **"สรุป 30 วินาที"** กับ **"ของที่ต้องส่ง"** ก็พอเริ่มงานได้

---

## สรุป 30 วินาที

- คุณเป็น **คนทำให้ทุกส่วนต่อกันติด** และทำให้ระบบทำงานได้จริงในโปรแกรมจำลอง
- **ฮาร์ดแวร์:** เลือกบอร์ด ESP32 ทั้ง 2 ตัว ออกแบบระบบไฟเลี้ยง และทำผังว่าอุปกรณ์ไหนต่อขาไหน
- **ซอฟต์แวร์:** ออกแบบวิธีที่โหนดโต๊ะกับโหนดห้องคุยกันผ่าน Wi-Fi
- **งานหลัก:** เอา logic ของ B, C, D มาเขียนเป็นโค้ดจริง ต่อวงจรใน Wokwi แล้วทดสอบตามแผนของ C
- **งานแรกที่ต้องทำ (M1):** ยืนยันตารางข้อมูลกลาง (A1) ทุกคนรองานนี้อยู่

---

## หน้าที่ของคุณ

| ด้าน | ทำอะไร |
|---|---|
| ฮาร์ดแวร์ | เลือกบอร์ด ESP32 ของทั้งสองโหนดพร้อมเหตุผล, ออกแบบระบบไฟเลี้ยง (adapter 12V แปลงลง 5V/3.3V), คำนวณว่าทั้งระบบใช้ไฟเท่าไร, ทำผังขา |
| ซอฟต์แวร์ | ออกแบบการสื่อสารระหว่างโหนด (ส่งอะไร บ่อยแค่ไหน ถ้า Wi-Fi หลุดทำยังไง), ดึงเวลาจริงจาก NTP, กำหนดวิธีใช้ตัวล็อก I²C |
| งานหลัก | เขียนโค้ดจริง 2 โปรแกรม (โหนดโต๊ะ + โหนดห้อง), ต่อวงจรใน Wokwi, รันทดสอบ, บันทึกผล |
| เอกสาร | หัวข้อ 2 (รายการอุปกรณ์และโปรแกรม), 3 (การเชื่อมต่อ), 4 (บอร์ดและไฟ), 5 (โปรโตคอล), 7 (ผลทดสอบ), 10 (ลิงก์โค้ด) |

---

## ของที่ต้องส่ง (เรียงตาม Milestone)

วันที่ของแต่ละ M ดูได้จากกลุ่มแชท D เป็นคนกำหนด
**ความสำคัญ:** 🔴 มีคนรอ · 🟡 มีคนใช้ทีหลัง · 🟢 ใช้ตอนรวมเล่ม

### [M1] A1 ตารางข้อมูลกลาง 🔴

- **คืออะไร:** ตารางบอกว่าแต่ละโมดูลส่งข้อมูลอะไรให้ใคร ชนิดข้อมูลอะไร อัปเดตบ่อยแค่ไหน เป็น "สัญญา" ที่ทุกคนใช้ออกแบบโมดูลของตัวเอง
- **เริ่มจาก:** ร่างในไฟล์ภาพรวมข้อ 5 แล้วปรับให้ถูกต้องและครบ
- **ต้องมี:** ชื่อข้อมูล, ความหมาย, ชนิด, ใครสร้าง, ใครใช้, ความถี่ และข้อมูลที่ส่งข้าม Wi-Fi ระหว่างโหนด
- **ส่งให้:** ทุกคน
- **ส่งที่:** `02_interface/A1_interface_v1`
- **ไปลงเอกสาร:** หัวข้อ 3 (Interconnection)
- **✅ เช็คก่อนส่ง**
  - [ ] ทุกข้อมูลมีเจ้าของคนเดียว (ใครสร้าง)
  - [ ] ทุกโมดูลมีข้อมูลรับเข้าและส่งออกครบ ไม่มีใครต้องเดา
  - [ ] ระบุชัดว่าข้อมูลไหนอยู่ในโหนดเดียวกัน และข้อมูลไหนต้องส่งข้าม Wi-Fi
  - [ ] D ดูแล้วว่าตรงกับ requirement (D1)

### [M2] A2 บอร์ด + ระบบไฟเลี้ยง + ผังขา 🔴

- **คืออะไร:** เลือกบอร์ด อธิบายว่าไฟเข้ามาจากไหน แปลงยังไง และอุปกรณ์แต่ละตัวต่อกับขาไหนของ ESP32
- **ต้องมี:**
  - เหตุผลที่เลือก ESP32 โดยอิงบท 10 หัวข้อ 10.3 (interrupt, sleep mode, timer, memory) และเทียบกับบอร์ดอื่นอย่างน้อย 1 ตัว
  - ตารางไฟรวม: อุปกรณ์ทุกตัวใช้กี่โวลต์และกี่มิลลิแอมป์ รวมแล้วต้องใช้ adapter ขนาดเท่าไร (ใช้ข้อมูลจาก B1, C1, D2)
  - ผังขาของทั้ง 2 โหนด
  - ข้อควรระวัง: ต่อกราวด์ร่วม, ใส่ flyback diode ที่พัดลม, MOSFET ต้องเป็นแบบที่เปิดได้เต็มที่ด้วยไฟ 3.3V
- **ส่งให้:** ทุกคน (จะได้รู้ว่าอุปกรณ์ของตัวเองต่อขาไหน), D
- **ส่งที่:** `03_hardware/A2_board_power_v1` และ datasheet บอร์ดไว้ใน `03_hardware/datasheets/`
- **ไปลงเอกสาร:** หัวข้อ 4 (Selection of microcontroller, Power requirements)
- **✅ เช็คก่อนส่ง**
  - [ ] มีเหตุผลการเลือกบอร์ดที่อ้างอิงสไลด์บท 10
  - [ ] ตารางไฟรวมมีอุปกรณ์ครบทุกตัว
  - [ ] ผังขาไม่มีขาชนกัน และอุปกรณ์ I²C ทุกตัวใช้สายเดียวกัน
  - [ ] แนบ datasheet บอร์ดแล้ว

### [M2] A3 วิธีสื่อสารระหว่างโหนด 🔴

- **คืออะไร:** ออกแบบว่าโหนดโต๊ะกับโหนดห้องคุยกันยังไง
- **ต้องมี:**
  - เหตุผลที่ใช้ Wi-Fi โดยเทียบกับ Bluetooth และ Zigbee (บท 23 หน้า 51–79)
  - ข้อความที่ส่ง: โต๊ะ → ห้อง (`occupied`), ห้อง → โต๊ะ (`air_status`) ระบุรูปแบบข้อมูลและความถี่ในการส่ง
  - วิธีส่ง เช่น MQTT (นอกสไลด์ ต้องอ้างแหล่ง) หรือวิธีอื่น พร้อมเหตุผล
  - ถ้า Wi-Fi หลุด แต่ละโหนดทำอะไรต่อ (บท 6 หน้า 22–26)
  - การดึงเวลาจาก NTP (บท 16 หน้า 23–24)
  - เหตุผลที่ไม่ส่งข้อมูลตลอดเวลา: Wi-Fi กินไฟมากกว่าตัวประมวลผล (บท 10 หน้า 22)
- **ส่งให้:** B (ใช้ทำข้อมูลงานย่อยด้านสื่อสาร), D
- **ส่งที่:** `04_logic/A3_communication_v1`
- **ไปลงเอกสาร:** หัวข้อ 5 (Communication protocols)

### [M2] A-T ข้อมูลงานย่อยของคุณ 🔴

- งานย่อยด้านสื่อสารและซิงก์เวลาของทั้งสองโหนด กรอกตาม **แบบฟอร์ม T** ด้านล่าง
- **ส่งให้:** B | **ส่งที่:** `05_tasks/A-T_tasks_v1`

### [M2] A-TC Test case ของคุณ 🟡

- 2–3 ข้อด้านการสื่อสาร เช่น "Wi-Fi หลุดแล้วโหนดโต๊ะยังคุมไฟได้" กรอกตาม **แบบฟอร์ม TC**
- **ส่งให้:** C | **ส่งที่:** `06_testing/A-TC_testcases_v1`

### [M3] A4 โค้ดจริง + วงจรใน Wokwi 🔴

- **คืออะไร:** โปรแกรม 2 ตัว (โหนดโต๊ะ, โหนดห้อง) สร้างจาก logic ของ B2, C2, D3 และ A3 ใช้ลำดับความสำคัญของงานย่อยตาม B3
- **ต้องมี:** แยกไฟล์ตามโมดูล, ใช้ FreeRTOS task, ใช้ตัวล็อก I²C, วงจรใน Wokwi ใช้อุปกรณ์แทนตามตารางในไฟล์ภาพรวมข้อ 3
- **ส่งที่:** `08_code/` หรือ GitHub (ใส่ลิงก์ไว้ในโฟลเดอร์)
- **ไปลงเอกสาร:** หัวข้อ 5 (code snippets ที่สำคัญ), 7, 10 (ลิงก์)
- **✅ เช็คก่อนส่ง**
  - [ ] รันใน Wokwi ได้ทั้ง 2 โหนด
  - [ ] logic ตรงกับที่เจ้าของโมดูลออกแบบ ถ้าต้องแก้ แจ้งเจ้าของแล้ว
  - [ ] ค่าเกณฑ์ตรงกับ D1

### [M4] A5 ผลทดสอบ + บันทึกการหาสาเหตุ 🟡

- **คืออะไร:** รันทุก test case ตามแผน C5 แล้วบันทึกผล (ผ่าน/ไม่ผ่าน, ค่าที่ได้จริง, ภาพหน้าจอ) และบันทึกวิธีหาสาเหตุเมื่อเจอปัญหา
- **ถ้าโมดูลไหนไม่ผ่าน:** แจ้งเจ้าของโมดูลให้แก้ logic แล้วทดสอบซ้ำ
- **ส่งให้:** C, D | **ส่งที่:** `06_testing/A5_results_v1`
- **ไปลงเอกสาร:** หัวข้อ 7 (Test results, Debugging techniques)

### [M5] A6 เนื้อหาเอกสารส่วนตัว 🟢

- เขียนหัวข้อ 2 (รายการอุปกรณ์และโปรแกรม), 3 (การเชื่อมต่อ), 4 (บอร์ดและไฟ), 5 (โปรโตคอล), 7 (ผลทดสอบ + debug) โดยเรียบเรียงจาก A1–A5
- **ส่งให้:** D | **ส่งที่:** `09_doc_sections/A6_doc_v1`

### [M5] A-N บันทึกปัญหา + อ้างอิง + ลิงก์โค้ด 🟢

- ปัญหาที่เจอระหว่างทำ, ข้อจำกัดของการจำลอง (เช่น ใช้ potentiometer แทนเซนเซอร์ CO₂), แหล่งอ้างอิงที่ใช้, ลิงก์ GitHub
- **ส่งให้:** D | **ส่งที่:** `09_doc_sections/A-N_notes_v1`

---

## ใครรอคุณ / คุณรอใคร

| | รายละเอียด |
|---|---|
| **คนที่รอคุณ** | ทุกคนรอ A1 (M1) และ A2 (M2) · B รอ A3 กับ A-T · C และ D รอ A5 |
| **คุณรอ** | D1 จาก D (M1) · B1, C1, D2 สำหรับคำนวณไฟ · **B2, C2, D3 (logic) ก่อนเขียนโค้ด** · B3 ก่อนตั้งลำดับในโค้ด · C5 ก่อนทดสอบ |
| **ถ้ายังไม่ได้ ให้ทวง** | B, C, D ตามงานที่ค้าง |
| **ระหว่างรอ ทำไปก่อน** | ทำ A2 · ต่อวงจรเปล่าใน Wokwi · เขียนส่วนสื่อสารและ NTP · เตรียมโครงโปรแกรมที่มี task ว่างๆ รอใส่ logic |

**คุณอยู่บนเส้นทางวิกฤต** ถ้า logic ของใครยังไม่มา ให้ทวงทันที อย่ารอจนใกล้วันกำหนด

---

## สไลด์ที่ควรอ่าน

| เรื่อง | บท / หน้า |
|---|---|
| สิ่งที่ต้องดูตอนเลือกตัวประมวลผล | บท 10 หัวข้อ 10.3 หน้า 14–28 |
| Sleep mode และพลังงาน | บท 10 หน้า 21–26 |
| ทำไม GPIO ต้องมีวงจรขับ | บท 13 หน้า 34–35 |
| I²C | บท 23 หน้า 20–35 |
| Wi-Fi และการเทียบโปรโตคอลไร้สาย | บท 23 หน้า 51–79 |
| เวลาในระบบ / NTP | บท 16 หน้า 23–29 |
| Local vs cloud | บท 24 หน้า 18–20 |
| การรับมือความผิดพลาด | บท 6 หน้า 22–26 |
| การทดสอบ | บท 7, บท 8 |

---

## แบบฟอร์ม

### แบบฟอร์ม T: ข้อมูลงานย่อย

| ชื่องานย่อย | ทำอะไร | ทำทุกกี่ ms | ต้องเสร็จภายในกี่ ms | ใช้เวลาทำประมาณกี่ ms (ไม่รู้ใส่ "ไม่ทราบ") | ใช้ของร่วมกับงานอื่นไหม (เช่น I²C) |
|---|---|---|---|---|---|

### แบบฟอร์ม TC: Test case

| รหัส | ทดสอบอะไร | สภาพก่อนเริ่ม | ใส่อะไรเข้าไป / ทำอะไร | ควรได้ผลอะไร | ตรวจ requirement ข้อไหน |
|---|---|---|---|---|---|
| TC-A-01 | Wi-Fi หลุดแล้วโหนดโต๊ะยังทำงาน | ระบบทำงานปกติ | ตัด Wi-Fi | ไฟยังคุมความสว่างได้ จอขึ้นไอคอน Wi-Fi หลุด | NFR-? |

---

## สำหรับ AI ที่ช่วยบทบาทนี้

- ผู้ใช้เป็นบทบาทที่เขียนโค้ดจริง ช่วยเขียนโค้ด ESP32 (Arduino/ESP-IDF + FreeRTOS) ได้ แต่ **ต้องยึด logic ที่เจ้าของโมดูลออกแบบ** ถ้าเห็นว่าควรแก้ ให้แนะนำผู้ใช้ไปคุยกับเจ้าของโมดูล
- ห้ามเปลี่ยนค่าเกณฑ์และตารางข้อมูลกลางเอง ยกเว้นผู้ใช้ (เจ้าของ A1) ตัดสินใจแล้ว
- ข้อมูล MQTT, ESP-NOW, FreeRTOS API และ datasheet เป็นข้อมูลนอกสไลด์ ต้องบอกแหล่งเสมอ
- ก่อนบอกว่างานพร้อมส่ง ให้ตรวจ "เช็คก่อนส่ง" ทุกข้อ
