AnMayVaa/smart-workstation-env-regulator/00_team_guide/role_B_presence_tasks.md

# บทบาท B: โมดูลคนและการเตือนพัก + ตารางงานย่อย

> อ่านคู่กับ `00_overview.md` (ภาพรวมโปรเจค)
> ถ้ามีเวลาน้อย อ่านแค่ **"สรุป 30 วินาที"** กับ **"ของที่ต้องส่ง"** ก็พอเริ่มงานได้

---

## สรุป 30 วินาที

- คุณดูแล **จุดขายของโปรเจค** คือการตรวจว่ามีคนนั่ง นับเวลานั่ง และเตือนให้พัก
- **ฮาร์ดแวร์:** เลือกเซนเซอร์ตรวจจับคน จอ OLED buzzer และปุ่มกด
- **ซอฟต์แวร์:** คิด logic ของการตรวจคนและการเตือนพัก (แผนภาพสถานะ + pseudocode) **ไม่ต้องเขียนโค้ดจริง** A เป็นคนเขียน
- **งานหลัก:** ทำ "ตารางงานย่อย" รวมทั้งระบบ และคำนวณว่า ESP32 ทำทันทุกงาน (ดูคำอธิบายด้านล่าง)
- **งานแรกที่ต้องทำ (M2):** ส่งอุปกรณ์ (B1) และ logic (B2) A รออยู่

---

## หน้าที่ของคุณ

| ด้าน | ทำอะไร |
|---|---|
| ฮาร์ดแวร์ | เลือกเซนเซอร์ตรวจจับคน, จอ OLED, buzzer, ปุ่มกด พร้อมเหตุผลและ datasheet |
| ซอฟต์แวร์ | logic ตรวจคน นับเวลานั่ง เตือนพักสายตา (ทุก 20 นาที) และเตือนลุก (ทุก 30 นาที), เป็นเจ้าของจอและ buzzer คือรับคำขอเตือนจากโมดูลอื่นมาแสดง |
| งานหลัก | ตารางงานย่อยรวม + คำนวณว่าทำทัน (บท 17) |
| เอกสาร | หัวข้อ 4 และ 5 (ส่วนโมดูลตัวเอง), 5 (เหตุผลที่ใช้ RTOS), 6 (การทำงานพร้อมกันและเวลาตอบสนอง) |

### "ตารางงานย่อย" คืออะไร

โปรแกรมใน ESP32 ไม่ได้ทำงานทีละอย่าง แต่แบ่งเป็นงานย่อยหลายงานที่วนทำไปพร้อมๆ กัน เช่น
- เช็คว่ามีคนนั่งไหม ทุก 0.1 วินาที
- อ่านค่าแสง ทุก 0.2 วินาที
- อัปเดตจอ ทุก 0.5 วินาที
- ส่งข้อมูลให้โหนดห้อง ทุก 5 วินาที

งานของคุณคือ
1. **รวบรวม** ว่ามีงานย่อยอะไรบ้าง (ทุกคนส่งข้อมูลงานย่อยของตัวเองมาให้)
2. **จัดลำดับความสำคัญ** ตามหลัก RMS ในบท 17: งานที่ทำถี่กว่าสำคัญกว่าและได้ทำก่อน
3. **คำนวณ** ว่า ESP32 มีเวลาพอทำทุกงานหรือไม่ (utilization: เอาเวลาที่แต่ละงานใช้หารด้วยความถี่ แล้วรวมกัน ต้องไม่เกินเกณฑ์ในบท 17)
4. **อธิบาย** ว่าทำไมระบบเราเป็น soft real-time (บท 16 หน้า 30–34) และทำไมต้องใช้ RTOS (บท 16 หน้า 15–21)

บท 17 มีตัวอย่างการคำนวณให้ทำตาม (หน้า 17–31)

---

## ของที่ต้องส่ง (เรียงตาม Milestone)

วันที่ของแต่ละ M ดูได้จากกลุ่มแชท D เป็นคนกำหนด
**ความสำคัญ:** 🔴 มีคนรอ · 🟡 มีคนใช้ทีหลัง · 🟢 ใช้ตอนรวมเล่ม

### [M2] B1 อุปกรณ์ของโมดูล 🔴

- **คืออะไร:** รายการอุปกรณ์ที่คุณเลือก พร้อมเหตุผล
- **อุปกรณ์ที่แนะนำ:** mmWave LD2410 (จับคนนั่งนิ่งได้ ส่วน PIR จับได้แค่การเคลื่อนไหว), OLED SSD1306, buzzer, ปุ่มกด ถ้าจะเปลี่ยนตัวไหน ต้องมีเหตุผล
- **ต้องมี:** กรอกตาม **แบบฟอร์ม HW** และแนบ datasheet ทุกตัว
- **ส่งให้:** A (ใช้ทำผังขาและคำนวณไฟ), D
- **ส่งที่:** `03_hardware/B1_hardware_presence_v1` และ datasheet ไว้ใน `03_hardware/datasheets/`
- **ไปลงเอกสาร:** หัวข้อ 4 (Sensor/Actuator choice and justification)
- **✅ เช็คก่อนส่ง**
  - [ ] อุปกรณ์ทุกตัวมีเหตุผล และบอกว่าเทียบกับตัวเลือกอื่นอะไร
  - [ ] ระบุไฟเลี้ยง (V, mA) และวิธีต่อ (UART / I²C / GPIO) ครบทุกตัว
  - [ ] แนบ datasheet ครบทุกตัว
  - [ ] ระบุว่าในโปรแกรมจำลองใช้อะไรแทน (เช่น PIR แทน LD2410)

### [M2] B2 Logic ของโมดูล 🔴

- **คืออะไร:** แผนภาพสถานะ (FSM) + pseudocode ของการตรวจคนและการเตือนพัก
- **สถานะที่แนะนำ:** ไม่มีคน → นั่งทำงาน → เตือนพักสายตา (ครบ 20 นาที) / เตือนลุก (ครบ 30 นาที) → กลับไปนั่งทำงาน หรือไม่มีคน เป็น Timed FSM (บท 3 หน้า 30–38)
- **คิดเพิ่มเรื่องเหล่านี้ด้วย:**
  - ลุกไปแป๊บเดียวกี่นาทีถึงนับว่าพักแล้ว และเริ่มนับเวลานั่งใหม่
  - กดปุ่มแล้วเกิดอะไรขึ้น เช่น รับทราบ หรือเลื่อนการเตือน 5 นาที
  - ไม่มีคนนานเท่าไรถึงส่งสัญญาณให้ปิดไฟและเข้า sleep (ค่าเริ่มต้น 5 นาที)
  - รับคำขอเตือนเรื่องอากาศจากโหนดห้องมาแสดงยังไง (`air_status`, `alert_request`)
- **ต้องมี:** กรอกตาม **แบบฟอร์ม LOGIC**
- **ส่งให้:** A (ใช้เขียนโค้ดจริง)
- **ส่งที่:** `04_logic/B2_logic_presence_v1` และภาพ FSM ไว้ใน `07_visuals/`
- **ไปลงเอกสาร:** หัวข้อ 5 (Flowcharts/UML, Pseudocode)
- **✅ เช็คก่อนส่ง**
  - [ ] ทุกสถานะมีทางเข้าและทางออก ไม่มีสถานะที่ติดค้าง
  - [ ] ค่าเวลาทุกตัว (20 นาที, 30 นาที ฯลฯ) ตรงกับ D1 และมีที่มา
  - [ ] ข้อมูลรับเข้าและส่งออกตรงกับตารางข้อมูลกลาง (A1)
  - [ ] มีกรณีผิดพลาด เช่น เซนเซอร์ตรวจคนเสีย (แนะนำ: อย่าปิดไฟใส่คน)

### [M2] B-TC Test case ของคุณ 🟡

- 2–3 ข้อ เช่น "นั่งครบ 20 นาทีแล้วจอขึ้นเตือนพักสายตา" กรอกตาม **แบบฟอร์ม TC**
- **ส่งให้:** C | **ส่งที่:** `06_testing/B-TC_testcases_v1`

### [M3] B3 ตารางงานย่อยรวม + คำนวณว่าทำทัน 🔴

- **คืออะไร:** รวมข้อมูลงานย่อยจากทุกคน (A-T, C-T, D-T และของคุณเอง) แล้ว
  1. จัด priority แบบ RMS
  2. คำนวณ utilization ของแต่ละโหนด เทียบกับเกณฑ์ในบท 17
  3. ระบุของที่ใช้ร่วมกัน (I²C) และวิธีป้องกันการแย่ง (mutex, บท 16 หน้า 9)
- **เริ่มจาก:** ร่างในไฟล์ภาพรวมข้อ 6
- **ถ้ามีคนไม่รู้ว่างานย่อยของตัวเองใช้เวลาเท่าไร:** ขอให้ A ช่วยวัดจากโปรแกรมจำลอง หรือประมาณค่าแล้วเขียนบอกในเอกสารว่าเป็นค่าประมาณ
- **ส่งให้:** A (ใช้ตั้งลำดับในโค้ด), D
- **ส่งที่:** `05_tasks/B3_task_table_v1`
- **ไปลงเอกสาร:** หัวข้อ 5 (RTOS considerations), 6 (Handling concurrency, timing, and latency)
- **✅ เช็คก่อนส่ง**
  - [ ] มีงานย่อยครบทั้งสองโหนด
  - [ ] แสดงวิธีคำนวณ ไม่ใช่แค่คำตอบ
  - [ ] อธิบายผลว่าผ่านเกณฑ์หรือไม่ และหมายความว่าอะไร

### [M5] B4 เนื้อหาเอกสารส่วนตัว 🟢

- เขียนหัวข้อ 4 และ 5 (ส่วนโมดูลตัวเอง), 5 (เหตุผลที่ใช้ RTOS), 6 (การทำงานพร้อมกันและเวลาตอบสนอง) เรียบเรียงจาก B1–B3
- **ส่งให้:** D | **ส่งที่:** `09_doc_sections/B4_doc_v1`

### [M5] B-N บันทึกปัญหา + อ้างอิง 🟢

- ปัญหาที่เจอ ข้อจำกัด และแหล่งอ้างอิงที่ใช้
- **ส่งให้:** D | **ส่งที่:** `09_doc_sections/B-N_notes_v1`

---

## ใครรอคุณ / คุณรอใคร

| | รายละเอียด |
|---|---|
| **คนที่รอคุณ** | A รอ B1, B2 (M2) และ B3 (M3) · D รอ B1 และ B3 · C รอ B-TC |
| **คุณรอ** | D1 และ A1 (M1) · ข้อมูลงานย่อยจาก A, C, D (M2) ก่อนทำ B3 · A2 (ผังขา) |
| **ถ้ายังไม่ได้ ให้ทวง** | A, C, D |
| **ระหว่างรอ ทำไปก่อน** | ทำ B1 และ B2 · อ่านบท 17 หน้า 17–31 · ร่างตาราง B3 โดยใส่งานย่อยของตัวเองก่อน |

---

## ข้อมูลตั้งต้นที่ใช้ได้เลย

**ค่าเกณฑ์ที่เกี่ยวกับคุณ** (ยืนยันใน D1)
- เตือนพักสายตา ทุก 20 นาที (กฎ 20-20-20, อ้างอิง [7] ในไฟล์ภาพรวม)
- เตือนลุก ทุก 30 นาที (อ้างอิง [8])
- ไม่มีคน 5 นาที ให้ปิดไฟและเข้า sleep (ร่าง ต้องให้เหตุผล)

**จุดขายที่ควรเขียนให้เด่น:** งานวิจัย [7] พบว่าการเตือนให้พักช่วยลดอาการตาล้าได้ แต่พอเลิกเตือน ผลก็หายไปภายใน 1 สัปดาห์ จึงต้องมีอุปกรณ์ที่เตือนอย่างต่อเนื่อง

**ข้อมูลในตารางข้อมูลกลางที่เกี่ยวกับคุณ:** คุณสร้าง `occupied` และ `sit_minutes` · รับ `air_status` และ `alert_request` มาแสดง · ใช้ `i2c_lock` ตอนวาดจอ

---

## สไลด์ที่ควรอ่าน

| เรื่อง | บท / หน้า |
|---|---|
| Timed FSM | บท 3 หัวข้อ 3.5 หน้า 30–38 |
| งานที่ทำพร้อมกัน (AND super-state) | บท 3 หัวข้อ 3.6.2 หน้า 49–78 |
| Digital input | บท 13 หัวข้อ 13.2 หน้า 8 |
| จอและไฟแสดงผล | บท 13 หัวข้อ 13.7.2 หน้า 78 |
| Interrupt (ใช้กับปุ่มกด) | บท 10 หัวข้อ 10.3.1 หน้า 14 |
| ต้องใช้ OS หรือไม่ | บท 16 หัวข้อ 16.3 หน้า 15–21 |
| ประเภทของ real-time | บท 16 หัวข้อ 16.5 หน้า 30–34 |
| Semaphore / mutex | บท 16 หน้า 9 |
| สัญลักษณ์, utilization, RMS | บท 17 หน้า 17–31 |

---

## แบบฟอร์ม

### แบบฟอร์ม HW: อุปกรณ์

| อุปกรณ์ | หน้าที่ในระบบ | ทำไมเลือก | ตัวเลือกอื่นที่เทียบ และทำไมไม่เลือก | ไฟเลี้ยง (V / mA) | ต่อกับ ESP32 ทาง | Datasheet (ชื่อไฟล์) | ในโปรแกรมจำลองใช้ |
|---|---|---|---|---|---|---|---|

### แบบฟอร์ม LOGIC

1. **สถานะทั้งหมด:** ชื่อและความหมาย
2. **ตารางเปลี่ยนสถานะ:**

| จากสถานะ | ไปสถานะ | เงื่อนไข | สิ่งที่ระบบทำ |
|---|---|---|---|

3. **ภาพ FSM:** วาดด้วย draw.io แล้ว export เป็น PNG
4. **Pseudocode**
5. **ค่าที่ใช้และที่มา**
6. **ข้อมูลรับเข้าและส่งออก:** ใช้ชื่อตามตารางข้อมูลกลาง
7. **กรณีผิดพลาด:** ถ้าเซนเซอร์เสีย หรือข้อมูลไม่มา ระบบทำอะไร

### แบบฟอร์ม T: ข้อมูลงานย่อย

| ชื่องานย่อย | ทำอะไร | ทำทุกกี่ ms | ต้องเสร็จภายในกี่ ms | ใช้เวลาทำประมาณกี่ ms (ไม่รู้ใส่ "ไม่ทราบ") | ใช้ของร่วมกับงานอื่นไหม |
|---|---|---|---|---|---|

### แบบฟอร์ม TC: Test case

| รหัส | ทดสอบอะไร | สภาพก่อนเริ่ม | ใส่อะไรเข้าไป / ทำอะไร | ควรได้ผลอะไร | ตรวจ requirement ข้อไหน |
|---|---|---|---|---|---|

---

## สำหรับ AI ที่ช่วยบทบาทนี้

- ผู้ใช้ **ไม่ต้องเขียนโค้ดจริง** ช่วยทำ FSM, pseudocode และตารางงานย่อยแทน
- สำหรับ B3 ให้ยึดวิธีคำนวณตามสไลด์บท 17 (utilization, RMS) และแสดงวิธีคิดทีละขั้นให้ผู้ใช้เข้าใจ
- ห้ามเปลี่ยนค่าเกณฑ์ (ของ D) และตารางข้อมูลกลาง (ของ A) เอง
- ข้อมูลจาก datasheet และงานวิจัยเป็นข้อมูลนอกสไลด์ ต้องบอกแหล่งเสมอ
- ก่อนบอกว่างานพร้อมส่ง ให้ตรวจ "เช็คก่อนส่ง" ทุกข้อ
