AnMayVaa/smart-workstation-env-regulator/07_visuals/A2_wiring_desk.png

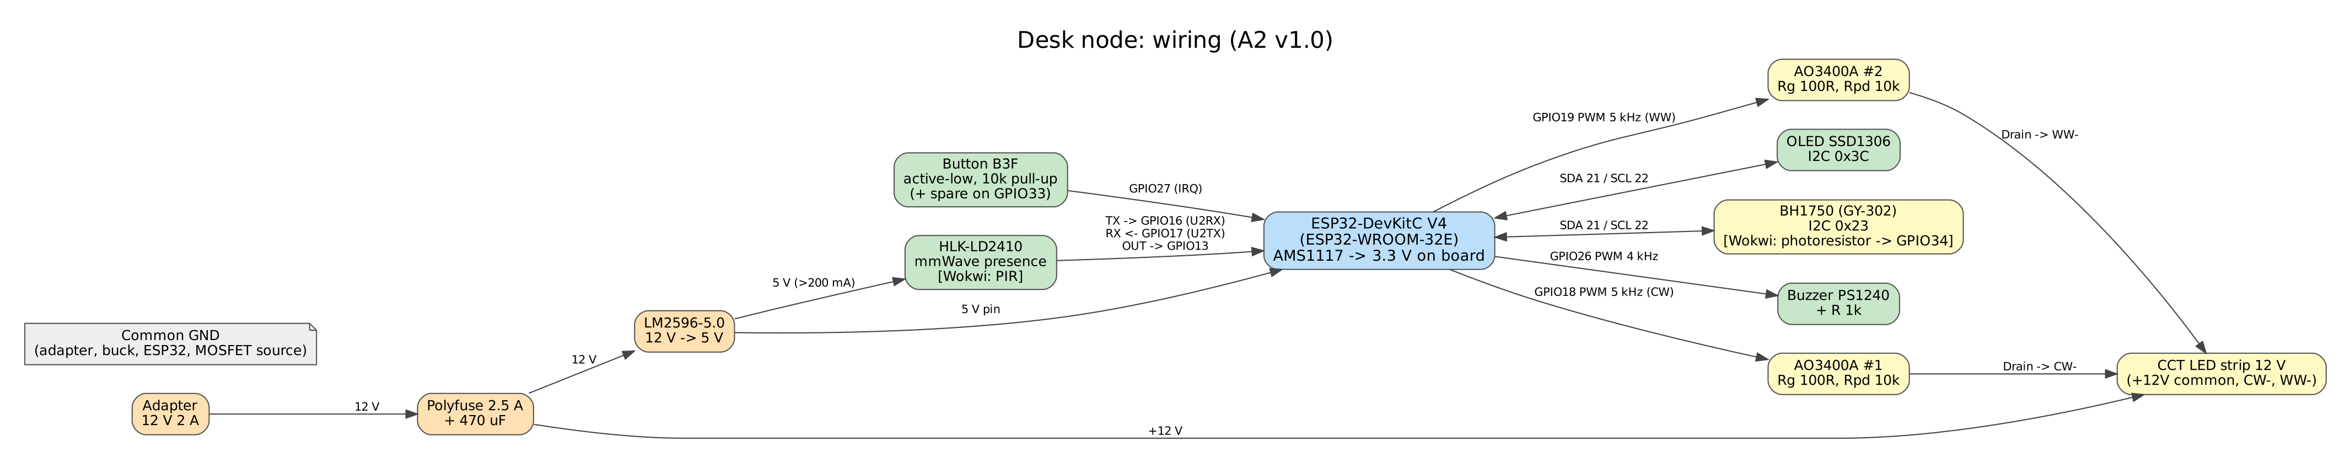
07_visuals/A2_wiring_desk.png
