AnMayVaa/smart-workstation-env-regulator/06_testing/A5_results.md

# A5 ผลการทดสอบบน Wokwi

| รายการ | ค่า |
|---|---|
| เวอร์ชัน | v1.0 |
| วันที่ | 2026-10-14 |
| เจ้าของ | A |
| ส่งให้ | C (เทียบกับแผน C5), B (WCET ใน B3), D (เล่มหัวข้อ 7–8) |
| อ้างอิง | `06_testing/C5_test_plan.md`, `06_testing/A-TC_testcases.md`, `08_code/` |
| หลักฐาน | `06_testing/evidence/2026-10-14_wokwi_ci/` (ดูคำอธิบายแต่ละไฟล์ใน `README.md` ของโฟลเดอร์นั้น) |

ทดสอบด้วย Wokwi CLI 0.28.1 และสคริปต์ใน `08_code/ci/` บน ESP32 Arduino core 3.0.7
ทุกขั้นสั่งผ่าน Serial, ปุ่ม และ LDR แบบอัตโนมัติ แล้วเก็บ log, ภาพจอ OLED และไฟล์ VCD ของ logic analyzer

**ผลรวม: ผ่าน 21/21 รายการอัตโนมัติ (ข้อ 1–3) และ 7/7 รายการในข้อ 7 (S5, M1, M3, TC-A-05, TC-A-08, TC-C-07, TC-D-05)** · ระหว่างทดสอบพบ bug 9 จุด แก้แล้วทั้งหมด และรันซ้ำบน firmware ฉบับแก้

> เวลาในวงเล็บ `[ 12.345]` = เวลาในระบบจำลอง (วินาที) · ชุด `desk_*` ใช้ `TIME_SCALE 120` (1 s = 2 นาทีระบบ) · ชุด `int_*`/`multi_*` ใช้เวลาจริง

## 1. โหนดห้อง (C) — `room_a`, `room_b`

| ID | TC | ทดสอบ | ผลที่ได้ | ผล |
|---|---|---|---|---|
| R1 | TC-C-01 | `co2 1050` | `S1 -> S3_AIR_POOR`, fan 100 % (VCD: ค้าง HIGH) | ผ่าน |
| R2 | TC-C-02 | จาก POOR: `co2 970` แล้ว `920` | 970 ยังเป็น POOR 100 % · 920 → `S2_AIR_MODERATE` fan **50 Hz 60.0 %** (VCD) | ผ่าน |
| R3 | TC-C-03 | `co2 750` แล้ว `900` | 750 → S1 fan 0 % · 900 จาก GOOD → S2 แต่ fan 0 % (ไม่เปิดพัดลมในแถบ 800–1000) | ผ่าน |
| R4 | TC-C-04 | `co2 1200` + `desks 1 0` | `S3 -> S0_ROOM_EMPTY`, fan 0 % | ผ่าน |
| R5 | TC-A-04 | `desks 0 0` (ไม่รู้สถานะโต๊ะ) | กลับเป็น `S3_AIR_POOR` 100 % (unknown ≠ empty) | ผ่าน |
| R6 | TC-C-05 | `fault scd41` / `ok scd41` / ค่าเกินช่วง `co2 5200` | ครบ 3 รอบ → `S4_SENSOR_FAULT` fan **50 Hz 80.0 %**, กลับ S1 หลังอ่านดี 2 รอบ · ค่า 5200 ppm ก็เข้า S4 | ผ่าน |
| R7 | TC-C-06 | `temp 27` / `temp 18` | `tf=2` / `tf=1` | ผ่าน |

## 2. โหนดโต๊ะ (B + D) — `desk_a` … `desk_d`

| ID | TC | ทดสอบ | ผลที่ได้ | ผล |
|---|---|---|---|---|
| D1 | — (FR-01, เงื่อนไขก่อน TC-B-01) | `presence on` | `UNOCCUPIED -> WORKING` หลัง 1.1 s (stable 1 s), ไฟ fade-in 2 s ที่ 5 kHz (VCD) | ผ่าน |
| D2a | TC-B-01 | นั่งต่อเนื่องจนครบ 20 นาที | `desk_a`: EYE หลังเริ่มนั่ง 10.5 s × 120 ≈ 21 นาทีระบบ (ตรวจทุก 1 s = 2 นาทีระบบ) · ยืนยันเวลาจริงใน M3 (ข้อ 7): 20 นาที 0.2 วินาที · beep 150 ms 4.00 kHz (VCD) | ผ่าน |
| D2b | TC-B-02 | นั่งครบ 30 นาที / ลุกเกิน 3 นาทีแล้วกลับ | `desk_a`: STAND ที่ ≈ 31 นาทีระบบ · `desk_c/serial.log`: `WORKING -> AWAY_PENDING` `[ 18.923]` → `AWAY_PENDING -> UNOCCUPIED` `[ 21.023]` (2.1 s × 120 ≈ 4 นาที ≥ 3 นาที) แล้ว `status` แสดง `sit=0min` (เริ่มนับใหม่) · วิดีโอ S5 ช่วงท้ายมีลำดับเดียวกัน | ผ่าน |
| D3 | TC-B-04 | กดค้าง 3 ครั้งตอน STAND | snooze 1/2 → กลับมา 5 นาที → 2/2 → กลับมา → ครั้งที่ 3 จอขึ้น `max 2 snoozes` (ภาพ `evidence/2026-10-14_wokwi_ci/desk_a/12_snooze_rejected_max2.png`) | ผ่าน |
| D4 | TC-B-05, 06 | เมนู 500→800 lux, late ON แล้วลุกไป | log `user_lux_target=800 late_mode=1` · หลัง away 5 นาที → `lux_target=500 late=0` (FR-11) | ผ่าน |
| D5 | TC-D-01 | LDR 50 / 800 / 200 lux | 50 lux → `lux_now=476` (เป้า 500 ± 25) B=71 % · 800 lux → B ลดลงหา 0 · 200 lux → 475 | ผ่าน |
| D6 | TC-D-02 | `time 16:58` | r: 0.50 → 0.68 (17:19) → 0.547 (17:39, ตาราง = 0.54) ช้าไม่เกิน 0.01/นาที | ผ่าน |
| D7 | TC-D-03 | ลุกไป / กลับมาระหว่าง dim / ไม่กลับ | away → `DIMMING` (B 50.6 → 25.3 %) · กลับมา → `REGULATING` ทันที · ไม่กลับ → `OFF` หลัง **60.0 s** พอดี | ผ่าน |
| D8 | TC-D-06 | `fault bh1750` | 0.49 s (3 รอบ) → `SENSOR_FAULT`, B → 60 %, จอ `SENSOR ERR` prio 1 · กลับหลังอ่านดี 2 รอบ | ผ่าน |
| D9 | TC-B-03 | `fault ld2410` | 0.53 s → `SENSOR_FAULT` prio 2 · กลับ `WORKING` | ผ่าน |

## 3. ทั้งระบบ (A) — `int_room` + `int_desk`, `multi_*`

| ID | TC | ทดสอบ | ผลที่ได้ | ผล |
|---|---|---|---|---|
| S2 | TC-A-02 | โต๊ะมีคน | ห้องเห็น `desk 1 occupied=1` หลังโต๊ะส่ง 0.15 s (wall) และนับ `room_occupied_count=1` ในรอบอ่านเดียวกัน | ผ่าน |
| S1 | TC-A-01 | ห้อง `co2 1200` | ห้อง `-> S3_AIR_POOR` → โต๊ะ `display alert CO2 HIGH` ภายใน 0.9 s (wall) + beep 1 ครั้ง | ผ่าน |
| S1b | TC-A-01 | ห้อง `fault scd41` | โต๊ะขึ้นเตือนเซนเซอร์ห้องเสีย prio 2 ภายใน 0.5 s, beep ซ้ำทุก 2.15 s จนหาย | ผ่าน |
| S3 | TC-A-03 | โต๊ะ `wifi off` 18 s แล้ว `on` | โต๊ะ `link_ok=0` + `LINK LOST` ทันที · ห้องตัดโต๊ะออก (`room_desks_online=0`) เมื่อเงียบเกิน 3 × 5 s · ต่อกลับ `link_ok=1` ใน 5.3 s · `air_lost=4` ตรงกับข้อความช่วงที่หลุด | ผ่าน |
| S4 | TC-A-06 | ห้อง + โต๊ะ 1 (มีคน) + โต๊ะ 2 (ว่าง) | `room_desks_online=2 room_occupied_count=1`, desk 1 occ=1, desk 2 occ=0 (NFR-13) | ผ่าน |

## 4. ค่าที่วัดได้ (สำหรับหัวข้อ 6–7)

PWM จาก VCD: LED CW/WW **5000 Hz**, buzzer **4.00 kHz × 150 ms**, fan **50 Hz** ที่ 60 / 80 / 100 % · ทุกขา actuator เป็น 0 ตั้งแต่จ่ายไฟ (ไม่มี glitch ตอนบูต)

Task statistics (`stats`, ระบบจำลองรัน ~45 s; M1 ยังต้องรันจริง 10 นาที):

| โหนด | task | T (ms) | WCET (µs) | เฉลี่ย (µs) | U |
|---|---|---|---|---|---|
| desk | presence_task | 100 | 889 | 41 | 0.009 |
| desk | button_event_task | 100 | 1447 | 58 | 0.014 |
| desk | light_control_task | 200 | 28534 | 1209 | 0.143 |
| desk | display_alert_task | 500 | 43186 | 40494 | 0.086 |
| desk | break_timer_task | 1000 | 16394 | 1187 | 0.016 |
| desk | desk_communication_task | 1000 | 5605 | 5000 | 0.006 |
| desk | **รวม** | | | | **0.274** (RMS bound n=6 = 0.735) |
| room | air_sensor_task | 5000 | 218015 | 26639 | 0.044 |
| room | room_communication_task | 5000 | 5538 | 4848 | 0.001 |

- WCET ของ `light_control_task` (28 ms) ส่วนใหญ่คือรอ `i2c_lock` ระหว่างจอ OLED วาดทั้งเฟรม (~40 ms) ใช้เป็นค่า blocking B ใน response-time analysis ได้เลย
- ไม่มี task ไหน `late` เลย (deadline miss = 0) ทุกโหนด

## 5. Bug ที่พบระหว่างทดสอบ (แก้แล้ว)

| # | โมดูล (เจ้าของ) | อาการ | สาเหตุ / การแก้ |
|---|---|---|---|
| 1 | `presence.cpp` button (B) | กดสั้น 3 ครั้งนับได้ 1 ครั้ง | ISR อ่านขาระหว่างเด้ง ถ้าขอบแรกอ่านได้ "ปล่อย" การ lockout 30 ms ทิ้งการกดจริง → debounce ใหม่: รอให้เงียบ 30 ms แล้วอ่านระดับขาที่นิ่ง (เกิดกับปุ่มจริงด้วย) |
| 2 | `presence.cpp` break timer (B) | STAND ที่ snooze ไว้หายไปเมื่อ EYE ครบกำหนด | สาขา EYE เรียก `reset_snooze_control()` · ในเวลาจริงเกิดแทบทุกครั้งที่ snooze ครั้งที่ 2 (ครบ ~40 นาที ชนกับ EYE 40 นาที) → ให้ STAND ที่รออยู่ "ครอบ" EYE |
| 3 | `config.h` PWM wrapper (A) | พัดลม 60 %/80 % ออกเป็น 100 % · ไฟ CW กลายเป็น 100 % หลัง beep แรก | core 3.x `ledcAttach()` เลือก channel ติดกันที่ใช้ timer เดียวกัน (fan 50 Hz vs RGB 5 kHz, CW vs buzzer) → ให้แต่ละขาใช้ channel คู่ = timer ของตัวเอง (เกิดกับบอร์ดจริงด้วย) |
| 4 | `display.cpp` (B) | หัวข้อ `SENSOR FAULT` ล้นจอ ตัว "LT" ทับบรรทัดถัดไป | ฟอนต์ขนาด 2 กว้าง 12 px × 12 ตัว = 144 > 128 px → แสดง `SENSOR ERR` |
| 5 | `light.cpp` ส่วนจำลอง (D) | lux ที่อ่านได้สูงกว่า LDR จริง ~1.8 เท่า | สูตรแปลงใช้ค่าของไฟ 5 V → `R = 10k·V/(3.3−V)` |
| 6 | `comm.cpp` desk (A) | `link_ok` กระพริบ 0/1 ทุกไม่กี่วินาที | `now − air_rx_ms` ติดลบแบบ unsigned เมื่อข้อความมาถึงในรอบเดียวกัน → คำนวณอายุแบบ signed |
| 7 | `comm.cpp` ทั้งสองโหนด (A) | `air_lost=65507` หลังห้องรีสตาร์ต | seq ย้อนกลับถูกนับเป็นการสูญหาย → ช่องว่าง ≥ 1000 ถือว่าเริ่มนับใหม่ |
| 8 | `comm.cpp`/`air.cpp` room (A → C) | ห้องตัดสิน "ไม่มีคน" ช้าไป 1 รอบ (5 s) | นับโต๊ะหลังรอบอ่าน CO₂ → เรียก `comm_update_counts()` ก่อน FSM ทุกรอบ |
| 9 | `config.h` (A) | ใน Wokwi MQTT หลุด/ต่อใหม่บ่อย | การจำลองช้ากว่าเวลาจริง keepalive 15 s ไม่พอ → 60 s เฉพาะ `SIMULATION 1` (บอร์ดจริงยัง 15 s) |

## 6. ข้อสังเกตให้เจ้าของโมดูลตัดสินใจ (ยังไม่แก้)

- **B:** หลัง LD2410 กลับมาจาก fault ระบบเริ่มนับเวลานั่งใหม่ (`sit=0`) ถ้าตั้งใจให้ต่อเวลาเดิมต้องแก้
- **B:** `button_event_task` เหลือ stack 876 B (น้อยสุด) แนะนำเพิ่มเป็น 3072
- **C:** การอ่าน DHT22 ครั้งแรกหลังบูตได้ NaN นับเป็น error 1 ครั้ง (ถ้า fault ตั้งแต่บูต จะเข้า S4 เร็วขึ้น 1 รอบ)

## 7. ทดสอบต่อเนื่องและวิดีโอ (15 ต.ค. 2569)

รันบนโปรเจค public ใน wokwi.com (โค้ดตรงกับ `08_code` ทุกไฟล์) · หลักฐานใน `evidence/2026-10-15_wokwi_web_m1_m3/` และ `evidence/2026-10-14_s5_scenario/`

| ID | ทดสอบ | ผลที่ได้ | ผล |
|---|---|---|---|
| S5 | วิดีโอสถานการณ์ใช้งาน 2 โหนด | นั่ง → เตือนพัก → CO₂ สูง พัดลม 100 % → เลื่อนเตือน → ลุกไป ไฟหรี่ ห้องว่าง (`S5_scenario_demo.mp4`, 1:42) | ผ่าน |
| M3 | `TIME_SCALE 1` นั่งเวลาจริง | เริ่มนั่ง `[ 129.875]` → `EYE BREAK` `[ 1330.076]` = **20 นาที 0.2 วินาที** | ผ่าน |
| TC-A-05 | ตัด Wi-Fi โต๊ะ 11.2 นาทีจำลอง | `time_valid=1` ตลอด · นาฬิกา 01:10 → 01:21 เดินตรงกับเวลาที่ผ่านไป (±1 นาที) · ต่อกลับ MQTT ใน 3.6 s | ผ่าน |
| TC-A-08 | โต๊ะไม่มีคน (`away_timeout=1`) | ห้องเห็น `desk 1 online=1 occ=0 iv=15s` และยังนับ `room_desks_online=1` | ผ่าน |
| TC-C-07 | ความชื้นใน `air_status` | ห้อง: `rh=55` ตรงค่า DHT22 (`room_a/serial.log` บรรทัด 35) · โต๊ะได้ `rh=55` ผ่าน MQTT (`int_desk/serial.log` บรรทัด 23) · ไม่มีการเตือนจากความชื้น | ผ่าน |
| TC-D-05 | สีแสงก่อนรู้เวลา | `desk_b/serial.log`: ขณะ `time_valid=0` สีแสง `r=0.500` และวงคุมแสงยังทำงาน (B 20 → 35 %, บรรทัด 24–31) · หลังได้เวลา (16:59) r ค่อยๆ เปลี่ยนตามตารางเวลา 0.500 → 0.680 ไม่กระโดด (บรรทัด 66–69) | ผ่าน |
| M1 | รันต่อเนื่องพร้อมโหลด แล้ว `stats` | โต๊ะ 22.8 นาที (presence_task 13,595 รอบ), ห้อง 10.5 นาที (124 รอบ) · `late = 0` ทุก task · ไม่มี reset · heap ต่ำสุด 174 kB (โต๊ะ) | ผ่าน |

WCET จากการรันต่อเนื่อง (ใช้ค่านี้ใน B3 เพราะรันนานกว่าและมีเหตุการณ์ครบกว่าข้อ 4):

| โหนด | task | T (ms) | WCET (µs) | เฉลี่ย (µs) | U |
|---|---|---|---|---|---|
| desk | presence_task | 100 | 948 | 37 | 0.009 |
| desk | button_event_task | 100 | 68 | 22 | 0.001 |
| desk | light_control_task | 200 | 31,797 | 1,138 | 0.159 |
| desk | display_alert_task | 500 | 53,110 | 42,821 | 0.106 |
| desk | break_timer_task | 1000 | 14,394 | 68 | 0.014 |
| desk | desk_communication_task | 1000 | 5,207 | 4,111 | 0.005 |
| desk | **รวม** | | | | **0.295** (RMS bound n=6 = 0.735) |
| room | air_sensor_task | 5000 | 7,795 | 6,020 | 0.002 |
| room | room_communication_task | 5000 | 8,216 | 4,676 | 0.002 |

- `air_sensor_task` บนเว็บ 7.8 ms ต่ำกว่าข้อ 4 (218 ms) เพราะค่า 218 ms ในข้อ 4 รวมการอ่าน DHT22 ครั้งแรกหลังบูตที่ Wokwi CLI รอนาน ค่าเฉลี่ยใกล้กัน (6.0 vs 26.6 ms) · ใช้ค่าที่มากกว่าเป็นกรณีแย่สุดใน B3 ได้
- เบราว์เซอร์หยุดแท็บที่ไม่ได้แสดง จึงรันห้องและโต๊ะสลับกันเป็นช่วง ช่วงที่ห้องหยุด โต๊ะเห็นลิงก์ขาดตามที่ออกแบบ

## 8. ยังไม่ได้ทดสอบ

- วัดกระแสจริง (TC-A-08 ส่วนฮาร์ดแวร์) ทำไม่ได้ใน Wokwi
- ชุด `multi_*` รันบน build ก่อนแก้ bug 8 (โควตา CI ฟรีหมด) ผลการนับ 2 โต๊ะไม่ขึ้นกับการแก้นั้น

## 9. โปรเจค Wokwi (public)

- โหนดห้อง: https://wokwi.com/projects/477874423842942977
- โหนดโต๊ะ: https://wokwi.com/projects/477874597473570817
