AnMayVaa/smart-workstation-env-regulator/00_team_guide/role_C_air_visual_test.md

# บทบาท C: โมดูลอากาศ + ภาพจำลอง + แผนทดสอบ

> อ่านคู่กับ `00_overview.md` (ภาพรวมโปรเจค)
> ถ้ามีเวลาน้อย อ่านแค่ **"สรุป 30 วินาที"** กับ **"ของที่ต้องส่ง"** ก็พอเริ่มงานได้

---

## สรุป 30 วินาที

- คุณดูแล **อากาศในห้อง** (CO₂ อุณหภูมิ ความชื้น และพัดลมดูดอากาศ) และ **งานนำเสนอ** (ภาพจำลอง + แผนทดสอบ)
- **ฮาร์ดแวร์:** เลือกเซนเซอร์อากาศ พัดลมดูดอากาศกับวงจรขับ และไฟสถานะ 3 สี
- **ซอฟต์แวร์:** คิด logic อ่านค่าอากาศ เปิดปิดพัดลม และสิ่งที่ระบบทำเมื่อเซนเซอร์เสีย **ไม่ต้องเขียนโค้ดจริง** A เป็นคนเขียน
- **งานหลัก:** (1) ภาพจำลองตัวอุปกรณ์ และภาพการติดตั้งในห้อง (2) รวม test case ของทุกคนเป็นแผนทดสอบ
- **งานแรกที่ต้องทำ (M2):** ส่งอุปกรณ์ (C1) และ logic (C2) A รออยู่ ระหว่างนั้นเริ่มภาพติดตั้งในห้อง (C3) ได้เลย เพราะไม่ต้องรอใคร

---

## หน้าที่ของคุณ

| ด้าน | ทำอะไร |
|---|---|
| ฮาร์ดแวร์ | เลือกเซนเซอร์ CO₂/อุณหภูมิ/ความชื้น, พัดลมดูดอากาศ + วงจรขับ, ไฟสถานะ RGB พร้อมเหตุผลและ datasheet |
| ซอฟต์แวร์ | logic อ่านค่าอากาศ, ตัดสินใจเปิดปิดหรือปรับความแรงพัดลม, แบ่งระดับเตือน (ดี / เริ่มแย่ / แย่), ทำอะไรเมื่อเซนเซอร์เสีย, ลดพัดลมเมื่อห้องว่าง |
| งานหลัก | ภาพจำลองอุปกรณ์ + ภาพติดตั้งในห้อง (มองเฉียงแบบ isometric) พร้อมเหตุผลตำแหน่งติดตั้ง · รวม test case ของทุกคนเป็นแผนทดสอบ |
| เอกสาร | หัวข้อ 3 (ภาพติดตั้ง), 4 และ 5 (ส่วนโมดูลตัวเอง), 7 (แผนทดสอบ) และภาพประกอบหัวข้อ 1 |

---

## ของที่ต้องส่ง (เรียงตาม Milestone)

วันที่ของแต่ละ M ดูได้จากกลุ่มแชท D เป็นคนกำหนด
**ความสำคัญ:** 🔴 มีคนรอ · 🟡 มีคนใช้ทีหลัง · 🟢 ใช้ตอนรวมเล่ม

### [M2] C1 อุปกรณ์ของโมดูล 🔴

- **คืออะไร:** รายการอุปกรณ์ที่คุณเลือก พร้อมเหตุผล
- **อุปกรณ์ที่แนะนำ:**
  - SCD41: วัด CO₂ ได้จริงแบบ NDIR และวัดอุณหภูมิกับความชื้นได้ในตัวเดียว ห้ามใช้ MQ-135 เพราะวัด CO₂ จริงไม่ได้
  - พัดลมดูดอากาศ DC 12V + MOSFET + flyback diode
  - ไฟ RGB แสดงสถานะ
- **ต้องรู้ไว้:** พัดลมตั้งโต๊ะลด CO₂ ไม่ได้ เพราะแค่พัดอากาศเดิมวนในห้อง ต้องเป็นพัดลมที่ดูดอากาศออกนอกห้อง
- **ต้องมี:** กรอกตาม **แบบฟอร์ม HW** และแนบ datasheet ทุกตัว
- **ส่งให้:** A (ใช้ทำผังขาและคำนวณไฟ), D
- **ส่งที่:** `03_hardware/C1_hardware_air_v1` และ datasheet ไว้ใน `03_hardware/datasheets/`
- **ไปลงเอกสาร:** หัวข้อ 4 (Sensor/Actuator choice and justification)
- **✅ เช็คก่อนส่ง**
  - [ ] อุปกรณ์ทุกตัวมีเหตุผล และบอกว่าเทียบกับตัวเลือกอื่นอะไร
  - [ ] ระบุไฟเลี้ยง (V, mA) และวิธีต่อ (I²C / PWM / GPIO) ครบทุกตัว
  - [ ] แนบ datasheet ครบทุกตัว
  - [ ] ระบุว่าในโปรแกรมจำลองใช้อะไรแทน (potentiometer แทน CO₂, DHT22 แทนอุณหภูมิและความชื้น, LED แทนพัดลม)

### [M2] C2 Logic ของโมดูล 🔴

- **คืออะไร:** แผนภาพสถานะ (FSM) + pseudocode ของการดูแลอากาศ
- **ต้องคิดเรื่องเหล่านี้:**
  - **Hysteresis:** เปิดพัดลมที่ 1000 ppm แต่ปิดที่ค่าต่ำกว่า เช่น 800 ppm เพื่อไม่ให้พัดลมเปิดปิดถี่ อธิบายเหตุผลด้วย
  - **ระดับเตือน:** แบ่งเป็น 3 ระดับ (ดี / เริ่มแย่ / แย่) แต่ละระดับไฟสถานะเป็นสีอะไร
  - **อุณหภูมิ:** เตือนอย่างเดียว ไม่คุมแอร์ ค่าที่ดีที่สุด 21–22°C (อ้างอิง [5])
  - **เซนเซอร์เสียหรืออ่านค่าไม่ได้:** แนะนำให้เปิดพัดลมไว้ก่อนเพื่อความปลอดภัย และแจ้งเตือน (รูปแบบ ตรวจจับ → ตอบสนอง → แจ้งเตือน บท 6 หน้า 22–26)
  - **ห้องว่าง:** ถ้า `room_occupied_count` = 0 ลดหรือปิดพัดลมเพื่อประหยัดไฟ
- **ต้องมี:** กรอกตาม **แบบฟอร์ม LOGIC**
- **ส่งให้:** A (ใช้เขียนโค้ดจริง)
- **ส่งที่:** `04_logic/C2_logic_air_v1` และภาพ FSM ไว้ใน `07_visuals/`
- **ไปลงเอกสาร:** หัวข้อ 5 (Flowcharts/UML, Pseudocode)
- **✅ เช็คก่อนส่ง**
  - [ ] ทุกสถานะมีทางเข้าและทางออก
  - [ ] ค่าเกณฑ์ตรงกับ D1 และมีที่มา
  - [ ] ข้อมูลรับเข้าและส่งออกตรงกับตารางข้อมูลกลาง (A1)
  - [ ] มีกรณีเซนเซอร์เสีย

### [M2] C-T ข้อมูลงานย่อยของคุณ 🔴

- งานย่อยในโหนดห้อง เช่น อ่านอากาศทุก 5 วินาที, คุมพัดลมทุก 5 วินาที กรอกตาม **แบบฟอร์ม T**
- **ส่งให้:** B | **ส่งที่:** `05_tasks/C-T_tasks_v1`

### [M2] C-TC Test case ของคุณ 🟡

- 2–3 ข้อ เช่น "CO₂ ขึ้นถึง 1000 ppm แล้วพัดลมเปิด" กรอกตาม **แบบฟอร์ม TC**
- เก็บไว้รวมในแผนทดสอบ C5 ได้เลย

### [M3] C3 ภาพการติดตั้งในห้อง 🟡 (เริ่มได้ตั้งแต่ M1)

- **คืออะไร:** ภาพห้องทำงานมองเฉียงจากมุมบน (isometric) แสดงตำแหน่งโหนดโต๊ะ โหนดห้อง และพัดลมดูดอากาศ
- **ต้องมี:** ภาพ + คำอธิบายเหตุผลของตำแหน่งติดตั้ง เช่น
  - เซนเซอร์แสงวัดที่ระดับผิวโต๊ะ
  - เซนเซอร์ CO₂ อยู่ระดับที่คนนั่งหายใจ และห่างจากประตูหน้าต่าง
  - พัดลมดูดอากาศอยู่ผนังติดภายนอก
- **เครื่องมือ:** Tinkercad 3D หรือ SketchUp (ฟรี) หรือวาดเองแล้ว export เป็น PNG
- **ส่งให้:** D | **ส่งที่:** `07_visuals/C3_room_installation_v1`
- **ไปลงเอกสาร:** หัวข้อ 3 (มุมมองการติดตั้ง), เหตุผลตำแหน่งลงหัวข้อ 4
- **✅ เช็คก่อนส่ง**
  - [ ] มีครบทั้งโหนดโต๊ะ โหนดห้อง พัดลม และ router
  - [ ] ทุกตำแหน่งมีเหตุผล
  - [ ] ภาพชัดพอเมื่อย่อลงในหน้ากระดาษ

### [M3] C4 ภาพจำลองตัวอุปกรณ์ 🟡

- **คืออะไร:** ภาพโหนดโต๊ะ (และโหนดห้องถ้ามีเวลา) ว่าหน้าตาเป็นยังไง วางอะไรตรงไหน เช่น จอ ปุ่ม เซนเซอร์ แถบไฟ
- **ต้องรอ:** รายการอุปกรณ์จาก B1, D2 (โหนดโต๊ะ) และ C1 ของคุณเอง
- **ส่งให้:** D | **ส่งที่:** `07_visuals/C4_device_mockup_v1`
- **ไปลงเอกสาร:** หัวข้อ 1 (ภาพประกอบภาพรวม)

### [M3] C5 แผนทดสอบรวม 🔴

- **คืออะไร:** รวม test case ของทุกคน (A-TC, B-TC, C-TC, D-TC) เป็นแผนเดียว
- **ต้องมี:**
  - จัดกลุ่ม: ทดสอบทีละโมดูล (unit) และทดสอบทั้งระบบ (system) ตามแนวคิดบท 7–8
  - ทุก requirement ใน D1 ต้องมี test case อย่างน้อย 1 ข้อ ถ้าข้อไหนไม่มี ให้เพิ่มหรือแจ้งเจ้าของ
  - ระบุว่า test case ไหนทดสอบในโปรแกรมจำลองได้ และข้อไหนทำไม่ได้ (เขียนเหตุผล)
- **ส่งให้:** A (ใช้ทดสอบ), D
- **ส่งที่:** `06_testing/C5_test_plan_v1`
- **ไปลงเอกสาร:** หัวข้อ 7 (Test plan and scenarios)
- **✅ เช็คก่อนส่ง**
  - [ ] ทุก requirement มี test case
  - [ ] ทุก test case มีผลที่ควรได้ชัดเจน วัดได้
  - [ ] รูปแบบเหมือนกันทั้งแผน

### [M5] C6 เนื้อหาเอกสารส่วนตัว 🟢

- เขียนหัวข้อ 4 และ 5 (ส่วนโมดูลตัวเอง), 3 (คำอธิบายภาพติดตั้ง), 7 (แผนทดสอบ) เมื่อได้ผลจาก A5 แล้ว ช่วย D ตรวจว่าผลตรงกับแผน
- **ส่งให้:** D | **ส่งที่:** `09_doc_sections/C6_doc_v1`

### [M5] C-N บันทึกปัญหา + อ้างอิง 🟢

- **ส่งให้:** D | **ส่งที่:** `09_doc_sections/C-N_notes_v1`

---

## ใครรอคุณ / คุณรอใคร

| | รายละเอียด |
|---|---|
| **คนที่รอคุณ** | A รอ C1, C2 (M2) และ C5 (M3) · B รอ C-T · D รอ C1, C3, C4 |
| **คุณรอ** | D1 และ A1 (M1) · test case จากทุกคน (M2) ก่อนทำ C5 · รายการอุปกรณ์จาก B1, D2 ก่อนทำ C4 · A5 (ผลทดสอบ) |
| **ถ้ายังไม่ได้ ให้ทวง** | ทุกคนที่ยังไม่ส่ง test case · B และ D เรื่องรายการอุปกรณ์ |
| **ระหว่างรอ ทำไปก่อน** | **ทำ C3 ภาพติดตั้งในห้องได้เลย** · ทำ C1, C2 · ร่างแบบฟอร์มแผนทดสอบ แล้วใส่ test case ของตัวเองก่อน |

---

## สไลด์ที่ควรอ่าน

| เรื่อง | บท / หน้า |
|---|---|
| Analog / digital input | บท 13 หน้า 8–33 |
| ทำไม GPIO ต้องมีวงจรขับ (relay / transistor) | บท 13 หน้า 34–35 |
| มอเตอร์ DC | บท 13 หัวข้อ 13.7.1 หน้า 60 |
| PWM และคาบที่เหมาะกับมอเตอร์ (5–20 ms) | บท 13 หน้า 91–95 |
| การรับมือความผิดพลาด | บท 6 หัวข้อ 6.2.3 หน้า 22–26 |
| Verification, validation | บท 7 |
| การทดสอบ | บท 8 |

---

## แบบฟอร์ม

### แบบฟอร์ม HW: อุปกรณ์

| อุปกรณ์ | หน้าที่ในระบบ | ทำไมเลือก | ตัวเลือกอื่นที่เทียบ และทำไมไม่เลือก | ไฟเลี้ยง (V / mA) | ต่อกับ ESP32 ทาง | Datasheet (ชื่อไฟล์) | ในโปรแกรมจำลองใช้ |
|---|---|---|---|---|---|---|---|

### แบบฟอร์ม LOGIC

1. **สถานะทั้งหมด:** ชื่อและความหมาย
2. **ตารางเปลี่ยนสถานะ:**

| จากสถานะ | ไปสถานะ | เงื่อนไข | สิ่งที่ระบบทำ |
|---|---|---|---|

3. **ภาพ FSM:** วาดด้วย draw.io แล้ว export เป็น PNG
4. **Pseudocode**
5. **ค่าที่ใช้และที่มา**
6. **ข้อมูลรับเข้าและส่งออก:** ใช้ชื่อตามตารางข้อมูลกลาง
7. **กรณีผิดพลาด**

### แบบฟอร์ม T: ข้อมูลงานย่อย

| ชื่องานย่อย | ทำอะไร | ทำทุกกี่ ms | ต้องเสร็จภายในกี่ ms | ใช้เวลาทำประมาณกี่ ms (ไม่รู้ใส่ "ไม่ทราบ") | ใช้ของร่วมกับงานอื่นไหม |
|---|---|---|---|---|---|

### แบบฟอร์ม TC: Test case (ใช้แบบเดียวกันทั้งแผน C5)

| รหัส | ประเภท (unit / system) | ทดสอบอะไร | สภาพก่อนเริ่ม | ใส่อะไรเข้าไป / ทำอะไร | ควรได้ผลอะไร | ตรวจ requirement ข้อไหน | ทดสอบใน Wokwi ได้ไหม |
|---|---|---|---|---|---|---|---|
| TC-C-01 | unit | พัดลมเปิดเมื่อ CO₂ สูง | CO₂ = 600 ppm, พัดลมปิด | หมุน potentiometer จนได้ 1000 ppm | พัดลมเปิดภายใน 10 วินาที, ไฟสถานะเป็นสีแดง | FR-? / NFR-? | ได้ |

---

## สำหรับ AI ที่ช่วยบทบาทนี้

- ผู้ใช้ถนัดงานเอกสารและการนำเสนอมากกว่างานเทคนิค อธิบายเรื่องเทคนิคแบบเข้าใจง่าย และยกตัวอย่างประกอบ
- ผู้ใช้ **ไม่ต้องเขียนโค้ดจริง** ช่วยทำ FSM, pseudocode, ภาพ และแผนทดสอบ
- ห้ามเปลี่ยนค่าเกณฑ์ (ของ D) และตารางข้อมูลกลาง (ของ A) เอง
- ข้อมูลเรื่องตำแหน่งติดตั้งเซนเซอร์และ datasheet เป็นข้อมูลนอกสไลด์ ต้องบอกแหล่งเสมอ
- ก่อนบอกว่างานพร้อมส่ง ให้ตรวจ "เช็คก่อนส่ง" ทุกข้อ
