AnMayVaa/smart-workstation-env-regulator/06_testing/C5_test_plan.md

# C5: แผนการทดสอบระบบรวม (Master System Integration & Test Plan)

> **รหัสเอกสาร:** C5_test_plan  
> **เวอร์ชัน:** v2.3 (เพิ่มผล TC-B-08) · v2.2 (เพิ่มข้อ 4 ผลการทดสอบจาก A5) · v2.1 (ผสาน Test Cases ฉบับทางการ TC-A-01..08, TC-B-01..07, TC-C-01..07, TC-D-01..06 ครบทุกโมดูลตาม Issue #6)  
> **ผู้จัดทำ:** C (ซัน - นายทิวากร ฉับพลัน 6701012610112) | โมดูลอากาศ + ภาพจำลอง + แผนทดสอบ  
> **ส่งให้:** A (โอม - ใช้รันจำลองใน Wokwi และบันทึกผล A5), D (กล้อง - ใช้รวมเล่มหัวข้อ 7)  
> **อ้างอิง:** `01_requirements/D1_requirements.md`, `02_interface/A1_interface.md` v1.0, `06_testing/A-TC_testcases.md`, `06_testing/B-TC_testcases_v1.md`, `06_testing/D-TC_testcases.md`, สไลด์บทที่ 7 และ 8

---

## 1. วัตถุประสงค์และขอบเขตการทดสอบ (Objectives & Scope)

เอกสารฉบับนี้กำหนดกรณีทดสอบ (Test Cases) ทั้งหมดของระบบ **Smart Workstation Environmental Regulator** เพื่อพิสูจน์ยืนยัน (Verification) ความถูกต้องของระบบตามข้อกำหนดความต้องการ (Requirements) ทั้งหมดใน **D1** โดยจัดแบ่งระดับการทดสอบตามหลัก Extended Waterfall (สไลด์บทที่ 7–8):
1. **การทดสอบระดับโมดูล (Unit Testing):** ทดสอบตรรกะและการทำงานเฉพาะส่วนของแต่ละโมดูล (A, B, C, D)
2. **การทดสอบรวมระบบ (System & Integration Testing):** ทดสอบการสื่อสารไร้สายข้ามโหนดผ่าน Wi-Fi/MQTT และการตอบสนองร่วมกันทั้งระบบ
3. **ตารางติดตามข้อกำหนด (Requirement Traceability Matrix):** ตรวจสอบว่าทุก FR และ NFR มีกรณีทดสอบรองรับอย่างน้อย 1 ข้อ

---

## 2. ตารางแผนการทดสอบรวมทั้งระบบ (Comprehensive Test Plan)

### หมวด C: โมดูลตรวจวัดคุณภาพอากาศและควบคุมการระบายอากาศ (Air Quality Subsystem)
| รหัส | ประเภท | วัตถุประสงค์การทดสอบ | สภาพเริ่มต้น | ข้อมูลนำเข้า / การกระทำ | ผลลัพธ์ที่คาดหวัง | ตรวจ Requirement | จำลองใน Wokwi |
|---|:---:|---|---|---|---|:---:|:---:|
| **TC-C-01** | unit | พัดลมเปิดเต็มกำลังเมื่อ $\text{CO}_2 \ge 1,000\ \text{ppm}$ | ห้องมีคน (`occupied=true`), $\text{CO}_2 = 700\ \text{ppm}$, พัดลมปิด | ปรับ Potentiometer ให้ค่า $\text{CO}_2 = 1,050\ \text{ppm}$ | ภายใน 5s: `fan_pct = 100`, ไฟ RGB แดง, `co2_level = 2` | **FR-13, FR-14, NFR-01** | ✅ ได้ |
| **TC-C-02** | unit | กลไก Hysteresis รักษารอบพัดลมขาลง | พัดลมหมุน 100%, $\text{CO}_2 = 1,050\ \text{ppm}$ (ไฟแดง) | ลดค่า $\text{CO}_2$ ลงมาที่ $920\ \text{ppm}$ (ยังสูงกว่า 800) | พัดลมไม่ตัดดับ แต่ลดรอบลงมาที่ `fan_pct = 60`, ไฟเปลี่ยนเป็นสีเหลือง, `co2_level = 1` | **FR-13** | ✅ ได้ |
| **TC-C-03** | unit | พัดลมหยุดหมุนสนิทเมื่อ $\text{CO}_2 < 800\ \text{ppm}$ | พัดลมหมุน 60%, $\text{CO}_2 = 850\ \text{ppm}$ (ไฟเหลือง) | ลดค่า $\text{CO}_2$ ต่ำกว่า $800\ \text{ppm}$ (เช่น $750\ \text{ppm}$) | พัดลมดับสนิท (`fan_pct = 0`), ไฟสถานะกลับเป็นสีเขียว, `co2_level = 0` | **FR-13** | ✅ ได้ |
| **TC-C-04** | unit | โหมดประหยัดพลังงานเมื่อห้องว่าง | $\text{CO}_2 = 1,200\ \text{ppm}$, พัดลมหมุน 100% | จำลอง `room_desks_online = 1` และ `room_occupied_count = 0` | พัดลมหยุดทำงานทันที (`fan_pct = 0`) และไฟ RGB ดับลง | **FR-15, NFR-08** | ✅ ได้ |
| **TC-C-05** | unit | โหมดนิรภัย Fail-Safe เมื่อเซนเซอร์ขัดข้อง | ระบบกำลังทำงานปกติ | ตัดสัญญาณ I²C ติดต่อกัน $\ge 15\ \text{วินาที}$ (3 รอบ) | พัดลมเปิดหมุน `fan_pct = 80`, ไฟกะพริบแดง, `sensor_ok = false` | **NFR-07, NFR-14** | ✅ ได้ (Mock Error) |
| **TC-C-06** | unit | การแจ้งเตือนอุณหภูมิห้องไม่เหมาะสม | อุณหภูมิปกติ $22.0^\circ\text{C}$, `temp_flag = 0` | ปรับเลื่อนอุณหภูมิบน DHT22 $> 26.0^\circ\text{C}$ หรือ $< 20.0^\circ\text{C}$ | `temp_flag = 2` (ร้อนเกิน) หรือ `1` (เย็นเกิน) โหนดห้องไม่สั่งแอร์ พัดลมยังคุมตาม $\text{CO}_2$ | **FR-17** | ✅ ได้ (Slider DHT22) |
| **TC-C-07** | unit | การแสดงค่าความชื้นสัมพัทธ์ | ระบบทำงานปกติ | อ่านค่าความชื้นสัมพัทธ์จากเซนเซอร์ | ค่า `rh_pct` บันทึกลง `air_status` ถูกต้อง โดยไม่มีการสั่งเตือนใดๆ | **FR-18** | ✅ ได้ |

---

### หมวด B: โมดูลตรวจคนและการเตือนพักสายตา (Presence & Break Alert Subsystem)
*(อ้างอิงตรงตาม `06_testing/B-TC_testcases.md` ของ B)*
| รหัส | ประเภท | วัตถุประสงค์การทดสอบ | สภาพเริ่มต้น | ข้อมูลนำเข้า / การกระทำ | ผลลัพธ์ที่คาดหวัง | ตรวจ Requirement | จำลองใน Wokwi |
|---|:---:|---|---|---|---|:---:|:---:|
| **TC-B-01** | unit | เตือนพักสายตาเมื่อทำงานต่อเนื่องครบ 20 นาที | `occupied=true`, ไม่มี alert, ตัวนับเริ่มที่ 0 | เร่งเวลาจำลองจน `sit_elapsed = 20 นาที` | Queue มี `ALERT_EYE_BREAK`; OLED แสดงให้มองไกล 20 วินาที และ Buzzer ดังสั้นภายใน 1s | **FR-03, NFR-04, NFR-14** | ✅ ได้ (PIR + time accel) |
| **TC-B-02** | unit | เตือนลุกเมื่อทำงานต่อเนื่องครบ 30 นาทีและรีเซ็ตหลังพักจริง | `occupied=true`, ตัวนับเริ่มที่ 0 | เร่งถึง 30 นาที แล้วตั้ง `occupied=false` ต่อเนื่อง 3 นาที ก่อนกลับมา `true` | เกิด `ALERT_STAND_BREAK` ที่ 30 นาที; หลังไม่พบคนครบ 3 นาที ตัวนับเริ่มใหม่เมื่อกลับมานั่ง | **FR-01, FR-02, FR-04** | ✅ ได้ |
| **TC-B-03** | system/fault | เซนเซอร์ตรวจคนเสียแล้วระบบไม่ปิดไฟใส่ผู้ใช้ | ระบบกำลังทำงานและเคยมีคน | หยุดส่ง frame ของ LD2410 เกิน 500 ms | ตั้งค่า Fail-Safe: `occupied=true`, `away_timeout=false`, ส่ง `ALERT_SENSOR_FAULT`; ไม่ส่งเงื่อนไขปิดไฟ | **NFR-07** | ✅ ได้ (สวิตช์จำลอง fault) |
| **TC-B-04** | unit/UI | จำกัดการเลื่อนเตือนไม่เกิน 2 ครั้งต่อ alert | อยู่ใน `EYE_ALERT` หรือ `STAND_ALERT`, `snooze_count=0` | กดยาว $\ge 1.5\ \text{s}$ สามครั้ง โดยเร่งเวลาให้ alert กลับมา | ครั้งที่ 1–2 เลื่อน 5 นาที; ครั้งที่ 3 ไม่เลื่อน ไม่เคลียร์ alert และ OLED แสดงว่าเลื่อนได้สูงสุด 2 ครั้ง ไม่ปิดถาวร | **FR-05, NFR-14, NFR-15** | ✅ ได้ (ปุ่มกด) |
| **TC-B-05** | unit/UI | ตั้งค่าความสว่างด้วยปุ่มเดียวภายในช่วงที่อนุญาต | ไม่มี alert, หน้าจอ STATUS, `user_lux_target=500` | กดยาวเข้าเมนู แล้วกดสั้นซ้ำจนผ่าน 1,000 lux | OLED แสดง 500, 600, …, 1,000 lux และวนกลับ 500; publish เฉพาะเมื่อค่าเปลี่ยน ไม่มีค่านอกช่วง | **FR-07, NFR-15** | ✅ ได้ |
| **TC-B-06** | integration/UI | เปิดโหมดทำงานดึกและรีเซ็ตค่าผู้ใช้เมื่อโต๊ะว่าง | ไม่มี alert และยังมีคน | ตั้ง 800 lux, เปิด `late_mode`, จากนั้นจำลองไม่พบคนครบ 5 นาที | ก่อน timeout ส่ง 800/true ให้ D; เมื่อครบ 5 นาทีตั้ง `away_timeout=true`, รีเซ็ตและส่ง 500/false | **FR-08, FR-10, FR-11** | ✅ ได้ |
| **TC-B-07** | integration | B แสดง `air_status` และสร้าง alert อากาศเอง | A เขียนสำเนา `air_status` ใหม่, `age_s <= 15` | ป้อน `co2_level=2`; `temp_flag=1/2`; `sensor_ok=false` ทีละกรณี พร้อมค่า `fan_pct` | B สร้าง/clear `ALERT_CO2_HIGH`, `ALERT_TEMP`, `ALERT_SENSOR_FAULT` จาก `SRC_AIR` เมื่อสถานะเปลี่ยน; OLED แสดง CO₂ อุณหภูมิ ความชื้น ระดับ และ `fan_pct`; ไม่มี alert ข้าม Wi-Fi | **FR-14, FR-16, FR-17, FR-18, FR-19, NFR-14** | ✅ ได้ (mock shared data/queue) |
| **TC-B-08** | integration/fault | ไม่ใช้ข้อมูลอากาศล้าสมัย | มี alert อากาศ active และ `link_ok = true` | เพิ่ม `air_status.age_s` ให้เกิน 15 หรือจำลองขาด `room_report` | clear alert อากาศที่ค้าง, แสดง “ไม่มีข้อมูลอากาศ”; A ส่ง `ALERT_LINK_LOST` เมื่อ link ขาด ขณะที่การเตือนพักของ B ยังทำงาน | **FR-19, NFR-06, NFR-07** | ✅ ได้ (time acceleration) |

---

### หมวด D: โมดูลควบคุมความสว่างและสีแสง (Adaptive Lighting Subsystem)
*(อ้างอิงตรงตาม `06_testing/D-TC_testcases.md` ของ D)*
| รหัส | ประเภท | วัตถุประสงค์การทดสอบ | สภาพเริ่มต้น | ข้อมูลนำเข้า / การกระทำ | ผลลัพธ์ที่คาดหวัง | ตรวจ Requirement | จำลองใน Wokwi |
|---|:---:|---|---|---|---|:---:|:---:|
| **TC-D-01** | unit | รักษาความสว่าง 500 lux แบบป้อนกลับ | มีคนนั่ง (`occupied=true`), S1, แสงรวม ≈ 500 lux | ลดแสงภายนอก (เลื่อน LDR) จาก 300 $\rightarrow$ 100 lux | ปรับ PWM เพิ่มขึ้นจนความสว่างรวมกลับมาที่ **$500 \pm 50\ \text{lux}$ ภายใน 10 วินาที** ไฟไม่กระตุก | **FR-06, NFR-02** | ✅ ได้ (Slider LDR) |
| **TC-D-02** | unit | เปลี่ยนสีแสงตามเวลาแบบค่อยเป็นค่อยไป | มีคนนั่ง, เวลา 16:59, สัดส่วนขาวเย็น $r = 0.80$ | ปรับเวลาจำลองเป็น 17:00 แล้วเดินเวลาไป 18:00 และ 19:00 | 17:00 $r$ เริ่มลดลง, 18:00 $r \approx 0.40$, 19:00 $r = 0.00$ (ขาวอุ่นล้วน) การเปลี่ยนไม่เกิน 1% ต่อนาที | **FR-09, NFR-10** | ✅ ได้ (ย่อสเกลเวลา) |
| **TC-D-03** | system | หรี่ 50% และปิดไฟเมื่อไม่มีคนครบ 5 นาที | มีคนนั่ง, ไฟติด 40% | (ก) ให้ `away_timeout = true` (ข) คนกลับมานั่งระหว่างค้าง 50% | (ก) ไฟหรี่เหลือ 20% ใน 2s ค้าง 60s แล้วค่อยๆ ดับใน 5s (ข) ไฟกลับมาสว่างใน 1s | **FR-08, NFR-03, NFR-08, NFR-11** | ✅ ได้ |
| **TC-D-04** | system | ผู้ใช้ปรับความสว่าง และโหมดทำงานดึก | มีคนนั่ง, เวลา 20:00 ($r = 0.00$) | (ก) ปรับ `user_lux_target = 800` (ข) เปิด `late_mode = true` | (ก) แสงขึ้นไปที่ 800 lux (ข) สัดส่วน $r$ ขึ้นไปที่ 0.80 ใน 10s และค่าถูกรีเซ็ตเมื่อคนลุกไป | **FR-07, FR-10, FR-11, NFR-15** | ✅ ได้ |
| **TC-D-05** | unit | สีแสงเมื่อยังไม่รู้เวลาจริง (ก่อนซิงก์ NTP) | เพิ่งเปิดเครื่อง ยังไม่มี Wi-Fi (`time_valid=false`) | มีคนนั่งทำงาน | กำหนดสัดส่วนสีแสงที่ $r = 0.50$ (ค่ากลาง 4,000 K) และคุมแสง 500 lux ต่อเนื่อง | **FR-09, FR-20, NFR-06, NFR-10** | ✅ ได้ |
| **TC-D-06** | unit | โหมดนิรภัยเมื่อเซนเซอร์แสงชำรุด | มีคนนั่งทำงานปกติ | ตัดสัญญาณเซนเซอร์ BH1750 ติดต่อกัน 3 รอบ | ไฟปรับคงที่ที่ความสว่าง $60\%$ พร้อมแสดงคำเตือนเซนเซอร์เสียบนจอ OLED | **NFR-07, NFR-14** | ✅ ได้ (Mock Error) |

---

### หมวด A: การสื่อสารและการบูรณาการระบบ (System Integration & Connectivity)
*(อ้างอิงตรงตาม `06_testing/A-TC_testcases.md` ของ A)*
| รหัส | ประเภท | วัตถุประสงค์การทดสอบ | สภาพเริ่มต้น | ข้อมูลนำเข้า / การกระทำ | ผลลัพธ์ที่คาดหวัง | ตรวจ Requirement | จำลองใน Wokwi |
|---|:---:|---|---|---|---|:---:|:---:|
| **TC-A-01** | system | ข้อมูลอากาศส่งจากห้องไปแสดงที่โต๊ะ | โหนดทั้งสองต่อ broker, $\text{CO}_2 = 650\ \text{ppm}$ | ปรับ Potentiometer ให้ $\text{CO}_2 = 1,050\ \text{ppm}$ | จอ OLED บนโต๊ะแสดงค่า $\text{CO}_2 \approx 1,050\ \text{ppm}$ และระดับ "แย่" **ภายใน 10 วินาที** | **FR-14, FR-19, NFR-01** | ✅ ได้ (2 แท็บ Wokwi) |
| **TC-A-02** | system | สถานะการนั่งส่งจากโต๊ะไปห้อง | ห้องว่าง, `room_occupied_count = 0` | กระตุ้นเซนเซอร์คนให้มีคนต่อเนื่อง | Serial log ของห้องแสดง `room_occupied_count = 1` **ภายใน 2 วินาที** (ส่งทันที) | **FR-15, FR-19** | ✅ ได้ |
| **TC-A-03** | system | โหนดโต๊ะทำงานต่อเมื่อเน็ตหลุด | ระบบทำงานปกติ มีคน ไฟ 500 lux | ปิดแท็บโหนดห้อง หรือตัด Wi-Fi | ภายใน 15s จอขึ้นลิงก์ขาด แต่วงคุมแสง ตรวจคน และเตือนพักทำงานต่อปกติ เมื่อเน็ตกลับมาต่อได้ใน 60s | **NFR-06, NFR-07** | ✅ ได้ |
| **TC-A-04** | system | โหนดห้องแยก "ไม่รู้" ออกจาก "ห้องว่าง" | มีคนที่โต๊ะ, $\text{CO}_2 = 1,200\ \text{ppm}$, พัดลม 100% | ปิดแท็บโหนดโต๊ะ (จำลองเน็ตหลุด) | ภายใน 45s: `room_desks_online = 0` แต่ **พัดลมยังทำงานตาม $\text{CO}_2$ ต่อไป** ไม่ดับ | **FR-15, NFR-06** | ✅ ได้ |
| **TC-A-05** | unit | ซิงก์เวลาจริงจาก NTP Server | เพิ่งเปิดเครื่อง | (ก) เชื่อมต่อ Wi-Fi (ข) ตัด Wi-Fi 10 นาที | (ก) `time_valid = true` ภายใน 30s เวลาตรง (ข) เวลายังคงนับต่อถูกต้อง $\pm 1\ \text{นาที}$ | **FR-09, FR-20** | ✅ ได้ |
| **TC-A-06** | system | เพิ่มโต๊ะได้โดยไม่แก้โค้ดโหนดห้อง | มีโหนดโต๊ะ `desk_id = 1` ทำงานอยู่ | เปิดโหนดโต๊ะตัวที่ 2 (`desk_id = 2`) มีคนทั้งคู่ | `room_desks_online = 2`, `room_occupied_count = 2` โดยไม่ต้องแก้โปรแกรมโหนดห้อง | **NFR-13** | ✅ ได้ (เปิด 3 แท็บ) |
| **TC-A-07** | unit | `i2c_lock` ป้องกันการแย่งบัส I²C | โหนดโต๊ะรันงานคุมแสง (200ms) + วาดจอ (500ms) | สั่งรันต่อเนื่อง 10 นาที บังคับวาดจอเต็ม | ไม่ค้าง ไม่มี Watchdog Reset, จอไม่เพี้ยน, จำนวนครั้งรอล็อกเกิน 50ms = 0 | **NFR-05** | ✅ ได้ |
| **TC-A-08** | system | การลดพลังงานเมื่อไม่มีคน | มีคน ไฟเปิด รอบส่ง Wi-Fi 5s | ให้ `away_timeout = true` (ไม่มีคนครบ 5 นาที) | ไฟดับ รอบส่งลดเป็น 15s กระแสรวมระบบลดลงอย่างมีนัยสำคัญ | **FR-08, NFR-08** | ✅ ได้บางส่วน |

---

## 3. ตารางติดตามข้อกำหนด (Requirement Traceability Matrix)

ตารางนี้พิสูจน์ยืนยันว่าข้อกำหนดความต้องการทุกข้อในเอกสาร **D1_requirements.md** มีกรณีทดสอบรองรับครบถ้วน $100\%$:

| รหัส Requirement | สรุปข้อกำหนดความต้องการ | กรณีทดสอบที่รองรับ (Test Cases) | สถานะความครอบคลุม |
|---|---|---|:---:|
| **FR-01** | ตรวจจับคนนั่งทำงานที่โต๊ะ | TC-B-02 | ✅ ครอบคลุม |
| **FR-02** | กรองการลุกออกจากโต๊ะช่วงสั้น | TC-B-02 | ✅ ครอบคลุม |
| **FR-03** | แจ้งเตือนพักสายตา 20 นาที (กฎ 20-20-20) | TC-B-01 | ✅ ครอบคลุม |
| **FR-04** | แจ้งเตือนลุกยืดเส้นสาย 30 นาที | TC-B-02 | ✅ ครอบคลุม |
| **FR-05** | กดเลื่อนการเตือน (Snooze) ได้ 5 นาที ไม่เกิน 2 ครั้ง | TC-B-04 | ✅ ครอบคลุม |
| **FR-06** | รักษาความสว่างคงที่ 500 lux แบบป้อนกลับ | TC-D-01 | ✅ ครอบคลุม |
| **FR-07** | ผู้ใช้ปรับความสว่างเป้าหมายได้ (500–1,000 lux) | TC-B-05, TC-D-04 | ✅ ครอบคลุม |
| **FR-08** | หรี่และปิดไฟอัตโนมัติเมื่อไม่มีคนครบ 5 นาที | TC-B-06, TC-D-03, TC-A-08 | ✅ ครอบคลุม |
| **FR-09** | ปรับสัดส่วนสีแสงตามช่วงเวลากลางวัน/เย็น | TC-D-02, TC-D-05, TC-A-05 | ✅ ครอบคลุม |
| **FR-10** | โหมดทำงานดึก (เปิดใช้แสงขาวอมฟ้าหลัง 19:00) | TC-B-06, TC-D-04 | ✅ ครอบคลุม |
| **FR-11** | การเปลี่ยนระดับแสงต้องค่อยเป็นค่อยไป | TC-B-06, TC-D-01, TC-D-03, TC-D-04 | ✅ ครอบคลุม |
| **FR-12** | ตรวจวัด $\text{CO}_2$, อุณหภูมิ และความชื้น | TC-C-01, TC-C-06, TC-C-07 | ✅ ครอบคลุม |
| **FR-13** | เปิดพัดลมดูดอากาศที่ 1,000 ppm และปิดที่ 800 ppm (Hysteresis) | TC-C-01, TC-C-02, TC-C-03 | ✅ ครอบคลุม |
| **FR-14** | แสดงการเตือนบนจอเมื่อ $\text{CO}_2 \ge 1,000\ \text{ppm}$ | TC-C-01, TC-B-07, TC-B-08, TC-A-01 | ✅ ครอบคลุม |
| **FR-15** | ลดหรือปิดพัดลมเมื่อไม่มีคนในห้อง (`room_desks_online > 0 && occupied == 0`) | TC-C-04, TC-A-02, TC-A-04 | ✅ ครอบคลุม |
| **FR-16** | การตั้งเกณฑ์พัดลมเปลี่ยนได้เฉพาะผู้ดูแลระบบ (โต๊ะเปลี่ยนไม่ได้) | TC-B-07 | ✅ ครอบคลุม |
| **FR-17** | เตือนเมื่ออุณหภูมิต่ำกว่า 20°C หรือสูงกว่า 26°C โดยไม่คุมแอร์ | TC-C-06, TC-B-07 | ✅ ครอบคลุม |
| **FR-18** | แสดงค่าความชื้นสัมพัทธ์โดยไม่มีการเตือน | TC-C-07, TC-B-07 | ✅ ครอบคลุม |
| **FR-19** | การส่งข้อมูลไร้สายข้ามโหนดไป-กลับ | TC-B-07, TC-B-08, TC-A-01, TC-A-02 | ✅ ครอบคลุม |
| **FR-20** | ซิงก์เวลาจริงจาก NTP และนับเวลาต่อเองเมื่อเน็ตหลุด | TC-A-05, TC-D-05 | ✅ ครอบคลุม |
| **NFR-01** | เปิดพัดลมและเตือนภายใน 10 วินาทีหลัง $\text{CO}_2 \ge 1,000\ \text{ppm}$ | TC-C-01, TC-A-01 | ✅ ครอบคลุม |
| **NFR-02** | แสงกลับสู่เป้าหมาย $\pm 50\ \text{lux}$ ภายใน 10 วินาที | TC-D-01 | ✅ ครอบคลุม |
| **NFR-03** | ไฟสว่างขึ้นภายใน 1 วินาทีเมื่อคนกลับมานั่ง | TC-D-03 | ✅ ครอบคลุม |
| **NFR-04** | แสดงเตือนพักภายใน 1 วินาทีหลังครบเวลา | TC-B-01, TC-B-02 | ✅ ครอบคลุม |
| **NFR-05** | ทุก Task ทำงานเสร็จก่อน Deadline (ผ่านการทดสอบ Mutex Lock) | TC-A-07 | ✅ ครอบคลุม |
| **NFR-06** | Wi-Fi หลุด ทุกโหนดต้องทำงานอิสระต่อไปได้ (Local Resilience) | TC-A-03, TC-A-04, TC-D-05, TC-B-08 | ✅ ครอบคลุม |
| **NFR-07** | เซนเซอร์อ่านไม่ได้ 3 รอบติดต่อกัน เข้าสู่ Fail-Safe Mode | TC-C-05, TC-B-03, TC-D-06, TC-A-03, TC-B-08 | ✅ ครอบคลุม |
| **NFR-08** | ปิดไฟและลดการทำงานเมื่อไม่มีคนครบ 5 นาที | TC-C-04, TC-D-03, TC-A-08 | ✅ ครอบคลุม |
| **NFR-09** | ความถี่ PWM หลอดไฟ LED ไม่ต่ำกว่า 3 kHz (ใช้ 5 kHz) | TC-D-01, ข้อกำหนดฮาร์ดแวร์ D | ✅ ครอบคลุม |
| **NFR-10** | การเปลี่ยนสีแสงอัตโนมัติไม่เกิน 1% ต่อนาที | TC-D-02, TC-D-05 | ✅ ครอบคลุม |
| **NFR-11** | เปิด-ปิดและปรับแสงค่อยๆ เปลี่ยนไม่น้อยกว่า 2 วินาที | TC-D-03, TC-D-04 | ✅ ครอบคลุม |
| **NFR-12** | ย่านตรวจวัดแสง 0–2,000 lux และ $\text{CO}_2$ 400–5,000 ppm | TC-D-01, TC-C-01 | ✅ ครอบคลุม |
| **NFR-13** | เพิ่มโหนดโต๊ะได้โดยไม่ต้องแก้ไขโปรแกรมโหนดห้อง | TC-A-06 | ✅ ครอบคลุม |
| **NFR-14** | การเตือนมีอย่างน้อย 2 ช่องทาง ไม่สื่อด้วยสีอย่างเดียว (Universal Access) | TC-B-01, TC-B-04, TC-B-07, TC-C-05, TC-D-06 | ✅ ครอบคลุม |
| **NFR-15** | ค่าที่ผู้ใช้ปรับได้ต้องอยู่ในช่วงที่กำหนดเท่านั้น (Range Clamping) | TC-B-04, TC-B-05, TC-D-04 | ✅ ครอบคลุม |
| **NFR-16** | ข้อมูลที่ส่งออกเป็นค่ารวมของห้อง ไม่ระบุเจาะจงรายโต๊ะ | ข้อกำหนดโปรโตคอล MQTT / Cloud | ✅ ครอบคลุม |

---

## 4. ผลการทดสอบ (จาก A5)

ทดสอบใน Wokwi ครบทั้ง 29 กรณี ผ่านทั้งหมด รายละเอียดและหลักฐาน (log, ภาพจอ OLED, VCD, วิดีโอ) อยู่ใน `06_testing/A5_results.md` และ `06_testing/evidence/`

| Test case | ผล | แถวใน A5 | สรุปผล |
|---|---|---|---|
| TC-C-01 | ผ่าน | R1 | `co2 1050` → `S3_AIR_POOR` พัดลม 100 % |
| TC-C-02 | ผ่าน | R2 | 970 ppm ยัง POOR, 920 ppm → MODERATE พัดลม 50 Hz 60.0 % |
| TC-C-03 | ผ่าน | R3 | 750 ppm → GOOD พัดลม 0 % |
| TC-C-04 | ผ่าน | R4 | มีโต๊ะออนไลน์แต่ไม่มีคน → `S0_ROOM_EMPTY` พัดลม 0 % |
| TC-C-05 | ผ่าน | R6 | 3 รอบ → `S4_SENSOR_FAULT` พัดลม 80 %, คืนหลังอ่านดี 2 รอบ |
| TC-C-06 | ผ่าน | R7 | 27 °C → `tf=2`, 18 °C → `tf=1` |
| TC-C-07 | ผ่าน | ข้อ 7 | `rh=55` ที่ห้องและที่โต๊ะ ไม่มีการเตือน |
| TC-B-01 | ผ่าน | D2a, M3 | เตือนพักสายตาที่ 20 นาที (เวลาจริง 20 นาที 0.2 วินาที) |
| TC-B-02 | ผ่าน | D2b | เตือนลุกที่ 30 นาที, ลุกเกิน 3 นาทีแล้วเริ่มนับใหม่ |
| TC-B-03 | ผ่าน | D9 | LD2410 เสีย → `SENSOR_FAULT` ใน 0.53 s เตือน priority 2 |
| TC-B-04 | ผ่าน | D3 | snooze 1/2, 2/2 แล้วครั้งที่ 3 ขึ้น `max 2 snoozes` |
| TC-B-05 | ผ่าน | D4 | เมนูปรับความสว่าง 500 → 800 lux |
| TC-B-06 | ผ่าน | D4 | late mode ON และกลับค่าเริ่มหลังไม่มีคน 5 นาที (FR-11) |
| TC-B-07 | ผ่าน | S1, S1b | จอโต๊ะเตือน CO₂ สูงและเซนเซอร์ห้องเสียจาก `air_status` |
| TC-B-08 | ผ่าน | ข้อ 7 | ข้อมูลอากาศเก่าเกิน 15 s → clear เตือน CO₂ ที่ค้าง และแสดง "No air data" |
| TC-D-01 | ผ่าน | D5 | แสงภายนอก 50 lux → อ่านได้ 476 lux (เป้า 500 ± 25) |
| TC-D-02 | ผ่าน | D6 | สีแสงเปลี่ยนตามเวลา ช้าไม่เกิน 0.01/นาที |
| TC-D-03 | ผ่าน | D7 | ไม่มีคน → หรี่ 50 %, ไม่กลับ → ปิดหลัง 60.0 s, กลับมา → คุมแสงต่อ |
| TC-D-04 | ผ่าน | D4 | ตั้ง 800 lux แล้ววงคุมแสงเข้าเป้า (776 lux ในช่วง ± 25) |
| TC-D-05 | ผ่าน | ข้อ 7 | ก่อนได้เวลา r = 0.50 และยังคุมแสง |
| TC-D-06 | ผ่าน | D8 | BH1750 เสีย → ไฟค้าง 60 % เตือน priority 1, คืนหลัง 2 รอบ |
| TC-A-01 | ผ่าน | S1 | ห้อง → จอโต๊ะ ≤ 0.9 s |
| TC-A-02 | ผ่าน | S2 | โต๊ะ → ห้อง 0.15 s |
| TC-A-03 | ผ่าน | S3 | Wi-Fi โต๊ะหลุด: ทำงานหลักต่อ, ต่อกลับ 5.3 s |
| TC-A-04 | ผ่าน | R5, S3 | ไม่รู้สถานะโต๊ะ ≠ ห้องว่าง พัดลมยังคุมตาม CO₂ |
| TC-A-05 | ผ่าน | ข้อ 7 | ตัด Wi-Fi 11.2 นาที นาฬิกายังถูกต้อง |
| TC-A-06 | ผ่าน | S4 | ห้องนับ 2 โต๊ะแยกกันโดยไม่แก้โค้ดห้อง |
| TC-A-07 | ผ่าน | M1 | รันต่อเนื่อง 22.8 นาที ไม่มี reset, `late = 0` |
| TC-A-08 | ผ่าน | D7, ข้อ 7 | ไฟปิดเมื่อไม่มีคน, ห้องเห็นรอบส่ง 15 s |

ข้อจำกัด: ทดสอบด้วยอุปกรณ์แทนในโปรแกรมจำลอง ตรวจได้เฉพาะตรรกะ ความแม่นยำของเซนเซอร์จริงและกระแสไฟจริงต้องวัดเมื่อสร้างอุปกรณ์
