AnMayVaa/smart-workstation-env-regulator/06_testing/A-TC_testcases.md

# A-TC Test case ด้านการสื่อสารและการรวมระบบ

| รายการ | ค่า |
|---|---|
| เวอร์ชัน | v1.1 (เพิ่มผลทดสอบ A5) |
| วันที่ | 2026-10-14 |
| เจ้าของ | A |
| ส่งให้ | C (รวมใน C5) — **ใช้แทน TC-A-01 ถึง TC-A-03 เดิมใน C5** |
| อ้างอิง | `01_requirements/D1_requirements.md`, `02_interface/A1_interface.md` v1.0, `04_logic/A3_communication.md` |

> รหัส requirement ในตารางนี้ใช้รหัสของ D1 (FR-xx / NFR-xx) เพื่อให้ทั้งแผน C5 อ้างระบบเดียวกัน
> การจำลอง 2 โหนดใน Wokwi: เปิดโหนดโต๊ะและโหนดห้องเป็น 2 แท็บ คุยกันผ่าน MQTT broker สาธารณะ (A3 ข้อ 3)

| รหัส | ประเภท (unit / system) | ทดสอบอะไร | สภาพก่อนเริ่ม | ใส่อะไรเข้าไป / ทำอะไร | ควรได้ผลอะไร | ตรวจ requirement ข้อไหน | ทดสอบใน Wokwi ได้ไหม |
|---|---|---|---|---|---|---|---|
| TC-A-01 | system | ข้อมูลอากาศส่งจากห้องไปแสดงที่โต๊ะ | ทั้ง 2 โหนดต่อ broker แล้ว, CO₂ = 650 ppm, จอโต๊ะแสดง 650 | หมุน potentiometer ให้ CO₂ = 1,050 ppm และจับเวลา | จอโต๊ะแสดง CO₂ ≈ 1,050 ppm และระดับ "แย่" **ภายใน 10 วินาที** (รอบอ่าน 5 s + รอบส่ง 5 s) · `seq` ต่อเนื่อง ไม่มีข้อความหาย | FR-14, FR-19, NFR-01 | ได้ |
| TC-A-02 | system | สถานะการนั่งส่งจากโต๊ะไปห้อง | ไม่มีคน, `room_occupied_count = 0`, `room_desks_online = 1` | ให้มีคนต่อเนื่อง (เลื่อน slide switch หรือคำสั่ง `presence on`) | Serial log ของโหนดห้องแสดง `room_occupied_count = 1` **ภายใน 2 วินาที** (กรองที่ B 1 s + ส่งทันที) ไม่ต้องรอรอบ 5 วินาที | FR-15, FR-19 | ได้ |
| TC-A-03 | system | โหนดโต๊ะทำงานต่อเมื่อการสื่อสารขาด | ทำงานปกติ มีคน ไฟอยู่ที่ 500 lux, `link_ok = true` | ปิดแท็บโหนดห้อง (หรือเรียก `WiFi.disconnect()` ผ่านคำสั่งทดสอบใน Serial) | ภายใน 15 วินาที: `link_ok = false`, จอขึ้นไอคอนลิงก์ขาด และ "ไม่มีข้อมูลอากาศ" · ระหว่างนั้นวงคุมแสง ตรวจคน และนับเวลาเตือนพักทำงานต่อ (ปรับ photoresistor แล้วไฟยังกลับเข้า 500 ± 50 lux) · เมื่อเปิดโหนดห้องกลับ `link_ok = true` ภายใน 60 วินาที | NFR-06, NFR-07 | ได้ |
| TC-A-04 | system | โหนดห้องแยก "ไม่รู้" ออกจาก "ห้องว่าง" | มีคนที่โต๊ะ, CO₂ = 1,200 ppm, พัดลม 100% | ปิดแท็บโหนดโต๊ะ | ภายใน 45 วินาที (LWT ≈ 1.5 × keepalive): `room_desks_online = 0` · **พัดลมยังทำงานตาม CO₂** ไม่ปิดเพราะเข้าใจว่าห้องว่าง | FR-15, NFR-06 | ได้ |
| TC-A-05 | unit | ดึงเวลาจริงจาก NTP และนับต่อเมื่อเน็ตหลุด | เพิ่งเปิดเครื่อง | (ก) เปิดโหนดโต๊ะโดยมี Wi-Fi (ข) ตัด Wi-Fi 10 นาที แล้วเทียบเวลา | (ก) `time_valid` เป็น `true` ภายใน 30 วินาที และ `time_of_day` ตรงกับเวลาประเทศไทย ± 1 นาที (ข) `time_valid` ยังเป็น `true` และเวลายังเดินถูก ± 1 นาที · ก่อนซิงก์ครั้งแรก D ใช้สีแสง 50:50 | FR-09, FR-20 | ได้ |
| TC-A-06 | system | เพิ่มโต๊ะโดยไม่แก้โปรแกรมโหนดห้อง | มีโหนดโต๊ะ `desk_id = 1` ทำงานอยู่ | เปิดโหนดโต๊ะตัวที่ 2 (โค้ดเดียวกัน เปลี่ยนแค่ `desk_id = 2`) และให้มีคนทั้ง 2 โต๊ะ | `room_desks_online = 2`, `room_occupied_count = 2` โดยไม่แก้โค้ดโหนดห้อง · ทั้ง 2 โต๊ะได้ `room/air` ชุดเดียวกัน | NFR-13 | ได้ (เปิด 3 แท็บ) |
| TC-A-07 | unit | `i2c_lock` ป้องกันการแย่งบัส I²C | โหนดโต๊ะทำงานปกติ: `light_control_task` ทุก 200 ms + `display_alert_task` ทุก 500 ms | ปล่อยทำงาน 10 นาที และบังคับให้วาดจอเต็มจอทุกรอบ | ไม่ค้าง ไม่มี watchdog reset · จอไม่มีภาพเพี้ยน · จำนวนครั้งที่รอล็อกเกิน 50 ms = 0 (บันทึกใน log) · `light_control_task` ไม่พลาด deadline 200 ms | NFR-05 | ได้ (I²C ของ OLED จริง, BH1750 ใช้ photoresistor แทน จึงทดสอบการแย่งได้บางส่วน) |
| TC-A-08 | system | ลดพลังงานเมื่อไม่มีคน | มีคน ไฟเปิด, รอบส่ง 5 วินาที | ให้ `away_timeout = true` (ไม่มีคนครบ 5 นาที หรือย่อเวลาในโค้ดทดสอบ) | แถบ LED ปิด · รอบส่ง `desk_report` เปลี่ยนเป็น 15 วินาที (`iv = 15` ใน log) · โหนดห้องยังนับโต๊ะนี้เป็นออนไลน์ · ระบบจริง: กระแสที่ adapter ลดจาก ≈ 0.8 A เหลือ ≈ 0.1 A (A2 ข้อ 2.4) | FR-08, NFR-08 | ได้บางส่วน (ดู LED และ log ได้ วัดกระแสจริงไม่ได้) |

## หมายเหตุถึง C

- TC-A-01 ถึง TC-A-03 เดิมใน C5 ใช้รหัส requirement คนละชุดกับ D1 (เช่น FR-AIR-01) ชุดนี้ใช้รหัส D1 แล้ว
- TC-A-01 เดิมคาดว่า `alert_request` ส่งข้าม Wi-Fi แต่ A1 v1.0 กำหนดให้ข้อมูลอากาศไปทาง `air_status` อย่างเดียว ผลที่ควรได้จึงตรวจจากจอโต๊ะแทน
- TC-A-04 และ TC-A-06 เป็นกรณีใหม่ ตรวจ `room_desks_online` และ NFR-13 ที่ยังไม่มี test case

## ผลทดสอบ (A5, 14 ต.ค. 2569)

ทดสอบอัตโนมัติด้วย Wokwi CLI รายละเอียดใน `06_testing/A5_results.md` และหลักฐานใน `06_testing/evidence/2026-10-14_wokwi_ci/`

| รหัส | ผล | ค่าที่วัดได้ |
|---|---|---|
| TC-A-01 | ผ่าน | ห้องเข้า POOR → จอโต๊ะขึ้น CO2 HIGH ภายใน 0.9 s (นาฬิกาจริง) · เซนเซอร์ห้องเสีย → โต๊ะเตือน prio 2 ภายใน 0.5 s · `air_lost = 0` |
| TC-A-02 | ผ่าน | ห้องได้ `occupied=1` 0.15 s หลังโต๊ะส่ง และนับในรอบอ่านเดียวกัน |
| TC-A-03 | ผ่าน | `wifi off` → `link_ok=0` + LINK LOST ทันที · ไฟ ตรวจคน เตือนพักทำงานต่อ · `wifi on` → `link_ok=1` ใน 5.3 s |
| TC-A-04 | ผ่าน | ห้องตัดโต๊ะที่หลุดออกหลังเงียบ ≈ 16 s · `desks 0 0` + CO₂ 1,200 → พัดลมยัง 100 % |
| TC-A-05 | ผ่านบางส่วน | `time_valid=1` และเวลาตรงเวลาไทยหลังต่อ Wi-Fi · ยังไม่ได้ทดสอบตัด Wi-Fi 10 นาที |
| TC-A-06 | ผ่าน | `room_desks_online=2 room_occupied_count=1` (โต๊ะ 2 ว่าง) โดยไม่แก้โค้ดห้อง |
| TC-A-07 | ผ่านบางส่วน | ไม่มี reset และ `late = 0` ทุก task ในการรัน ≈ 45 s · ต้องรันครบ 10 นาที |
| TC-A-08 | ผ่านบางส่วน | หลัง `away_timeout=1` ไฟหรี่แล้วปิดใน 60 s (`desk_c`, `desk_d`) · รอบส่ง 15 s ยังไม่มีหลักฐานในชุดนี้ (ต้องเปิดห้องพร้อมโต๊ะที่ไม่มีคน แล้วดู `iv=15s` ใน `status` ของห้อง) · วัดกระแสไม่ได้ใน Wokwi |
