AnMayVaa/smart-workstation-env-regulator/(commit log)

2026-10-14 docs(role-a): A1 v1.0 interface, A2 board/power/pins, A3 communication, A-T, A-TC, A-N
    - A1 v1.0: add user_lux_target, late_mode, fan_pct, report_interval_s; close Q1-Q7; no alert_request across Wi-Fi
    - A2: ESP32-DevKitC V4, power budget per node, pin maps, MOSFET decision (AO3400A), wiring diagrams
    - A3: Wi-Fi + MQTT design, topics/payloads, failure handling, NTP, power and security
    - A-T and A-TC for B3 and C5; board and SCD41 datasheets
2026-10-14 docs(role-c): address Issue #6 - align with A1 v1.0 struct, AO3400A mosfet, C2 FSM png, and C5 master test plan v2
2026-10-14 fix(air-module): address final review items for Issue #6
    - Sync C5 test cases with B-TC PR #10 (update TC-B-07, add TC-B-08 and traceability)
    - Clarify C1 SCD41 0.5 mA power note as 5-min single shot per Table 4
    - Add 1N4007 datasheet and standardize generic specs for fan and RGB LED
2026-10-14 fix(hardware-air): align C1 and C-N with datasheets and A2 for Issue #15
    - Update SCD41 accuracy to Table 1 Version 1.7 [+- (50 ppm + 2.5%)] for 400-1000 ppm
    - Add engineering justification for fan airflow sizing (50-70 CFM per ASHRAE 62.1) and currents
    - Add RGB LED current limiting calculation (<= 10 mA/color via 220 Ohm at 3.3V)
    - Align Wokwi fan representation to blue LED at GPIO 25 matching A2 and SIMULATION_GUIDE
    - Add Section 4 IEEE References [C1-1] to [C1-8] in C1
    - Update C-N and C6 doc sections with SCD41 Version 1.7 and AO3400A datasheets
    - Update i2c_lock reference to A1 item 7
2026-10-14 feat(role-a): A4 firmware for desk and room nodes with Wokwi circuits
    - desk_node: presence/breaks (B2), OLED + buzzer (B), light control (D3), Wi-Fi/MQTT/NTP (A3)
    - room_node: air FSM and fan (C2), Wi-Fi/MQTT and desk table (A3)
    - desk_node_2: second desk (DESK_ID 2) for TC-A-06
    - ci/: automated Wokwi CLI scenarios, build script and VCD analysis tools
    - fixes found in A5: button debounce, snoozed STAND kept over EYE, LEDC timer per pin,
    signed link age, seq restart handling, fresh desk counts before air FSM,
    SENSOR ERR title, 3.3 V LDR formula, simulation keepalive
2026-10-14 test(role-a): A5 results and evidence from automated Wokwi runs
    - A5_results.md: 21/21 automated checks pass, measured PWM and task WCET, 9 defects fixed
    - evidence/2026-10-14_wokwi_ci: OLED screenshots (png), CLI and serial logs, VCD zip and summary
    - A-TC v1.1: result per test case
2026-10-14 docs(role-a): update A2, A3, A-T and A-N from A5 results
    - A2 v1.1: slide switch replaces PIR as LD2410 stand-in
    - A3 v1.1: keepalive (15 s real / 60 s sim), signed air age, seq restart rule, count timing
    - A-T v1.1: measured WCET, communication task on core 0
    - A-N v1.0: integration problems 7-15 and simulation limits
2026-10-14 docs(logic-air): sync C2 pseudocode and C-T with A4/A5 implementation
    - Add comm_update_counts() before FSM evaluation matching air.cpp
    - Update S4 recovery condition to 2 consecutive reads (RECOVER_READS = 2)
    - Update i2c_lock reference to A1 item 7 in C-T
2026-10-15 docs: C5 results section and D-N light sensor conversion note
